ayushyadavnvs/jane_street/docs/DESIGN_DECISIONS.md

# Design decisions

The decisions behind the Programmable Bit Engine (PBE): what was chosen, the alternatives
considered, and why. Decisions that a new protocol forced us to change are marked
**Changed** with the protocol that caused it, so the reasoning behind both versions is kept.

Keep this file current: add an entry for every new decision, and when a decision changes,
mark the old one **Changed** instead of deleting it.

| Version | Folder | Protocols |
|---|---|---|
| v1 | `pbe_v1/` | UART, SPI controller and peripheral, I2C controller and target, SMBus PEC, 1-Wire, Modbus RTU, WS2812, USB low-speed device (control endpoint); CRC unit, parity bit, WAIT timeout, line coder |
| v2 (retired, D28) | branch `archive/v2-usb` | v1 plus low-speed USB; lessons in `docs/USB_NOTES.md` |

## Changes forced by new protocols

| Protocol that arrived | What it broke | Change | Entry |
|---|---|---|---|
| SPI (full duplex) | One shift register cannot send and receive on the same clock | Split into OSR (out) and ISR (in) | D9 |
| I2C | Controller program is 34 words; memory held 32 | Program memory 32 → 64 words, 6-bit PC | D4 |
| I2C (via D4) | 64 words no longer fit the direct-mapped register window | Pointer + data register for loading programs | D13 |
| I2C | Needs START/STOP/repeated START, but the engine cannot branch on data bits | Host requests them through shared flags | D19 |
| USB | NRZI, bit stuffing and CRC per bit are too slow and need state the engine lacks | Hardware USB line unit on opcode 111 | D20 |
| USB | A packet must leave the chip without gaps; 4-byte FIFOs cannot hold one | FIFOs 4 → 16 bytes (v2) | D10 |
| USB | 50 MHz gives 33.3 clocks per USB bit | Target clock 48 MHz | D18 |
| USB (via D20) | Opcode 111 now does something, so `NOP` = `0xE000` became `UTX` | `NOP` re-encoded as a no-op `FLAG` | D6, BUG-008 |
| 1-Wire, Modbus RTU | Nothing: both are programs on the existing instructions | — | D25, D26 |
| Modbus RTU (its test) | Restart could glitch a high pin low, a false start bit | Restart releases pins but keeps their values | D24, BUG-013 |
| Two protocols at once (I2C + 1-Wire) | Shared FLAG0/FLAG1: each engine took the other's requests | 8 flags, engine-relative via `FLAG_BASE`; host `FLAG_SET`/`FLAG_CLR` | D11, D27, BUG-017 |
| USB (v2) | Opcode 111 and a line unit became USB-only: the engine drifted away from general | v2 retired; general features instead | D28 |
| Modbus RTU, 1-Wire | Host had to compute CRC and parity; 3.5-character silence limited Modbus to 19200 baud | General CRC unit, parity bit, WAIT timeout on opcode 111 / pin action 6 | D6, D26, D29–D31 |
| 1-Wire (strong pull-up) + I2C at once | 35 + 34 words did not fit the shared 64-word memory; Modbus alone is 56 | 128-word memory, jumps relative to `START_PC` | D4, D13 |
| Modbus 8N2, 1-Wire inverted CRC-16 | `OUTPAR` always sent parity; "CRC ok = zero" cannot check inverted CRCs | No-parity bit in `LINE_CFG`; CRC value readable by the host | D29, D30 |
| WS2812, SPI peripheral | Nothing: both are programs on the existing instructions (the SPI peripheral uses the timeout vector to see the end of a transaction) | — | D34, D35 |
| SMBus PEC | The I2C controller fed its ACK bits into the CRC, but a PEC covers bytes only | The ACK slot's `IN` is marked `NOCRC` (program change) | D36, BUG-022 |
| I2C target | START/STOP are SDA edges while SCL is high: one engine cannot wait on two pins at once | Both engines run it, sharing flags: one watches for START/STOP, one shifts bits (no hardware change) | D37 |
| USB (back in v1) | NRZI, bit stuffing and a 32-clock bit with no gaps cannot be done one instruction per bit; SE0 needs both pins at once | A general line coder (NRZ/NRZI, three stuffing rules, pair mode, SYNC hunt, byte transfers) | D39 |
| USB | The device must pick its reply by PID and address within 7.5 bit times | `JEQ`/`JNE`/`JLINE` and `MOV`; opcode 111 now has one free sub-op | D6, D32, D40 |
| USB | Its CRC16 is sent inverted: "CRC ok = zero" never holds | `CRC_GOOD`: "ok" = the register equals a set value (USB's residual 0x800d) | D29, D41 |
| USB | A packet must leave without gaps and a SETUP arrives at line rate | FIFOs 4 → 16 bytes (now in v1) | D10 |
| USB | New per-engine settings, but +0..+F were full | Second register page per engine at 0x30 / 0x40 | D32, D44 |
| USB (its firmware) | Burst reads could lose a byte; a flush on SETUP threw away an OUT record | `RX_COUNT`/`TX_COUNT` registers, `TX_FLUSH` | D43, BUG-030, BUG-031 |
| 48 MHz (USB, D18) in the first routed run | 0.586 ns of setup slack: pc → program memory → decode → next pc in one clock, through long buffer chains | An instruction register with a prefetch; four copies of the read address. A taken jump costs one clock more at CLKDIV = 0 | D7, D18, D50 |
| JTAG, SWD | Nothing: both are programs on the existing instructions (SWD fills its 64-word window; the host computes the write parity, as `OUTPAR` covers one OSR load) | — | D75, D76 |
| Programs over 64 words (after D82) | 6-bit jump targets reached only a 64-word window | Jumps relative to their own page; a one-shot `PAGE p` prefix for the others; the assembler inserts it | D67, D83 |
| USB, SWD, CAN, Modbus (programs of 61-64 words) and the planned protocols | The 128 shared flip-flop words were full and half the chip | An IHP SRAM per engine, 256 separate words each (8-bit PC and `START_PC`, `PM_ADDR_H`); 8x4 tile | D4, D13, D50, D62, D82 |

---

## D1. Hardware description language

- **Chosen:** SystemVerilog, restricted to what Yosys reads (`logic`, `always_ff`,
  `always_comb`, packed buses, no interfaces, structs or unpacked port arrays).
- **Alternatives:** Hardcaml (Jane Street's own HDL), plain Verilog-2005, Chisel, Amaranth.
- **Why:** You asked for SystemVerilog. Tiny Tapeout's flow reads it through Yosys, and it keeps
  the testbench in the same language. Hardcaml would be the strongest signal to Jane Street
  but needs OCaml.
- **Consequence:** Per-engine arrays in the top level were flattened into buses
  (`clkdiv[e*16 +: 16]`) because Yosys and Icarus handle unpacked arrays poorly (D23).

## D2. Core architecture: a programmable engine

- **Chosen:** A tiny processor ("engine") whose instructions are the primitive actions every
  protocol is made of: drive / release / read a pin, wait, shift a bit, loop, branch, move bytes.
  Each protocol is a program loaded at runtime.
- **Alternatives:**
  1. Table-driven state machine (state × pin condition → action, next state).
  2. Hardwired UART + SPI + I2C blocks behind a mux.
  3. A general CPU core (RISC-V) bit-banging pins.
- **Why:** The competition requires reprogrammability after fabrication. (2) cannot learn new
  protocols. (1) is compact but hard to program by hand. (3) is far too slow per bit and too
  big. An engine whose instructions are the protocol primitives is small, fast enough, and
  easy to write programs for. The Raspberry Pi RP2040 PIO uses this idea; we deliberately
  differ from it (delay on every instruction, WAIT that restarts the timer, open-drain pin
  action, USB line unit) instead of copying it.

## D3. Two engines

- **Chosen:** Two identical engines.
- **Alternatives:** One engine; four engines.
- **Why:** Some protocols need two things at once: UART TX and RX are independent, and
  running two protocols side by side (UART + I2C) is a strong demo. One engine cannot do
  either. Four would multiply area for a benefit no protocol so far needs; with area use at
  15–21 %, adding engines later remains possible.

## D4. Shared program memory, 32 → 64 → 128 words — **Changed (I2C, then two protocols at once; then the SRAM, D82)**

- **Chosen originally:** 32 × 16-bit words shared by both engines, flip-flop based,
  each engine with its own start address (`START_PC`).
- **Changed:** The I2C controller needed 34 words. Memory became 64 words and the PC 6 bits.
- **Alternatives considered at the change:**
  1. Squeeze I2C below 32 words (merge routines, drop the TX-first check). Possible only by
     removing features or making the host protocol racy.
  2. Separate memory per engine. Wastes words when one engine runs a short program.
  3. 64 shared words.
- **Why (3):** Area use was only 10 %, so +25k µm² was affordable. The JMP address field had a
  spare bit, so the instruction format did not change. 64 words also let UART TX + I2C, or
  USB TX + USB RX, sit in memory together.
- **Cost:** v1 area 91,779 → 141,141 µm². Timing barely moved (3.56 → 3.61 ns).
- **Changed again (1-Wire strong pull-up made it 35 words):** 1-Wire + I2C (69 words) no longer
  fit, and Modbus (56) could not run beside anything but UART TX.
- **Chosen now (decided with you):** 128 words, and every jump (`JMP`, `JCRCBAD`, the timeout) is
  relative to the engine's `START_PC`. Each engine works in its own 64-word window, any two
  programs of up to 64 words can run together, and programs load anywhere (the assembler labels
  each program from 0). The PC stays an absolute 7-bit address, so the add happens on the jump
  path, not the instruction-fetch path. Same idea as `PIN_BASE` and `FLAG_BASE`.
- **Alternatives:** two separate 64-word memories (same area, but loaded separately and no
  shared code); squeezing programs onto a 2 µs 1-Wire tick to fit 64 words (fragile, and Modbus
  still could not share).
- **Cost:** 164,095 → 262,618 µm² (18 % → 29 % of 6×4). I estimated +49,000 µm² beforehand; the
  real cost is about twice that, because doubling the words also doubles both engines'
  128-way read multiplexers. Worst logic path 3.97 ns.
- **Changed (D82, the SRAM program memory):** the memory is no longer shared. Each engine has
  its own 256-word IHP SRAM, the PC and `START_PC` are 8 bits, and jumps stay relative to
  `START_PC` (64-word windows, mod 256). The "separate memories waste words" objection above no
  longer holds at 256 words each; the cost is that two engines cannot share one copy of code.
- **Proposal D62:** SRAM macros instead of flip-flops (one 256 × 16 per engine, written
  together, so this shared image stays); not the design yet.
- **Next option:** latches instead of flip-flops for program memory (31 µm² per bit instead of
  ~67 µm² for a flip-flop with its write multiplexer) could save about 70,000 µm². Program memory
  is written rarely by the host, which suits latches, but latch timing in the Tiny Tapeout flow
  needs checking first.

## D5. Instruction format

- **Chosen:** 16 bits: `[15:13] OP | [12:4] ARG | [3:0] DELAY`. Every instruction can idle
  0–15 extra ticks after it runs.
- **Alternatives:** A separate WAIT/DELAY instruction and no delay field; wider (24-bit) words.
- **Why:** Protocol timing is mostly "do X, then hold for a moment". A delay on every
  instruction makes programs much shorter (UART TX is 8 words). 16 bits keeps memory small.

## D6. The opcode set

| OP | Instruction | Why it exists |
|---|---|---|
| 000 | `PIN p, act` | Drive 0/1, release, toggle, send an OSR bit, open-drain send. Covers push-pull, tri-state and open-drain with one pin model (D8) |
| 001 | `IN p` | Sample a pin into the ISR |
| 010 | `WAIT` | Wait for a pin or flag level or edge: start bits, clock edges, I2C clock stretching |
| 011 | `JMP cond` | Loops (X--), ACK/NACK and glitch checks (pin), host handshakes (FIFO, flags) |
| 100 | `SET X/OSR` | Bit counts and constants (USB SYNC) |
| 101 | `PULL/PUSH` | Bytes to and from the host. **Changed (CAN):** `PULL`'s free bits [7:6] add `PULL NOWAIT`, `MARK` and `REWIND` (D70) |
| 110 | `FLAG` | Coordination between engines and with the host; host interrupt |
| 111 | `EXT` sub-ops: `CRCRST`, `OSRCRC`, `STAT`, `JCRCBAD`, `JEQ`, `JNE`, `JLINE` (7 of 8 used) | **Changed:** was reserved; v2 used it for USB (D20, retired). Then general extensions (D29–D31). **Changed again (USB in v1):** sub-ops 4–6 are the compare and line-event jumps (D40); sub-op 7 stays free. **Changed (CAN):** sub-op 7 is split by param[5]: 0 = `LINECTL` (D67), 1 = reserved for the proposed `PAGE` (D62) |

- **`NOP` — Changed (USB):** The assembler originally emitted opcode 111 with argument 0 for
  `NOP`. That was harmless in v1 but in v2 the same word is `UTX`. `NOP` is now `FLAG` with
  action 3, which has no effect in either version (BUG-008).
- **`MOV` — added (USB in v1):** `FLAG` action 3 with a non-zero destination field is
  `MOV dst, src` (D40). `NOP` (`0xD800`, destination 0) is still a no-op, as BUG-008 requires.
- **`PIN p, END` — added (USB in v1):** pin action 7 ends a line-coder frame (D39).

## D7. Timing: tick divider, WAIT checks every clock and restarts the divider — **Changed (48 MHz place and route, D50)**

- **Chosen:** Each engine has a 16-bit `CLKDIV`; one tick every `CLKDIV + 1` clocks.
  A blocked instruction (WAIT, PULL, PUSH, USB) is re-checked every clock, and when it
  completes the tick divider restarts.
- **Alternatives:** Re-check only on ticks; free-running divider.
- **Why:** Re-checking every clock means a short edge is never missed. Restarting the
  divider means the next instructions are timed from the moment the condition was met. This
  is what lets UART RX land its samples in the middle of each bit without extra hardware.
- **Changed (the first routed run at 48 MHz):** instructions now run from an instruction
  register (D50). With `CLKDIV` ≥ 1 every time above is exactly as before. With `CLKDIV` = 0
  (and under the line coder) a taken jump takes one clock more, and a tick that falls on that
  fetch bubble is held for the clock instead of being lost.

## D8. Pin model

- **Chosen:** Every pin has an output value, an output enable, and a synchronized input.
  Pin numbers in instructions are relative to a per-engine `PIN_BASE` (mod 8). A separate
  `JMP_PIN` selects the pin for `JMP PIN_HI/PIN_LO`.
- **Alternatives:** Fixed pin numbers in programs; separate open-drain hardware for I2C.
- **Why:** One model gives push-pull, tri-state and open-drain (value 0, toggle the enable),
  so I2C needs no special hardware. Relative pins let the same program run on any pins.

## D9. Shift registers: one → OSR + ISR — **Changed (SPI)**

- **Chosen originally:** One 8-bit shift register for both directions.
- **Changed:** SPI is full duplex. Sending and receiving on the same clock with one register
  would shift twice per bit.
- **Chosen now:** OSR (output, loaded by `PULL`, shifted by `OUT`) and ISR (input, filled
  by `IN`, emptied by `PUSH`), each with its own LSB/MSB-first setting.
- **Alternative:** One register with a combined "exchange bit" instruction. Rejected: costs
  an opcode slot and complicates every other protocol.
- **Cost:** 8 more flip-flops per engine.

## D10. FIFOs, 4 → 16 bytes — **Changed (USB, v2; and in v1 since USB came back)**

- **Chosen originally:** 4-byte TX and RX FIFO per engine; `PULL`/`PUSH` block when
  empty/full.
- **Changed in v2:** A USB packet must leave the chip without gaps, but the host feeds
  bytes at most at ~6 Mbit/s over SPI with polling in between. The host now queues the whole
  packet (up to 16 bytes) before sending.
- **Alternatives:** Faster host link; a separate packet buffer. A deeper FIFO is the
  simplest and also helps SPI bursts.
- **Cost:** about 32,800 µm², most of v2's growth.
- **Changed in v1 (USB, D42):** the same reason, now in v1. A low-speed IN packet (PID and up to
  8 bytes) and a SETUP record (14 bytes) each fit; v1 measured +33,121 µm². Every protocol gains
  host-latency tolerance. Two tests leaned on the old depth: the I2C target's "more than the
  FIFO holds" write grew from 5 to 20 bytes so it still makes the engine stretch SCL on a full
  FIFO; the Modbus overflow round still overflows (18 bytes for 9 characters).

## D11. Flags — **Changed (running two protocols at once)**

- **Chosen originally:** 4 flags shared by both engines and writable by the host. Engines can
  set, clear, wait on and branch on them; `FLAG n, IRQ` interrupts the host.
- **Why:** The cheapest way for engines to coordinate, and the way the host asks the
  I2C program for START/STOP (D19) and the USB program to send (D20).
- **Changed:** protocols that use flags could not run on both engines at once (D27, BUG-017).
- **Chosen now:** 8 flags. Each engine sees 4 of them starting at its `FLAG_BASE` (engine
  register +8): "FLAG n" in a program is physical flag `(FLAG_BASE + n) mod 8`. Defaults: engine
  0 has flags 0–3, engine 1 has flags 4–7. Overlapping bases make flags shared again when the
  engines must signal each other (the planned USB responder). The host changes single flags
  through `FLAG_SET` (0x08) and `FLAG_CLR` (0x09), so it never overwrites the other engine's flags.
- **Alternatives considered:**
  1. Let `JMP` test all 4 flags and give each program different flag numbers. Rejected: needs a
     wider condition field, and every program would have to be edited for every pairing.
  2. Fully private flags per engine. Rejected: engines could no longer coordinate.
  3. Relative flags with a base, like `PIN_BASE` for pins. Chosen: programs do not change,
     and sharing is still a configuration choice.
- **Cost:** about 2,700 µm² (+2 %).

## D12. Host interface: SPI peripheral

- **Chosen:** SPI mode 0 on `ui_in[2:0]` / `uo_out[0]`: a command byte (R/W + 7-bit address)
  then data bytes. The address auto-increments, except for streaming registers (FIFO data,
  program data) so a burst can pour bytes into one register. All host inputs pass through
  2-flip-flop synchronizers, so host SCK must be at most clk/8.
- **Alternatives:** A parallel bus on the 8 input pins plus strobes; a UART host port.
- **Why:** 4 wires, any microcontroller (or the Tiny Tapeout demo board's RP2040) can drive
  it, and it leaves the 8 bidirectional pins free for protocols.

## D13. Loading programs: direct-mapped → pointer register — **Changed (I2C, via D4; extended by D82)**

- **Chosen originally:** Program memory mapped at register addresses 0x40–0x7F (32 words ×
  2 bytes).
- **Changed:** 64 words need 128 bytes, more than the 7-bit address space has left.
- **Chosen now:** `PM_ADDR` (0x06) holds a byte pointer, `PM_DATA` (0x07) writes a byte and
  advances it. A program loads in one SPI burst. With 128 words (D4) the pointer uses all 8 bits.
- **Extended (D82):** two 256-word memories need a 10-bit pointer. `PM_ADDR_H` (0x0F) holds its
  top two bits, word[7] and the engine; `PM_DATA` advances {word, byte} and never the engine.
- **Alternative:** An 8-bit address command. Rejected: changes the host protocol for every
  register.

## D14. Program memory is write-only

- **Chosen:** The host cannot read program memory back.
- **Why:** A third read port is a 64:1 × 16-bit mux. Engines read it through their own
  ports; tests verify programs by behaviour.

## D15. Pin ownership mask

- **Chosen:** `PIN_OWN`, one bit per pin: which engine drives it. Both engines can always
  read every pin.
- **Alternative:** Fixed priority (engine 0 wins). Rejected: silent conflicts.

## D16. Input synchronizers; glitch filter deferred

- **Chosen:** 2 flip-flops on every input pin and host input.
- **Deferred:** A glitch filter (on the diagram, not built yet). I2C in fast mode specifies
  50 ns spike suppression, so it will be needed for I2C robustness.

## D17. Pin assignment

- **Chosen:** Protocol pins on `uio[7:0]` (the only pins with output enables), host SPI on
  `ui_in[2:0]` / `uo_out[0]`, IRQ and status on `uo_out[7:1]`.

## D18. Clock frequency: 48 MHz — **Changed (USB); Changed again (10BASE-T: 60 MHz, D92)**

**Changed (10BASE-T, D92):** the clock is 60 MHz: a 10 Mbit/s Manchester half bit is exactly 3
clocks, and USB low speed is still a whole number of clocks per bit (40).

- **Chosen:** Plan for 48 MHz. The competition sets no frequency; Tiny Tapeout's clock pad is
  specified to about 66 MHz.
- **Earlier assumption:** 50 MHz, a round number with margin under 66 MHz.
- **Why changed:** USB low speed is 1.5 Mbit/s: exactly 32 clocks per bit at 48 MHz, 33.3 at
  50 MHz (1 % error). UART and I2C rates divide well from 48 MHz too.
- **Margin:** worst path ~4.9 ns at the slow corner (logic plus flip-flop overhead) vs 20.8 ns
  per cycle, roughly 4×.
- **Changed (the margin, first routed run):** that estimate had no wires. Routed, the same path
  took 19.6 ns and left 0.586 ns of slack at the slow corner, mostly in buffer chains on the
  program counter. The clock stays at 48 MHz (USB needs it); the path was cut in two instead
  (D50).

## D19. Protocol host conventions

- **UART:** TX uses tick = ½ bit, RX uses tick = ¼ bit so a `WAIT LOW [1]` lands half a bit
  into the start bit. RX checks the line again there and drops glitches. Bit 7 is handled
  outside the loop so the program is back in `WAIT` inside the stop bit.
- **SPI controller:** CS stays low while the host keeps the TX FIFO fed.
- **I2C controller:** Each I2C byte is two FIFO bytes, `[data] [ack]`, and returns
  `[byte seen on SDA] [ACK bit]`. Reads and writes are the same 9-bit open-drain exchange.
  START and STOP are requested with FLAG0 and FLAG1.
  - **Alternative:** A command byte decoded by the program. Rejected: the engine cannot branch
    on data bits, so decoding would need new instructions.
  - **Changed (review):** SCL is now 4 ticks low and 3 high (it was 3 low, 4 high, which breaks
    the I2C minimum low time), and FLAG1 is cleared after STOP completes (BUG-010, BUG-011).

## D20. USB: a hardware line unit (v2) — **Retired (D28)**

- **Chosen:** A small line unit per engine on opcode 111. It does NRZI, bit stuffing and
  unstuffing, SYNC detection, EOP, CRC5 and CRC16, and re-centres sampling on every D+ edge.
  The engine still runs the packet logic: what to send, when, and what to do with what
  arrives.
- **Alternatives:**
  1. Pure software on the engine. Rejected: no way to test an OSR bit (needed for NRZI), X is
     taken by the bit counter so nothing counts 1s for stuffing, and the CRC per bit costs
     many instructions.
  2. Line unit timed by the engine's ticks. Rejected: a stuffed bit adds a bit time the
     program cannot see, so timing breaks. The line unit has its own bit timer (`BITDIV`) and a
     1-bit holding register, and the engine just keeps it fed.
- **Low speed only:** full speed (12 Mbit/s) is 4 clocks per bit at 48 MHz.
- **SYNC handled in hardware:** the engine cannot branch on bits, so the line unit strips SYNC.
- **Both CRCs always run;** the program reports both (`STAT`) and the host picks the right one
  by PID, because the program cannot branch on the PID yet.
- **Bit stuffing errors** are reported in `STAT` bit 2 (BUG-009).
- **Cost:** about 15,600 µm² for USB logic (one line unit is 5,733 µm²).
- **v2 is a separate copy** so v1 stays a clean UART/SPI/I2C design.

## D21. Verification approach

- **Chosen:** End-to-end testbench that touches only the chip's pins. Every protocol is
  checked by a model written independently of the RTL (UART monitor, SPI peripheral, I2C
  register device with clock stretching, USB decoder and USB host with ±1.5 % clock error).
  Each important feature is checked by breaking it on purpose and confirming the test fails.
  Simulator: Icarus Verilog.
- **Lessons:** A test that passed with the feature removed was strengthened (BUG-004). Icarus
  bugs with automatic tasks and queues led to static tasks for the USB helpers (BUG-006).
  A failing test must give a non-zero exit code (BUG-007).
- **Waveforms are opt-in** (`vvp sim.vvp +vcd`): 1-Wire and Modbus need ~70 ms of simulated time
  and the dump would be ~165 MB.
- **Static tasks share variables:** give every caller-side variable its own name (BUG-016).
- **Two host processes** (for protocols running at once) share the host port through a fair
  ticket lock (BUG-018), and the tests change flags through `flag_set` / `flag_clear` /
  `flag_get` helpers that know each engine's flag window.
- **Testbench clock = planned clock (48 MHz)** since BUG-020; it had been 50 MHz.
- **Planned:** third-party protocol decoders (sigrok), a Python golden model with random
  programs, formal properties (SymbiYosys), mutation score (MCY).

## D22. Area and timing method

- **Area:** Yosys synthesis with IHP's sg13g2 standard-cell library (typical corner).
  Tiny Tapeout's CMOS5L cell list uses the same cell names; no separate CMOS5L library is
  public.
- **Timing:** OpenSTA could not be built here (a dependency from a third-party mirror was
  blocked), so timing uses ABC's `stime` with the slow-corner library (1.08 V, 125 °C).
  Flip-flop clock-to-Q (~0.57 ns) and setup (~0.31 ns) are added by hand. Wire delay and
  clock skew are not included; the place-and-route report is the final word.

## D23. Synthesis-friendly coding

- Per-engine signals in the top level are flat buses, not unpacked arrays.
- Combinational selectors are named wires (Icarus `always_comb` limitation).
- `exec` is declared before use (strict tools reject use-before-declaration).
- Storage arrays (program memory, FIFO data) have no reset, which saves area; they are
  always written before being read.

## D24. Restart cancels the instruction in flight

- **Chosen:** `exec` is forced low while `restart` is high, so an instruction that would
  complete in that cycle has no side effects (no FIFO pop or push, no flag change, no IRQ, no
  USB line unit input).
- **Alternative:** Let it complete and restart one cycle later. Rejected: the host expects
  restart to take effect at once, and the completed instruction would still act on a state
  that is being thrown away.
- **Cost:** one AND gate on the `exec` path; the worst path grew by about 0.2 ns. (BUG-012)
- **Changed (Modbus RTU test):** restart used to clear pin output values as well as enables.
  A pin driving high could then glitch low (BUG-013). Restart now only releases pins and keeps
  their values, so released lines float to their pull-ups cleanly. Programs set a value before
  toggling a pin, so the stale value is harmless.

## D25. 1-Wire controller (program only) — **Changed (strong pull-up)**

- **Now 36 words.** FLAG0 has two meanings: with nothing queued it requests a reset; set *after*
  a byte is queued it requests a strong pull-up after that byte (DQ driven hard high from 6 µs
  after the last slot until the host clears FLAG0), which parasite-powered devices need during
  CONVERT T. The idle loop therefore checks for queued bytes before FLAG0.
  - **Changed (BUG-038):** the program tests FLAG0 *before* pushing the byte seen, and the
    pull-up path pushes only after driving DQ high. A `PUSH` blocks while the RX FIFO is full,
    and the pull-up must not wait for the host (a DS18B20 needs it within 10 µs). Was 35 words.
  - **Alternative:** a separate flag for the pull-up. Rejected: `JMP` can only test FLAG0 and
    FLAG1, and FLAG1 is single-slot mode.
- **CRCs** are checked with the CRC unit through the host registers (D29): CRC-8 by "CRC ok",
  inverted CRC-16 by reading the CRC value.
- The text below describes the first version.

### First version

- **Chosen:** `programs/onewire_ctrl.pbe`, 30 words, tick = 1 µs. A write-1 slot and a read slot
  are identical on the wire (6 µs low, then released), so one slot routine does both, like the
  I2C 9-bit exchange: `OUTOD` keeps DQ low for a 0 and releases it for a 1, and `IN` samples at
  13 µs. To read, the host sends `0xFF`.
- **Reset/presence:** requested with FLAG0; a `JMP X--` loop with a 16-tick delay makes the
  480 µs pulse. The flag is cleared only when the reset is finished (lesson of BUG-011).
- **Search ROM:** needs a decision after every 2 bits read. The engine cannot branch on data, so
  FLAG1 switches the program to single slots and the host runs the search algorithm (Maxim
  AN187). 1-Wire has no maximum gap between slots, so host round trips are fine.
- **Alternatives:** a hardware 1-Wire master (rejected: the point is a reprogrammable engine);
  separate read and write routines (rejected: twice the code for identical wire activity).
- **Left to the host:** CRC8, and the strong pull-up some parasite-powered devices need
  (`PIN dq, DRV1`). Overdrive speed needs a second program with a finer tick.

## D26. Modbus RTU master — **Changed (CRC, parity, timeout hardware; frame validity, D47)**

- **Changed (D47):** the receiver now rejects a frame with a pause of more than 1.5 characters,
  and the timeout is 1.5 characters at every baud rate (it was 3.5 characters up to 19200 baud
  and 1.75 ms above). 62 words.
- **Before D47:** `programs/modbus_rtu.pbe`, 56 words, uses the CRC unit (D29), the parity bit (D30) and
  the timeout (D31). The host sends only data bytes; the engine adds parity and appends the CRC,
  checks received parity and CRC, finds start bits with `WAIT FALL` (exact, instead of a 2-tick
  poll) and ends a frame with the timeout. The 19200-baud limit is gone (tested at 115200).
  FLAG0 is used inside the program as "in a frame". The text below describes the first version.

### First version (program only)

- **Chosen:** `programs/modbus_rtu.pbe`, 33 words, RS-485 half duplex on one engine: TX, RX and a
  driver-enable pin. Tick = 1/8 bit.
- **Parity:** the engine cannot compute parity, so each character is two TX bytes,
  `[data] [parity]`; the parity byte's bit 0 is sent after the data. The same program does
  8E1, 8O1 or 8N2 (send 1 as a second stop bit). Received parity comes back in a status byte.
  - **Alternative:** a parity flip-flop in the shifter (about 10 cells, pin actions 6–7 are
    free). Deferred: not needed yet.
- **End of frame (3.5 characters of silence):** `WAIT` has no timeout, so after each character
  the program polls for the next start bit in a 2-tick loop counted by X. At the end it sets
  FLAG2 and raises IRQ.
  - **Limit:** X is 8 bits, which covers the character-based timing Modbus uses up to
    19200 baud. Above that Modbus specifies fixed 1.75 ms gaps, which need more than 255 polls.
  - **Alternative:** a WAIT-with-timeout counter in hardware. Deferred; also useful for I2C
    stuck-bus recovery and CAN.
  - The 2-tick poll catches a start bit up to 1/4 bit late; sampling is aimed so the error is
    about ±1/8 bit.
- **End of request:** FLAG1, set by the host once everything is queued (TX FIFO empty). The
  engine turns the driver off after the last stop bit, then clears FLAG1.
- **CRC:** computed by the host. (v2's USB CRC unit computes the same CRC-16; Modbus is the
  inverted USB field.)
- **Not checked by the receiver:** the 1.5-character maximum gap inside a frame. **Changed:**
  checked since D47 (BUG-039).

## D27. Shared flags limit which protocols can run together — **Resolved by D11**

- **Observation:** `JMP` can only test FLAG0 and FLAG1, and flags are shared by both engines.
  I2C, USB TX, 1-Wire and Modbus all use FLAG0 or FLAG1, so two of them cannot run on the two
  engines at the same time. UART and SPI use no flags and can run next to any of them.
- **Resolved:** engine-relative flags (D11, BUG-017). The new test runs a 1-Wire Search ROM on
  engine 0 and I2C on engine 1 at the same time.

## D28. Retire v2; keep the engine general

- **Decision:** v2 (low-speed USB) is retired. Its source stays on the GitHub branch
  `archive/v2-usb`; what it taught is in `docs/USB_NOTES.md`.
- **Why:** v2 worked, but most of its hardware was USB-only: a line unit with its own fixed
  CRCs, and all 8 sub-ops of opcode 111 spent on USB. That pulled the engine away from being a
  general protocol engine, and every fix had to be made in two copies.
- **Alternatives:** keep both copies (rejected: double work, drift); merge them behind a USB
  build option (rejected for now: still USB-specific hardware).
- **Plan for USB later:** bring it back on general features that other protocols also use:
  the CRC unit (D29), a line coder with NRZI/stuffing/Manchester modes, compare-and-branch on
  received data, and `MOV X, ISR` (see `docs/USB_NOTES.md`, section 4).
- **Done:** USB is back in v1 (D39–D44). The line coder has NRZ and NRZI, three stuffing rules
  and a pair mode; Manchester waits for a protocol that needs it (1553). The coder is
  unit-tested in USB, CAN and HDLC styles, so it is not USB-only hardware.

## D29. General CRC unit

- **Chosen:** `src/pbe_crc.sv`, one per engine. A shift-left register with any polynomial up to
  16 bits and a set width; initial value all zeros or all ones; result read plain or
  bit-reversed. It is fed by the bits the engine shifts: `OUT`/`OUTOD` and/or `IN`, chosen in
  `CRC_CFG`; an instruction marked `NOCRC` (e.g. a parity bit or the CRC bytes themselves) is
  left out. "CRC ok" = register is zero, which holds after a frame plus its own CRC for every
  CRC without a final inversion (Modbus CRC-16, 1-Wire CRC-8, CAN CRC-15).
- **Instructions (opcode 111):** `CRCRST`, `OSRCRC LO/HI` (load a CRC byte to send), `JCRCBAD`.
  The host can also restart the CRC and read "CRC ok" through the engine's `STATUS` register,
  which is how the unchanged 1-Wire program gets a hardware CRC-8 check.
- **Changed (1-Wire inverted CRC-16):** reading +9/+A now returns the CRC's current value instead
  of the polynomial. Devices such as the DS2408 and DS2431 send their CRC-16 inverted, where
  "zero" is never the result; the host reads the value and compares it with the received bytes.
  Polynomial read-back is lost, which only a debugging host would miss.
  - **Alternatives:** a residual-compare register (no register slot free); a final-inversion
    option (engine-side checks for inverted CRCs would still need a residual).
- **Alternatives:**
  1. Host computes CRCs (the first Modbus/1-Wire versions). Works for slow protocols, but the
     engine cannot act on the result, which USB and CAN need.
  2. Fixed CRCs, like v2's USB unit. Rejected: a new protocol would need new hardware.
  3. A final-inversion option. Left out: no current protocol needs it (USB does; see notes).
- **Changed (USB):** USB's CRC16 is sent inverted, so a good packet leaves the register at the
  residual 0x800d, not zero, and the device must check it before it ACKs. "CRC ok" now means
  the register equals `CRC_GOOD` (default 0, so every earlier program is unchanged), and
  `OSRCRC ..., INV` sends the inverted field (D41).
- **Verified:** a Python model of the same register gives Modbus `C4 0B` for `01 03 00 00 00 02`,
  1-Wire CRC-8 `1C` for the DS18B20 scratchpad, and zero after a frame plus its CRC.
- **Cost:** ~3,600 µm² per engine, plus its registers.

## D30. Parity bit

- **Chosen:** two flip-flops per engine. Send parity: XOR of the bits `OUT`/`OUTOD` shifted since
  the last OSR load; the new pin action `OUTPAR` (6) drives it, inverted when `LINE_CFG[7]`
  selects odd parity. Receive parity: XOR of the bits `IN` sampled since the last `STAT`; with the
  parity bit included it must come out even (or odd), and `STAT` reports an error otherwise.
- **Why separate from the CRC:** parity is a 1-bit CRC (polynomial x+1), but Modbus needs parity
  per character and CRC-16 per frame at the same time.
- **Alternative:** host supplies the parity bit (first Modbus version): costs a FIFO byte per
  character and host work. Rejected now that the cost is two flip-flops.
- **Changed (Modbus 8N2, BUG-019):** `LINE_CFG[6]` = no parity: `OUTPAR` sends 1 (the second stop
  bit) and no receive parity error is reported. The same Modbus program then does 8E1, 8O1 and
  8N2.

## D31. WAIT timeout through a timeout vector

- **Chosen:** per engine, `TIMEOUT` (16 bits, in ticks; 0 = off) and `TIMEOUT_PC` (in
  `LINE_CFG`). If `WAIT`, `PULL` or `PUSH` stays blocked for `TIMEOUT` ticks, the engine abandons
  it (no side effects), jumps to `TIMEOUT_PC` and sets "timeout happened", which `STAT` and the
  `STATUS` register report.
- **Why a vector:** no instruction bits were free: `JMP`'s 8 conditions and `WAIT`'s 9 argument
  bits are all used, and using the delay field would break existing programs. With a vector,
  every existing program works unchanged (timeout off by default).
- **Alternatives:** a `JMP TIMEOUT` condition (would need to drop an existing condition); a
  timeout field in `WAIT` (no room); a second engine as a timer (wastes an engine).
- **Uses:** Modbus end of frame and exact start detection at any baud rate (done); I2C stuck-bus
  recovery, UART idle-line detection and CAN bus-idle detection (later).
- **Cost:** ~2,800 µm² per engine (counter and limit).

## D32. Register and opcode budget

- **Changed (USB):** the second register page (D44) holds the new per-engine settings, and
  sub-ops 4–6 of opcode 111 became `JEQ`, `JNE`, `JLINE` (D40). Sub-op 7 is the last free one;
  `MOV` went into the unused bits of `FLAG` action 3 instead. `STATUS` uses 5 of 8 bits.
- **Engine registers:** +0 to +F are now all used (+7 is free only by accident of history:
  it was v2's `BITDIV`). New per-engine settings will need a second register window.
  `LINE_CFG` is full too ([5:0] timeout PC, [6] no parity, [7] odd parity), and `STATUS` uses 4
  of 8 bits.
- **Opcodes:** opcode 111 has sub-ops 4–7 free. Planned users: compare-and-branch on received data,
  `MOV X, ISR`, line-coder operations. When those run out: 24-bit instructions (program memory
  +50 %, ~+25,000 µm²) or a second opcode page.
- **OSR/ISR stay 8 bits:** byte boundaries cost one `PULL`/`PUSH` tick, which every protocol so far
  hides in a delay. Needed only for a protocol at one tick per bit with no gap between bytes, and
  then "auto-pull" is cheaper than wider registers.

## D33. RX overflow is reported, not silent

- **Chosen:** a `PUSH` that finds the RX FIFO full sets a sticky `STATUS[3]` bit (also in `STAT`)
  and raises IRQ once. The engine still waits for room, as before.
- **Why:** with 4-byte FIFOs a slow host can fall behind (at 115200 baud it has ~95 µs per
  character). The data is then damaged either way; the point is that the host finds out.
- **Alternatives:** drop the byte and keep going (keeps timing, loses data silently); deeper
  FIFOs (area; v2 needed 16 bytes for USB and paid ~32,800 µm²).

## D34. WS2812 (NeoPixel) LED driver: a program, timed by delays — **Changed (60 MHz for 10BASE-T, D92)**

**Changed (D92):** at 60 MHz the tick is 33.3 ns (`CLKDIV` 1) and the delays are [11] [11] [11].

- **Chosen:** `programs/ws2812.pbe`, 8 words, tick = 2 clocks (41.7 ns at 48 MHz). Each bit is
  three pin instructions: `DRV1 [9]` (0.42 µs), `OUT [9]` (a 1 stays high for another 0.42 µs, a
  0 goes low), `DRV0 [8]`, and `JMP X--`: 30 ticks = 1.25 µs. High times are 0.42 / 0.83 µs
  (datasheet 0.4 / 0.8 µs ± 150 ns); the `PULL`/`SET` at a byte boundary make that bit's low phase
  125 ns longer, still in spec. The engine waits in `PULL` with the line low, so a frame ends
  (the LEDs latch after 50 µs low) simply when the host stops sending.
- **Host requirement:** 800 kbit/s is 100 kB/s with a 4-byte FIFO (40 µs of data). The host
  bursts the bytes into the FIFO and pauses while the TX-full pin (`uo_out[6]`) is high. At a
  host SCK of clk/16 a byte takes 2.7 µs, against 10 µs on the LED line. An underrun stretches
  a low phase out of spec, and one of 50 µs latches the LEDs mid-frame.
- **Alternatives:** a hardware PWM or one-shot pulse unit (WS2812-specific: rejected, D28); one
  instruction per bit with the delay chosen by the data (no instruction reads OSR into the delay
  field).
- **Tested (Test 8):** a decoder measures every high and low against the datasheet and rebuilds
  the bytes: 2 frames of 5 LEDs. Mutations caught: `DRV1 [4]` (high too short) and `DRV0 [3]`
  (low too short).

## D35. SPI peripheral (device): a program; the timeout vector ends a transaction

- **Chosen:** `programs/spi_periph.pbe`, 21 words, mode 0, CLKDIV 0. It waits for CS low and puts
  bit 7 on MISO, then loops: wait SCLK rise → `IN` MOSI → wait fall → `OUT` MISO. A reply byte the
  host has not queued goes out as 0xFF (`SET OSR, 0xFF` and `JMP TX_EMPTY`).
- **End of transaction:** the engine is blocked in `WAIT sclk, RISE` when CS rises, and a
  `WAIT` cannot watch two pins. The timeout vector (D31) breaks the wait: after `TIMEOUT` ticks
  with no clock, the routine at word 1 checks CS (`JMP PIN_HI`, the JMP pin is CS). If CS is high,
  it releases MISO and waits for the next select; if CS is still low (the controller paused), it
  goes back to waiting for the clock.
- **Limits (documented in the program):**
  - SCLK up to 2 MHz at 48 MHz. After the 8th rising edge the engine needs about 10 clocks to
    store the byte and load the next reply before the falling edge. Tested at 2 MHz.
  - The first SCLK edge comes at least 250 ns after CS falls.
  - A reply byte must be queued before the previous byte's last rising edge.
  - CS must stay high for at least `TIMEOUT` ticks between transactions. MISO is released
    within `TIMEOUT` ticks of CS rising, not at once: on a shared MISO line that gap matters.
  - `TIMEOUT` must be longer than the longest SCLK high phase.
- **Alternative for later:** a general "abort on pin edge" vector (like the timeout vector, but
  fired by an edge on a chosen pin). It would end SPI transactions at once and also serve I2C
  target STOP detection and UART break. That's hardware, so it waits for a second protocol that
  needs it badly.
- **Tested (Test 9):** a mode-0 controller model at 2 MHz that samples MISO just before each
  rising edge, three transactions: replies queued, 0xFF defaults (also for the very first byte),
  and a pause longer than the timeout inside a transaction. A monitor checks that MISO changes
  only while SCLK is low. Mutations caught: either `SET OSR, 0xFF` removed (the first one only
  after BUG-026), timeout routine always ending the transaction, MISO never released.

## D36. SMBus PEC: the I2C controller plus the CRC unit as CRC-8

- **Chosen:** no new hardware and one program change. The CRC unit is set to CRC-8, poly 0x07,
  init 0, plain output (`CRC_CFG` 0x87), fed by `IN` bits only. The I2C controller reads back
  every bit it sends, so `IN` sees each byte on the bus in both directions, including addresses.
  The ACK slot's `IN` is marked `NOCRC`, because a PEC covers bytes, not ACK bits (BUG-022).
- **Host protocol:** restart the CRC (`STATUS` write bit 0) at the start of a message, not at a
  repeated START: the PEC covers both address bytes.
  - Write: after the last byte, read the CRC value (+9) and send it as the PEC.
  - Read: receive the PEC like a data byte. `STATUS` bit 1 ("CRC ok") is then set only if it
    was right.
- **Alternatives:** the host computes the PEC (works, but costs host time per byte); feeding the
  CRC from `OUTOD` too (would count each bit twice, since the program both drives and reads it).
- **Tested (Test 7, in `tb_pbe`):**
  - The device model computes its own PEC. The testbench's CRC-8 is first checked against the
    standard check value (0xF4 for "123456789").
  - Write Word with PEC: the engine's PEC must equal the model's, and the device's CRC over the
    message plus the PEC must be 0.
  - Read Word with PEC: once with the right PEC (CRC ok = 1) and once with a corrupted one
    (CRC ok = 0).

## D37. I2C target: two engines share the job through flags

- **Chosen:** `programs/i2c_target.pbe` (58 words, bit engine) on one engine and
  `programs/i2c_watch.pbe` (8 words) on the other. Both engines use the same pins and the same
  `FLAG_BASE`, so they see the same four flags (D27).
  - The watcher waits for SDA edges and checks SCL. A fall while SCL is high sets FLAG0
    (START); a rise while SCL is high sets FLAG3 (STOP, with IRQ). It drives nothing.
  - The bit engine shifts the address and data bits on SCL edges. After each SCL fall it checks
    FLAG0, so a repeated START restarts the address phase.
- **Why two engines:** START/STOP are SDA edges while SCL is high. A single engine blocked in
  `WAIT scl` cannot see an SDA edge. The alternatives each need hardware:
  - a `WAIT` on two pins (no free argument bits, D32);
  - a pin-change flag;
  - the abort-on-edge vector of D35.

  The cost is that the I2C target uses both engines, so nothing else can run beside it.
- **The host decides, the engine stretches SCL:**
  - After the address byte, the engine holds SCL low, pushes the address and sets FLAG2 (with
    IRQ). The host ACKs by clearing FLAG2 (the engine waits in `WAIT FLAG 2, LOW`). It NACKs by
    restarting the engine, which releases both lines and waits for the next START.
  - For reads, the engine holds SCL until the host has queued the next byte.
  - I2C allows any amount of clock stretching, so host latency only slows the bus.
  - The host can therefore answer any address, several addresses or the general call; there is
    no address-comparator hardware.
- **Rejected in review (first draft):** a NACK queued as a byte. In that draft the engine then
  decided "did we ACK?" by reading SDA in the ACK slot. On a bus with several targets, another
  device's ACK pulls SDA low, and the engine would have joined someone else's transfer. Test 10
  now covers this.
- **Timing:**
  - SDA changes at least 300 ns after SCL falls. `WAIT scl, FALL [12]` covers the I2C hold rule:
    a transmitter must bridge SCL's undefined falling region.
  - SDA is set up at least 333 ns before the engine releases a stretched SCL (`[15]`; standard
    mode needs 250 ns).
  - Measured: hold ≥ 333 ns, setup ≥ 333 ns.
- **Host rule:** read FLAGS *after* draining the RX FIFO. The engine sets FLAG2 one clock after
  pushing an address, so if FLAG2 was still clear, the drained bytes were all data.
- **Tested (Test 10):** a fast-mode controller model that supports stretching:
  - a write of a pointer plus five bytes (more than the RX FIFO holds);
  - a read of three bytes after a repeated START;
  - another device's address, ACKed by that device and followed by two bytes: our chip must not
    touch SDA and must pass nothing to the host;
  - a read after that.

  Monitors check that SDA never changes while SCL is high, the hold and setup times, and that
  stretching happened. Mutations caught: the watcher's START flag removed, the repeated-START
  check removed, the hold delay removed (104 ns), the setup delay cut (83 ns).

## D38. A second end-to-end testbench

- **Chosen:** tests 8–10 live in `test/tb_proto.sv`; the host-port helpers (SPI framing, register
  access, FIFOs, flags) moved to `test/tb_host.svh`, which both testbenches include.
  `make test` runs all three testbenches; `make test-proto` runs only the new one (3 s, against
  ~2 min for `tb_pbe`).
- **Why:** `tb_pbe.sv` had grown past 1,100 lines and two minutes per run; the new protocols use
  their own pin models and need nothing from the old tests' state.
- **Lint step:** `make test` first fails on Icarus's "Static variable initialization" warning
  (BUG-023).

## D39. Line coder: a general serializer between the shift registers and the pins

- **Chosen:** `src/pbe_line.sv`, one per engine, off by default (`LINE` = 0). Settings:
  - **mode:** NRZ, or NRZI (0 = change level);
  - **stuffing:** after 6 ones (USB), after 5 ones (HDLC) or after 5 equal bits (CAN);
  - **pair mode:** pin base + 1 carries the complement, SE0 ends a frame;
  - **transfers:** byte or bit;
  - **SYNC:** a frame-start pattern.
- **What it does:**
  - **Bit timing:** it owns the bit timing (`CLKDIV` becomes the bit time, and instructions then
    run every clock), because a stuffed bit must cost the program nothing. That was v2's lesson.
    (Since D50 a taken jump takes 2 clocks.)
  - **Transmit:** one queued entry. A frame starts with a 2-bit-time gap and the SYNC byte,
    and `PIN p, END` ends it (pair mode: SE0, SE0, J, then release).
  - **Receive:** samples mid-bit and re-centres on every edge. It hunts for SYNC, unstuffs
    (a stuff bit with the wrong value is a line error), and reports the end of a frame as an
    event: SE0 then J in pair mode; otherwise 8 idle bits, or a stuffing violation at the
    idle level.
  - An `IN` waits for a byte or the event. An unread byte is dropped when its frame ends
    (BUG-028).
- **CRC in byte mode:** an `OUT` or `IN` hands over 8 bits at once, so the CRC unit takes them
  one per clock afterwards, and the next instruction waits those 8 clocks. That keeps the
  CRC unit bit-serial and keeps `NOCRC` per instruction.
- **Why general:** the same block covers USB (NRZI, 6 ones, pair), HDLC/SDLC (NRZI, 5 ones,
  flag as SYNC) and CAN (NRZ, 5 equal bits, bit transfers). `tb_line.sv` tests all three
  against reference models written independently of the RTL.
- **Alternatives:**
  1. v2's USB line unit: rejected, USB-only (D28).
  2. Host pre-encodes NRZI and stuffing: almost no hardware, but the device would then ACK
     packets without checking their CRC, and the host would have to stream at line rate.
  3. Bit-by-bit in instructions: at 32 clocks per bit there is no "branch on this bit".
- **Not yet:** a Manchester mode (1553), CAN's sample point and resynchronization jump width.
  A non-pair frame ends only by idle or a stuffing violation.
- **Cost:** 12,141 µm² per coder. I estimated 6–8k: the two 16-bit bit timers (transmit and
  receive) are most of the difference, and could be one, since the coder is half duplex.

## D40. Compare and move instructions

- **Chosen:**
  - `JEQ label` / `JNE label`: jump if ISR equals / differs from OSR (opcode 111, sub-ops 4, 5).
  - `JLINE label`: jump if the line coder saw the end of a frame, and clear the event (sub-op 6).
  - `MOV dst, src` with dst and src in {X, OSR, ISR} and src 0 = zero (`FLAG` action 3).
- **Why:** a USB device must choose ACK, NAK, STALL or DATA from the PID and address within
  7.5 bit times, and the host is far too slow for that. `JEQ` against `SET OSR` constants checks
  bytes; `MOV X, ISR` keeps the PID while the address bytes arrive, and later counts bytes.
- **Also for:** Modbus slave addresses, the I2C target address check on the engine, CAN IDs,
  the 1553 terminal address, and any loop with a received count (`MOV X, ISR`).
- **Why `JNE` too:** the USB program is exactly 64 words; each `JNE` saves the `JMP` after a
  `JEQ`. That spent another sub-op, so `MOV` went into `FLAG` action 3 instead.
- **Tested:** `tb_engine_ops.sv` (unit test) checks every compare and move, and that `NOP` is
  still a no-op.

## D41. CRC good value and inverted CRC output

- **Chosen:** a per-engine `CRC_GOOD` register: "CRC ok" means register == `CRC_GOOD` (0 by
  default). `OSRCRC LO|HI, INV` loads the inverted CRC byte.
- **Why:** USB sends its CRC16 inverted. A good packet leaves the register at 0x800d. Our model
  of the CRC unit gives the field `dd 94` for the real-trace packet `DATA0 80 06 00 01 00 00 40 00`,
  and 0x800d after any good packet. The unit test checks both values in RTL.
- **Also for:** the 1-Wire inverted CRC-16 (DS2408, DS2431), which the host had to check by
  reading the value (D29); and CRC-16/X.25 (HDLC).
- **Alternative:** a final-inversion flag with the residual worked out in hardware: more logic
  for the same result.

## D42. USB low-speed device: control endpoint 0, one engine

- **Chosen:** `programs/usb_dev.pbe`, exactly 64 words.
  - **Received tokens:** checks PID, address and endpoint (with the CRC5 included, by comparing
    the token's 2nd and 3rd bytes with two `SET OSR` constants). It receives SETUP/OUT data,
    checks the CRC16 against the residual, and ACKs only good packets.
  - **IN tokens:** sends the host-queued packet with the CRC appended, NAK when nothing is
    queued, or STALL. It reports the host's ACK.
  - **Settings:** CLKDIV 31 (32 clocks a bit at 48 MHz), coder 0x36, SYNC 0x80, CRC16 0x8005,
    CRC_GOOD 0x800d.
- **Host side:**
  - The firmware answers at its own pace: USB's NAK flow control means the engine NAKs IN
    tokens until data is queued, so the host never has to meet the 5 µs turnaround.
  - Records go to the RX FIFO: `[D2]` for an ACK, and `[token] [DATA PID] [n bytes] [255 − n]
    [status]` for data. The count makes records that pile up in the FIFO separable; the
    firmware parses them from the end (a status byte is below 0x20, an ACK is 0xD2).
  - After SET_ADDRESS, the firmware rewrites the two address words in program memory.
  - It uses `RX_COUNT`, `TX_FLUSH` and flags (FLAG0 = IN packet queued, FLAG1 = STALL,
    FLAG2 = record).
  - It also resends an IN packet whose ACK was lost and handles a bus reset (D49).
  - A data packet is ACKed only when its CRC is good *and* the line coder saw no error (D48).
- **Scope: endpoint 0 only.** A HID keyboard also needs an interrupt IN endpoint, about 10 more
  words, and a program window is 64 words (6-bit jump targets). What would make room:
  - a one-level `CALL`/`RET`;
  - jumps relative to the PC, so a program could use the whole memory;
  - USB on both engines (receive and transmit).

  These are open. EP0 covers what V-USB's common gadgets use: enumeration and vendor requests.
- **Limits:**
  - A SETUP record is 14 bytes, so the firmware must read it before the next SETUP arrives
    (USB's own flow guarantees that).
  - Electrical: plain I/O pins switch faster than USB's 75–300 ns edges (works in practice,
    as with V-USB, but not compliant). The pad voltage still needs checking.
  - Full speed is impossible at 4 clocks per bit.
- **Tested (Test 11, `tb_usb.sv`):** a USB host model at ±1.5 % enumerates the device:
  - GET_DESCRIPTOR (device; configuration 9 and 18 bytes), SET_ADDRESS, SET_CONFIGURATION,
    STALL for an unsupported request, and a vendor write and read;
  - refused: a SETUP with a flipped bit, one with a missing stuff bit, one with a wrong stuff
    bit but intact data and CRC (BUG-040), tokens for the old address and with a bad CRC5;
  - a lost ACK (the same DATA1 packet comes again, BUG-041) and a 10 ms bus reset after
    SET_ADDRESS (address 0 again, BUG-042);
  - no reply: keep-alives and a bus reset;
  - two records piled up and split apart.

  The device's CRCs are checked by the host model's own CRC code. Every turnaround is
  2.97–3.05 bit times (allowed 2–7.5), and host and device never drive the bus at the same time.
  Mutations caught:
  - no edge re-centring;
  - no stuffing;
  - a 1-bit gap (turnaround 1.97);
  - no frame-end drop;
  - no CRC5 check;
  - no CRC check before the ACK;
  - "CRC ok" back to zero.

## D43. Host port: FIFO counts and a TX-only flush

- **Chosen:**
  - `RX_COUNT` (0x0A/0x0B) and `TX_COUNT` (0x0C/0x0D): bytes in each engine's FIFOs.
  - `TX_FLUSH` (0x0E): empties an engine's TX FIFO only.
- **Why:**
  - A burst read of an RX FIFO could lose a byte arriving during the burst (BUG-030). With the
    count, the host reads exactly the bytes that are there.
  - The USB firmware must drop a stale IN reply when a SETUP arrives. Flushing both FIFOs threw
    away the OUT record already arriving behind the SETUP (BUG-031).
- **Also for:** any protocol whose host reads in bursts, or aborts a queued transmission.

## D44. A second register page per engine

- **Chosen:** 0x30 + 0x10·e: +0 `LINE` (coder), +1 `SYNC`, +2/+3 `CRC_GOOD`.
- **Why:** the first page (+0..+F) was full (D32). The free +7 slot alone could not hold four
  bytes of new settings.

## D45. Area and timing after USB — **Changed (first routed run: timing; then the SRAM, D82)**

**Changed (D82):** the program memory is now two SRAM macros; the standard cells went from
392,179 to 198,770 µm² (`make synth`), and the tile is 8x4. D82 has the numbers.

| | Area | Share of 6×4 tiles | Worst logic path (slow corner) |
|---|---|---|---|
| Before USB (D34–D38) | 262,618 µm² | 29 % | 3.97 ns |
| With USB features | 333,841 µm² | 36.4 % | 4.33 ns (~5.2 ns with flip-flop overheads, budget 20.8 ns) |

Breakdown of the +71,223 µm²:

| Part | Area |
|---|---|
| FIFOs 4 → 16 bytes | 33,121 µm² |
| Two line coders | 24,283 µm² |
| Instructions, `CRC_GOOD`, byte-mode CRC feed, registers | ~13,800 µm² |

My estimate was about +50k µm²: 40 % low, as with the 128-word memory (D4). The coder was the
part I under-estimated most.

### Routed results (first full Tiny Tapeout run, commit df2e881)

| | Estimate (Yosys + ABC, above) | Routed (LibreLane, measured in CI) |
|---|---|---|
| Area / utilization | 333,841 µm², 36.4 % of 6×4 tiles | 44.3 % utilization (instance utilization 0.501) |
| Cells | — | 21,745 without fill; 73,420 instances with fill |
| Hold-fix delay cells | not estimated | 3,590 (about +14.9 % area) |
| Worst setup path, slow corner | 4.33 ns logic, ~5.2 ns with flip-flop overheads | ~20.3 ns |
| Setup worst slack, slow corner (budget 20.833 ns) | ~15.6 ns (implied) | 0.586 ns |

Static timing at a 20.833 ns clock, all corners:

| Corner | Setup worst slack | Hold worst slack |
|---|---|---|
| slow (1.08 V, 125 °C) | 0.586 ns | 0.602 ns |
| typ (1.20 V, 25 °C) | 7.95 ns | 0.284 ns |
| fast (1.32 V, −40 °C) | 12.344 ns | 0.106 ns |

Design-rule warnings (not failures): 277 max fanout; max slew 114 at the slow corner and 11 at
typ; max capacitance about 60–70. Antenna violations are 0 after repair, and DRC and LVS are
clean (0 design violations).

- **Area:** the estimate held up reasonably. Most of the gap to 44.3 % is the hold-fix cells,
  which a logic-only synthesis cannot see; the rest is placement buffering and resizing.
- **Hold cells: expected, kept.** Tiny Tapeout's 0.25 ns clock uncertainty plus the 0.1 ns hold
  margin apply to every direct flop-to-flop path (program memory, FIFO memories, shift
  registers, synchronizers), and those paths have almost no logic between flops, so the flow
  pads them with delay cells. Hold is met at every corner.
- **Timing estimate — Changed (first routed run):** the estimate was optimistic by about 4×.
  The worst routed path runs from `g_eng[1].u_eng.pc` through buffer chains into the mux4 tree
  that reads the 128 × 16 program memory, then through decode to the next state: ~20.3 ns at
  the slow corner against our ~5 ns. The method (D22) leaves out wire delay, and that path is
  dominated by it: the PC drives the select lines of the whole 128-way read multiplexer, a
  huge fan-out that place and route must buffer into long chains spread across the die. ABC's
  `stime` sees only the logic depth. Setup is still met at every corner, but with 0.586 ns
  at the slow corner, not the ~4× margin assumed in D18.

  This is a limit of the method, which D22 already stated ("wire delay and clock skew are not
  included"), not a tool bug, so it has no `BUG_LOG` entry. From now on, the routed STA report
  is the timing figure; the ABC estimate is only for comparing RTL changes with each other.
- **Follow-up:**
  - An instruction register now cuts the program-memory path in two (D50); the clock stays at
    48 MHz. Its routed slack is still to be measured by the next `gds` run.
  - The physical-design flow is paused (`gds` and `gl_regression` by hand only, D46) until the
    RTL is final.

## D46. Tiny Tapeout packaging — **Changed (10BASE-T: 60 MHz, D92)**

**Changed (D92):** `clock_hz` 60000000 and `CLOCK_PERIOD` 16.667 ns; the cocotb test runs at
16,668 ps.

- **Chosen:** the repository root is the Tiny Tapeout project, built from the IHP template
  (`ttihp-verilog-template`, actions `ttihp27a`, PDK `ihp-sg13cmos5l`):
  - `info.yaml`: 6×4 tiles, 48 MHz, language SystemVerilog, the pinout;
  - `src/`: the RTL and `config.json`, the template's file with `CLOCK_PERIOD` 20.833 ns;
  - `docs/info.md`: the datasheet page;
  - `test/`: a cocotb test;
  - `.github/workflows`: `gds`, `test`, `docs`, plus our `regression`.
- **Top module:** renamed `tt_um_ayushyadavnvs_pbe`, because Tiny Tapeout requires the GitHub
  user in the name. The file stays `src/tt_um_pbe.sv`.
- **Layout:** the RTL moved from `pbe_v1/src` to `src/`, because Tiny Tapeout requires the
  sources in `./src`. `pbe_v1/src` is now a link to `../src`, so `pbe_v1` (Makefile,
  testbenches, synthesis) is unchanged and stays the design's home. Alternatives:
  - a separate Tiny Tapeout repository: two copies of the RTL would drift, as v2 did (D28);
  - moving all of `pbe_v1` to the root: a large, noisy move for no gain.
- **Where the flow runs:** on GitHub Actions, as Tiny Tapeout intends. A local run needs
  LibreLane's tool set (OpenROAD, Magic, KLayout, Netgen) through Nix or Docker; Docker is not
  available in this workspace, and fetching LibreLane's Nix environment was not permitted here.
- **The cocotb test** (`test/test.py`) is small on purpose, because the `gl_test` job runs it on
  the routed netlist. It checks a register write and read-back, then loads the UART programs
  and loops a byte stream from engine 0 to engine 1 through `uio[0]` → `uio[1]`. Without the
  loopback it fails ("received []"). The full suite stays in `pbe_v1/test`, on the RTL.
- **Gate level:** a separate workflow, `gl_regression`. It runs after each `gds` run and on
  testbench changes, using the netlist of the latest `gds` run. At first it was a job inside
  `gds`, but then every testbench fix needed a 2.5-hour rebuild. It takes the routed
  netlist and the PDK's cell models, as Tiny Tapeout's `gl_test` does, and runs our full
  end-to-end testbenches (`tb_proto`, `tb_usb`, `tb_pbe`) on it: `make test-gl` in `pbe_v1`.
  The testbenches look only at the pins, except one I2C monitor that reads the flags register
  inside the design. That monitor is left out at gate level (`GL_TEST`), and the NOP check now
  reads the flags through the host port instead.
- **Lint:** Verilator with all warnings showed three, now fixed: a 3-bit index on a 16-bit
  vector (same behaviour, now written as 4 bits) and two deliberately unused bits. The
  `regression` workflow lints with `-Wall` on every push.
- **Clock period:** 20.833 ns (48 MHz), not the template's 20 ns. The cocotb test runs at
  20.834 ns, because cocotb needs an even number of picoseconds.
- **Changed: when the flow runs.** At first `gds` ran on every push to `src/`, `info.yaml` or
  `test/`, and `gl_regression` ran after it and on every testbench push. Both are now run by
  hand only (`gl_regression` still follows a `gds` run). The first full run passed; the RTL
  is now being finished (reviewer fixes, the 48 MHz timing fix) before physical design
  resumes. Otherwise each RTL push would start a 2.5-hour build, and each testbench push would
  test new tests against an old netlist. RTL tests (`regression`) still run on every push.
- **First full run (commit df2e881), measured in CI:**
  - **`gds`:** success in 2 h 18 min, of which detailed routing took 1 h 30 min and Magic DRC
    25 min. Precheck 9/9 passed; `gl_test` (the cocotb test on the routed netlist) passed 2/2.
  - **`gl_regression`** (run 40810602581, `make test-gl`: `tb_proto`, `tb_usb`, `tb_pbe` on the
    routed netlist with the PDK cell models): all passed, in 3 h 05 min, inside GitHub's 6-hour
    job limit.
  - Area, timing and the comparison with the estimates are in D45.

## D47. Modbus RTU: a pause of more than 1.5 characters makes a frame invalid — **Changed (idle start-bit wait, D78)**

- **Rule:** Modbus over serial line, §2.5.1.1: the characters of a frame follow each other with
  at most 1.5 character times of silence; a frame with a longer pause must be discarded. A
  frame ends after 3.5 characters of silence. Before this the program waited 3.5 characters
  inside a frame, so a 2-character pause was accepted (BUG-039).
- **Chosen:** `TIMEOUT` = 1.5 characters (+ 9 ticks, as before, because the program starts
  waiting 9 ticks before the stop bit ends): 141 ticks at 1/8 bit. The timeout routine, if in a
  frame, watches the line for 2 more characters in an X loop (`JMP PIN_LO` / `JMP X--`, 2 ticks
  a pass, 88 passes):
  - silence: the frame ends as before (FLAG2, IRQ), after 3.5 characters in all;
  - a start bit: the frame is invalid. FLAG3 is set at once; the program receives nothing more,
    and waits for 3.5 characters of silence (the same loop with X = 153, restarted by every low
    sample), then ends the frame with FLAG2 and IRQ. The host discards a frame with FLAG3 set.
- **Why a flag, not a status value:** the status byte is per character and the frame is only
  known to be invalid after the pause; FLAG3 is the engine's last free flag and needs no RX
  FIFO space. FLAG2 and IRQ still mark the end, so the host's frame loop is unchanged.
- **Why FLAG3 at once but IRQ only at the end:** one more word (an `IRQ` in `bad`) would make
  65; the host sees FLAG3 whenever it looks, and the IRQ comes when the line is quiet and the
  next frame may start.
- **Alternatives:**
  - a second timeout value in hardware (1.5 and 3.5): a register and a comparator for one
    protocol, against 6 words of program;
  - keep receiving after the pause and mark only the end: simpler, but the junk would fill the
    RX FIFO; the rule says discard.
- **Above 19200 baud:** the spec recommends fixed timers (750 µs and 1.75 ms) there, to spare
  slow CPUs; it does not forbid character-based ones. This engine counts in characters at every
  rate, so a 2-character pause is caught at 115200 baud too, and the frame end comes after
  3.5 characters (about 0.33 ms at 115200) instead of 1.75 ms. A host that wants the fixed
  750 µs can set `TIMEOUT` to it; the watch after it stays 2 characters (frame end at
  750 µs + 2 characters).
- **Cost:** 6 words (56 → 62 of 64).
- **Known limit (not new):** while idle, a timeout every 1.5 characters runs 2 instructions
  (`tmo`, `JMP TX_EMPTY`) before `WAIT rx, FALL` waits again; a start edge in those 2 ticks
  would be missed. It was the same with 3.5 characters, only rarer.
  **Changed (D78, BUG-100):** the window is 3 ticks (the `WAIT` itself issues on the third),
  and the idle wait is now `WAIT rx, LOW`, which sees a start bit that began during it.
- **Tested (Test 5):** a 2-character pause in a response at 19200 and 115200 baud is reported
  invalid (4 characters before the pause, none after); a 1-character pause at both rates is a
  valid frame; all earlier rounds (parity error, bad CRC, 8N2, RX overflow) still pass.

## D48. JCRCBAD means "packet bad": CRC not ok or a line error — **Changed (USB program: tokens checked too, D79)**

- **Problem (BUG-040):** a USB packet with a wrong stuff bit but intact data and CRC was ACKed.
  `STAT` cleared the line error before `JCRCBAD`, and `JCRCBAD` looked only at the CRC.
- **Chosen:**
  - `JCRCBAD` jumps when the CRC is not ok **or** the line error is set.
  - `CRCRST` clears the line error: it marks the start of a new checked packet. (An error in
    the very clock of the `CRCRST` is kept.)
  - `STAT` **no longer clears** the line error. It still reports it (bit 4) and still clears
    parity and timeout.
- **Why STAT stops clearing it:** USB's program does `STAT` then `JCRCBAD`, so the record gets
  the status and the jump decides on the same packet; a clear in `STAT` would hide the error from
  the jump. With `CRCRST` as the clear, the error's scope is one packet: from its `CRCRST` to the
  next one. The host's own clear (`STATUS[3]`) and restart still work.
  - **Alternative:** keep `STAT` clearing and swap the program's order (`JCRCBAD` before
    `STAT`): then the record and the ACK decision would need two code paths, and the 64-word
    USB program has no room.
  - **Alternative:** a separate `JLERR` jump: sub-op 7 is the last one free; "packet bad" is the
    test every checked protocol wants (USB, HDLC, CAN), so one jump covers both.
- **Programs:** `usb_dev.pbe` does `CRCRST` first in `dat`, before the DATA PID, so an error
  anywhere in the data packet counts (an error in the token before it does not).
  **Changed (D79, BUG-101):** the `CRCRST` is now right after the PID, before the token's second
  byte, so a line error in a SETUP or OUT token rejects the DATA packet after it, and IN tokens
  are checked with `STAT` (a token with a wrong stuff bit gets no answer). The firmware
  treats status bit 4 as bad, like bit 1 clear. Modbus uses `STAT` without the line coder, so
  its line error is always 0; no other program uses `JCRCBAD`.
- **Cost:** one OR gate and the clear on `CRCRST`.
- **Extended (CAN, D71):** in bit-synchronous mode every bus error (stuff, bit, form, ACK, CRC)
  is a line error, so `JCRCBAD` also jumps on a bit error. `CRCRST` also clears the new
  per-packet bits (arbitration lost, bit error, frame sent).

## D49. USB host firmware: resend an IN packet whose ACK was lost; handle bus reset

- **Retransmission (BUG-041):** the engine sends an IN packet once; if the host's ACK is lost
  (or corrupted) the TX FIFO is empty and the next IN gets a NAK, and the host never gets its
  data. USB's rule is that the device sends the same packet (same DATA PID) until it is ACKed.
  - **Chosen:** in the firmware. It keeps the last IN packet; if `TX_COUNT` = 0 and no `[0xD2]`
    record came for about 100 µs (a host ACKs within 7.5 bit times, 5 µs, and the record
    reaches the firmware within tens of µs), it queues the same bytes again and sets FLAG0.
    Meanwhile the engine NAKs, which USB allows.
  - **Alternative:** in the program, by not popping the packet until the ACK (a "peek" read of
    the TX FIFO): needs FIFO hardware for one protocol, and the program has no room.
- **Bus reset (BUG-042):** a reset (SE0 for at least 2.5 µs; hosts send 10 ms) must bring the
  device back to address 0. The engine sees it only as a long EOP.
  - **Chosen:** the firmware polls `PINS`; SE0 seen twice, 2.5 µs or more apart (one register
    read takes about 6 µs), is a reset. EOPs last 1.33 µs and are at least ~12 µs apart, so two
    EOPs cannot pass for one. It then rewrites program words 6 and 9 to `0x9000` and `0x9100`
    (`SET OSR` 0x00 and 0x10: address 0), clears FLAG0–2, flushes the TX FIFO and forgets any
    transfer.
  - **Alternative:** a reset event from the line coder (SE0 longer than N bits), as an IRQ:
    hardware for USB only, and the host polling every 50 µs is enough for a 10 ms reset.
- **The firmware model** (`tb_usb.sv`) does both on a 50 µs timer in the same process as the
  record handler, like a firmware main loop, so the two never race. The test waits 6000 clocks
  (was 3000) after SET_ADDRESS for the address switch, since a timer poll may come first; USB
  allows 2 ms.

## D50. An instruction register cuts the clock's worst path in two — **Changed (the SRAM, D82)**

**Changed (D82):** with the SRAM program memory the memory read (stage 1) is inside the macro,
addressed with `pc_d`; a host write refetches twice (BUG-074), and only the engine whose memory
was written. The four copies of the read address exist only in the flip-flop fallback
(`PBE_PMEM_FF`, the engine's `PC_COPIES` parameter).

- **Problem:** the first full Tiny Tapeout run (LibreLane, routed) met 48 MHz with only
  0.586 ns of setup slack at the slow corner (1.08 V, 125 °C; typical 7.95 ns, fast 12.3 ns).
  The worst path ran from `g_eng[1].u_eng.pc[1]` through the program memory read to the next
  state, all in one clock. From the routed report (`55-openroad-stapostpnr`, slow corner):

  | Part of the path | Delay |
  |---|---|
  | Clock to Q of `pc[1]` | 0.33 ns |
  | `pc[1]` fan-out: a chain of 11 buffers (5 of them `buf_1`, with slews up to 2.1 ns) | 9.15 ns |
  | The mux4 tree of the 128 × 16 memory (`assign instr = pmem[pc]`) | 2.89 ns |
  | Decode, `ready`, `exec`, next state (another fan-out chain, a hold buffer) | 7.25 ns |
  | Data path in all | 19.6 ns (clock period 20.83 ns) |

  `pc` fans out to every first-level multiplexer of all 16 bits (ABC: 1,878 loads on `pc[0]`).
  That fan-out was also behind most of the slow corner's 277 max-fanout, 114 max-slew and
  about 65 max-cap warnings. The logic-only estimate (`make timing`, 4.2 ns, D45) had missed
  all of it: wires and fan-out were three quarters of the routed delay.
- **Chosen:**
  1. **An instruction register.** Each engine executes `instr_q`, not the memory output. The
     memory is read at `pc`, which now means the word *after* the current instruction. When an
     instruction executes and does not jump, `instr_q` takes that word, so sequential code
     still runs one instruction per clock. A taken jump (JMP, JCRCBAD, JEQ, JNE, JLINE, the
     timeout) loads `pc` with its target and clears the valid bit `iv`; the next clock fetches
     the target (a bubble). Reset and restart also clear `iv`.
  2. **A tick that falls on a bubble is held** for that clock (`tick = tick_due && iv`, and the
     divider and delay counter wait), so it is late, never lost.
  3. **Host writes:** a write to the program memory (`pm_wr`, any word) clears `iv` and fetches
     the instruction that runs next again. So the host can rewrite the word a stopped or
     blocked engine sits on, as the USB firmware does after SET_ADDRESS (D42).
  4. **Four copies of the read address.** `pc` and three copies (`pc_copy`) each address 4 of
     the 16 bits, so each drives a quarter of the multiplexers. The copies are in an
     `always_ff` marked `(* keep *)`: without it Yosys merges them back into one register
     (BUG-044).
- **Stages:** (1) `pc` → memory multiplexers → `instr_q`; (2) `instr_q` → decode → `ready` →
  `exec` → next state, including `pc`.
- **Instruction timing** (in the comment at the top of `pbe_engine.sv`):
  - `CLKDIV` ≥ 1: (DLY + 1) × (CLKDIV + 1) clocks, exactly as before. The next tick is at least 2
    clocks after the instruction that jumped, and after a blocked instruction completes the
    divider restarts, so the bubble always fits in between. `tb_fetch` gives the same edge
    timings on the old and the new RTL at CLKDIV 1 and 3.
  - `CLKDIV` = 0, and with the line coder: DLY + 1 clocks, plus 1 for a taken jump. The first
    instruction after a restart starts 1 clock later. A host write to the program memory makes
    the engine slip by 1 clock.
- **Program timing:**

  | Program | Mode | Effect |
  |---|---|---|
  | UART, SPI controller, I2C controller (and PEC), 1-Wire, Modbus RTU, WS2812 | CLKDIV ≥ 1 | None |
  | SPI peripheral (D35) | CLKDIV 0 | The tight path, from the 8th rising edge to `WAIT sclk, FALL`, has no taken jump: still 8 clocks of the 12 in a 2 MHz half period. The `JMP X--` and `JMP bit` each take 1 clock more. Test 9 passes at 2 MHz |
  | I2C target and watcher (D37) | CLKDIV 0 | Polling loops take 3 clocks instead of 2, and the watcher waits 1 clock longer after a `JMP PIN_LO`. Hold and setup times come from the `[12]`/`[15]` delays, which are unchanged. Test 10 passes |
  | USB device (D42) | line coder | A few taken jumps on the reply path: turnaround 2.97–3.05 → 3.00–3.19 bit times (allowed 2–7.5). The byte-mode CRC feed already holds the next instruction for 8 clocks, and the `OUT`/`IN` handshakes with `pbe_line` take no jumps, so neither changes. Each byte still has 256 clocks. Test 11 passes |

- **Alternatives:**
  1. **A bubble after every instruction** (`instr_q` loaded from `pmem[pc]` every clock, `pc` the
     current word, as first suggested): the same cut, but every instruction takes at least 2
     clocks at CLKDIV 0. Run as a mutation, it breaks the SPI peripheral at 2 MHz (Test 9:
     MISO changes while SCLK is high, wrong bytes in both directions), because the path after
     the 8th rising edge grows from 8 to 16 clocks against a 12-clock half period. USB still
     passes, at 3.19–3.35 bit times. Rejected (BUG-043).
  2. **Read both `pmem[pc]` and `pmem[pc + 1]`:** no bubble even on jumps, but a second set of
     multiplexers for both engines, about as large as the memory read itself. A 1-clock bubble
     on taken jumps costs no program any margin.
  3. **Register the read address in the top level:** a stage between the next-pc logic and the
     memory. It cuts the same path, but every instruction then needs 2 clocks, as in 1.
  4. **A lower clock:** ruled out: USB low speed needs exactly 32 clocks per bit (D18).
  5. **Clear `iv` only when the write hits the current or the next word:** two 7-bit comparators
     and an address port to spare one clock per host write. Writes are rare (program loading,
     the USB address patch), so any write refetches.
- **Unit testbenches unchanged:** they connect the engine by port name and leave the new
  `pm_wr` input unconnected (z). A default value on the port would fix that, but Verilator
  5.020 (the lint in CI) rejects it (BUG-045). `pm_wr` is therefore used only in `if`
  conditions, where z reads as false. In the chip it is always driven.
- **Measured** (`make timing`, Yosys/ABC logic only, IHP slow library, no wires):

  | | Worst logic path | Levels | Largest fan-out on it |
  |---|---|---|---|
  | Before (`pc[0]` → memory → decode → `flags`) | 4.20 ns | 36 | 1,878 (`pc[0]`) |
  | After, stage 2 (`instr_q[10]` → pin index → `wait_ok` → `exec` → state) | 3.45 ns | 21 | 10 |
  | After, stage 1 alone (`pc[0]` → memory → `instr_q`; one read port, 4 bits per copy not modelled) | 1.20 ns | 17 | 1,825 |

  The logic numbers drop only by 18 %, because the logic was never the problem.
- **Expected routed slack** (an estimate from the routed report, not a new run):
  - **Stage 1:** clock to Q, the `pc` buffer chain and the multiplexers, about 12.8 ns with
    today's chain. With a quarter of the loads on each copy, the chain should lose 2–3 of its
    weak stages (about 1.3 ns each). So about 9–10 ns, or 10–11 ns of slack.
  - **Stage 2:** the decode-to-state part was 7.25 ns, plus clock to Q and the `instr_q` fan-out:
    about 8 ns.
  - **Unchanged paths:** the worst path that did not start at `pc` was `clkdiv` → divider
    compare → `tick` → `issue` → `exec` → state, at 8.16 ns of slack. It has a `nor4_2` driving
    0.33 pF with a 4.3 ns slew. It is now the likely worst path.
  - **So:** about 8 ns of slack at the slow corner, up from 0.586 ns: the worst data path goes
    from 19.6 ns to about 12–13 ns. The `exec`/`tick` fan-out is the next thing to cut if more is
    needed (for example a registered `tick`).
- **Cost** (`make synth`, typical library): +76 flip-flops (per engine: `instr_q` 16, `iv` 1,
  three copies of `pc` 21), area 333,913 → 337,779 µm² (+3,866 µm², +1.2 %).
- **Tested:** `tb_fetch.sv` (Test 12), end to end through the pins and the host port:
  - **Timing:** at CLKDIV 0, 1 and 3, every edge of a program of `PIN TOG` instructions (DLY 0,
    1 and 2, taken and untaken jumps, a `WAIT` on a pin) against the rule above.
  - **Host writes:** (a) the host rewrites the word a stopped engine is parked on, then runs it
    without a restart; (b) the host rewrites word 0, then restarts; (c) the host rewrites the
    low byte of a running engine's blocked `WAIT FLAG 0, HIGH` into `LOW`, and the engine must
    go on without the flag changing.
  - **Mutations caught:** no refetch on a host write ((a) and (c) fail), refetch at `pc` instead
    of the current word ((a) fails), a tick lost on a bubble (CLKDIV 0 fails), and a bubble
    after every instruction (CLKDIV 0 fails, and Test 9 fails). The old RTL fails exactly the
    three taken-jump gaps at CLKDIV 0.

## D51. Independent verification without changing the design

- **Decision (2026-10-29):** add a Python executable specification, clock-by-clock RTL
  differential tests, stock sigrok decoding, and maintained third-party protocol models.
  This is verification work: no instruction, register, protocol program, or RTL behavior is
  changed. GDS, gate-level regression, synthesis and physical design are outside this work.
- **Alternatives:** more checks inside the existing SystemVerilog protocol models are useful
  but share assumptions with the design. A specification-driven Python model provides a
  separate oracle; external decoders and bus libraries provide additional independent views.
- **Model boundary:** instruction semantics come from `src/pbe_engine.sv`'s header, the
  register map from `src/tt_um_pbe.sv`'s header, CRC/line framing from their headers and D50.
  Reset, two-stage input synchronization, simultaneous events, pre-edge FIFO acceptance and
  host read staging are explicit. Undefined unwritten storage is represented, not assigned
  a convenient hardware reset value. No simulated engine state is copied into the oracle.
- **Stimulus and observation:** real host SPI pins load programs and configurations, drive
  FIFO traffic and modify memory while running. Each clock compares `uio_out`, `uio_oe`,
  `uo_out`; completed runs also compare FIFO contents, flags, CRC and host status readbacks.
  A test-only NOP initialization of program memory makes stopped-engine fetches deterministic;
  subsequent program loads and modifications use the host port. FIFO storage is unreset.
- **Timing:** cocotb 2 uses an even 20,832 ps period (approximately 48 MHz); exact real
  48 MHz cannot be represented by an integer number of picoseconds. Directed engine tests
  check D50 independently at dividers 0, 1 and larger values. The line coder has a separate
  differential campaign, so failures can be localized before engine integration.
- **Reproducibility:** `make diff N=1000 SEED=0x504245` runs consecutive seeds, logs the first
  mismatching clock/PC/instruction and both states, and writes coverage plus a failure JSON.
  Saved model/tool regression seeds live in `verify/golden-model/differential/regressions.json`. The short
  fixed-seed smoke is part of `make test`; extensive campaigns remain explicit targets.
- **Failure policy:** disagreements are classified as RTL, model, tool or underspecified
  text. Record before/after evidence and reproductions in `BUG_LOG.md`. Unfixed external-tool
  failures remain explicit failing commands; they do not justify changing RTL. Runner XML
  must contain tests and no failures, since the simulator process's exit code alone is
  insufficient with cocotb's Python runner.
- **Parallel work:** separate agents own the engine/line model, sigrok tests, and third-party
  bus tests; the coordinator owns the top-level model, integration and phase commits. Shared
  source is inspected, and only verification files and the three VCD testbench opt-ins change.
- **Tools, results and limits:** see `verify/golden-model/REPORT.md` and phase-specific reports
  for exact versions, commands, measured coverage and decoder/library limitations. Evidence
  here is behavioral simulation only; it makes no new routed timing, silicon or board claim.

## D52. Decode captured protocol pins with stock sigrok layers

- **Decision:** add an off-by-default `PBE_SIGROK` testbench define for scalar
  external pins and phase markers, then decode generated VCDs using unmodified
  sigrok decoders. Preserve the existing optional full-design `+vcd` captures.
- **Alternative:** writing another protocol decoder would repeat assumptions.
  The stock UART/SPI/I2C/1-Wire/Modbus/WS2812/USB decoder stacks are independent.
- **Extraction:** retain preceding idle levels and coalesce same-timestamp VCD
  updates, with 10 ns sample spacing and fixed pre/post padding. Preserve original
  hashes, boundaries, commands and decoder stdout. The capture-boundary regression
  is part of the default test suite and requires no sigrok installation.
- **USB limitation:** valid windows check ten control requests; the complete
  packet trace independently checks corrupt traffic and identical retransmission.
  An additional strict full-request target retains two known stock-decoder
  failures (BUG-050/051). Neither those failures nor window selection changes RTL.
- **Results:** 22/22 primary checks pass from fresh simulations; strict full-request
  comparison is 22/24 on libsigrokdecode 0.5.3. Versions, commands and boundaries
  are in `verify/golden-model/PHASE2.md` and its checked-in evidence.

## D53. Third-party bus endpoints attach only to chip pins

- **Decision:** use pinned cocotbext UART/SPI/I2C libraries through a test-only
  scalar-pin fixture. Load/configure/read the actual chip exclusively through
  host SPI. A resolved digital bus uses pull-ups and low-dominant wired signals.
- **Alternatives:** hierarchical memory/FIFO deposits would speed setup but bypass
  host behavior; handwritten endpoints would offer less independence. Neither is
  used in these bus tests. The fixture is not an analog pad or contention model.
- **Random settings:** independent endpoint bytes, gaps, UART baud choices, SPI
  mode-0 clock choices and I2C rates/stretching. Three cases cycle -1%, nominal,
  +1% error for externally timed UART, peripheral SPI and target I2C. Controller
  SPI/I2C vary program dividers. The original SPI programs only support mode 0;
  selecting modes 1–3 fails with an explicit unsupported-mode message.
- **Compatibility:** cocotbext-spi 0.5.0 needs local cocotb-2 API/time adapters;
  cocotbext-i2c 0.1.2 needs receive sampling after actual SCL-high when stretched.
  The library implementations remain installed unchanged. The test file names
  these adaptations, and `--stock-spi`/`--stock-i2c` reproduce their failures with
  nonzero exits. No design change is used to satisfy an endpoint assumption.
- **Stretch stimulus:** an independent low-phase stretcher only starts after an
  existing SCL falling edge; a callback delay that creates extra edges is invalid
  stimulus and was rejected (BUG-056). A target's host-response latency separately
  tests legitimate target clock stretching.
- **Evidence:** six endpoints, 18 randomized cases pass; final randomized SPI gap
  rerun and six-endpoint smoke also pass. Full settings, versions, limits and
  reproducible bugs are in `verify/golden-model/PHASE3.md` and bus `results.json`.

## D54. Bootstrap Python verification dependencies in GitHub regression

- **Decision:** the existing regression workflow selects Python 3.11 and installs
  `verify/golden-model/differential/requirements.txt` before the expanded `make test`.
  The new model and differential smoke remain mandatory, with failures propagated.
- **Alternative:** silently skipping the differential test when cocotb is absent
  would make local and CI verification differ and could produce misleading passes.
- **Scope:** dependency setup only. No RTL, protocol, GDS or gate-level workflow
  change. The two physical-flow entry points retain their existing triggers.
- **Evidence:** missing-dependency import fails with an unconfigured interpreter;
  the pinned environment imports cocotb 2.0.1 and runs the suite. See BUG-057.

## D55. Round-2 verification records contracts, negative checks and tool versions

- **Scope:** branch `verify/round2` starts at `verify/golden-model` commit `2d62b89`.
  Complete the round-1 audit before formal/vector/coverage phases. Run `make test`
  successfully before each phase commit; long jobs stay separate. Do not merge
  to main or invoke physical-design/GDS/gate-level flows.
- **Model independence:** distinguish original specified ISA rules from exact
  cycle priorities learned from implementation. The rule inventory in
  `verify/golden-model/ROUND2_MODEL_AUDIT.md` preserves that provenance. Header
  additions document existing behavior; they do not retrospectively make a
  shared model assumption independent. Behavioral HDL remains unchanged.
- **Alternatives:** calling every model agreement an independent specification
  check would overstate evidence. Tightening RTL or restricting formal inputs to
  hide the original stronger window/write claims would conceal counterexamples.
  Retain those assertions as explicit expected failures and document the observed
  contract separately (BUG-058/059).
- **Tools installed locally:** OSS CAD Suite archive `20260727`; Yosys
  `0.67+94 (7defa5186-dirty)`; SBY `v0.67-4-gfea6e46`; Yices `2.7.0` revision
  `05178c03ddf49c6bba63c5c7153774c11a5da12d`; Bitwuzla `0.9.1`;
  Verilator `5.051 devel v5.050-99-gf8fb1d664 (mod)`. The bundle is extracted in
  `/tmp/pbe-round2-tools/oss-cad-suite`, not installed into the system. Downloading
  the suite does not invoke its physical-design tools. Icarus12/cocotb2.0.1 and
  the pinned round-1 libraries remain available; receipts record each actual tool.
- **Limits:** finite simulation, BMC, induction proofs, decoder agreement and RTL
  coverage are different evidence. Report assumptions, depth, result and traces
  separately. A two-state formal model alone cannot establish absence of X values
  in a four-state simulator. A failed requested property remains visible.

## D56. Mutation sensitivity is measured using isolated fault copies

- **Decision:** mutate one exact RTL site at a time in an immutable scratch-copy
  baseline, run actual `make test` and `make diff` for every fault, retain raw
  compressed logs plus source hashes and per-check receipts. Never commit a mutant.
- **Alternatives:** compilation errors, infrastructure failures and wall-time
  timeouts do not demonstrate a test detecting a hardware fault. They are recorded
  separately. A simulation watchdog is specifically identified rather than called
  a byte-level assertion failure. Mutant jobs use separate directories.
- **Result:** 24 faults tested; initial suite catches23, separate one-seed diff
  catches17. The sole combined survivor is empty-FIFO pop guard removal. Add an
  independent boundary test and rerun that mutant; it now fails with count31.
  Preserve the original survivor and correction rather than rewriting history.
- **Provenance:** the first aggregate source-hash guard correctly rejected a
  concurrent comment-only audit edit after all48 make invocations finished. Its
  summary is explicitly reconstructed from receipts; it is not claimed as a
  successful original runner exit. The revised runner freezes a baseline and
  offers opt-in comment-only equivalence, with literal hashes strict by default.
- **Evidence:** `ROUND2_MUTATIONS.md` and `evidence/round2/mutations/`. Keep `make
  mutate` separate from the short default gate. BUG-061 records the new boundary
  test, without modifying the correct FIFO RTL.

## D57. Keep full USB decoder disagreements as exact expected failures

- **Decision:** always run full low-speed request decode in `make sigrok`, pin both
  signalling/packet low-speed options and `in_request_start=submit`, distinguish
  PASS/verified exact XFAIL/unexpected FAIL, and keep `sigrok-full` strict. Changed
  versions/results, absent signatures and exceptions are not expected failures.
- **Evidence:** USB1.1 chapters7/8, original PDF hash and source references are in
  `ROUND2_USB.md`. Synthetic packets sent to the unchanged stock request class
  reproduce both defects without PBE waveforms. Both request-start options fail;
  first-ack adds BUG-062. This characterizes tools, not complete PBE conformance.
- **Root cause:** missing DATA/handshake timeout leaves DATA RECEIVED stuck. A
  retry IN is rejected; its NAK finishes stale data, unconditionally appended to
  control IN before an acknowledged retry appends it again. This refines BUG-051.
- **Alternatives:** suppressing traces, treating every failure as expected, or
  editing RTL to fit a decoder would hide faults. Exact independently reproduced
  signatures retain negative evidence. Reject stderr tracebacks even with nonempty
  stdout and exit0; installed decoder source remains unchanged (BUG-062).

## D58. Formal evidence keeps assumptions, bounded checks and failed claims separate

- **Decision:** use one SBY configuration per block, assertion-only generated
  copies in ignored `pbe_v1/build/formal/generated/`, and a source-aware runner.
  Tracked RTL transitions are unchanged. `make formal` is a separate long target;
  the default simulation gate does not install tools or run proofs.
- **Unbounded proofs:** 16-byte FIFO occupancy/boundaries/flush and arbitrary
  selected-item order pass temporal k-induction; synchronized mode-0 host SPI
  framing, addresses, bus strobes and staged read data also pass induction.
  FIFO inputs are arbitrary after one initial reset. Host assumptions enforce
  SCK high/low phases of at least four clocks and legal CS/SCK transitions;
  arbitrary pauses and partial-byte CS aborts remain allowed. Cover-only host
  timing fixes phases to four clocks to accelerate search; proof timing is not
  restricted to that single rate.
- **Bounded checks:** engine safety and coupled pre-edge D50 RAM equality use
  BMC 40, coder off/divider 0. Timeout BMC 50 covers a permanently blocked WAIT,
  TIMEOUT 1–5, CLKDIV 0–3, stable run/config and no host refetch/restart; its
  independent tick-age and clock deadline prevent a vacuous never-issuing pass.
  Four-state reset/restart simulation supplements two-state formal checking.
- **Line scope:** 64 mode/order combinations send two symbolic bytes or 16 bit
  transfers, matched shift direction, detectable nonzero sync and period 3;
  BMC 164 includes a completion deadline at cycle 160. Pair modes assert exact
  length for arbitrary payload. Stuffed single-wire modes assert payload-prefix
  delivery and allow idle suffixes; unstuffed single-wire payload additionally
  has a zero every fourth bit. Twelve arbitrary-input stuff-reaction BMC jobs
  and 12 reachable-response cover jobs use depth 48. Shared encoder/decoder
  composition does not independently prove the stuffing algorithm's merits.
- **Retained failures:** original physical/actual PC fences, period-0 reception,
  no-sync/idle-high/exact-length single-wire claims and unconditional stuff-error
  claims remain explicit failed properties with traces. Twelve expected failures
  are not counted as proofs or passing assertions. No RTL restriction was added
  to hide them. Host/engine/cover monitor corrections and receipt metadata bugs
  are recorded separately (BUG-063/064/066/067/068/071).
- **Alternatives:** BMC alone cannot replace induction for FIFO/host safety;
  assuming away all original failing assertions would misstate the request;
  changing source behavior to satisfy a test would defeat verification. A global
  all-rate/all-protocol claim is rejected in favor of named contracts/depths.
- **Provenance and tools:** `verify/formal/run.py --collect` compares every expanded
  task configuration and copied source against the checkout, rejects missing
  statuses, unrelated expected-failure errors, timeouts and stale inputs, checks
  induction evidence, and records effective last-option overrides. SBY
  v0.67-4-gfea6e46, Yosys 0.67+94 and Yices 2.7.0 produced the results; Icarus
  supplies the separate four-state simulation. Existing D55 records bundle and
  alternate-solver versions. No physical-design/gate-level flow was invoked.
- **Result:** 108 jobs match their explicit expectation: 2 induction proofs,
  79 bounded assertion passes, 15 successful cover jobs reaching 22 statement events across jobs,
  and 12 failed original properties. Contracts, raw compressed logs, exact
  hashes, counterexample VCDs and aggregate receipt accompany the three block
  reports. This is finite/assumption-qualified verification, not tapeout sign-off.

## D59. Reference vectors use external CRC and protocol encoders against captured RTL traffic

- **Decision:** test the real `pbe_crc` public ports with fixed primary RevEng
  catalogue records and independent `crccheck`; test USB and Modbus through the
  chip pins using packets generated by maintained external libraries. Keep
  these longer vector targets separate from default `make test`. Targets never
  install dependencies automatically or modify RTL/protocol programs.
- **CRC contract:** pin poly/width/init/refin/refout/xorout/check/residue metadata
  for 25 catalogue entries, including every CRC family used by the programs and
  at least ten extra configurations across widths 3–16. Twenty-two native
  configurations pass ASCII `123456789`, empty data, eight seeded random payloads
  each, exact-width appended checksum/residue, raw CRC_GOOD and corrupted-checksum
  checks. Three arbitrary-init configurations are explicitly unsupported and
  not counted as RTL passes. Feed bit order and raw/reflected output remain
  distinct; xorout is an explicit software transformation, not a new register.
  USB catalogue residue B001 corresponds to raw CRC_GOOD 800D; CRC5 residue 06
  corresponds to raw good 0C. CRC-12/UMTS exercises unequal input/output reflection.
- **CRC boundary:** direct-unit testing establishes primitive behavior, not
  automatic configuration in an unchanged program. USB's program checks its
  supported token CRC5 pattern rather than adding dynamic arbitrary-token CRC5
  logic. The primitive accepts only zero/all-one native seeds; arbitrary xorout
  values may require host/software work. No internal CRC state is forced.
- **USB vectors:** LUNA packet helpers generate PID/token/data/handshake bytes
  and CRC5/CRC16; usb-protocol additionally validates PID complement nibbles.
  The latter release lacks a raw CRC packet encoder, so using LUNA is an
  explicit alternative to writing a local encoder. Retain the existing bus
  serializer/receiver and firmware model, while expected complete packet bytes
  come from the external helpers. Two seeds each pass 38 host packets and 13
  final DUT responses, including rejection, descriptors, vendor data and STALL.
- **Modbus vectors:** PyModbus FramerRTU builds request/response ADUs and checks
  actual captured frames independently. Seven pin-level cases cover varied
  addresses/counts/data, 19,200/115,200 baud, 8E1/8N2, a corrupt CRC and a two-
  character mid-frame gap. The electrical gap assertion belongs to the wire
  bench/program status; PyModbus has no electrical-time input.
- **Alternatives and limits:** handwritten CRC/PID generators or golden-model
  self-comparison would share more implementation assumptions. Independent
  packet bytes do not independently validate the retained serializer, receiver,
  firmware behavior or analog pads, nor establish complete USB/Modbus conformance.
  No unsupported hardware feature is introduced to fit a catalogue entry.
- **Tools/provenance:** primary RevEng catalogue accessed 2026-10-29; crccheck
  1.3.1, cocotb 2.0.1, Icarus/vvp 12.0; measured Python 3.10.12 for CRC and
  protocol runs. The earlier CRC 3.10.14 entry came from the cocotb banner and
  is corrected by launcher/embedded probes in phase 3 (BUG-073), with old
  receipts/logs preserved. Protocol pins use luna-usb 0.2.3, usb-protocol 0.9.2 and pymodbus
  3.11.3. Requirements, catalogue anchors, commands, generated tasks, hashes,
  raw outputs and before/after BUG-065 evidence are checked in with the two
  vector reports. Only simulation runs; no physical-design flow is invoked.

## D60. Coverage reports logical obligations separately from raw tool instances

- **Decision:** build/run the normal SV benches under Verilator with coverage,
  then reuse the same per-clock top differential oracle and independent line
  sweep. Add observation-only cover instrumentation in ignored scratch sources;
  never change tracked RTL, protocol programs or assertions to obtain a hit.
  Keep `make coverage` as a separate long target and `make test-coverage-tools`
  as seven fast harness regressions. The ordinary gate remains Icarus/four-state.
- **Functional obligations:** aggregate 92 named bins by logical name across
  engines and test roots: 8 opcodes, 22 sub-ops, 8 JMP conditions, 8 pin/flag
  WAIT conditions, 3 timeout/overflow/D50 events, 10 STATUS set/clear transitions,
  32 active line modes and simultaneous running engines. Initial 89/92 gaps
  close with observable WAIT FLAG RISE/FALL and overflow-clear tests. A hit does
  not imply every engine, operand or taken/not-taken outcome was exercised.
  D50's bin observes an invalidation request; separate fetch assertions check
  the refill. Final functional coverage is 92/92.
- **Structural aggregation:** coalesce identical original RTL source points
  across hierarchies/benches, excluding testbench and appended instrumentation.
  A source point is covered if any instance hits it. Final counts are line
  190/191, toggle 3,186/4,062, branch 278/292, expression 443/461. Preserve the
  raw vendor report separately because it includes testbenches, instrumentation
  and per-hierarchy copies with different denominators. Neither denominator is
  silently substituted for the other. The remaining line is a reachable unused-
  address no-op, not an exclusion or declaration of unreachability.
- **Artifact/provenance rules:** every successful simulation must create a new
  regular nonempty data file. Clear old dumps before launch and before full
  aggregation; propagate compile, assertion, XML and missing-data failures.
  Refresh existing program-image make dependencies before snapshotting hex;
  require source/include signatures for reused builds; isolate differential
  diagnostics by build. Negative regressions retain failure evidence (BUG-072).
  Scratch diagnostic-format and annotation-cwd adaptations are explicit tool
  fixes (BUG-069), with failed originals retained.
- **Alternatives/limits:** a raw per-copy percentage alone obscures logical
  obligations, while reporting only 100% bins hides unexercised structural
  behavior. Keep both. Verilator is two-state: `$isunknown` cannot prove X
  freedom there. Only the model-marked unspecified empty-FIFO MISO bit is masked;
  known outputs remain checked, and the separate Icarus four-state gate remains
  authoritative for those X checks. Preserve three negative contract runs as
  expected failures, not successful assertion traces used to improve coverage.
- **Tools and outcome:** Verilator/verilator_coverage 5.051 devel
  (`v5.050-99-gf8fb1d664`), GCC/G++ 11.4.0, cocotb 2.0.1 and measured Python
  3.10.12. Launcher and embedded Icarus/Verilator probes resolve the misleading
  3.10.14 banner as a metadata discrepancy (BUG-073), without asserting its
  cause. The hardened complete campaign preserves 92/92 bins and all reported
  source metrics. Raw logs, data, hashes, annotations and old artifact-policy
  receipts are retained; no physical-design or synthesis flow is invoked.

## D61. Stress observations preserve adverse results and distinguish deadlines from recovery

- **Decision:** run the optional stress campaign separately from default `make
  test`, using a new external-pin fixture, the existing host/program helpers,
  and independent UART/SPI endpoints. Keep RTL, protocol programs and canonical
  benches unchanged. Expected data comes from fixed or seeded bytes; only pin
  and documented host-register observations determine the outcome.
- **Exit contract:** `make stress` runs the 22 required observations strictly;
  `make stress-characterize` runs all 33 and permits evidence collection to
  complete while retaining five FAIL labels. `make stress-strict` runs all 33
  with a nonzero result for any failed observation. Characterization is an
  explicit alternative to aborting before collecting later margins; it never
  converts an adverse observation into a PASS. Reevaluation of the saved full
  evidence returns strict/required/characterization exits 1/0/0.
- **Measured scope:** UART RX/TX at approximately 500 kbaud passes the required
  ±2% clock-error cases. RX also passes this seed's ±2% independent per-bit
  jitter at ±2% average error, a four-chip-clock delayed digital rising crossing,
  and a one-chip-clock idle glitch. Sampled RX ±3%, ±4% and ±5% pass; the first
  failing sampled points are ±6%, with failures also at ±8%. A centered
  one-chip-clock data pulse changes `00` to `08`. These are finite observed
  operating points, not guaranteed margins over all payloads/phases/rates.
- **Host and concurrency:** 16 UART bytes survive a complete burst plus another
  1 ms without host service and 100-bit pauses between subsequent reads. Of 20
  incoming bytes, the FIFO plus blocked PUSH preserve the first 17; the last
  three are lost while the engine cannot sample. Sticky RX overflow and IRQ
  assert, and a new `42` byte is received after draining without a restart.
  Twelve rounds run UART TX on E0 and SPI controller on E1 with disjoint pins,
  restart/flush both between completed transfers, and compare all UART/MOSI/
  MISO bytes. Each final round measures 1,336 overlapping chip clocks. An
  isolated identical-source differential supplement passes eight seeds and
  276,039 compared clocks with 5,000 stimulus iterations per seed.
- **Deadlines and limits:** the final required run uses a 200 ms simulation-time
  whole-driver watchdog, finite count-qualified drain loops and 1 ms caller
  read deadlines. The earlier full characterization preceded the whole-driver
  watchdog and overlap counter; its byte comparisons/stimulus are unchanged.
  Neither run encounters a caller deadline. A watchdog only bounds the test;
  it does not prove self-recovery or a universal no-hang property. UART's
  single-sample 8N1 program has no dedicated framing-error record or majority
  vote, so the adverse data/clock cases remain visible corruption limitations,
  not asserted RTL defects or cleanly reported protocol failures.
- **Alternatives and evidence boundary:** preserve incorrect bytes and status
  rather than changing the program, relaxing expected data or presenting
  injected corruption as success. A delayed digital threshold crossing is a
  reproducible simulator approximation, not analog slew, metastability or pad
  characterization. I2C, Modbus, USB, 1-Wire and WS2812 stress margins, systematic
  pulse-phase sweeps and mid-byte restart atomicity remain unmeasured here.
- **Tools/provenance:** Python launcher and independently probed embedded runtime
  3.10.12 (startup banner says 3.10.14; see BUG-073), cocotb 2.0.1, cocotbext-uart 0.1.4, cocotbext-spi 0.5.0 with its
  existing documented compatibility adapter, and Icarus/vvp 12.0 stable.
  The clock uses the nearest even integer period, 20,834 ps. Seed `0x50424534`,
  exact bytes/status, raw logs, XML, source hashes, evaluator exits and the
  isolated differential receipt are retained under `evidence/round2/stress/`.
  BUG-070 records a corrected evidence-export interpreter invocation. No
  dependency installs occur in targets and no physical-design flow is invoked.

## D62. Program memory: flip-flops vs SRAM — **Changed (adopted with separate images, D82)**

**Changed (D82):** the owner adopted the SRAM, on an 8x4 tile, with **separate** 256-word
images per engine (alternative 7 below) instead of mirrored writes; the SRAM is the default
build and the flip-flops are a 64-word-per-engine fallback behind `PBE_PMEM_FF` (`USE_SRAM` is
gone). The flow part below (item 5: the 67.44 µm stripe lattice, `sram/pdn_cfg.tcl`,
`sram/flow.patch`) is **retired**: it had no step extending the stripes onto the macros'
supply columns (Tiny Tapeout's `Project.ExtendPowerStripes`), so the macros could have been
left unpowered; `sram/` is deleted. The flow now follows Tiny Tapeout's example
(`docs/SRAM_8x4_FLOW_STEPS.md`). The instance names are now `u_pmem.u_sram0`/`u_sram1`. The
prototype text is kept below as it was.

- **Number:** made as D55; renumbered D62 when round 2's D55-D61 were merged (D64).
- **Problem:** the 128 × 16 flip-flop memory is about half the chip. In the first routed run
  (D45) it is 246,909 µm²: 55 % of the 452k µm² of standard cells and 27 % of the 6x4 die
  (2,048 flip-flops 100k, write logic 78k, read multiplexers 50k, tie cells 15k, buffer trees
  3k), and 2,048 of the 3,590 hold buffers sit on it, one per bit. Its read multiplexers are
  D45's worst path. Programs are nearly full (USB 64 of 64 words in its window, Modbus 62),
  and CAN, SWD and LIN are planned. The competition points to SRAM for instruction memory.
- **Found:** IHP's SRAM macros are in the CMOS5L PDK (`sg13cmos5l_sram`, a symlink to the
  SG13G2 library) at the commit our flow installs, use Metal1–Metal4 only (all a CMOS5L block
  may use), and two CMOS5L Tiny Tapeout projects pass `gds`, `precheck` and `gl_test` with them,
  one of them at 6x4. `RM_IHPSG13_1P_256x16_c2_bm_bist` is 236.8 × 118.78 µm (28,127 µm²), with
  a 5.30 ns clock-to-output at the slow corner and a per-bit write mask. Full survey in
  `docs/SRAM_INVESTIGATION.md`.
- **Proposed: one `RM_IHPSG13_1P_256x16` per engine, both written by the host.**
  1. **Mirrored writes** keep D4's shared image: the host writes the same word into both
     macros, each engine reads its own. Programs, `START_PC`, the assembler and the host see
     no difference. The byte writes use the write mask (`A_BM`): no read-modify-write.
  2. **The macro is addressed with `pc_d`**, the value `pc` takes at the edge (a new engine
     output, the existing `pc_next`). After that edge `DOUT` is the word at `pc`, which is what
     D50's stage 1 delivered, so D50's prefetch, timing rule and `instr_q` are unchanged. Stage
     1 becomes the macro's access time; stage 2 ends at the macro's address pins.
  3. **A write takes the port for a clock**, so that clock's read is lost and `DOUT` is stale
     for one clock. The engines refetch at the write (as in D50) and again one clock later
     (`pm_wr_q`). Two bubbles per host write instead of one; only `CLKDIV` 0 engines notice
     (a 2-clock slip). `pm_wr_q` resets to 1, so the first fetch after reset is also a refetch.
  4. **The flip-flop build stays** the default; `USE_SRAM` selects the macros.
  5. **Flow:** the macros on the bottom edge, flipped (`FS`), at x = 415.68 and 685.44; the
     Metal4 stripe lattice (pitch 67.44 = 6 × 11.24 µm, offset 25.40, spacing 3.52) puts four
     VPWR and four VGND stripes on each macro's supply columns, the only possible hookup on
     CMOS5L (same layer, no via). `sram/pdn_cfg.tcl` lets pdngen draw through the macros and
     checks the result; `sram/check_sram_floorplan.py` checks it from the LEF and GDS.
- **Alternatives** (details and numbers in `docs/SRAM_INVESTIGATION.md` §3):
  1. **Keep the flip-flops:** no flow risk, but half the area, most hold buffers, the worst
     path, and a 128-word ceiling.
  2. **One shared 2P (dual-port) macro**, `RM_IHPSG13_2P_256x16`: 57,521 µm², the same as two
     1P macros, but only 256 words with no option to split, one port shared with the host
     anyway, 420 µm wide, and no CMOS5L Tiny Tapeout precedent.
  3. **One shared 1P macro, time-multiplexed** between the engines: 28k µm² less again, but
     each engine reads every other clock, so at `CLKDIV` 0 every instruction takes 2 clocks.
     That is D50's rejected alternative 1, which breaks the SPI peripheral at 2 MHz (BUG-043).
  4. **SRAM plus a small flip-flop cache:** tags in the fetch path, misses at `CLKDIV` 0;
     complexity without a need.
  5. **Latches instead of flip-flops** (D4's "next option"): 30.8 instead of 49.0 µm² per bit,
     about 37k µm² saved, the multiplexers and the timing problem stay.
  6. **64×16 macros** (as TeslaCoilerOW): 15,240 µm² for 64 words; 2 per engine for 128 words
     is 61k µm², more than two 256×16 for half the words.
  7. **Two separate, not mirrored, memories:** 256 private words per engine, but the host
     loads each engine separately and D4's shared image is gone. Kept as a later option (one
     address bit), not the default.
- **Program size:** the prototype keeps 128 words (macro address bit 7 tied to 0). 256 shared
  words need an 8-bit `pc`, `START_PC` and host pointer (`PM_ADDR_H` at the free 0x0F), no
  area. Programs longer than 64 words need wider jump targets, and no ARG bit is free (`JMP`
  and the EXT jumps use `[8:6]` + `[5:0]`): proposed a `PAGE p` instruction on EXT sub-op 7,
  the last free one (taken jumps go to `START_PC + {p, target}`; restart and the timeout reset
  the page). **Changed (CAN, D67):** sub-op 7 with param[5] = 0 is now `LINECTL`; `PAGE` keeps
  param[5] = 1, so `p` has at most 5 bits (32 pages of 64 words: far more than any memory
  considered here).
- **Expected:** ≈ 185k µm² saved (≈ 50 % → ≈ 29 % utilization), ≈ 1,800 fewer hold buffers,
  ≈ 9k fewer cells, D45's worst path gone. Not measured in the flow yet.
- **Measured** (`make synth-sram`): 337,264 → 142,892 µm² of standard cells, plus 2 × 28,127 µm²
  of macros; flip-flops 3,494 → 1,405.
- **Tested:** `make test` runs `tb_fetch`, `tb_usb`, `tb_proto` and `tb_pbe` on both builds
  (IHP's behavioural model for the SRAM build), and both builds pass Verilator `-Wall` lint.
  The TT cocotb test passes on the SRAM build with `sram/flow.patch` applied. Mutations: a
  single refetch (BUG-074) fails `tb_fetch` (a); no refetch after reset and a refetch only one
  clock late are not caught (no test provokes them; see the investigation §3.7).
- **To decide it:** a `gds` run by hand with `sram/flow.patch` (steps in
  `docs/SRAM_INVESTIGATION.md` §4), and the organisers' confirmation that a macro is accepted.
  When adopted, mark D4, D45 and D50 **Changed**.

## D63. Independent verification lives in `verify/golden-model/`

- **Chosen:** the golden model and everything that checks the design against outside
  references sit in one top-level directory, `verify/golden-model/`: the Python model
  (`model/`), the random differential harness (`differential/`), sigrok decoding (`sigrok/`), the
  third-party bus models (`bus_models/`), the reports and the recorded evidence. Before this they
  were spread over `pbe_v1/model`, `pbe_v1/test/differential`, `pbe_v1/test/bus_models`,
  `pbe_v1/tools/sigrok_verify.py`, `pbe_v1/test/test_sigrok_extract.py` and `pbe_v1/verification`
  (D51-D54). The owner asked for one place. (Numbered D56 when it was made; renumbered D63
  when round 2's D55-D61 were merged, D64.)
- **Why:** one place to look for the independent checks, separate from the design's own
  testbenches in `pbe_v1/test`. A reviewer can see which checks come from us and which come
  from references we did not write. The make targets stay in `pbe_v1/Makefile` (`GM` points at the
  directory), so the commands in the reports are unchanged.
- **Alternatives:** `pbe_v1/verify/`: everything verification-related would stay under the
  design's home, but the independent checks would be harder to find. Leaving the files where they
  were: no move, but no clear split between our tests and the independent ones.
- Recorded evidence (`evidence/`, `bus_models/results.json`) keeps the commands as they were run,
  with the old paths: it is a dated record, not instructions.
- **Extended by D82:** the model and the differential now simulate the SRAM program memory:
  IHP's behavioural model in the RTL run, per-engine 256-word programs, `PM_ADDR_H` and the
  SRAM's second refetch in the model (`sram=True`, the default).
- **Extended by D64:** round 2's verification (D55-D61: formal, reference vectors, coverage,
  stress, mutation testing and the specification-boundary checks) arrived after this move, still
  under `pbe_v1/`. It now lives beside `verify/golden-model/` under `verify/`; D64 has the layout.

## D64. Round 2's verification lives under `verify/`, beside the golden model

- **Chosen:** when `verify/round2` was merged, its new verification was moved out of `pbe_v1`,
  following D63:

  | Before (round 2) | Now |
  |---|---|
  | `pbe_v1/formal/` | `verify/formal/` |
  | `pbe_v1/coverage/` | `verify/coverage/` |
  | `pbe_v1/test/reference_crc/` | `verify/vectors/crc/` |
  | `pbe_v1/test/reference_protocols/` | `verify/vectors/protocols/` |
  | `pbe_v1/test/stress/` | `verify/stress/` |
  | `pbe_v1/tools/mutate.py` | `verify/mutation/mutate.py` |
  | `pbe_v1/tools/check_spec_boundaries.py`, `pbe_v1/test/tb_spec_boundaries.sv` | `verify/spec_boundaries/` |
  | `pbe_v1/tools/usb_decoder_repro.py` | `verify/golden-model/sigrok/` (it serves the sigrok checks) |
  | `pbe_v1/verification/ROUND2_*.md`, `COVERAGE.md`, `evidence/round2/` | `verify/golden-model/` |

  Every make target stays in `pbe_v1/Makefile` and points into `../verify` (`V`, like `GM`), so
  `make formal`, `make coverage`, `make stress`, `make mutate`, `make test-crc-vectors` and
  `make test-protocol-vectors` are run as before. Generated files (solver runs, coverage data,
  scratch copies) still go to the ignored `pbe_v1/build/`.
- **Round 2's reports sit next to `REPORT.md`, not in a `verify/round2/`:** `REPORT.md` is one
  report for both rounds (round 2 appended its sections to it), its links to the `ROUND2_*.md`
  files are relative, and `evidence/` is one dated tree (`phase1`-`phase3`, `round2`). Splitting
  them would break those links for no gain.
- **What stays in `pbe_v1/`:** `tb_fifo_robustness.sv` and `tb_engine_known_reset.sv` are plain
  unit benches of the design's blocks, run by `make test` like `tb_engine_ops.sv`; the FIFO one
  is the regression for a mutation the old benches missed (BUG-061). The design tools
  (`pbe_asm.py`) stay too. `tb_spec_boundaries.sv` moved, because it exists only to keep
  counterexamples to the old, stronger specification text (BUG-058/059) and is driven only by
  `check_spec_boundaries.py`.
- **Alternatives:** everything under `verify/golden-model/` (one directory, but formal and
  coverage are not part of the golden model and would bury it); leaving round 2 in `pbe_v1/`
  (no move, but D63's split between our design and the independent checks would be undone).
- **Paths fixed:** the scripts' `Path(...).parents[N]` roots, the `.sby` `[files]` sections
  (`../../pbe_v1/build/formal/generated/...`), the mutation scratch copy (which now copies
  `pbe_v1`, `src`, `macros` and `verify`, BUG-076), the stress bench's import of the bus models
  (BUG-075), and the commands and links in the reports and READMEs. Recorded evidence keeps the
  commands and paths it was run with (D63). `docs/BUG_LOG.md` entries keep the paths in force
  when each bug was found; this table maps them.
- **Numbering:** main and round 2 both used D55-D56 and BUG-058. Round 2's numbers are kept
  (its evidence cites them); main's were renumbered: SRAM proposal D55 → D62, directory move
  D56 → D63, SRAM refetch bug BUG-058 → BUG-074.

## D65. LINE2: a second line-coder register for timing, pins and bus access

- **Problem:** the competition brief names CAN. The line coder (D39) could not do it: it
  samples at a fixed 50 %, resynchronizes on every edge, drives and reads the same pin, and
  starts a frame whenever data is queued.
- **Chosen:** a per-engine register `LINE2` at second-page offset +4 (0x34 / 0x44), reset 0, read
  back. Every bit at 0 is the old behaviour, so no existing program or test changes:
  - `[2:0]` sample point: 0 the old `floor(period_m1/2)+1`; 1, 2, 3 add `N/8`, `N/4`, `3N/8`
    (`N = period_m1 + 1`): 62.5 / 75 / 87.5 % when `N` is a multiple of 8. Shifted copies of
    the period and one adder, no multiplier. 4–7 reserved (act as 0).
  - `[3]` resynchronize on falling edges only.
  - `[4]` receive on `pin_base + 1` (separate TXD/RXD for a transceiver; pair mode must be off).
  - `[5]` bit-synchronous mode (D66).
  - `[6]` before a frame starts, wait until the line has been idle for 11 bit times, or 3 after a
    received frame end (counted at the sample point).
- **Who else benefits:** the sample point and falling-edge-only resync help any NRZ receiver
  with a slow or asymmetric edge (LIN, RS-485 with long stubs, J1708); split pins help every
  protocol behind a transceiver (LIN, RS-485 half duplex, J1708, CAN); the idle wait is J1708's
  and Modbus RTU's "bus quiet before transmit" (D47's 3.5-character rule is still the program's).
- **Alternatives:** more bits in `LINE` (it has two reserved bits, not seven); a sample point as
  a full 16-bit count (one more register pair; four fixed points cover CAN's usual 75–87.5 %).
- **Registered sample point:** the non-default sample points come from a register updated
  every clock from CLKDIV and LINE2 (one clock late after a change), so the adders are not on
  the counter's compare path; the default keeps its old combinational value, cycle for cycle.
- **Verified:** `tb_line` D1–D3 (sample points, edge selection, idle wait), `tb_engine_ops`
  (split pins), `tb_engine_known_reset` (all `LINE2` bits are four-state known after reset).

## D66. Bit-synchronous (CAN) mode: one bit timer, readback, arbitration, the frame tail

- **Problem:** CAN is not "send a frame, then receive one". Every node, the transmitter
  included, reads every bit at the sample point and compares it with what it drove (bitwise
  arbitration, bit errors, ACK); stuffing follows the bus; a node that loses arbitration must
  become a receiver within the same bit. `pbe_line` has separate TX and RX timers, a 2-bit gap
  and sync byte before every frame, and suppresses RX while it transmits.
- **Chosen:** a new module `pbe_bsync`, selected by `LINE2[5]` instead of `pbe_line` (the
  engine muxes their outputs; `pbe_line` is held clear). One timer: hard sync on the
  start-of-frame edge, resync on falling edges, but not while this node drives dominant (its own
  edge, delayed by the transceiver, ISO 11898-1 §11.3.2). Each bit start drives the next bit of
  the current unit, the queued unit's first bit, or recessive if nothing is queued; each sample
  point removes stuff bits, checks them, delivers the bit, feeds the CRC and compares it with the
  driven level. A receiver therefore needs no OUT at all, and a transmitter that loses
  arbitration just keeps receiving.
  - **Units:** OUT and IN move units of 1–8 bits (`LINECTL`, D67): OUT takes the top bits of
    OSR, IN gives them right-justified. A frame starts in units of 8 (`LINE[5]`) or 1. This lets a
    program split the CAN header into fields the host and the program can use directly (`DLC`
    lands in ISR alone).
  - **CRC from the line:** the coder feeds the CRC with every bit of the stuffed region as it is
    sampled, so the CRC is current at every sample point (a byte-mode IN would feed it 8 clocks
    late, too late at 500 kbit/s to send the CRC on time). Feeding the received CRC field too
    leaves the register at 0 for a good frame for transmitter and receiver alike, and shifts the
    CRC left as it is sent, so `OSRCRC HI, LEFT` gives the next 8 CRC bits each time (D71).
  - **The tail in hardware:** "stuffing off" ends the stuffed region (after a stuff bit already
    due); the coder then runs CRC delimiter, ACK slot, ACK delimiter and EOF by itself, drives the
    ACK if it did not transmit and `crc_ok`, and checks ACK, form and CRC errors.
  - **Line-event vector:** in this mode an IN/OUT issued after a frame end or error jumps to
    `TIMEOUT_PC` (consuming the event, dropping the queued unit) instead of completing, so a
    program needs no `JLINE` after every IN; the 64-word `can_node` fits only this way.
  - **Stopped engine:** unlike `pbe_line`, which keeps running while its engine is stopped,
    `pbe_bsync` is held clear while `run = 0` (counters kept). A CAN coder without a running
    program would still acknowledge frames (with a CRC nobody resets) and send error flags; it
    did, in `tb_can` (BUG-083).
  - **Join:** a foreign SOF while a unit is queued (or queued before the SOF sample point) is
    joined if this node may start, else the unit goes out silently and "arbitration lost" is set.
- **Alternatives:**
  - *Extend `pbe_line`:* its TX and RX paths are independent state machines with a different
    frame model (gap, sync, SE0); merging the shared timer, readback and tail into it would make
    every existing mode depend on CAN logic. A separate module keeps the default path untouched
    (the default-config formal and the old tests are the proof) at the cost of a second timer.
  - *Tail in the program:* about 15 more words (bit loop, role branch, ACK branch, form checks)
    and a 6-clock deadline after each tail bit at 1 Mbit/s; the 64-word program does not fit.
  - *CRC fed by IN (as in byte mode):* 8 clocks late per byte; see above.
- **Who else benefits:** units of 1–8 bits suit any protocol with odd field widths (SENT's 4-bit
  nibbles, 9-bit or 7-bit words, I2C's 7-bit address); readback with arbitration is what
  single-wire CAN, J1850 VPW/PWM, LIN (whose nodes must compare every bit they send with the
  bus) and the I2C multi-controller case need; split pins and the
  idle wait are D65. The tail, ACK and error rules are CAN-only, gated by `LINE2[5]`.
- **Verified:** `tb_line` E1–E6, `tb_engine_ops` (second engine), `tb_can` (D72).
- **Cost (`make synth`, IHP typical, hierarchical breakdown):** the whole CAN change is
  337,253 → 384,756 µm² (+47.5k, +14.1 %), 13,694 → 17,358 cells (step 3); with the frame
  follower (D74) 390,814 µm² (+53.6k, +15.9 %), 17,524 cells. `pbe_bsync` is 20.1k µm²
  per engine (40.3k of the 47.5k). Measured by synthesizing copies with parts removed:
  - general (≈ 14.2k per engine): the shared bit timer, sample point, readback,
    arbitration, units, stuffing, the line-fed CRC, the line-event vector;
  - CAN-only (≈ 5.9k per engine, ≈ 11.9k for both, about 3 % of the chip): error
    confinement ≈ 3.9k (TEC, REC, bus-off recovery, passive) and the frame tail with error
    flags ≈ 2.0k (D68);
  - the rest (≈ 7.2k): LINE2 in `pbe_line`, `LINECTL`/vector decode, FIFO mark/rewind,
    the new registers and readback.
  **Options evaluated and rejected (owner's decision):**
  - *CAN on engine 0 only* (a parameter leaving `pbe_bsync` out of engine 1): saves about
    20k µm² (about 5 %), but the chip could then run only one CAN node. Both engines keep it,
    so the chip can be two CAN nodes, for example a bridge or gateway between two buses
    (`tb_can` scenario 6 runs the two engines as two nodes).
  - *One bit timer shared by `pbe_line` and `pbe_bsync`* (never both active): roughly 1-2k
    per engine, but it ties the new mode into the old one's timing, which D66 keeps separate.
- **Timing (`make timing`, logic only, IHP slow):** 3.39 ns before CAN; 5.00 ns after step 1
  (worst path from `clkdiv` through the sample-point adders to the counter compare); the
  sample counts are now registered (D65, BUG-088): 3.69 ns, worst path back to the original
  class (`instr_q[10]` → a multiplexer, +0.30 ns from the new decode terms); with the frame
  follower 3.64 ns (from `clkdiv[1]`, the bit timer's end-of-bit compare).

## D67. LINECTL: EXT sub-op 7 split by param[5] — **Changed (PAGE implemented, D83)**

**Changed (D83):** param[5] = 1 is now `PAGE p` (p = param[1:0]); it no longer executes as nothing.

- **Chosen:** `EXT` sub-op 7 with param[5] = 0 is `LINECTL`, the bit-synchronous coder's
  controls; param[5] = 1 stays reserved for D62's proposed `PAGE` and executes as nothing.
  - param[4] = 0: unit width = param[2:0] + 1, arbitration window = param[3] (written together:
    in CAN the window always ends at a unit boundary, after RTR).
  - param[4] = 1: [0] stuffing off, [1] stuffing on, [2] error now (an error flag from the next
    bit start, counted like any error).
  - Without bit-synchronous mode `LINECTL` does nothing.
- **Why split, not take the whole sub-op:** it is the last free sub-op and D62 needs it for
  `PAGE`; `PAGE p` needs few bits (5 bits give 32 pages of 64 words).
- **Alternatives:** an `OUT` variant (`PIN` act 7 is `END`; no act code free); a host register
  (too slow: these change several times per frame); separate width and flag instructions (more
  program words).
- **Assembler:** `LINECTL W1..W8 [, ARB]`, `LINECTL STUFFOFF|STUFFON|ERROR [, ...]`.

## D68. CAN error flags and error confinement in hardware

- **Error flags (owner's choice):** on a stuff, bit, form, ACK or CRC error (or `LINECTL ERROR`)
  the coder pulses its error and frame-end outputs, drops the queued unit, and from the next bit
  sends 6 dominant bits (error-active) or 6 recessive bits that end after 6 equal bits on the
  bus (error-passive), then the delimiter (wait for recessive, then 8 recessive bits). A CRC error
  starts after the ACK delimiter (ISO 11898-1), an ACK error in the ACK delimiter.
- **Error confinement — chosen: counters in hardware** (`TEC` 9 bits, `REC` 8 bits, a 7-bit
  recovery counter), with the ISO rules: transmitter +8 (except an error-passive transmitter's
  ACK error with no dominant bit in its passive flag), receiver +1, +8 for a receiver that reads
  dominant right after its flag, +8 for a bit error in its own active flag, +8 after 14 dominant
  bits following an active flag (8 after a passive one) and each 8 more, −1 on success (REC above
  127 becomes 119). Error-passive at ≥ 128; bus-off at TEC > 255 (silent, no flags, no ACK) until
  128 runs of 11 recessive bits, then both counters 0. An error-passive transmitter waits 8 more
  bits (suspend transmission) before its next start. Host read: second page +5/+6/+7.
- **Alternatives considered:**
  1. *Counters in the program:* the engine has one 8-bit counter (X) that only decrements; +8,
     −1 and the comparisons do not fit in the 64 words left by the frame code.
  2. *Counters in the host, with a hardware "passive" bit and "bus-off" stop:* the flag type
     must change at the very next error after the counter crosses 128, and the node must stop at
     the error that takes TEC past 255. Two errors can be one error frame apart (about 25 bit
     times, 50 µs at 500 kbit/s); a host on SPI that is slower than that sends the wrong flag or
     keeps transmitting while bus-off. Exact timing cannot be guaranteed, which the owner ruled out
     ("the protocol should behave correctly").
  3. *Hardware counters (chosen):* about 30 flip-flops and the adders, CAN-only logic against
     CLAUDE.md's "general" rule. Justified because the alternatives are either impossible (1) or
     not exact (2), the logic is gated by `LINE2[5]`, and a CAN node that cannot leave the bus is
     a hazard to every other node on it.
- **Choices inside the rules:** the flag type is the state in which the error was detected
  (ISO 11898-1 counts "when a transmitter sends an error flag", so the error that takes TEC to
  128 still sends an active flag; the next one a passive flag); the counters are updated at
  once; the node goes bus-off at once when TEC passes 255 (its flag would have been passive,
  so recessive, anyway); REC saturates at 255; success after the last
  EOF bit for receivers too (ISO: after the ACK slot; the net count is the same unless an error
  hits EOF); the counters survive an engine restart (only reset or recovery clears them).
- **Verified:** `tb_line` E3–E5 (flag in the next bit, TEC/REC), `tb_can` (D72: passive and
  bus-off transitions against a reference node).

## D69. Deviations from ISO 11898-1 (classic CAN)

Known and accepted; each is a choice to keep the hardware small or the program within 64 words.
- No overload frames: a dominant bit in the intermission is taken as a start of frame, and a
  receiver ignores a dominant last EOF bit (ISO: an overload frame). Overload frames are
  obsolete in practice (no current controller sends them for internal reasons).
- Synchronization jump width is unlimited: an allowed falling edge restarts the bit timer
  (ISO limits a resync to SJW). Robust against clock error, less so against glitches inside a
  bit; the sample point is still where the program sets it. As ISO requires, there is at most
  one synchronization between two sample points (added after the formal check F2 found that
  edges every two clocks could postpone the next bit, and so an error flag, forever: BUG-089).
- A stuff error on a recessive stuff bit sent during arbitration counts like any transmitter
  error (ISO exception 3b: no TEC increase).
- Bus-off recovery starts by itself (ISO 11898-1:2015 lets the host request it).
- `can_node.pbe` (D72) sends standard (11-bit) frames only: it is CAN 2.0B passive. **Changed
  (D74, review of the CAN work):** this entry used to say that an extended frame, or a standard
  frame with r0 recessive, was read as a frame without data, so the node flagged errors on it;
  on a mixed bus that destroys valid CAN 2.0B traffic. The coder's frame follower now walks
  such frames, checks them and ACKs valid ones; the host gets a short record (base ID, the IDE
  or r0 bit, status) but not the 18 extended ID bits or the data. DLC 9–15 are handled (8 bytes).
- The "arbitration window" covers RTR, IDE, r0 and DLC3 (the program's unit boundary): a
  mismatch there counts as lost arbitration, not a bit error. With unique IDs (which CAN
  requires) the two can only differ at IDE.

## D70. TX FIFO mark/rewind and PULL NOWAIT, for retransmission

- **Problem:** CAN retransmits a frame after an error or lost arbitration, but `PULL` consumes
  the TX FIFO: the frame is gone after the first attempt.
- **Chosen:** `PULL`'s free bits [7:6]: `MARK` holds the TX FIFO read position, `REWIND` reads
  again from it, `PULL NOWAIT` gives 0xFF instead of waiting when the FIFO is empty (a receiver
  runs the transmitter's loop without data). While a mark is held the FIFO's `full` counts from
  the mark, so the host cannot overwrite bytes a rewind still needs; without a mark `full`,
  `empty` and `count` are exactly as before (the FIFO formal and robustness bench).
- **Who else benefits:** any protocol that retransmits on its own: a USB device resending IN
  data after a lost ACK (D49 left that to the host), Modbus or LIN retries, HDLC.
- **Alternatives:** the host re-queues the frame (slow: the bus is idle meanwhile and the node
  misses the arbitration right after the error frame); a copy of the frame in program memory
  (no instructions read data memory).

## D71. STAT/STATUS bits, OSRCRC LEFT

- `STAT` and the host `STATUS` register (+F) gain [5] arbitration lost, [6] bit error and [7]
  frame sent (the frame this node transmitted ended without error); the existing positions are
  unchanged. Host clears are `STATUS` write bits [4], [5], [6]. `CRCRST` clears them with the
  line error (they describe one packet, D48).
- `OSRCRC` param[2] (`LEFT`) left-justifies the CRC to 16 bits before taking a byte: CRC-15's
  high byte is bits 14..7. Existing param bits unchanged. With the line-fed CRC (D66), `OSRCRC HI,
  LEFT` before each CRC unit gives the next bits to send.
- JCRCBAD: see D48 (extended).

## D72. can_node.pbe: a CAN 2.0A node in 61 words, and its host protocol

- **Chosen:** one loop for transmitter and receiver (D66): a receiver never needs to OUT, and
  its OUTs (from `PULL NOWAIT`, 0xFF when nothing is queued) are ignored while it is silent; a
  transmitter that loses arbitration keeps receiving the winner's frame. The coder starts the
  node's frame when the bus is idle (or joins a start of frame that comes first), so the
  program only queues the first unit. The header is split into units the receiver can use
  directly: {SOF, ID[10:4]} (8), ID[3:0] (4), {RTR, IDE, r0, DLC3} (4, the last unit of the
  arbitration window), DLC[2:0] (3); then 8-bit data units and 8 + 7 CRC bits (`OSRCRC HI,
  LEFT` before each, D71). `LINECTL STUFFOFF` hands the tail to the coder; the next `IN` waits
  for the frame end or an error, which vector to `done` (TIMEOUT_PC = 45).
- **Host protocol** (in the program's header): the frame in the TX FIFO in wire-order units,
  then FLAG0; the engine retransmits (`REWIND`) until the frame goes out, then clears FLAG0.
  Every frame on the bus gives an RX record `[ID[10:4]] [ID[3:0]] [RTR,IDE,r0,DLC3] [DLC[2:0]]
  [data] [status]` and an IRQ. The host reads the RX_COUNT of each engine that raised the IRQ
  first (within about 16 bit times: intermission, start of frame and the first unit), then
  exactly that many bytes.
- **Size:** 61 of 64 words (`MARK`/`REWIND`, the line-event vector and the hardware tail are
  what make it fit). Success is "status 0x82 or 0x8A" (sent and CRC ok, with or without the
  host's sticky RX-overflow bit): a plain 0x82 compare would resend a frame that went out
  whenever the host had let the RX FIFO overflow (BUG-085).
- **Timing:** the program must queue the next unit between the last sample of a unit and the
  start of the next (at most 8 clocks of instructions after the sample, the DLC to data path).
  125k, 250k, 500k pass at 75 % and 87.5 % sample points (`tb_can +SP=3`); **1 Mbit/s (48 clocks per bit) passes
  at 75 %** (12 clocks left after the sample) but not at 87.5 % (6 clocks: measured, the first frame never goes out): use LINE2 = 0xF2 (with the frame follower, D74).
- **Rejected:** a separate receive loop and transmit loop (the loser of arbitration must
  switch mid-frame; two copies do not fit); the frame tail in the program (D66); host-side
  retransmission (D70).
- **Verified:** `tb_can` (D72 scenarios below), 7 scenarios, all passing:
  DLC 0-8 and remote frames both ways at 125k/250k/500k/1M with two reference nodes at ±0.5 %
  clock error and 200 ns loop delay; arbitration (the loser receives the winner's frame, then
  sends); ACK missing (TEC to 128, held by the passive ACK-error rule, then 127 on success);
  injected CRC, stuff and form errors (CRC error flag in EOF bit 1 to within a quarter bit);
  a bit error (TEC 8 → 7); error-passive at 128 (flags 1–16 active, 17+ passive) and bus-off at
  256 with recovery after 1410 bit times (≥ 128 × 11); both engines as two nodes.

## D73. Independent checks of CAN mode

- **sigrok** (`make sigrok-can`, `verify/golden-model/sigrok/can_verify.py`): the stock `can`
  decoder (libsigrokdecode 0.5.3) decodes `tb_can`'s bus at 125k, 250k, 500k and 1M. Every
  frame's ID, RTR, DLC and data match the bench's list, its CRC-15 matches one computed in
  Python, every frame is ACKed and the decoder reports no rule violation. Each frame is decoded
  on its own (the capture is cut at bus-idle gaps). **Known decoder limitation, kept as an
  exact exception:** the decoder ends the data field at `dlc2len(DLC)` bytes even for a remote
  frame (`decoders/can/pd.py`), so a remote frame with DLC > 0 is checked only up to its DLC.
- **Golden model** (`make diff-can`, `verify/golden-model/model/can_model.py` and
  `test_bsync_cocotb.py`): a CAN bit-stream model written from ISO 11898-1 and the pbe_bsync
  header, and a seeded random differential of `pbe_bsync` alone on a wired-AND bus (receive,
  transmit and stuff-error trials with random bit time, sample point, ±0.8 % clock error, frame
  and unit widths). A copy with stuffing after 6 bits fails it at the first trial. `make test`
  runs 3 trials of each kind; the full run is 40 of each. The existing whole-chip random
  differential (`make diff`) stays as it was: it generates no CAN configurations, so it checks
  that the default configuration is unchanged.
- **Formal** (`verify/formal`): block `bsync` (BMC depth 70, 4 clocks per bit, free bus and
  program inputs): F1 no drive after arbitration loss in that frame, F2 the error flag (or
  bus-off) starts within one bit of an error detected at a sample point and within two of
  `LINECTL ERROR`, F3 an active flag drives for its whole length; covers reach an arbitration
  loss and an active flag. Block `default`: bounded equivalence (BMC: 18 clocks for the line
  coder, 8 for the engine, the depths the solver completes) of `pbe_line` (LINE2 = 0) and
  `pbe_engine` (LINE2 = 0, the new encodings unused) with the pre-CAN sources of main
  (797314f), so "default configuration = today's behaviour" is checked from any inputs, not only
  by the old tests. FIFO: the old proof with mark/rewind held at 0, plus the `mark` proof (D70).
- **Vectors:** CRC-15/CAN (check 0x059E for "123456789") was already a row of the RevEng
  catalogue test (`make test-crc-vectors`); `tb_engine_ops` checks the same value through the
  engine in CAN mode (line-fed CRC, `OSRCRC LEFT` = 0x0B3C).
- **Coverage bins** (`verify/coverage/prepare.py`): new engine bins (the four PULL-group kinds,
  both LINECTL forms, the line-event vector, status bits 5-7 set and clear) and `pbe_bsync` bins
  (every state, own/foreign/late-join starts, arbitration lost, bit error, sent, detected error,
  active and passive flags, stuff slots, ACK given, units of 1/3/4/7/8 bits, bus-off recovery);
  `tb_can` joins the campaign. **Not rerun here:** the campaign needs the OSS CAD Suite's
  Verilator (5.05x; the recorded 92/92 used 5.051). This environment has Ubuntu's 5.020 (no
  `--compiler-include`) and PyPI's 5.38 (no coroutine flags; it also rejects `tb_proto`'s
  `disable`), and building the suite was not permitted.
  - **Rerun (2026-11-06, D80, BUG-102–106):** with the suite's Verilator 5.051, `make coverage`
    first stopped at `tb_line` (a testbench race, BUG-102). After the fix it hit 129/130 bins;
    `bsync_late_join` was closed by `tb_line` E2b (BUG-105), giving **130/130**. Line 265/269,
    branch 482/510, expression 852/908, toggle 4,450/5,394. `tb_debug` joined the campaign
    (BUG-106). Results are in `verify/golden-model/COVERAGE.md`.

## D74. CAN 2.0B passive: a hardware frame follower for extended frames and r0 recessive

- **Problem (review of the CAN work, BUG-092):** `can_node` walks only standard frames. An
  extended (29-bit, CAN 2.0B) frame, or a standard frame with r0 recessive (receivers must accept
  either level), was read with the wrong field layout, so the node flagged an error on every
  such frame: on a mixed bus (J1939, much automotive traffic) it would destroy other nodes' valid
  frames and raise everyone's error counters. Bosch CAN 2.0 requires a 2.0A node to be at least
  "2.0B passive": it must tolerate extended frames without error frames.
- **Chosen:** `LINE2[7]` (reserved until now) enables a **frame follower** in `pbe_bsync`. It
  counts destuffed bits from SOF. When IDE (bit 13) or, in a standard frame, r0 (bit 14) is
  recessive, the coder takes the frame over: no unit reaches `IN` after the one that holds that
  bit, `LINECTL` is ignored, and from RTR (bit 12, or 32 when extended) and DLC (bits 15–18, or
  35–38) it computes the last CRC bit and ends the stuffed region there. The tail, ACK, CRC
  check and error rules are the usual ones. The program needs no new word: its waiting `IN`
  ends at the frame end through the line-event vector, and the record is
  `[ID[10:4]] [ID[3:0]] [third unit] [status]`.
- **ACK:** a valid extended frame is acknowledged. A 2.0B-passive node may ACK or not; a frame
  whose CRC and form the node has checked is correctly received, and acknowledging it is what
  every other receiver on the bus does. Not acknowledging would also leave a lone extended
  transmitter talking only to 2.0A nodes with ACK errors. A frame with a bad CRC gets the usual
  CRC error flag, as for a standard frame.
- **Alternatives:**
  - *Handle extended frames in the program:* it has 3 free words; walking 18 more ID bits,
    choosing the header layout on IDE (no single-bit test exists: about 9 words with the
    compares) and fixing r0/r1 handling does not fit in 64 words.
  - *Deliver the 29-bit ID too* (full 2.0B reception): needs either the program path above
    or the coder assembling the extra bits into units after the program has stopped, which
    would also need the FIFO protocol to change. Left as a follow-up; the host already knows
    an extended frame passed (IDE in the record).
  - *Ignore the frame without tracking it* (wait for 11 recessive bits): the node would not
    detect errors in it, would not ACK it, and would not see the end of frame for its own next
    transmission at the right time.
- **Cost:** `pbe_bsync` 19,961 → 22,213 µm² (+2,253 per engine, +4.5k for both, about 1.2 % of
  the chip): a 7-bit bit counter, a 7-bit "last CRC bit" register and adder, the DLC and RTR
  capture. CAN-only, behind `LINE2[7]`.
- **Verified:** `tb_can` scenario 7: a reference node sends extended data frames (DLC 0, 3, 8),
  an extended remote frame and a standard frame with r0 recessive while the chip's two engines
  are the only other nodes: every frame is ACKed by the chip (the sender raises no error and
  sends each once), no error frames, TEC and REC stay 0, and each engine records the base ID
  and the IDE/r0 bit. Then a standard frame (engine 0) and an extended frame (reference) with
  the same base ID 0x123 start together: the standard frame wins on SRR/IDE, the extended
  sender receives it and then sends its own, intact (checked by a second reference node).

## D75. jtag.pbe: an IEEE 1149.1 JTAG controller in 42 words, a program only

- **Problem:** the competition brief names JTAG. It is to be a program: no RTL change.
- **Pins:** TCK = pin base, TMS = + 1, TDI = + 2 (outputs), TDO = + 3 (input). The 1149.1 signal
  order, outputs first like `spi_ctrl` (SCLK, MOSI, MISO, CS). Four pins leave the other engine
  four, enough for SWD (D76) at the same time. Board: a pull-up on TDO (the target leaves it
  high-impedance outside Shift-xR), and a pull-down on TCK (a restart releases the engine's pins
  for a few clocks, BUG-095); TMS and TDI usually have pull-ups at the target.
- **Host protocol:** records of 3 TX bytes, `[command] [n - 1] [bits]`, n = 1..8, LSB first:
  0 = clock n cycles with TMS = the bits (state navigation, TDI kept); 1 = shift n bits with
  TMS = 0; 2 = shift n bits, TMS = 1 on the last (exit to Exit1-xR). A shift record returns one
  RX byte with the n TDO bits in its top n bits (RX >> (8 − n)). A scan of any length is a
  sequence of shift records (32 bits: three 1s and a 2). TDI held constant (BYPASS, don't care)
  is just 0xFF or 0x00 as the data. Run-Test/Idle, Pause and every other state are reached with
  TMS records.
- **Why records of up to 8 bits, not a byte count plus a last-byte bit count:** the engine has one
  counter (X); OSR and ISR hold the data. A byte count would need a second counter for the bits
  of each byte. Per-byte records cost the host 2 bytes per 8 bits and the TCK a pause between
  records (TCK may stop low indefinitely, 1149.1 4.1), and allow any length. The command is
  decoded with the `JMP X--` chain (one word per command, as `MOV X, OSR` loads it).
- **TMS = 1 on the last bit:** it must be set before the last rising edge, and `JMP X--` only
  says "zero" after a bit. So command 2 has its own loop over n − 1 bits (entered through a
  `JMP X--` that also decrements X), then the last bit with TMS = 1: 5 words more than sharing
  one loop and a flag, which would take the host's flags.
- **TDO in the top bits:** `IN` (LSB first) shifts into bit 7. Right-justifying would need 8 − n
  more shifts without a TCK edge; the host's shift is free.
- **Timing (1149.1 4.2, 4.5):** TMS and TDI change one tick after the falling edge of TCK; TDO
  is read while TCK is high. One TCK period is 5 ticks (high 2, low 3). A pin reaches the engine
  3 clocks after it changes (two synchronizer stages, then the engine's registered decision):
  the `IN` right after the rising edge at CLKDIV = 0 sees TDO as it was 3 clocks (62.5 ns) after
  the falling edge that launched it, just before the rising edge; at CLKDIV ≥ 2 it sees it at or
  after the rising edge. Both read the bit that is on TDO at that rising edge, since the target
  changes TDO only at falling edges.
  - **Speed:** at CLKDIV = 0 a taken jump's fetch clock (D50) lengthens the low phase:
    6 clocks, **TCK = 8 MHz at 48 MHz, the maximum** (high 41.7 ns, low 83.3 ns, TMS/TDI set up
    20.8 ns before the rising edge). CLKDIV ≥ 1: TCK = 48 MHz / (5 (CLKDIV + 1)), 4.8 MHz at
    CLKDIV = 1, down to 146 Hz at 0xFFFF.
  - **Target delay budget** at CLKDIV = 0: TDO must be valid 62.5 ns after the falling edge,
    minus the board and pad delays. Measured in `tb_debug`: a TAP with TDO 60 ns after the
    edge passes, 66 ns fails. A larger CLKDIV gives more.
- **Limitations:** no TRST* (Test-Logic-Reset by five TMS ones, which 1149.1 allows); no RTCK
  (adaptive clocking): TCK is set by CLKDIV only; the host's TX FIFO feeds 16 bytes, 5 records,
  so long scans run at the host's rate with TCK pauses between records; a TMS record returns no
  TDO.
- **Rejected:** a TMS byte and a TDI byte per bit group (TMS and TDI both from data): two shift
  registers would be needed, the engine has one output shift register (OSR); a flag to share
  the shift loop between commands 1 and 2 (uses a host-visible flag for 5 words the window does
  not need: the program is 42 of 64 words).
- **Verified:** `tb_debug` (D77) against `jtag_tap.sv`, a TAP written from 1149.1 (the 16-state
  controller, 4-bit IR capturing 0001, IDCODE selected by Test-Logic-Reset, BYPASS for unused
  opcodes, a 32-bit USER register; TDO changes at falling edges, 50 ns late): reset and IDCODE,
  IR = BYPASS with the 1-bit delay, 32-bit USER write and read-back, 1- and 7-bit scans, a chain
  of two TAPs (both IDCODEs in one 64-bit scan, an 8-bit IR scan, a 33-bit DR through one TAP's
  BYPASS); at CLKDIV = 0 alone and with SWD on the other engine, and the IDCODE read at
  CLKDIV = 0xFFFF. TMS and TDI never change while TCK is high.

## D76. swd.pbe: an ARM ADIv5 SWD host in 64 words, a program only

- **Problem:** the brief names SWD (ARM Serial Wire Debug, the SW-DP of ADIv5). A program only.
- **Pins:** SWCLK = pin base (output), SWDIO = + 1 (driven, released with `PIN REL` for the
  turnarounds and the target's bits). Board: a pull-up on SWDIO (ADIv5 B4.1.1; 10–100 kΩ), so a
  released line reads 1, and a pull-down on SWCLK (a restart releases the pins, BUG-095).
- **Host protocol:**
  - `[0x00] [b]`: 8 cycles with SWDIO = b (LSB first). Line reset = seven 0xFF (56 ones) and
    0x00 (idle); the JTAG-to-SWD switch = line reset, 0x9E, 0xE7 (0xE79E LSB first), line reset,
    0x00 (B5.2.1). Also any other host-driven bit sequence, e.g. DPv2's TARGETSEL write (whose
    ACK the target does not drive).
  - `[0x01] [req]` read; `[0x02] [req] [d0..d3] [p]` write. `req` is the 8-bit request (Start,
    APnDP, RnW, A[2], A[3], Parity, Stop, Park; 0xA5 reads DPIDR); `p` bit 0 is the data parity,
    bits 1–7 are 0 and go out as 7 idle cycles.
  - RX: `[ack]` (ACK bits 0..2 in bits 5..7: OK 0x20, WAIT 0x40, FAULT 0x80, no response 0xE0),
    and for an OK read `[d0..d3] [status]`, status bit 0 = parity error.
  - WAIT and FAULT: turnaround and no data phase (B4.2.3, CTRL/STAT.ORUNDETECT = 0); a write's 5
    data bytes are taken from the TX FIFO and dropped. The host retries after WAIT, and after
    FAULT reads CTRL/STAT and writes ABORT.
- **Parity:** a read's parity is checked by the engine: the receive parity counts every `IN`
  since `STAT`, across the 4 bytes, and `STAT` after the parity bit gives the error. The send
  parity (`OUTPAR`) counts `OUT` bits since the last OSR load, so it covers one byte: a 32-bit
  word is four `PULL`s. The host therefore computes the write parity (and the request's parity,
  in the request byte it sends). Rejected: *reading SWDIO back while driving it* (the receive
  parity would then cover the written bits, and `STAT` + `MOV OSR, ISR` + `OUT` would send it):
  it needs ISR, which is the write's byte counter (below); *the request built by the program*
  (Start, `OUT` × 4, `OUTPAR`, Stop, Park as separate pin actions): 12 more words than sending
  the host's byte, and the window has none.
- **Counters:** X counts bits. Bytes are counted without a second counter:
  - the request loop stops when OSR = ISR = 0 (Park, bit 7, is always 1, so OSR is 0 exactly
    after 8 bits), which keeps X free to hold read (0) or write (1) through the request;
  - a read's 4 data bytes: OSR = 0x0F, shifted by `PIN dio, OUTOD` (its bit is a 1, so SWDIO
    stays released) after each `PUSH`, until OSR equals ISR (0 after the `PUSH`);
  - raw and write bytes: ISR shifted by `IN clk` (SWCLK is low: a 0 comes in) after each byte,
    until ISR equals OSR (0 after 8 bits). A raw record starts with ISR = 0 (1 byte); a write
    starts with ISR = 0x20 (the OK ACK, copied from OSR) and enters at the shift: 5 bytes.
  - Rejected: two flags as a 2-bit byte counter (9 words, and host-visible); unrolling the
    bytes (24 or more words).
- **ACK:** three `IN`s put ACK[0..2] in ISR bits 5..7; `JNE` against 0x20 picks the path. The ACK
  is the first RX byte of every transaction, so the host knows how many follow.
- **Timing (B4.1, B4.2):** the host changes SWDIO one tick after the falling edge; the target
  samples it at the rising edge, drives its bits after the rising edge, and the host reads them
  while SWCLK is low. With the 3-clock pin latency (D75) every `IN` of a target bit is placed so
  that it sees SWDIO after the falling edge, where sigrok's decoder samples too: a target bit is
  read 62.5 ns after the rising edge that launched it at CLKDIV = 0 (measured: a target driving
  60 ns late passes, 66 ns fails). The ACK cycles' low phase has an extra tick for this
  (BUG-096), and the Park and the read turnaround cycles one more each, so every cycle at
  CLKDIV = 0 is 6 clocks: **SWCLK = 8 MHz at 48 MHz, the maximum** (high 41.7 ns, low 83.3 ns).
  CLKDIV ≥ 1: 48 MHz / (5 (CLKDIV + 1)) in the loops, 146 Hz at 0xFFFF. SWCLK stops low between
  records. Turnaround is 1 cycle (DLCR.TURNROUND = 0, the reset value).
- **Size:** 64 of 64 words; with `jtag.pbe` (42) both fit the 128-word memory and run at once.
  Not supported for lack of words: overrun detection (ORUNDETECT = 1 needs the data phase after
  WAIT/FAULT), turnaround > 1 cycle, the program computing parities.
- **If more were needed:** a "keep the send parity" variant of `PULL` (the parity not reset by
  an OSR load) would let `OUTPAR` send the parity of a word of any length; it would also serve
  multi-byte parities elsewhere. Not made: the program meets the protocol without it.
- **Verified:** `tb_debug` (D77) against `swd_dp.sv`, an SW-DP written from ADIv5.2 (SWJ-DP
  switch, watched in both modes, line reset and the DPIDR-first rule, request parity/Stop/Park checking with lockout,
  CTRL/STAT, SELECT, RDBUFF, ABORT, sticky errors and FAULT, WDATAERR on a write parity error,
  posted AP reads, a MEM-AP-like AP with CSW, TAR, DRW and IDR, configurable WAIT, FAULT and
  read parity errors; SWDIO driven 50 ns after the edge): switch + line reset + DPIDR; DP and AP
  writes and reads, AP read through RDBUFF; WAIT twice then OK (read), WAIT then OK (write, its
  data dropped); FAULT, sticky, cleared by ABORT; a target parity error reported; a host parity
  error rejected (WDATAERR, FAULT, ABORT); a line reset and DPIDR. At CLKDIV = 0 alone and with
  JTAG on the other engine, and a DPIDR read at CLKDIV = 0xFFFF. The host and the target never
  drive SWDIO together, and the host never changes it while SWCLK is high.

## D77. Independent checks of JTAG and SWD

- **Target models from the standards** (`pbe_v1/test/jtag_tap.sv`, `swd_dp.sv`), written before
  the programs were run against them and not from the programs. `tb_debug` runs four phases:
  JTAG alone, SWD alone, both at once (JTAG on engine 0, SWD on engine 1, two host processes
  sharing the host port), all at CLKDIV = 0 (the fastest); then both at once at CLKDIV = 0xFFFF
  (the slowest: an IDCODE and a DPIDR read, about 45 cycles each, are 15 million clocks; the
  full scenario sets would take hours of simulation). It measures every TCK and SWCLK phase.
- **sigrok** (`make sigrok-debug`, `verify/golden-model/sigrok/debug_verify.py`): the
  concurrent phase's pins decoded by the stock `jtag` and `swd` decoders of libsigrokdecode
  0.5.3, unchanged, on a capture with targets driving 20 ns after their clock edge. JTAG: all 14
  IR/DR scans (1 to 64 bits, one and two TAPs) from the decoder's own TAP state machine equal
  the host's TDI and TDO. SWD: the decoder's 99 annotations equal the expected sequence: the
  switch (LINERESET, JTAG->SWD, LINERESET), 33 transactions (register name, ACK, data)
  including WAIT and FAULT, a final line reset, and its parity-error annotation on exactly the
  two transactions with a deliberate parity error. `jtag_arm` is not used: it decodes ARM's
  JTAG-DP registers, which the TAP model does not have.
- **Expected failure (decoder limitation, BUG-099):** the `swd` decoder samples the target's
  bits at the falling edge of SWCLK. ADIv5 needs them only at the host's sample point, and
  `swd.pbe` reads them 62.5 ns after the rising edge; at 8 MHz the falling edge is at 41.7 ns.
  On a second capture with `make test`'s 50 ns targets the decoder reads every target bit one
  cycle late. The script checks that exact signature (switch and first request right, the first
  ACK `ERROR`) and reports XFAIL; JTAG passes on that capture too (its decoder samples TDO at the
  rising edge).
- **Unchanged:** no RTL change, so the golden model, the random differential, formal, coverage
  and stress need no change; `make test` (with `make diff N=2`) passes; `src/` is untouched.

## D78. Modbus RTU: the idle wait for a start bit is level-based (`WAIT rx, LOW`)

- **Problem (BUG-100, D47's known limit):** while idle, `modbus_rtu.pbe` times out every
  `TIMEOUT` + 3 ticks (1.5 characters) to poll the TX FIFO. After each timeout `tmo` and
  `JMP TX_EMPTY, idle` run before `WAIT rx, FALL` issues again, on the third tick. `WAIT FALL`
  compares this clock's pin with the previous clock's and does not latch edges (the cycle
  contract in `pbe_engine.sv`), so a start edge in those 3 ticks was missed and the next
  falling edge inside the character was taken for the start bit: a lost response. With start
  bits arriving at random phases that is 3 of every 144 ticks, about 2 % of responses.
- **Chosen:** `idle: WAIT rx, LOW [3]` (same word, 62 of 64 words), as `uart_rx.pbe` already waits
  for its start bit.
  - **Normal case unchanged:** while the WAIT is blocked, `LOW` is met on the same clock as
    `FALL` (the first clock the synchronized pin is 0), so a start edge during the WAIT is
    timed exactly as before. Measured: first data bit sampled 1.504 bits after the start edge
    at 19200 and 115200 baud, as before.
  - **In the window:** the WAIT sees the line already low and goes on at once; the start bit is
    timed from the WAIT, not from its edge, so sampling is late by up to 3 ticks (3/8 bit).
    Measured: 1.869 bits (start edge 0.1 tick after the timeout), 1.693 (1.5 ticks), 1.518
    (2.9 ticks).
  - **The other paths need nothing:** after a timeout inside a frame `gap`/`gw` already poll the
    level (`JMP PIN_LO`); `inframe` keeps `WAIT rx, FALL`, since it starts right after the
    parity sample, more than a bit before the next start edge can come; the program reaches
    `idle` after its own request, after 3.5 characters of silence or after an idle timeout,
    with the line idle unless a start bit has just begun. `JMP PIN_HI, idle` still rejects a
    glitch.
- **Sample margin:** a character's sampling is timed from its start; the last sampled bit is
  the parity (or the 2nd stop) bit, bit 9 after the start bit, sampled at 9.5 + L bit times
  with lateness L. It must fall inside the sender's bit 9, from 9/r to 10/r for a sender r
  times faster than the engine:

  | Case | L (measured) | Sender may be faster by | slower by |
  |---|---|---|---|
  | start edge during the WAIT (always before) | 0.004 bit | 5.2 % | 5.3 % |
  | start edge in the window, worst | 0.369 bit | 1.3 % | 8.8 % |

  Only the window case (about 2 % of responses) loses margin, and only toward a fast sender;
  before this change that case lost the frame at any rate. Test 5 runs the worst case with the
  device 1 % fast. The engine's own rate error (the divider rounds to whole clocks: 313 instead
  of 312.5 at 19200 baud, 0.16 %) is included in the measurement.
- **Alternatives:**
  - **Centre the window case (2 words, 64 of 64):** after a timeout, test the line once more
    before the WAIT (`JMP PIN_LO, late` just before `idle`, and `late: JMP idle+1`): a start bit
    seen there is timed from the test, and its lateness becomes −2 to +1 ticks (estimated
    −2.7 % / +3.9 % in the window, normal case unchanged; not simulated). Not taken: it uses the program's last two words for
    the rare case; a later Modbus fix would have no room. It stays the next step if a device
    more than 1.3 % fast must be supported.
  - **`WAIT rx, LOW [2]`:** centres the error over both cases (−1 to +2 ticks), but costs margin
    in the normal case (−4.0 %) to give it to the rare one. Not taken.
  - **An edge latch for `WAIT RISE/FALL` in the engine:** a WAIT would see an edge from before it
    issued. That changes the meaning of every RISE/FALL wait (19 in `i2c_target`, `i2c_watch`,
    `spi_periph` and Modbus's `inframe`, all written against "edges after the WAIT") and
    needs a rule for when the latch is armed and cleared; each program would have to be checked
    again. Not needed: the program fix is enough. No RTL change.
- **Tested (Test 5, `tb_pbe.sv`):** rounds 9–15 start the response 0.1, 1.5 or 2.9 ticks after
  the third idle timeout (3 × (`TIMEOUT` + 3) ticks after the master's driver goes off), at
  19200 and 115200 baud, 8E1 and 8N2, and round 15 at 0.1 tick with the device 1 % fast; every
  byte, the parity status and the CRC must be right. Rounds 0–8 (19200/115200, 8E1/8N2, parity
  error, bad CRC, the 1.5-character gap rule) and the RX overflow test still pass.

## D79. usb_dev.pbe: a token with a line error gets no answer (still 64 words)

- **Problem (BUG-101):** D48's `JCRCBAD` rejects a DATA packet with a line error, but the
  program cleared the line error (`CRCRST` in `dat`) after the token, and IN tokens were never
  checked. A SETUP, OUT or IN token with a wrong stuff bit and intact bytes was answered.
- **Rule:** USB 1.1 §7.1.9: seven 1s in a row are a bit stuffing error and the packet is
  ignored. §8.7.1 (packet error categories): except for SOF, "any packet that is received
  corrupted causes the receiver to ignore it and discard any data or other field information
  that came with the packet"; its table lists bit stuffing among the checks of the PID, the
  address field and the data field. So a corrupted token gets no handshake and no data, and
  the DATA packet of a SETUP or OUT whose token was corrupted is not ACKed.
- **Chosen (program only, no RTL change):**
  - `CRCRST` moved from `dat` to word 2, right after the PID is taken. One `CRCRST` now covers
    the token and, for SETUP and OUT, the DATA packet after it: the token's bytes and the DATA
    PID are taken with `NOCRC`, so the CRC is still at its initial value when the data starts.
    A stuff bit cannot fall inside SYNC and a token PID (their longest run of 1s is 3), so every
    stuff bit of a token comes after the `CRCRST` (the PID is taken after its 8th bit, the
    `CRCRST` runs 2 clocks later, after `JLINE`; the next bit is 32 clocks later).
  - SETUP and OUT: the DATA packet's `JCRCBAD` now also sees a line error in the token: no ACK,
    and the record carries status bit 4, which the firmware already treats as bad.
  - IN: `STAT; SET OSR, 0x10; JEQ idle` first: with a line error the token gets no NAK, STALL
    or data. After `CRCRST` and no CRC feed, `STAT` gives 0x10 for a line error (CRC ok, parity
    and timeout are 0 here); RX overflow (bit 3) is the only other bit that can be set.
    - **Alternative:** `JNE` against 0x00, which also ignores the token when the RX FIFO has
      overflowed: the overflow is sticky until the host clears it, and the device would stop
      answering IN tokens until then. Chosen: compare with 0x10, so a token is judged by itself;
      the cost is a double fault (a line error while an overflow is pending) still answered.
    - **Alternative:** `JCRCBAD` after the token: it always jumps, because the CRC unit does not
      compute CRC5 (the token's CRC5 is checked by the exact compare of byte 3) and the
      register is at its initial value, not `CRC_GOOD`.
  - The host's ACK (0xD2) is now recognised by its end: the `IN` for token byte 2 is released by
    the end of the packet with ISR still holding the PID, and `JLINE hsk` (word 5) goes to the
    0xD2 compare. The compare used to be at words 2–3, before byte 2; `CRCRST` must come before
    byte 2 and the firmware patches words 6 and 9 (D49), which stay where they were.
- **Words (64 → 64):**

  | Change | Words |
  |---|---|
  | the 0xD2 compare at words 2–3 (`SET OSR, 0xD2; JEQ ack`) removed | −2 |
  | `CRCRST` at word 2, `JLINE hsk` at word 5 | +2 |
  | `CRCRST` in `dat` removed | −1 |
  | `CRCRST` in `send` removed (the CRC is still at its initial value from word 2) | −1 |
  | the end of a DATA packet shares the handshakes' `PIN OUT, NOCRC; PIN END; JMP idle` (`sc` ends with `JMP hs`) | −2 |
  | one tail for both records: `deop` pushes the status, raises FLAG2 and IRQ, then `JCRCBAD idle; SET OSR, 0xD2; JMP hs`; the host's ACK enters it from `hsk` (`SET OSR, 0xD2; JNE idle`), where `JCRCBAD` always jumps (its CRC is unfed). Was 11 words, now 12 | +1 |
  | the IN check (`STAT; SET OSR, 0x10; JEQ idle`) | +3 |
  | total | 0 |
- **Timing:** the ACK of a good DATA packet now goes out after the record's `PUSH`, `FLAG 2,
  SET` and `FLAG 2, IRQ` and two jumps, a few clocks later than before. Turnaround
  measured in `tb_usb`: 3.16 to 3.28 bit times (was 3.00 to 3.19); USB allows up to 7.5. The
  host gets FLAG2 and IRQ for a good packet just before its ACK is on the wire instead of just
  after; the firmware handles records at its own pace and does not care.
- **Unchanged for the host:** the records, the status byte, FLAG0–2, and words 6 and 9.
- **Not needed:** the fallback (a known limitation pending the SRAM program memory, D62) or an
  RTL change; it fits.
- **Tested (Test 11, `tb_usb.sv`):** after the bus reset, SET_ADDRESS(0x3F), whose tokens carry
  a stuffed 0 after the address's six 1s. A GET_DESCRIPTOR works there (correct stuff bits); an
  IN token with the stuffed bit sent as a 1 gets no answer; a SETUP and an OUT token sent that
  way, each followed by an intact DATA packet, get no ACK and their records are counted bad; the
  firmware takes no SETUP; GET_DESCRIPTOR still works after them. Every earlier step
  (enumeration, SET_ADDRESS, STALL, NAK, the lost-ACK resend, bus reset, turnaround) passes.

## D80. Testbench timing discipline, and the benches under two simulators

- **Problem (BUG-102):** `tb_line` E4 measured 53 clocks under Icarus and 55 under Verilator
  5.051 (a failure). The RTL behaved identically in both. The testbench wrote and read signals at
  a rising edge from different processes, so the simulator's process order decided what it
  measured. Icarus alone could never show it: one simulator always resolves a race the same way.
- **Rule for every testbench:**
  1. Stimulus threads change DUT inputs, and read DUT state or testbench counters, only after
     a falling edge (`@(negedge clk)`) or after a delay inside the cycle (`#1`). This was already
     the rule for the send tasks (BUG-027). It now also covers reset release, the shared host SPI
     (`tb_host.svh`), polling loops and timestamps.
  2. Monitors run at the rising edge. A cycle counter read by other rising-edge processes is
     updated with a nonblocking assignment (`tb_line`), or every reader is in the counting
     process itself (`tb_can`). A blocking `cyc++` stays correct for readers woken by a DUT
     output change, which comes in the NBA region after it (`tb_fetch`).
  3. A real-valued drive schedule starts at a falling edge and is checked to never land on a
     rising edge (`tb_line`'s `usb_drive`).
  4. Chip pins that are asynchronous by the spec (behind the two-flop synchronizers) may still
     change at rising edges in the protocol models; a check on them must allow for a clock either
     way, as a real chip's must.
- **Check:** `make test-verilator` (in CI, after the Verilator lint): for each bench in
  `VL_BENCHES`, build it with `verilator --binary --timing --assert` and with Icarus. Both must
  pass, and their logs must be identical, apart from the `$finish` line. Benches print what they
  measure (E3–E5 their clocks), so a one-clock difference is a failure even inside a check's
  window. The checks whose measurements are now race-free were made exact (E4: PB + LD + 1).
  - **Benches:** `tb_line`, `tb_engine_restart`, `tb_engine_known_reset`, `tb_fifo_robustness`,
    `tb_fetch`: the ones Ubuntu 24.04's Verilator 5.020 (CI's) runs correctly. Left out:
    `tb_engine_ops`, `tb_proto` and `tb_usb` (5.020 tool bugs, BUG-103), and `tb_pbe`, `tb_can`
    and `tb_debug`, the long chip-level benches (under 5.020 here, `tb_usb` alone took over ten
    minutes). All of them run under Verilator 5.051 in `make coverage` (`tb_debug` since
    BUG-106).
  - **Alternatives:** (a) Icarus only, with the process order perturbed (source order, `#0`):
    tried; Icarus's choice did not move, so it is no check. (b) The whole set under Verilator in
    `make test`: everyone would need Verilator 5.05x, and the CPU time would grow severalfold.
    (c) Only the coverage campaign (5.051): it caught this, but only by luck (55 fell outside
    the window) and only when someone runs the long campaign. Chosen: a short cross-check of the
    unit-level benches on every push, plus the rule above for the rest.
- **Tools here:** Icarus 12.0 and Verilator 5.020 from Ubuntu 24.04's archive; Yosys 0.33;
  Verilator 5.051 from the OSS CAD Suite 2026-07-27 (on PATH only for `make coverage` and the
  5.051 checks). Under 5.051 the old `tb_line` failed only in the instrumented coverage build
  (55), not in a plain build. Instrumentation alone changed the outcome, which is why the check
  compares two simulators instead of trusting one.

## D81. The sample count register's first clock: a valid flag

- **Problem (BUG-104):** `pbe_bsync`'s `spv` and `pbe_line`'s `sp_q` (BUG-088's registered
  sample counts) reset to 0, so on the first clock after reset they matched the bit counter
  (also 0), and the coder sampled at once instead of at the sample point.
- **Chosen:** a one-bit flag per register, reset 0 and then 1, that gates `sample` (`spv_ok`,
  `sp_ok`). The first sample after reset is then at the sample point, as after a `clear`.
- **Alternatives:**
  - *Reset the register to all ones* (a count the bit counter cannot hold on the first clock):
    the same behaviour, one token of RTL. But the IHP library has no flop with an asynchronous
    set, so Yosys wraps each of the 64 flops in inverters. Measured 392,054.7 µm² against the
    flag's 392,179.5, a difference below ABC's remapping noise. By construction the flag is
    smaller (one merged flop and an AND per coder). The flag also does not depend on an argument
    about which counts the counter can hold.
  - *Reset `sampled` to 1* (`pbe_bsync`): the first bit after reset would not be sampled at all,
    and integration would take a bit longer after reset than after `clear`. `pbe_line` has no
    `sampled`.
  - *Combinational sample count* (before BUG-088): puts the adders back on the compare path.
- **Not changed:** the documented one-clock lag after a CLKDIV or LINE2 write (D65, D66); the
  default sample point (`sp_base`, combinational) is untouched, so LINE2 = 0 behaves as before.

## D82. Program memory: an IHP SRAM per engine, 256 separate words each, on an 8x4 tile

- **Decided by the owner** (after D62's prototype and the organisers' confirmation): the
  program memory is IHP's `RM_IHPSG13_1P_256x16_c2_bm_bist`, one macro per engine, and the tile
  is 8x4 (Jane Street and Tiny Tapeout confirmed both). This entry is the RTL and verification
  side; the flow configuration is the owner's, with `docs/SRAM_8x4_FLOW_STEPS.md` as the guide.
- **Separate images, not mirrored** (D62's alternative 7, now chosen): each engine has its own
  256 words, 512 in all. The host writes only the selected engine's macro.
  - *Why:* mirrored writes gave both engines the same 128 (at most 256) words, so half of the
    512 words we pay for were copies. Programs are full (USB 64 of 64, SWD 64, CAN 61, Modbus
    62) and the planned protocols need more; separate memories double the space for no area.
    A write to one engine's memory no longer stalls the other engine (it does not refetch).
  - *Cost:* the host loads each engine separately (one more register write per image), and
    the two engines can no longer share one copy of a program (two CAN nodes need two copies;
    D4's "shared code" point). D4 rejected separate memories for wasting words when one engine
    runs a short program; with 256 words each that no longer bites.
- **Host interface:** a 10-bit byte pointer {engine, word[7:0], byte}.
  - `PM_ADDR` (0x06) keeps its meaning for the low byte: [7:1] word[6:0], [0] byte (0 high).
  - **New `PM_ADDR_H` (0x0F, RW):** [0] word[7], [1] engine. 0x0F was the free address in the
    first page (D62 already named it); reads of [7:2] are 0; reset 0.
  - `PM_DATA` (0x07) writes the byte and advances {word, byte} by one: the low byte carries
    into the next word, word 127 into word 128 (`PM_ADDR` into `PM_ADDR_H[0]`), and word 255
    wraps to word 0 **of the same engine**: the increment never changes the engine bit, so a
    burst of any length cannot spill into the other engine's program. Bursts work as before.
  - *Alternatives:* a 16-bit `PM_ADDR` (two bytes at 0x06/0x07 would move `PM_DATA`, breaking
    every loader); an engine select in the engine pages (+0x7, free) — two registers for one
    pointer, and the pointer would not read back as one number; carrying into the engine bit
    (one 1024-byte burst could load both engines, but a long burst for engine 0 would silently
    overwrite engine 1).
  - Old host code that writes only `PM_ADDR` still loads engine 0's words 0-127 (reset value
    of `PM_ADDR_H`).
- **Engine:** `pc`, `pc_d` and `START_PC` are 8 bits, inside the engine's own memory. Jumps keep
  6-bit targets relative to `START_PC` (64-word windows), now mod 256; sequential execution
  wraps 255 → 0. `START_PC` (+5) reads back all 8 bits. No `PAGE` instruction now: programs over
  64 words will need it, and EXT sub-op 7 with param[5] = 1 stays reserved for it (D67), with up
  to 5 page bits — a page of 2 already covers 128 words, 4 the whole memory.
  **Changed (D83):** `PAGE` is implemented; jumps are relative to their own 64-word page.
- **The refetch rule** (D50, BUG-074): a write to engine e's memory refetches engine e at the
  write and one clock later (`pm_wr_q`, now per engine); both refetch once after reset.
  At `CLKDIV` 0 a byte written to an engine's own memory costs that engine exactly 2 clocks; a
  write to the other engine's memory costs it nothing (`tb_fetch` (g)).
- **Wrapper** (`src/pbe_pmem_sram.sv`): two written-out instances, `u_pmem.u_sram0` (engine 0)
  and `u_pmem.u_sram1`, so that the flattened names have no generate-loop brackets to escape
  in `MACROS`. Checked against IHP's datasheet and model and Tiny Tapeout's example
  (`ttihp-cmos5l-sram-example`, `src/project.v`): `A_DLY` tied 1, the BIST port tied off,
  byte writes through the bit mask. Two differences from the example, both on purpose:
  1. `A_MEN` is tied 1 (the example drives it from a register that is 0 in reset). No write can
     happen in reset (`wr_en` is a reset flip-flop), and the reads during reset are discarded by
     the reset refetch.
  2. The read address is the engine's `pc_next` (combinational), not a register, so that the
     read lines up with D50's prefetch. Registering it would add a clock to every fetch: a taken
     jump would cost 2 bubbles at `CLKDIV` 0 and every cycle count in the protocol programs
     (USB's 32-clock bit, the SPI peripheral, BUG-043) would change. The write controls, address
     and data come from flip-flops through a small decode, as in the example. The slow-corner
     setup at `A_ADDR` is negative (about -0.6 ns) and `make timing` gives 3.59 ns of logic to
     the pins, so 48 MHz has room; the flow's STA must confirm it (the guide says where).
- **Fallback: the flip-flop memory stays, behind `PBE_PMEM_FF`, 64 words per engine.**
  - *Why keep it:* insurance for the tapeout. The SRAM's power hookup is new to us (the TT
    example says it is not yet proven in silicon) and depends on a flow plugin; if the
    hardening fails close to the deadline, one define gives a design that has passed the flow
    before (D45, D50), with the same register interface, programs and assembler. It also keeps
    D50's read-address copies honest (they are only generated in this build, `PC_COPIES`).
  - *Why 64 words:* 2 × 64 × 16 is the same 2,048 flip-flops as the old shared 128 words, so it
    fits the area the flow has already routed; 2 × 256 would double the old memory, which was
    already half the chip. Every program fits (the largest are 64 words). Writes to words 64-255
    are dropped (BUG-111), and `pc`/`START_PC` address the 64 words mod 64, so an image must keep
    each engine's programs below word 64: `make test-ff` runs `tb_usb` and `tb_proto`, whose
    images do.
  - *Alternative:* retire it — one memory implementation less to test, but no way back if the
    macro's power or LVS fails late. Rejected for now; retire it once the SRAM build has passed
    `gds`, `precheck` and `gl_test`.
- **Synthesis and lint:** the macro is a black box from `src/sram_bb.v` (Tiny Tapeout's file,
  Apache-2.0, skipped when `SIM` is defined). `make synth`, `make timing` and the CI lint read
  it; the owner adds it to `info.yaml` for LibreLane (the guide). `macros/.../*_bb.v` (ours) is
  gone. Simulation uses IHP's model with `FUNCTIONAL` (`pbe_v1/Makefile`, `test/Makefile`, the
  differential and coverage runners).
- **Measured** (`make synth`, Yosys, typical library; standard cells only):

  | Build | Area | Cells | Flip-flops |
  |---|---|---|---|
  | Before (flip-flops, 128 shared words) | 392,179 µm² | 17,641 | 3,907 |
  | **SRAM** (2 × 256 words; + 2 × 28,127 µm² of macros) | **198,770 µm²** | 11,808 | 1,825 |
  | `PBE_PMEM_FF` (2 × 64 words) | 366,093 µm² | 17,018 | 3,899 |

  `make timing` (slow corner, logic only): 3.59 ns, from `g_eng[1].u_eng.instr_q` (3.61 ns
  before). An 8x4 die is 1724.16 × 710.64 µm (1.225 mm²): 198,770 + 56,254 µm² is about 21 %.
- **Tests added:** `tb_fetch` (d) a write to engine 0's memory at engine 1's program address
  leaves engine 1 alone; (e) pointer carries (word 127 → 128 into `PM_ADDR_H`, 255 → 0 within
  the engine) by readback; (f) `START_PC` 252, sequential 255 → 0 and a jump target wrapping
  mod 256; (g) the refetch cost: 0 clocks for a write to the other engine's memory while it
  runs, exactly 2 per byte for its own; (h) after a reset the memories keep their contents and
  an engine run without a restart starts at word 0 (the reset refetch). (g) and (h) close the
  two gaps BUG-074 listed as not caught (a refetch only one clock late; `pm_wr_q` resetting to
  0). `START_PC` ≥ 128 in real protocols: `tb_debug` runs SWD at engine 1's words 192-255 (its
  jumps reach the top word), `tb_can` the second CAN node at 128, `tb_pbe` 1-Wire at 130. The
  model: pointer, engine select, wrap, per-engine refetch and an 8-bit pc (`test_top_model.py`,
  `test_model.py`); the differential test loads each engine at a random `START_PC` of 0, 64, 128
  or 192 and randomises `PM_ADDR_H` in its running writes. Formal: `engine.sby` gains
  `fetch_sram`, the D50 equality property (`instr_q` = the memory word at `pc - 1`) on an SRAM
  memory model; the default-configuration equivalence compares `pc` modulo 128. Coverage: seven
  new bins (`start_pc_upper_half`, `exec_word_255`, `jump_wraps_256`, `pm_write_engine0/1`,
  `pm_write_other_running`, `pm_second_refetch`). The cocotb test (also the gate-level test)
  runs with IHP's model and reads back `PM_ADDR_H` and an 8-bit `START_PC`.
- **Retired:** `sram/` (D62's flow patch). Its PDN approach (a stripe lattice of pitch 67.44 µm
  matched to the columns, and its own `pdn_cfg.tcl`) had no step that extends the stripes onto
  the macros' Metal4 supply columns, the `Project.ExtendPowerStripes` step of the Tiny Tapeout
  example, so the macros could have been left unpowered. The files are in git history
  (`git show ea6672f:sram/README.md`).
- **Flow configuration (`docs/SRAM_8x4_FLOW_STEPS.md` §1-4, done as written there).**
  - *Files:* `librelane_plugin_sram_pdn.py` and `odb_stripes.py` (repository root, where
    LibreLane loads `librelane_plugin_*.py`) and `src/pdn_cfg.tcl`, copied unchanged with their
    headers from `TinyTapeout/ttihp-cmos5l-sram-example` at commit `15ac9bc` (Apache-2.0;
    credit in `README.md`). Our `src/sram_bb.v` is kept (the example's file plus a note).
  - *`info.yaml`:* `tiles: "8x4"`; `pbe_pmem_sram.sv` before `tt_um_pbe.sv`, and `sram_bb.v`
    last (its `` `default_nettype none `` must not apply to our files).
  - *`src/config.json`:* the example's SRAM section after `CLOCK_PORT`: `meta` inserting
    `Project.ExtendPowerStripes` after `OpenROAD.GeneratePDN`; `MACROS` with the `pdk_dir::`
    `sg13cmos5l_sram` views and two instances, `u_pmem.u_sram0` at (3.36, 3.78) `FS` and
    `u_pmem.u_sram1` at (3.36, 170.10) `N` (stacked, same x, pin edges facing a 47.54 µm gap);
    four `PDN_MACRO_CONNECTIONS` lines (`VDD!` and `VDDARRAY!` per instance); `PDN_CFG`
    `dir::pdn_cfg.tcl`; `EXTEND_STRIPES_SRAM_ARRAY_EVERY_OTHER` true; `ERROR_ON_PDN_VIOLATIONS`,
    `RUN_MAGIC_DRC` and `ERROR_ON_ILLEGAL_OVERLAPS` 0. Below the "do not change" line,
    `FP_PDN_VPITCH` 44.96 (was 50.0), `VWIDTH` 2.1, `VSPACING` 3.52, `VOFFSET` 6.15, as in the
    example. Every other key (our `CLOCK_PERIOD` 20.833, `FP_PDN_MULTILAYER` 0, ...) is kept; a
    key-by-key comparison with the example's file differs only in `CLOCK_PERIOD`, `MACROS`
    instances and `PDN_MACRO_CONNECTIONS`. The reasons for each value are in the guide's §3-4.
  - *Alternatives:* the example's single-instance layout (one macro, more rows free) does not
    give each engine its own memory; macros side by side at x = 3.36 and 3.36 + n × 11.24 would
    keep each on its columns too, but would take 2 × 237 µm of the die's width and put the pins
    of both on the same edge facing the logic further away. Stacked with facing pins was chosen.
  - *Checked before the commit:* `make test` passes; `make synth` prints
    `tt_um_ayushyadavnvs_pbe/u_pmem.u_sram0` and `.../u_pmem.u_sram1`, the names in `MACROS`
    (standard cells 199,896 µm² after D83); the cocotb test (`test/`, IHP's model) passes 2/2;
    `python3 -m json.tool src/config.json` parses and `info.yaml` loads as YAML.
    `test/Makefile` adds the model for RTL and gate level alike and `gl_regression`'s
    `make test-gl` has it in `GL_SRC`, so neither needed a change. Not yet run: the `gds`
    workflow on 8x4 (the owner runs it; the guide's §6 lists what to check).

## D83. PAGE: programs over 64 words, with a one-shot page prefix on page-relative jumps

- **Asked by the owner** after D82: one program should be able to use its engine's whole
  256-word memory. Until now every jump target was 6 bits relative to `START_PC`, so a program
  was confined to a 64-word window (sequential code could run past it but never jump back).
- **Chosen semantics:**
  1. A program has four **pages** of 64 words: page n is program words 64n..64n+63 (relative to
     `START_PC`, mod 256).
  2. **A jump's 6-bit target is in the page of the jump itself** (`JMP`, `JCRCBAD`, `JEQ`,
     `JNE`, `JLINE`). The page is the top two bits of the jump's program address,
     `(pc - 1 - start_pc)[7:6]` (`pc - 1` is the executing word, D50).
  3. **`PAGE p` is a one-shot prefix:** it sets the page of the next instruction that executes,
     which then jumps to `start_pc + {p, target}`; after that instruction (whether it jumped or
     not) the prefix is gone. Restart, a timeout jump and a line-event jump clear it. A stop
     (`run` = 0) keeps it (the engine is frozen), and so does a host write's refetch (the
     instruction after it is fetched again and still gets the page).
  4. **The timeout / line-event vector stays in page 0**: `start_pc + TIMEOUT_PC` as before. A
     timeout can fire anywhere, so "the current page" would make the vector depend on where the
     program was blocked; one fixed place is what a vector is for. A routine longer than
     the remaining words of page 0 can jump on from there.
- **Encoding:** `EXT` sub-op 7, param[5] = 1 (reserved for it since D62/D67; param[5] = 0 stays
  `LINECTL`). p = param[1:0]; param[4:2] are reserved and must be 0 (the assembler writes 0, the
  hardware ignores them), so a larger memory could take up to 5 page bits without a new opcode.
  Word: `0xFE00 | p << 4 | DLY`.
- **Timing:** `PAGE` is an ordinary instruction: (DLY + 1) × (CLKDIV + 1) clocks. A taken jump
  costs its one refetch clock at `CLKDIV` 0 into any page, as before (D50): the target address
  is computed in the same clock, from flip-flops (`pg_set`, `pg_num`) and `pc`. A cross-page
  jump therefore costs one instruction more than a jump inside a page. `tb_page` (d): TOG,
  PAGE, JMP into another page and back, 4 clocks per toggle at `CLKDIV` 0, exactly.
- **Why this and not the alternatives:**
  1. *A persistent page register that extends every jump target* (like PIC's PCLATH): fewer
     PAGEs when a program jumps around one far page, but every jump then depends on which path
     reached it, so the assembler would need data-flow analysis (or a PAGE before every jump,
     which changes the timing of every loop), and a loop that falls through into the next page
     breaks silently. With page-relative jumps, loops inside a page need nothing, and only
     the jumps that cross pages cost a word, which the assembler knows from the labels alone.
  2. *A one-shot prefix with absolute pages (no prefix = page 0)*: the same hardware, but every
     loop outside page 0 would need a PAGE before its jump, changing its timing.
  3. *Wider jump targets:* no ARG bit is free (`JMP` and the EXT jumps use [8:6] + [5:0]).
  4. *A long jump instruction* taking two words: a new fetch path through the D50 prefetch; much
     more logic for the same effect as PAGE + jump.
  - All programs of up to 64 words are in page 0 and behave exactly as before; every existing
    image is byte-identical.
- **Assembler (`pbe_asm.py`):** labels anywhere in 0..255. For a jump whose label is in another
  page it inserts `PAGE p` just before the jump, moves the jump's labels onto it (so a jump to
  that jump also runs the PAGE) and prints `PAGE p inserted at word w (one more instruction
  time)`. Insertion repeats until no label moves to another page. `--no-auto-page` makes such a
  jump an error instead; an explicit `PAGE p` before a jump is checked against its target.
  New: `PAGE p`, and `.org n` (continue at word n, filling with `NOP`).
- **Flip-flop fallback (`PBE_PMEM_FF`, 64 words):** no change to the RTL. All four pages are the
  same 64 words (the memory is read mod 64, and writes above word 63 are dropped, BUG-111), so a
  program must fit in 64 words there, and PAGE is pointless but harmless.
- **Measured:** `make synth` 198,770 → 199,896 µm² (+1,126 µm²: 3 flip-flops per engine and the
  page adder); `make timing` 3.59 → 3.76 ns of logic at the slow corner (budget 20.83 ns).
- **Tests:** `tb_page` (also under Verilator in `make test-verilator`, and in `make test-gl`),
  written first and failing on the RTL without PAGE:
  (a) `page_test.pbe`, 202 words over all four pages: jumps 0 → 2 → 1 → 3 → 0 (by `JNE`) → 3,
  forwards and backwards, a loop inside page 3 without PAGE, and a timeout from page 3 to the
  vector in page 0 whose first instruction is a jump (a PAGE executed before the blocked
  instruction must be cleared by the timeout); (b) a PAGE survives a stop (`run` = 0) in its
  delay; (c) a restart clears it; (d) page 0 ↔ page 3 at `CLKDIV` 0 under 48 host byte
  writes: no PAGE lost to a refetch, and the timing above. Faults checked: restart, timeout or
  a host write not handled, the vector taking the current page, the prefix ignored — each fails
  `tb_page`, and the last fails `make diff`. The model has the PAGE state; the differential's
  random programs put a PAGE before 40 % of their jumps; formal (`engine.sby` invariants)
  asserts that a PAGE lasts exactly one executed instruction and that restart, timeout and
  line-event jumps clear it, and covers a jump into another page; three new coverage bins.

## D84. PS/2 host: a program, open-drain, the parity bit computed from the wire

- **Asked by the owner:** a PS/2 host (keyboard or mouse) as a program, with no RTL change.
  `programs/ps2_host.pbe`, 74 words (the assembler inserts one PAGE: the program crosses into
  page 1).
- **The device drives the clock** (10–16.7 kHz). The engine never clocks; it waits for levels,
  not edges: `WAIT clk, HIGH` then `WAIT clk, LOW` for each bit, and reads or changes DATA one
  tick later. A level wait cannot miss an edge that happened while the engine was busy (the
  idle poll, the pushes), which an edge wait (`FALL`) could. A tick of 5 µs (`CLKDIV` 239)
  puts the read 5 µs into a 30–50 µs low phase; anything from 3.2 µs (the 100 µs inhibit is 32
  ticks) to 10 µs works.
- **Open drain everywhere:** `DRV0`, `OUTOD` and `REL` only. The host's parity bit is the
  problem: `OUTPAR` drives push-pull. Instead the engine reads every data bit back from the wire
  (`IN dat` one tick after `OUTOD`), so the receive parity unit holds the XOR of the 8 bits; with
  `LINE_CFG` odd parity, `STAT`'s "parity error" bit is then exactly the odd parity bit to send,
  and `MOV OSR, ISR` + `OUTOD` sends it open-drain. The same setting checks the device's parity
  on receive (9 bits, including the parity bit, must have odd parity). The bits read back also
  rebuild the command byte for its record.
  - *Alternatives:* `OUTPAR` (push-pull for one bit while nobody else drives DATA: legal in
    practice, not open-collector); the host sending the parity bit (as SWD's write parity,
    D76): both work, the read-back needs neither.
- **Idle:** a poll of `JMP PIN_LO` (DATA low: the device's start bit; `JMP_PIN` = DATA) and
  `JMP TX_READY`. The device is checked first, so a command queued while the device sends waits
  for the byte (tested). The host never inhibits the device except to send.
- **Records:** two bytes per event, so the host can parse the stream without lengths:
  `[byte][status]` (status 0x00, bit 0 parity error, 0x80 stop bit 0, bit 3 RX overflow),
  `[cmd][0x20/0xA0]` (sent, ACK or no ACK), `[0x00][0x04]` timeout. Every record is pushed at
  the end of its frame, so a timeout in mid-frame cannot leave half a record. After a frame the
  program also waits for DATA high before polling again: a device that sent a 0 stop bit may
  still hold DATA low, which the idle poll would take for a start bit (a guard; the bench passes
  without it, BUG-118).
- **Timeout:** `TIMEOUT` 4000 ticks (20 ms): a device that stops clocking or never answers a
  request to send. Only `WAIT`s block (the idle poll does not), so it never fires while idle.
  The vector releases both lines and reports `[0x00][0x04]` (a constant: `STAT` after a timeout
  in the middle of a send would also show a meaningless parity bit, BUG-117).
- **Speed:** set by the device (the PS/2 range is 10–16.7 kHz); the program needs each clock
  phase to last at least 3 ticks (15 µs at the 5 µs tick).
- **Limits:** no automatic resend (`0xFE`) and no inhibit for flow control: the host reads the
  RX FIFO (8 records) in time, or `STATUS` bit 3 reports an overflow. A PS/2 device runs at 5 V:
  the chip's 3.3 V pads need a level shifter (or series resistors and pull-ups to 3.3 V, if the
  device accepts 3.3 V levels).
- **Test:** `tb_ps2` against `ps2_dev.sv`, a keyboard written from the protocol description:
  scan codes (make, break, extended), `0xED` + LED byte with the `0xFA` ACKs, `0xEE`, `0xF2`
  (`FA AB 83`), `0xFF` (`FA AA`), a device byte with a bad parity bit and one with a 0 stop bit,
  a command the device does not ACK, a request to send never clocked (timeout, then recovery),
  and a command queued while the device sends. The model checks the inhibit (≥ 100 µs), that
  the host changes DATA only while CLK is low, and the host's parity and stop bits; the bench
  checks that the chip never drives a line high. 8/8 at 12.5 kHz.
- **sigrok** (`make sigrok-proto2 PROTO2=ps2`): the stock `ps2` decoder decodes all 34 words in
  both directions in the host's order, with the parity error where the host reported it. Its
  0.5.3 version completes a word on the 12th falling edge (it stores a bit before testing the
  count of 11), so consecutive device bytes lose their framing; the check adds one clock pulse
  with DATA high in each idle gap, which the decoder ignores except to complete the pending
  word (documented in `proto2_verify.py`).

## D85. 24-bit GPIO expander: 74HC595 and 74HC165 chains, one shared shift clock

- **Asked by the owner:** 24 outputs through three chained 74HC595 and 24 inputs through three
  chained 74HC165, as a program. `programs/gpio_expander.pbe`, 33 words.
- **Pins:** SCK (both chains' shift clock), SDO (595 SER), SDI (165 QH), RCLK (595 latch), LD#
  (165 SH/LD#): 5 pins, so the other engine keeps 3.
  - *A shared clock:* one exchange shifts 24 bits out and 24 bits in at once, so a full
    read-and-write takes the time of one; the two chains never need different clocks.
  - *Separate RCLK and LD#* rather than one wire for both (a common board trick): with one
    wire, the latch edge that shows the new outputs is also the load that samples the inputs,
    so either the outputs or the inputs lag by one exchange. One more pin buys exact
    semantics: inputs sampled when the exchange starts (LD# low), outputs changed together when
    it ends (RCLK rises).
- **The program:** three copies of the byte loop (`OUT`, `IN`, SCK high, SCK low), one per
  byte. X counts the bits, OSR holds the byte going out and ISR the byte coming in, so no
  register is left to count bytes; three copies (24 words) are cheaper than shuffling a count
  through `MOV`s, and keep every bit the same length. `IN` reads QH before the rising edge that
  moves the chain on.
- **Timing at `CLKDIV` 0:** 7 clocks per bit, SCK 6.86 MHz (high 2 clocks, 41.7 ns; low 5).
  SDO is set 41.7 ns before SCK rises (595 setup: 25 ns at 4.5 V). SDI is read 5 clocks after
  SCK rises; with the two synchronizer stages, QH may take up to 4 clocks (83 ns) to settle.
  LD# is low for 3 clocks, RCLK high for 2. At `CLKDIV` n ≥ 1: 6 ticks per bit,
  SCK = 48 MHz / (6 (n + 1)) (2 MHz at n = 3, measured). One 24-bit exchange takes about 190
  clocks (4 µs) at `CLKDIV` 0; the host's three writes and three reads take longer.
- **Parts:** 74HC at 3.3 V (the chip's pad voltage) is fast enough at `CLKDIV` 0 (the bench uses
  60 ns CLK-to-QH, twice the 4.5 V datasheet value); 74HC at 2 V needs `CLKDIV` ≥ 3. 74HCT runs
  at 5 V and would drive 5 V into the chip: not without a level shifter.
- **Limits:** the chain length is fixed at 3 (another length is a copy more or less of the byte
  loop); exchanges are started by the host, not periodically.
- **Test:** `tb_gpio` against `hc_chain.sv`, 74HC595 and 74HC165 models written from TI's
  datasheets with their setup, hold, pulse-width and RCLK-after-SRCLK checks: 40 random
  exchanges at `CLKDIV` 0 and 8 at `CLKDIV` 3, the inputs changed during each exchange (the
  values at LD# must come back), the outputs checked not to change before RCLK, and a walking one
  through all 24 outputs and inputs for the bit order. Passed at the first run.
- **sigrok** (`make sigrok-proto2 PROTO2=gpio`): the stock `spi` decoder (mode 0, MSB first)
  on SCK, SDO and SDI decodes all 72 exchanges as the host wrote and read them.

## D86. Logic analyser and waveform generator: two programs, uniform sample clocks

- **Asked by the owner:** capture up to 4 pins per sample into bytes at a programmable rate,
  streaming to the RX FIFO, with a level or edge trigger on a chosen pin; and a generator
  replaying TX FIFO bytes onto 2 pins. `programs/la_capture.pbe` (30 words) and
  `programs/wavegen.pbe` (16 words): one per engine, so both can run at once.
- **Capture:** 4 `IN`s per sample, 2 samples per byte (bits 3..0 the first, 7..4 the second),
  then `PUSH` and the loop jump. The first sample's last `IN` carries `[2]`, so every sample
  starts 6 ticks after the one before: the sample clock is uniform at 6 (CLKDIV + 1) clocks
  (4 MS/s at `CLKDIV` 1). At `CLKDIV` 0 the loop's taken jump adds one clock to every second
  sample (6, 7, 6, 7 ...), so `CLKDIV` ≥ 1 is the documented range (D50's timing rule: at
  `CLKDIV` ≥ 1 a taken jump costs nothing extra).
  - **Channel skew:** one `IN` reads one pin, so channel k is read k ticks after channel 0.
    The four channels are four captures at the same rate with offsets of 0..3 ticks; no
    hardware samples several pins at one instant. Documented; a host can correct it.
  - **Trigger:** `JMP_PIN` (a host register, any of the 8 pins) is polled by a one-instruction
    loop (`hi: JMP PIN_LO, hi`), one test per tick; edges are two loops. The first sample is
    3 ticks after the tick that saw the trigger in every mode (mode 4 got an extra `JMP go`
    for that). Records: `[mode][n-1]`, mode 0 now, 1 high, 2 low, 3 rising, 4 falling.
  - *Alternative:* a `WAIT` patched by the host into the program (as `usb_dev`'s address
    words): one tick less latency, but the host would rewrite program memory per capture.
- **Generator:** 2 `OUT`s per sample (A then B), 4 samples per byte, 4 ticks per sample:
  6 MS/s at `CLKDIV` 1. The next byte is pulled during the last sample, and the loop jump is
  `JMP X--`, so a byte boundary costs no extra tick; after the last byte that `PULL` reads the
  next record's count (and waits for it, holding the last sample: a natural end). B changes one
  tick after A in each sample. Records `[n-1][n bytes]`, nothing returned.
- **Rates and bursts** (measured in `tb_la`, host SCK = 48 MHz / 8, the port's maximum, burst
  reads and writes): a capture produces one byte per 12 (CLKDIV + 1) clocks; the host moves
  one byte per 64 clocks plus its `RX_COUNT` polls. Sustained capture works at `CLKDIV` ≥ 6
  (1.14 MS/s, 160 bytes checked); at `CLKDIV` 5 the FIFO fills. Faster captures are bursts of
  16 bytes (32 samples), at any rate. When the FIFO is full the `PUSH` waits: the capture
  pauses (a gap in time) and `STATUS` bit 3 (RX overflow) reports it, so a corrupted capture is
  never silent (tested: 40 bytes at `CLKDIV` 1 with nobody reading). The generator consumes
  one byte per 16 (CLKDIV + 1) clocks: a sustained stream works at `CLKDIV` ≥ 3 (3 MS/s, the
  port's own rate) once 15 bytes are queued before the start; when the FIFO runs dry the
  current sample is held (the waveform pauses, it is not corrupted). Up to 16 bytes (64
  samples) can be queued whole and play at any rate.
- **Limits:** 4 capture channels, 2 generator outputs (more pins per sample would lower the
  rate in proportion); no sample counter or timestamps; no repeat mode for the generator (the
  FIFO's MARK/REWIND, D70, could replay up to 16 bytes forever: a possible extension).
- **Test:** `tb_la`: an independent counter on pins 0..3 advancing every 3.3-5.2 sample
  periods (not a whole number, so its edges fall at every sampling phase); the captured values
  must run in order with the right run lengths (one sample per boundary may mix two values, the
  skew). Bursts at `CLKDIV` 1 and 3, a 160-byte sustained capture at `CLKDIV` 7 with the host
  reading; rising-edge, falling-edge and high-level triggers (the first sample must show the
  trigger value and the counter value at the trigger); the overflow report. The generator's
  pins are timestamped: every edge must be on its sample grid (A at t0 + kS, B one tick later)
  and the levels must be the bytes: 15 bytes queued at `CLKDIV` 1, 64 bytes streamed at
  `CLKDIV` 4, 4 bytes at `CLKDIV` 20. 10/10.
- **sigrok:** the capture is bytes the host reads, not wires a decoder could look at; the
  bench's own independent stimulus and timestamps are the cross-check. (The stock `parallel`
  decoder needs a clock line, which neither side has.)

## D87. Quad SPI controller: records per phase, one pin per instruction

- **Asked by the owner:** a quad SPI controller, e.g. reading a QSPI flash in 1-1-4 or 1-4-4,
  driving or sampling 4 data lines one bit per instruction. `programs/qspi_flash.pbe`,
  125 words (the assembler adds 6 PAGEs: the program spans pages 0 and 1).
- **Pins:** SCK, CS#, IO0..IO3: 6 of the 8, on one engine (the other engine keeps 2). The
  8-pin budget allows it; dual and quad need no more pins than this.
- **Host protocol: a transaction is a list of phases**, each a record: `[0x01]` single write on
  IO0, `[0x02]` single read on IO1, `[0x03]` quad write, `[0x04]` quad read, `[0x05]` dummy
  clocks (IOs released), each with `[n-1]` and, for writes, the bytes; `[0x00]` ends the
  transaction (CS# high). CS# falls with the first phase. This covers 1-1-1, 1-1-4, 1-4-4 and
  4-4-4 (QPI) commands, reads and quad page programs, without the engine knowing any command.
  - *Alternative:* a command-specific program (e.g. only 0x6B with a 3-byte address): fewer
    host bytes, but every other command (ID, status, 0xEB, writes) would need another program.
- **One pin per instruction:** a quad nibble out is `OUT io3, io2, io1, io0` then SCK up and
  down; in, 4 `IN`s then the clock. MSB first in both directions (`SHIFT` 0x03), so IO3 carries
  bit 7 and bit 3, as flashes do. Each byte loop is unrolled (8 single bits, or 2 nibbles): no
  bit counter, so X counts bytes, and the clocks are as short as the instructions allow.
- **Input timing:** an `IN` sees a pin 3 clocks after it changes (two synchronizer stages), and
  the flash changes its output just after SCK falls (t_V ≈ 7 ns, under a clock). So every read
  waits 3 clocks after the falling edge (`DRV0 [2]`, or the `PUSH` and the loop jump) and
  finishes before the next falling edge reaches the synchronizers. SCK high is 1 clock
  (20.8 ns), far above flash minimums (≈ 4.5 ns at 104 MHz parts).
- **Measured SCK at `CLKDIV` 0** (`tb_qspi`): single write 16 MHz, single read 9.6 MHz, dummy
  12 MHz, quad write 8 MHz (4 MB/s), quad read 6 MHz within a byte and 17 clocks per byte
  overall (2.8 MB/s). At `CLKDIV` n ≥ 1 divide by n + 1 (less one clock per taken jump). A quad
  read is faster than the host port (one byte per 64 clocks at its maximum), so long reads run
  in 16-byte bursts: `PUSH` waits with SCK low, which mode 0 allows; nothing is lost.
- **Limits:** no dual (1-1-2, 1-2-2) phases (two more record types would add them); no DTR
  (double transfer rate) and no continuous-read mode tracking (the host simply sends mode 0x00);
  SCK is far below a flash's limit, by the one-pin-per-instruction design.
- **Test:** `tb_qspi` against `qspi_flash_model.sv`, a NOR flash written from the common
  command set (W25Q-style timing: outputs t_V = 7 ns after the falling edge, set-up, hold,
  clock widths, CS# set-up): JEDEC ID 0x9F, Read 0x03, Fast Read 0x0B, Fast Read Quad Output
  0x6B (64 bytes, more than the RX FIFO, read while the engine runs), Fast Read Quad I/O 0xEB,
  and Write Enable + Quad Page Program 0x32 (24 bytes) read back with 0x6B, at `CLKDIV` 0 and
  2. The bench checks that the chip and the flash never drive an IO line together. 12/12.
- **sigrok** (`make sigrok-proto2 PROTO2=qspi`): libsigrokdecode 0.5.3 has no quad SPI decoder;
  its `spi` decoder on SCK, CS# and IO0 decodes the single-line command and address bytes of
  all 22 transactions exactly as the host sent them.

## D88. HDLC / SDLC: NRZ with exact flags around the line coder; NRZI needs hardware — **Changed (the hardware, D94)**

**Changed (D94):** `pbe_line` now has `LINECTL STUFFOFF/STUFFON` and `LINE[6]` (flag-delimited
frames), the two pieces proposed below; `hdlc_tx` and `hdlc_rx` were rewritten on them and work in
NRZ and NRZI. The flags-from-the-gap trick and the RXD poll for aborts below are history.

- **Asked by the owner:** HDLC/SDLC framing: 0x7E flags, zero-bit insertion and deletion by the
  line coder's "after 5 ones" stuffing, CRC-16/X.25, abort detection; NRZ or NRZI. Two programs:
  `programs/hdlc_tx.pbe` (41 words, engine 0) and `programs/hdlc_rx.pbe` (38 words, engine 1),
  so the link is full duplex.
- **What the line coder gives and lacks (pbe_line, D39):** stuffing after 5 ones in both
  directions, NRZ/NRZI, bit transfers, bit timing and edge re-centring. It does **not** send an
  unstuffed flag: `LINECTL` stuffing off/on exists only in the bit-synchronous (CAN) coder,
  pbe_bsync (D67); in pbe_line every bit of a frame, the SYNC byte included, is stuffed, so six
  1s can never leave it. And on receive, a stuffing violation ends a frame only when the line is
  at its idle (high) level (BUG-033); elsewhere it is a line error.
- **Transmit, NRZ, exact flags with no new hardware:** the pin unit holds TXD high (`DRV1`) under
  the coder, so whatever the coder does not drive reads high. A coder frame starts with a 2-bit
  gap (not driven) and the coder lets go of the line the moment a frame ends. A flag
  `0 1 1 1 1 1 1 0` is therefore made of `0 1 1 1 1` at the end of one coder frame (four 1s: no
  stuffing), the `1 1` of the next frame's gap (the pin unit's level) and that frame's first bit,
  `0`. Measured: the gap is 2 bit times + 2 clocks when the next `OUT` is already waiting (the
  program issues it within a bit time of the `END`), so the six 1s last 6 bit times + 2 clocks;
  a receiver that samples mid-bit and re-centres on edges reads exactly six. Back-to-back frames
  share one flag; after the last frame a "0 1" coder frame completes the flag and the line idles
  high (mark). The opening flag after idle is a "0 1 1 1 1" coder frame of its own.
  FCS: the CRC unit (poly 0x1021, init 0xFFFF, reflected output, fed by `OUT`) and
  `OSRCRC LO/HI, INV`, low byte first.
- **Receive, NRZ:** in NRZ every flag's six 1s are at the high level, so the coder ends a frame
  at every flag (and at an abort), on the 6th 1. Bit transfers (not bytes) are used: the coder
  starts its next frame at the flag's last 0, which would shift every byte by one bit; in bit
  mode the program drops that first bit (`IN rx, NOCRC`) and assembles bytes itself. The bits
  before the frame end include the closing flag's `0 1 1 1 1 1`, which the CRC unit is fed
  with: since they are always the same 6 bits, the good value is the X.25 residue (0x1D0F
  unreflected, 0xF0B8 reflected) advanced by them: `CRC_GOOD` = 0xD0F9. A good frame also has
  exactly 6 bits after its last whole byte (X = 1 at the frame end).
  - **Records:** the bytes (with the FCS) and `[0x7E][status]` at the end; a data 0x7E is sent
    twice. Status: `STAT` for a whole frame (0x02 = CRC ok; bits 3, 4 overflow and line error),
    0x40 abort, 0x80 not a whole number of bytes. Frames with no byte (runs of flags, idle) are
    not reported (a `FLAG` bit remembers whether a byte was pushed).
    *Alternatives:* a length prefix (impossible: the FIFO is smaller than a frame), a byte
    count trailer as in `usb_dev` (needs the host to know where a record ends), a status byte
    per data byte (halves the bandwidth). The escape costs two instructions per byte.
  - **Abort (7+ 1s):** the coder ends the frame on the 6th 1 for a flag and for an abort alike;
    the 7th bit decides. The program polls RXD for about one bit time after the frame end
    (`JMP PIN_LO` every 10 clocks, d + 1 times): a flag's last 0 pulls it low half a bit later,
    an abort keeps it high. d is set by the host as one byte in the receiving engine's (unused)
    TX FIFO, read again at every frame end with `MARK`/`REWIND` (D70), so no program word is
    patched: d = ceil((bit time / 2 + 4) / 10) (bit time in clocks), up to 255, i.e. abort
    detection from 10 kbit/s up. *Why not `TIMEOUT`:* inside a frame a stuffed 0 makes the gap
    between delivered bits 2 bit times, the same as the gap to the next 0 after an abort, so no
    single timeout separates them.
- **Speeds at 48 MHz:** transmit up to 4 Mbit/s (`CLKDIV` 11: a byte boundary takes about 10
  clocks, which must fit in one bit time); receive up to 2 Mbit/s (`CLKDIV` 23: the frame-end
  path, the abort poll and the trailer must finish before the second bit of the next frame).
  Tested at 1, 2 (both directions) and 4 Mbit/s (transmit).
- **NRZI cannot be done in a program** with the current line coder, in either direction:
  1. *Transmit:* the coder starts every frame assuming the line is at level 1 (`level <= 1` at
     the end of the gap). The level after a frame depends on its data, so the next frame (or
     the pin-unit part of the flag) starts with the wrong reference half the time: its first
     bit is inverted. Inverting it in the program would also inject a 1 into the coder's
     stuffing count and move the next stuffed 0.
  2. *Receive:* the six 1s of a flag are at a data-dependent level in NRZI; when it is low the
     coder reports a line error instead of ending the frame (BUG-033's rule), and the frame
     runs into the next one.
  **Minimal general hardware** that would allow NRZI (and make flags cheaper in NRZ too):
  - `LINECTL STUFFOFF` / `STUFFON` for pbe_line (the bit-synchronous coder already has them,
    D67): a program sends `0x7E` (or an abort) unstuffed inside one coder frame, so the line
    level stays continuous through flags and NRZI is encoded correctly. Useful beyond HDLC:
    any protocol with an unstuffed delimiter in a stuffed stream.
  - A `LINE` option bit (`LINE[6]` is reserved): "a stuffing violation ends the frame at either
    level" (the frame-end rule of a flag-delimited protocol), and with it, ideally, a receive
    flag pattern (a SYNC-style compare on the raw, unstuffed bits) so the coder could deliver
    whole aligned bytes. A few gates and one register bit each.
  No RTL is changed here (the owner's constraint); NRZ is supported, NRZI is not.
- **Other limits:** no synchronous clock line (HDLC with an external TXC/RXC); the line coder
  recovers the clock from the data, which NRZ HDLC does not guarantee in long runs of 0s
  (NRZI's purpose): the receiver re-centres on every edge and tolerates the 0.5 % offset
  tested; long 0 runs in NRZ are untested beyond the 64-byte random frames. No address
  filtering (the host does it). The transmitter needs the host to keep the TX FIFO fed (a byte
  per 8 bit times) for frames longer than 16 bytes; an underrun corrupts the frame and sets
  `STATUS` bit 4.
- **Test:** `tb_hdlc` against `hdlc_model.sv`, written from ISO/IEC 13239 (its own flag search,
  zero deletion, abort rule and reflected X.25 residue check; its transmitter 0.5 % slow):
  transmit: frames with 0x7E, 0x7D, 0xFF, 0x3E, 0x7C, 0xF8, 0x1F (runs of 5-8 ones and flag
  look-alikes), a 1-byte frame, 40- and 64-byte frames, all back to back, at 1, 2 and 4 Mbit/s;
  receive: good frames, a shared flag, three flags before a frame, a CRC error, an abort followed
  by idle and an abort (exactly seven 1s) followed at once by a flag, a 64-byte frame, at 1 and
  2 Mbit/s. 5/5. The model also checks that the chip's transmitter never sends an abort.
- **sigrok:** libsigrokdecode 0.5.3 has no HDLC decoder; the cross-check is the model.

## D89. Quad host port: 4 bits per SCK in both directions, entered and left explicitly

- **Asked by the owner** for 10BASE-T (D90-D93): a frame is 1.25 MB/s with no gap inside it,
  and the 16-byte FIFOs cannot hold a frame (up to 1518 bytes), so the host must stream it in
  real time. The single-lane port moves one byte per 8 SCK, and SCK is at most clk / 8 (the
  2-flop synchronizers and the read pipeline, below): 64 clocks per byte, 0.94 MB/s at 60 MHz
  (0.75 at 48), less than one Ethernet stream. The owner chose a faster host port over large
  frame buffers.
- **Chosen: a quad mode of the same port** (`pbe_host_spi`, D89 in its header):
  - **Pins.** Host to chip: D0 = `ui_in[2]` (MOSI), D1..D3 = `ui_in[3..5]`, the spare inputs;
    SCK and CS_n stay on `ui_in[0..1]`. Chip to host: Q0 = `uo_out[0]` (MISO), Q1..Q3 =
    `uo_out[1..3]`, borrowed in quad mode only and only while CS_n is low; with CS_n high they
    are IRQ and the two running bits as before. `uo_out[7:4]` (RX has data, TX full) are never
    borrowed: they are what a streaming host watches. `ui_in[6..7]` stay unused.
  - **Framing unchanged:** command byte, data bytes, auto-increment, the streaming registers,
    the read pipeline. Each SCK rising edge carries a nibble, high nibble first; a byte is 2 SCK
    cycles. The read data lines are separate outputs, so there is no turnaround cycle and a
    read burst runs at the write rate.
  - **Entering:** `HOSTCFG` (0x50, RW, reset 0) bit 0. The mode in use is latched from it only
    while CS_n is high, so the transaction that writes it finishes in the old mode, and no
    transaction ever changes mode half-way.
  - **Leaving (the defined safe way back):** write `HOSTCFG` = 0 in quad mode; or **8 SCK
    rising edges while CS_n is high**, which clears `HOSTCFG` whatever mode the port is in (a
    host that lost track of the mode, or restarted, sends it unconditionally; single mode
    ignores it); or reset.
- **Synchronizers:** D1..D3 go through the same two clk flops as SCK, CS_n and MOSI (the host
  synchronizer is now 6 bits). Single mode reads only bits 0..2, exactly as before.
- **Maximum SCK and bandwidth** (the same limit in both modes, clk / 8: the chip sees an SCK
  edge 2-3 clocks after it happens, so a falling edge shifts the next read nibble out about 3
  clocks later, and the host samples it at the next rising edge, 4 clocks after the fall):

  | Clock | SCK max | Single lane | Quad |
  |---|---|---|---|
  | 48 MHz | 6 MHz | 0.75 MB/s | 3.0 MB/s |
  | 60 MHz | 7.5 MHz | 0.94 MB/s | 3.75 MB/s |

  `tb_quad` measures 64 and 16 clocks per byte in 16-byte bursts, both directions. A
  10BASE-T stream (1.25 MB/s, one byte per 48 clocks at 60 MHz) uses a third of the quad port
  in either direction, so the host has 3x the line rate; each burst costs one command byte
  (and, if the host does not watch the TX-full pin, a `TX_COUNT` read: 2 bytes more).
- **FIFO depth: kept at 16 bytes.** At 60 MHz a byte leaves the TX FIFO (or arrives in the RX
  FIFO) every 0.8 µs during a frame. A full 16-byte FIFO covers 12.8 µs of host absence; a
  refill of 15 bytes takes 15 x 16 = 240 clocks (4 µs) plus a command byte, so a host that
  services the FIFO at least every ~8 µs (or keeps streaming and pauses SCK while the
  TX-full pin is high) never underruns. A host able to run SCK at 7.5 MHz with 4 lines is a
  PIO/DMA engine or an FPGA, whose jitter is well below a microsecond. 32 bytes would double the
  allowance to ~25 µs but cost about +11k µm² per FIFO pair (D45: 690 µm² per byte) and change
  the FIFO depth assumed by the golden model, formal proofs, coverage and stress (all built on
  16 bytes), for a host class that cannot run this port anyway. Underruns and overruns are
  never silent (D93), so a host that is too slow is told.
- **Alternatives:**
  - *A dual port* (2 bits): 1.9 MB/s at 60 MHz, only 1.5x Ethernet with no room for bursts and
    polls.
  - *A faster SCK* with a source-synchronous sampling scheme (sampling MOSI on the raw SCK, not
    through the synchronizers): breaks the 2-flop discipline the whole port is built on.
  - *Entering by a command byte* (e.g. a reserved command like QSPI flashes' 0x38): equivalent,
    but a register reads back and is in the register map like every other setting.
  - *Leaving by CS_n held high for N clocks:* the host would have no explicit action; any idle
    host would leave quad mode.
- **Generality:** the port is protocol-neutral: every high-rate stream gains (the logic
  analyser's sustained capture rate, D86, is limited by the port; quad SPI's 2.8 MB/s reads,
  D87; HDLC and USB at higher rates).
- **Tests:** `tb_quad` (16 checks: reset mode, entering at CS_n high, register writes and reads,
  16-byte bursts at 16 clocks per byte against 64, the borrowed pins with CS_n high and low,
  `uo_out[6]` as TX full in quad mode, a program load and a 64-byte UART loopback in quad
  mode, leaving by `HOSTCFG` = 0, by 8 SCK pulses (and their harmlessness in single mode), and
  by reset). `tb_host.svh` has a quad path: with `+QUAD` every bench's host switches at its
  first transaction; `make test` runs `tb_la` that way and `make test-quad` also `tb_pbe` (UART,
  SPI, I2C, 1-Wire, Modbus, SMBus). Every existing bench passes unchanged in single mode.
- **Register map:** `HOSTCFG` 0x50 is the first register above the second pages; unmapped reads
  still return 0, so the golden model (which never writes 0x50) still matches.

## D90. Manchester line coding (LINE mode 3), clock recovery on both clock edges

- **Asked by the owner** for 10BASE-T (and generally DALI, RC5, MIL-STD-1553 style links).
- **Chosen: mode 3 of `LINE[1:0]`**, the one reserved code (D39), in `pbe_line`. Every other
  mode, and every existing configuration, is unchanged; the formal default-equivalence and
  the golden model never select mode 3.
- **Convention:** IEEE 802.3 clause 7.3.1.1 (to which 10BASE-T, clause 14, refers): "during the
  first half of the bit-symbol, the encoded signal is the logical complement of the bit value
  being encoded; during the second half, the uncomplemented value". So a 1 is low then high,
  with a transition in the middle of every bit. `LINE[7]` swaps the halves (a 1 is high then
  low: G.E. Thomas, MIL-STD-1553's Manchester II). Byte and bit transfers, LSB/MSB first, SYNC
  and pair mode work as in the other modes; stuffing is off (LINE[3:2] ignored).
- **Transmit:** the first half is floor(period_m1 / 2) + 1 clocks (3 of 6 at 10 Mbit/s and
  60 MHz), the second the rest. After `END` the line is held at the high level (in pair mode:
  pin a high, pin b low, a positive differential) for **3 bit times**, then let go (the pin
  unit's level, idle). That is 10BASE-T's TP_IDL (clause 14.3.1.2.1, Figure 14-10: a positive
  level after the last bit before idle) and DALI's 2 stop bits. A secondary source (a TI application note) gives TP_IDL as a 300 ns or 350 ns pulse depending
  on the last bit; holding 3 bit times after the last bit cell gives 300 ns from a boundary
  transition (last bit 0) and 350 ns from a mid-bit one (last bit 1), the same two numbers.
  The minimum (about 250 ns, "at least 2 bit times" in the owner's brief) and the return to
  zero are left to the external driver's network and are for the verifier to check against
  the template (`docs/ETHERNET_VERIFICATION_TODO.md`). A transmit underrun holds the level (no
  transitions: the far end sees the carrier end) and pulses the line error, as in other modes.
- **Receive, clock recovery:** a bit timer holds the expected mid-bit point; a transition at
  least 3/4 of a bit (+ 1/4 clock) after it is the next mid-bit transition, and the level after
  it is the bit; earlier transitions (bit boundaries, only between equal bits) are skipped.
  - **The first transition** after idle starts a frame and is the reference; its bit is not
    delivered (it is a preamble or start bit). With the 10BASE-T receiver idling low (the
    comparator, `docs/info.md`) the first transition of a preamble (a 1: low then high) is a
    mid-bit transition, so lock is immediate; a wrong first lock corrects itself at the first
    0/1 pair, and `SYNC` (the SFD 0xD5) finds the byte alignment.
  - **End of carrier:** no mid-bit transition for 2 bit times (TP_IDL is 3). `frame_end`
    pulses only for a frame whose `SYNC` was found (or with `SYNC` = 0): link pulses (one
    positive pulse), a lone edge at the end of TP_IDL and noise end silently.
  - **Jitter.** First version: the reference was each accepted edge itself. `tb_line` M7 (per
    edge uniform jitter, 20 frames per step) decoded up to ±0.5 clock (±8.3 ns at 60 MHz):
    the interval between two edges carries both edges' jitter plus a clock of quantization.
    The commonly quoted 10BASE-T receive jitter is ±13.5 ns (802.3 clause 14.3.1.3, for the
    verifier to confirm), so that was not enough. Two changes, measured one at a time:
    1. **A first-order loop:** each mid-bit transition moves the reference by a quarter of its
       error (1/8-clock resolution), so the reference averages the edges. Alone: no gain
       (still ±0.5 clock), because the quantization of the edge itself was then the limit.
    2. **Both clock edges** (the owner's suggestion): the top level samples the pins at the
       falling clock edge too (`pins_n0` on the falling edge, then two rising-edge stages: a
       3-flop synchronizer whose first stage has half a clock to settle), and the engine passes
       the receive pin's falling-edge sample to the coder (`a_early`). An edge already present
       at the falling edge happened in the first half of the clock, so edges are timed to half
       a clock. With the loop: ±0.6 clock. With the threshold moved by the mean detection
       delay (a quarter clock): **±0.8 clock, ±13.3 ns at 60 MHz, error-free**; failures start
       at ±0.9 clock (2 of 40 frames at ±18 ns on a 20 ns bench clock). Loop gain 1/2: ±0.6;
       1/8: ±0.5 (slower tracking); thresholds ±1/8 clock either side: ±0.6-0.7.
  - **Clock offset:** 802.3 allows ±0.01 % (100 ppm); M4 decodes at ±100 ppm with ±0.6 clock
    of jitter and at ±1 % (100x the limit) with ±0.4 clock. The loop's steady-state lag at
    an offset f is about 4 f bit times (0.04 clock at 1 %).
- **Who else benefits:** both-edge sampling is per pin and general (the logic analyser or any
  future receiver could use it); Manchester itself serves DALI (1200 bit/s, idle high, 2 stop
  bits), RC5 infrared, MIL-STD-1553 data words (its sync is a code violation the coder does
  not generate: a program would bit-bang it) and 10BASE-T.
- **Alternatives:**
  - *A PLL-style decoder in the program* (bit mode, IN per half bit): 3 clocks per half bit
    leave no instruction time.
  - *Oversampling at 8 per bit* (an 80 MHz clock): the owner's clock is 60 MHz.
  - *Edge-relative decoding without a loop* (the first version): simpler, ±8.3 ns.
  - *A new LINE bit for Manchester:* mode 3 was free and has no other sensible meaning.
- **Cost:** per engine, a 24-bit signed bit timer, one registered 24-bit threshold (6 x
  `CLKDIV`, off the compare path like `sp_q`, D65; the other two limits, a bit and two bits in
  eighths, are shifted copies of `CLKDIV`), the second-half register; 24 flip-flops for the
  falling-edge pin samples in the top level. Measured with `make synth` in D92.
- **Tests:** `tb_line` M1-M7 (`tb_line_manch.svh`, an encoder written from 802.3 and checks of
  every clock): transmit in both polarities with the TP_IDL tail and release, an underrun,
  receive at 0/±100 ppm/±1 % with jitter, link pulses and a stray edge ignored, a coder-to-coder
  loopback, the jitter sweep. Also under Verilator (`make test-verilator`), identical logs.

## D91. CRC unit up to 32 bits: CRC-32 for Ethernet, zip, PNG, MPEG-2

- **Asked by the owner:** CRC-32 (Ethernet FCS) with every existing configuration unchanged.
- **Chosen:** `pbe_crc` is widened to 32 bits (register, polynomial, good value, value out); the
  width is 5 bits. Everything else is the same algorithm: a shift-left register fed in wire
  order, reversed output for LSB-first CRCs, init all ones, "ok" when the register equals the
  good value.
  - **Ethernet:** poly 0x04C11DB7, 32 bits, init all ones, reversed output, fed `OUT` (transmit)
    or `IN` (receive) bits; the FCS is the value inverted, bytes 0..3 low byte first
    (`OSRCRC B0..B3, INV`), which puts x^31 first on the wire as 802.3 clause 3.2.9 requires. A
    receiver feeds the FCS too and checks the residue: the register ends at 0xC704DD7B, which
    is 0xDEBB20E3 (the residue usually quoted, of the reflected algorithm) bit-reversed. The
    good value compares the raw register, as for USB's 0x800d (D41).
  - **Registers (no existing address moves):** in each engine's second page, +8/+9
    `CRC_POLY_2/3` (write: polynomial bits 23..16 and 31..24; read: the CRC value's bits 23..16
    and 31..24, as +9/+A read bits 15..0), +A/+B `CRC_GOOD_2/3`, +C `CRC_CFG2` [0] = width bit
    4. These offsets read 0 before. All reset 0.
  - **OSRCRC:** the byte is {param[3], param[0]}: `LO`/`HI` (param[3] = 0) are bytes 0 and 1 as
    before, `B2`/`B3` bytes 2 and 3. `LEFT` (left-justify to 16 bits, CAN, D71) applies to CRCs
    of up to 16 bits and does nothing for wider ones. param[3] was ignored before, and it still
    is for a CRC of up to 16 bits: every existing program has it 0 (the images are
    byte-identical), but the golden model's random programs set every EXT parameter bit, and a
    param[3] that picked byte 2 (zero) of a 16-bit CRC would change their results (`make diff`).
    Only a CRC wider than 16 bits, which needs `CRC_CFG2`, sees the new bytes.
- **Bit-identical for widths up to 16:** with `CRC_CFG2` = 0 and the upper polynomial and good
  bytes 0 (their reset values) the register's upper half stays 0 (the mask), and every output
  is what the 16-bit unit gave. `tb_crc` (c) runs 300 random 1-16-bit configurations (random
  polynomials, good values, init, reversal, init/step sequences) against a copy of the old unit
  (`test/ref_pbe_crc16.sv`), clock for clock, from reset. (A live width change without `CRCRST`
  keeps the register's state, as before; after a CRC wider than 16 bits that state can have
  upper bits, so switching an engine from CRC-32 to a narrower CRC needs a `CRCRST`, which
  every program does at the start of a packet anyway.)
- **General:** Ethernet FCS, zip/gzip and PNG (CRC-32), MPEG-2 transport streams
  (CRC-32/MPEG-2, sent MSB first, not inverted), iSCSI/ext4/SCTP (CRC-32C), POSIX `cksum`,
  plus every CRC of 17-31 bits (CRC-24 for OpenPGP and Bluetooth LE, CRC-17/21 of CAN FD).
- **Alternatives:**
  - *A byte-parallel CRC-32 (8 bits per clock):* the byte-mode feed already takes 8 clocks per
    byte, far inside the 48 clocks of a 10BASE-T byte; a parallel network would be several
    times larger and specific to one polynomial.
  - *A fixed CRC-32 block beside the 16-bit unit:* duplicates the shift register and loses
    the other 32-bit CRCs.
  - *Folding the width bit into CRC_CFG:* no free bit (all 8 are used).
- **Cost:** per engine 16 more bits of register, polynomial and good value, a wider mask,
  reversal and compare (`make synth` in D92).
- **Tests:** `tb_crc`: (a) the reveng catalogue check values for "123456789" of CRC-32
  (0xCBF43926), CRC-32/BZIP2, CRC-32/MPEG-2, CRC-32C and CRC-32/POSIX, all exact; (b) Ethernet
  frames of 60, 514 and 1514 random bytes: the unit's FCS equals a byte-wise reflected CRC-32
  (poly 0xEDB88320) written in the bench, the residue after the FCS is 0xC704DD7B, a flipped bit
  is caught; (c) bit-identity above. End to end with `OSRCRC B0..B3` in `tb_eth` (D93).

## D92. 60 MHz: 6 clocks per 10BASE-T bit (3 per half bit)

- **Asked by the owner:** the clock goes from 48 to 60 MHz, so a 10 Mbit/s Manchester half bit is
  exactly 3 clocks (D90). `info.yaml` `clock_hz` 60000000 and `src/config.json` `CLOCK_PERIOD`
  16.667 (those two keys only; the comment in `config.json` that still says 48 MHz is the
  owner's to change).
- **What depended on 48 MHz:**
  - **USB low speed** (1.5 Mbit/s): 40 clocks per bit (`CLKDIV` 39), was 32. The line coder
    needs a whole number of clocks per bit; 60 / 1.5 = 40 is one. `tb_usb`: turnaround 3.01 to
    3.15 bit times (2 to 7.5 allowed).
  - **WS2812** (`ws2812.pbe`): its pulses are delays in ticks of `CLKDIV` + 1 clocks. At 48 MHz
    a 2-clock tick was 41.7 ns; at 60 MHz 41.7 ns is 2.5 clocks. With a 33.3 ns tick (`CLKDIV` 1)
    and delays [11] [11] [11] (was [9] [9] [8]): 0 = 0.40 us high, 0.83 us low; 1 = 0.80 /
    0.43 us; byte boundaries 3 ticks longer (0.93 / 0.53 us): all inside the datasheet's
    ±150 ns. `tb_proto` checks every pulse.
  - **I2C target** (`i2c_target.pbe`): the 300 ns data hold after SCL falls was `[12]` plus the
    synchronizer at 48 MHz; at 60 MHz `[15]` (317 ns measured). The setup before releasing SCL,
    `[15]`, is 267 ns (333 at 48 MHz); the standard-mode minimum is 250 ns.
  - **I2C controller:** fast mode `CLKDIV` 21 (390 kHz; low 1.47 us >= 1.3), standard mode 85
    (was 17 and 68).
  - **CAN** (bit time = `CLKDIV` + 1): 479 / 239 / 119 / 59 for 125k / 250k / 500k / 1M (was 383 /
    191 / 95 / 47); `tb_can` computes them from the clock and passes.
  - **PS/2:** a 5 us tick is `CLKDIV` 299 (was 239).
  - **Host port:** SCK at most clk / 8 = 7.5 MHz: 0.94 MB/s single lane, 3.75 MB/s quad (D89).
  - Everything timed by `CLKDIV` alone scales by 1.25 (JTAG/SWD clocks up to 10 MHz, quad SPI
    20 MHz single write, logic analyser 5 MS/s at `CLKDIV` 1): the program headers, the README
    and `docs/info.md` give the 60 MHz figures.
- **Benches:** `CLK_NS` = 16.6672 in every top-level bench: `#(CLK_NS / 2)` rounds the half
  period to 8.334 ns, a 16.668 ns period, 0.01 % slow, as the 48 MHz benches were (20.834 ns);
  a period rounding fast made the 1-Wire 60 us slot 1.2 ns short (BUG-132). The cocotb test
  (`test/test.py`) runs at 16,668 ps (it needs an even number). Benches with 48 MHz numbers
  were fixed (BUG-132). All 13 top-level benches pass at 60 MHz, unchanged otherwise.
- **Timing** (`make timing`, logic only, IHP slow corner, no wires; the routed report is the
  real figure, D45):

  | | Worst logic path | Start |
  |---|---|---|
  | Before this work (D88) | 3.61 ns | |
  | Quad host port (D89) | 3.64 ns | |
  | Manchester, both-edge sampling (D90) | 4.80 ns | `pin_base` -> receive-pin mux -> the Manchester edge compare |
  | CRC-32 (D91) | 4.55 ns | `pin_base` (the same class; ABC's result moves by ~0.2 ns run to run) |

  The last routed run had 6.81 ns of setup slack at 48 MHz (20.83 ns), a worst path of about
  14.0 ns. At 60 MHz (16.67 ns) that path leaves about 2.6 ns; the logic estimate grew by
  about 1.2 ns since, so the expected slack is about 1.4 ns, to be confirmed by the next
  routed (`gds`) run, which this work did not run (the owner's instruction).
- **Area** (`make synth`, IHP typical, standard cells only; the SRAM macros are extra):

  | | Area | Change |
  |---|---|---|
  | Before this work | 199,555 µm² | |
  | + quad host port (D89) | 201,711 µm² | +2,156 |
  | + Manchester and both-edge sampling (D90) | 220,700 µm² | +18,989 |
  | + CRC-32 (D91) | 234,907 µm² | +14,207 |

  In all +35,352 µm² (+17.7 %). 60 MHz itself adds nothing to the RTL (the programs and benches
  changed). If the routed slack comes out short, the new worst path can be cut by registering
  the receive pin's selection (`rx_pin`, `rx_pin_e`): one clock more latency for every coder,
  which tolerates it (the synchronizers already add two).
- **Alternatives:** 50 MHz (5 clocks a bit, a 2.5-clock half bit: no) or 80 MHz (8 clocks a bit:
  more receive margin, but about 12.5 ns, under the routed worst path).

## D93. 10BASE-T: eth_tx.pbe and eth_rx.pbe, streamed by the quad host port

- **Asked by the owner:** full 10BASE-T, transmit and receive (the brief's stretch goal), on the
  general hardware of D89-D92: engine 0 transmits, engine 1 receives (full duplex).
- **Transmit, `programs/eth_tx.pbe` (52 words, one page):** pair mode, TD+ = pin base, TD- =
  pin base + 1, Manchester, bytes, `CLKDIV` 5 (6 clocks a bit at 60 MHz).
  - **Host records:** a frame is chunks `[n][n bytes]` (n = 1..255) and `[0]`, so a frame of any
    length streams through the 16-byte FIFO with an 8-bit counter (X); the engine adds the
    preamble (7 x 0x55) and SFD (0xD5, `OUT, NOCRC`), and the FCS (`OSRCRC B0..B3, INV`, D91).
    The first chunk's length starts the frame; the 8 preamble bytes (6.4 us) give the host time
    to queue more. *Alternative:* a 16-bit length prefix: the engine has one 8-bit counter.
  - **Per byte:** `PULL`, `OUT` (the coder takes it at its first bit), the CRC feed (8 clocks),
    the loop jump: about 11 of the 48 clocks a byte lasts.
  - **End:** `END` twice: the second returns when the coder takes the first, at the end of the
    last bit, so the inter-frame gap is timed from the right place: 36 x 17 clocks (10.2 us)
    plus the coder's 2-bit gap before the next frame. Measured (the model): 10.68 us between
    back-to-back frames (802.3: at least 9.6 us). TP_IDL is the coder's (D90): measured 300 ns
    after a final 0, 350 ns after a final 1.
  - **Link pulses:** while idle the `PULL` for the next frame times out every 1 ms (`TIMEOUT`
    60000 clocks; the timeout vector counts 16 of them in X), then a 100 ns pulse (TD+ high, by
    the pin unit under the idle coder), then the same 10.2 us gap as after a frame. Measured
    16.0 ms apart (802.3 clause 14.2.1.1: 16 +- 8 ms). The first one comes 16 ms after the start,
    not at once (BUG-133).
  - **Status:** one byte per frame in engine 0's RX FIFO (`STAT`): bit 4 = the coder ran out of
    data (an underrun: the frame on the wire is corrupt), bit 2 = the FIFO stayed empty for 1 ms
    inside the frame (the engine ended it at once: the timeout vector sees FLAG0 "in a frame").
    `STAT` at the start of each frame clears the idle loop's timeouts (BUG-134).
- **Receive, `programs/eth_rx.pbe` (17 words):** RD = pin base (the receive comparator's output),
  Manchester, bytes, `SYNC` 0xD5: the coder finds the SFD, recovers the clock and ends the
  frame with the carrier (D90); link pulses never reach the program.
  - **Records:** the bytes (the FCS included), a data 0x7E twice, and `[0x7E][status]` at the
    end, as `hdlc_rx` (D88): a frame does not fit the FIFO, so its length cannot come first.
    Status (`STAT`): 0x02 = FCS ok (the CRC unit fed with every byte, the FCS too, at its residue
    0xC704DD7B, D91); bit 4 = line error (a byte the engine could not take in time), bit 3 = a
    `PUSH` found the RX FIFO full. Per byte: `IN`, `JLINE`, `JNE`, `PUSH`, `JMP`: about 14 clocks
    with the CRC feed.
  - **Parity off** (`LINE_CFG[6]`), or `STAT` bit 0 is a meaningless parity of the frame.
- **Host rate:** a frame needs 1.25 MB/s with no pause longer than the FIFO covers (16 bytes,
  12.8 us). In `tb_eth` the host runs the quad port at SCK = clk / 8 (3.75 MB/s): it writes up
  to 12 bytes per burst, pausing (ending the burst) while the TX-full pin is high, and reads
  each RX FIFO by `RX_COUNT` and a burst read; transmit, receive and both at once (the loopback,
  full duplex through one port) run with no underrun or overrun.
- **Not done (limits):**
  - *No CSMA/CD:* the transmitter does not defer to a carrier or detect collisions, so the link
    partner must be full duplex. A switch port that sees only link pulses (no auto-negotiation)
    falls back to 10 Mbit/s half duplex by parallel detection and may then collide with the
    chip: the port must be set to 10 Mbit/s full duplex. (A program could defer to engine 1's
    carrier through a flag; collision detection needs the transmitter to watch the receive pin.)
  - *No auto-negotiation (fast link pulses)* and no link-integrity state machine (link fail after
    50-150 ms without pulses): the host can watch the received frames; the coder ignores link
    pulses by design.
  - *No polarity correction* on receive (a reversed pair inverts every bit: the SFD is never
    found); *no jabber* control (the host bounds frame length); dribble bits after the last
    whole byte are dropped.
- **Who else benefits:** the record formats are the HDLC ones; Manchester and CRC-32 serve the
  other users listed in D90 and D91.
- **Tests:** `tb_eth` against `eth_model.sv`, a link partner written from IEEE 802.3 (its own
  Manchester decoder by mid-bit windows, CRC-32 byte-wise reflected, preamble/SFD, bit timing
  100 +- 1 ns, TP_IDL 200-450 ns, gap >= 9.6 us, link pulses 60-200 ns wide and 8-24 ms apart);
  19 checks: transmit 64/512/1518-byte frames back to back with their status bytes; receive the
  same sizes, a bad FCS, +-100 ppm, +1000 ppm and -5000 ppm with jitter, three frames 9.6 us
  apart; the loopback engine 0 -> engine 1 with the host streaming both at once; link pulses
  while idle and the model's link pulses into engine 1 (no record); a 30 us host underrun (status
  bit 4), a 1.2 ms one (the engine aborts: bit 2), and an RX overrun (bits 3 and 4).

## D94. pbe_line stuffing control and flag-delimited frames: HDLC in NRZI (item 6a); multi-pin IN/OUT not done (6b)

- **Asked by the owner** (from D88): the minimal general hardware for HDLC with NRZI.
- **Chosen, in `pbe_line`:**
  1. **`LINECTL STUFFOFF` / `STUFFON`** (EXT sub-op 7, param[4] = 1, [0] off, [1] on; the same
     encoding as the bit-synchronous coder's, D67). Each queued unit carries the stuffing state
     current when it was queued (`q_ns`, then `tns` with the shift register), so a program sends
     `STUFFOFF`, a flag 0x7E as an ordinary byte or 8 bits, `STUFFON`, and the flag goes out
     unstuffed inside the same coder frame as the data around it: the NRZI level is continuous
     and the bits already queued keep their own state. The SYNC byte is always stuffed. Reset,
     clear (coder off, restart): stuffing on. The width and arbitration controls stay
     bit-synchronous only. *Alternative:* a mode bit in `LINE`: it would apply to the bits in
     the queue at the moment of the write, not to a chosen unit.
  2. **`LINE[6]`, flag-delimited frames** (the reserved bit; ignored in Manchester): a stuffing
     violation ends the frame at either line level (not only at the idle high level, BUG-033's
     rule), and the receiver does not go idle: the run count restarts and the bit after the
     violation is the first bit of the next frame (a flag's last 0, or an abort's 7th 1). The
     "8 idle bit times" end is off in this mode. With `LINE[6]` = 0 everything is as before.
  - *Not done:* the receive flag pattern (a raw-bit SYNC compare, to deliver aligned bytes):
    with continuous reception the program finds the alignment itself at no cost (it reads the
    bit after each frame end), so the pattern compare was not needed.
- **Programs (rewritten, one pair for both codings):**
  - `hdlc_tx.pbe` (41 words, was 41): flags between `STUFFOFF` and `STUFFON`; NRZ `LINE` 0x09,
    NRZI 0x0A. Between frames it sends flags (interframe time fill) instead of letting go of the
    line: letting go hands the line to the pin unit at a level that in NRZI depends on the data,
    and the engine's own receiver then reported overruns (the BUG-123 effect, which a trailing 1
    cured only in NRZ). Before the first frame the line idles high (mark).
  - `hdlc_rx.pbe` (43 words, was 38): `LINE` 0x49 / 0x4A. At a frame end it reads the next bit: 0
    is a flag (the next frame starts), 1 an abort. D88's RXD poll (and its `d` byte in the TX
    FIFO) is gone; it also removes D88's 10 kbit/s lower limit for abort detection. The records
    and the `CRC_GOOD` 0xD0F9 are unchanged (each segment is still the frame and the closing
    flag's 0 1 1 1 1 1).
- **Tests:** `tb_line` H (unit, both codings): flags and an abort sent with `LINECTL` inside one
  coder frame, received with `LINE[6]`: the frame ends where expected, the data bits exact, the
  bit after an abort's sixth 1 is a 1. `tb_hdlc`: the D88 phases (transmit at 1.25, 2.5 and
  5 Mbit/s, receive at 1.25 and 2.5 Mbit/s with shared flags, a CRC error, aborts followed by
  idle and by a flag, 64-byte frames) in NRZ and again in NRZI, against `hdlc_model.sv`, now
  NRZI-capable (0 = a transition): 9/9. The model saw 914 flags and no abort from the chip.
- **Cost:** three flip-flops and a few gates per engine.
- **6b, multi-pin IN/OUT (optional): not done.** Free encoding bits exist (`IN` ARG[4:0] and
  `PIN` ARG[2:1] are always 0 today, and the golden model's random programs never set them), and
  sampling or driving 4 pins in one clock is small in the engine. It was left out because what
  it is for is not small: the logic analyser (`la_capture.pbe`) and the quad SPI program
  (`qspi_flash.pbe`) would be rewritten around it with their benches (`tb_la`'s skew checks,
  `tb_qspi`'s timing), the CRC and parity rules for a multi-bit `IN`/`OUT` need defining, and
  the golden model and formal engine properties would need the new semantics before `make diff`
  could exercise it. It belongs in a session of its own.

## D95. Ethernet verification: preserve the default contract, then extend independent checks

- **Chosen:** work from D94 on `verify/ethernet`, in the seven ordered stages of
  `ETHERNET_VERIFICATION_TODO.md`. Keep source RTL and old evidence unchanged. New receipts
  belong under `verify/golden-model/evidence/round3/`; fresh generated work stays in build/.
- **Default stage:** tie quad inputs low in a wrapper, connect early samples to ordinary
  samples in non-Manchester harnesses, disable LINECTL, and zero-extend narrow CRC inputs.
  Include the reset-derived single-lane invariant in induction rather than assuming internal
  state. The historical equivalence comparison excludes newly assigned LINE mode 3, LINE[6]
  and non-bit-synchronous LINECTL action encodings: those are new features, tested separately.
  Preserve every old assertion, counterexample, depth and expected status otherwise.
- **D82 compatibility:** standalone launchers must include the actual FUNCTIONAL SRAM models,
  not silently select the FF fallback. The external bus loader uses the current assembler's
  three return values and each engine's own SRAM, retaining caller-specified start offsets.
  Bus baud calculations derive from 16668 ps (60 MHz rounded to an even ps, as required).
- **Mutations:** re-anchor old faults to their current semantic sites; retain one replacement
  per mutant and reject source drift. A compile error or timeout is inconclusive, never a kill.
- **Alternatives rejected:** changing RTL to fit stale checkers; constraining away a new mode
  in its own tests; replacing recorded evidence; counting BMC/cover as inductive proof;
  selecting the FF implementation just to avoid supplying the SRAM model.
- **Tools:** OSS CAD Suite 2026-07-27: Verilator 5.051 devel (v5.050-99-gf8fb1d664),
  Yosys 0.67+94 (7defa5186), bundled SBY/Yices. Debian Icarus/vvp 12.0 precede the suite
  for simulation and `make test`; stock sigrok-cli 0.7.2/libsigrokdecode 0.5.3.
  Python 3.12 with cocotb 2.0.1 and the pinned per-target requirements. Version probes and
  command receipts distinguish this environment from historical Python runtimes.
- **Boundary:** no GDS or gate-level workflow, analog/electrical compliance or routed timing
  claim. Existing default results and new-feature outcomes must be reported separately.
- Mutation output defaults to ignored `pbe_v1/build/mutations`, preventing `make mutate`
  from overwriting the historical round-2 receipts. Selected round-3 receipts are copied
  explicitly after the campaign, as with other generated build artifacts.
- Raise only the line SBY wall-time budget from 120 to 1200 seconds on the shared two-CPU
  runner. Retain depth 164/48 and all properties/assumptions; do not trade proof depth for
  runtime. Resume with one solver job and source/configuration-validated collection.

## D96. D89–D94 executable reference and opt-in differential profile

- **Chosen:** extend the existing Python reference from D89–D94 and public source-header
  specification text. Retain the queue-of-bits representation and represent Manchester's
  reference as an integer age in eighth clocks, not an RTL shifter or a copy of its code.
  CRC remains the polynomial-remainder bit algorithm; D91 supplies the wider mask and
  OSRCRC byte rules. Host parsing uses a lane stride and request latched at idle.
- Add architectural examples for quad framing/latching/recovery, both engines' wide registers,
  and CRC-32/ISO-HDLC's independent check value. Run examples before implementing support;
  retain failing and passing transcripts. Their scope is conformance, not a proof.
- `make diff ETHERNET=1` opts into quad mode changes, idle-SCK recovery and wide CRC settings.
  Keep the default seeded schedule and RNG draws intact. Compare against an isolated checkout
  of 3cca934: two default seeds/600 iterations produce the same 50,663 clocks and counters.
  Historical 49,010-clock reports predate PAGE/SRAM/current test setup; do not rewrite them.
- Model unknown host outputs per lane. Require four-state unknowns exactly where FIFO head
  data is unspecified; do not silently zero unknown known-data bits. The two-state exception
  remains limited to those model-marked lanes.
- Add a separate seeded per-clock D90/D94 line campaign; keep the old 160-configuration,
  80,160-clock sweep independently runnable. Diagnostic RTL state may explain a mismatch;
  it never feeds predictions. Any implementation-informed timing clarification must be
  recorded as a shared cycle contract, not claimed as an independent architectural proof.
- **Alternatives rejected:** changing the old default generator to force new modes; masking
  all quad output lanes on reads; inferring the expected mode/data from the DUT; copying RTL
  into the model. Preserve old receipts and separate old-profile/new-profile coverage.
- **Workflow update from owner:** complete all stages locally; defer all pushes until the end.
  Repository write access does not block implementation or validation.

## D97. Enforce Manchester's documented LINE2 idle-wait exception

- The minimal two-coder test establishes BUG-145 independently of the golden model.
- **Chosen small repair:** make `idle_wait = cfg2[6] && !manch`. Preserve the existing
  qualification and timing in modes 0–2. Keep Manchester's loop, coding, clock and TP_IDL
  behavior unchanged. Apply after the baseline campaigns have retained their original
  source provenance; rerun the regression gates on the repaired source.
- **Alternative:** document Manchester+LINE2[6] as unsupported. Rejected because the public
  D90 contract already says the setting is ignored, and one mode guard expresses it exactly.
- Fixing this RTL bug is within the owner's explicit minimal-test/small-clear-fix exception.

## D98. Ethernet formal scope, observer strengthening, and exact fast regressions

- The new `ethernet` formal block separates unbounded k-induction (quad/single host framing,
  pre-D89 single-lane equivalence, coefficient-reference CRC widths 17–32, and pre-D91 narrow
  equivalence) from bounded Manchester/HDLC checks and nonvacuity covers.
- Keep the existing host's legal synchronized mode-0 timing assumptions (SCK phases >=4
  clocks and CS setup). The equivalence comparison itself allows arbitrary pin timing and
  arbitrary extra MOSI lanes, with quad disabled. Request changes are unconstrained; the mode
  latch and eight-idle-SCK counter are checked independently of the DUT's state.
- Prove parser stride alignment as an invariant, never assume an unreachable quad bit index
  away. Export common host/CRC state only to strengthen sequential equivalence. Observers do
  not drive the design; source-aware receipts retain the generated inputs and expected modes.
- CRC reference reset must be asynchronous, matching the documented primitive interface.
  Narrow equivalence includes live width changes and the entire raw state, not only a
  potentially truncated/reversed output. Do not claim an induction failure is an RTL bug.
- Manchester's bounded harness uses two preamble bytes, SFD, and an arbitrary payload. It
  checks the IEEE first/second halves independently on the TX wire, the 3-bit TP_IDL tail,
  recovered data and a completion deadline; the paired coding cannot cancel a polarity bug
  silently. Jitter/clock offsets are simulation stress, not claimed formal proofs.
- Add exact external-interface timeout/parity regressions early in the normal gate. They
  retain all old checks and preserve the random profile's seeded schedule, while preventing
  long protocol scenarios from being the first detector of simple M19/M23 faults.
- Alternative rejected: weakening properties/depths, calling UNKNOWN a proof, asserting
  partial output equivalence without the stored-state relation, or counting a timed-out
  mutation check as detection. Actual bounds and any pilot counterexamples are reported.

## D99. Independent wire vectors and standards-based digital stress

- **Chosen:** Scapy 2.8.0 supplies Ethernet frame bytes; Python binascii/zlib CRC-32 supplies
  FCS independently of the PBE model. A stateless IEEE-half-cell decoder checks captured
  public TX pins, preamble/SFD, LSB bit order, all FCS bits, TP_IDL and minimum IFG. Save
  actual decoded packets as pcap plus FCS/timing sidecars. An independent flag/zero-deletion
  parser and crccheck 1.3.1 CRC-16/IBM-SDLC check HDLC NRZI frames.
- Cover 60–1514-byte Ethernet frames, boundary sizes and larger frames. A 32,640-byte jumbo
  uses every nonzero chunk length 1–255 once. Test empty TX input, escape density, corrupted
  FCS, runts, dribble bits and quiet link/noise events through actual host-visible records.
- Extend RevEng checks to all 24 primary catalogue entries of widths 17–32. Twenty have
  native zero/all-ones initialization; four non-native 24-bit seeds use explicit host-fed
  prefixes solved with the external library's GF(2) map. Report those as prefeed-assisted,
  never as an arbitrary-seed register. Preserve all old narrow counts and random draws.
- IEEE 802.3-2012 clauses 3.2.9, 4.4.2 and 14 define FCS, IFG and link timing. Section One,
  14.3.1.3.1 (printed p346) requires ±13.5 ns relative to **each ideal zero crossing**;
  adjacent intervals can vary by twice that amount. Primary text inspected at the mirror
  https://www.my-wire.de/schnittstellenbeschreibung/ethernet.pdf; no copyrighted PDF is
  added to the repository. The independent encoder perturbs actual edges, never every
  half-cell slot irrespective of whether an edge exists.
- Test uniform, alternating-extreme and spacing-dependent jitter, ±100 ppm and larger
  offsets, exact 9.6-us back-to-back receive, clk/8 host phase sweeps, starvation/timeout,
  overflow and recovery. Save delivery separately from error-reporting success. Worst-case
  escaped receive plus transmit consumes the raw host bandwidth before command overhead;
  a detected overflow is an architectural throughput limit, not successful delivery.
- The spacing-dependent stimulus is a digital ISI proxy. Analog thresholds, squelch,
  impedance, cable transfer, metastability, routed half-cycle setup/hold and physical
  compliance remain unverified. No GDS or gate-level workflow is permitted or invoked.
- **Alternatives rejected:** using the golden model as an external frame oracle; rounding
  13.3344 ns up to the standard's 13.5 ns; retuning RTL merely to pass a few seeds; calling
  a bad-CRC record delivery success; hiding unrestricted PAGE counterexamples in a narrowed
  default proof. Unbounded legacy line equivalence covers all LINE2 values in modes 0–2;
  the full-PC D88 engine comparison is distinct from the historical pre-CAN domain.
- **Tools:** OSS CAD Suite 2026-07-27, Verilator 5.051, Yosys 0.67+94, bundled SBY/Yices;
  Icarus/vvp 12.0 for four-state simulation; Python 3.12.4/cocotb 2.0.1. Stock sigrok versions
  and all existing pinned bus/protocol libraries remain as D95. Compiler output grouping
  is disabled to fit the two-CPU/eight-GiB runner without dropping instrumentation/assertions.

## D100. Coverage closure, mutation sensitivity and volatile read timing

- Default instrumentation remains 140 bins. Opt-in D89–D94 instrumentation adds 79 bins
  for host framing/latch/recovery, every wide width, reflection/init/comparison, OSRCRC
  byte selection, Manchester period/polarity/early samples/carrier behavior and D94 tags.
  Keep the old and new line sweeps in separate data files. Directed public-interface
  programs close simultaneous STUFFOFF/ON and Manchester idle-wait bins. Structural holes
  and boundaries not represented by these bins remain explicitly listed in the report;
  219/219 named events is not exhaustive configuration, analog or path coverage.
- Preserve every mutant's single source site, frozen input manifest, command, assertion
  reason and separate outcome. Original timeout/survivor/compile outcomes remain evidence.
  A new continuous-one-run test detects E10's run-reset fault after the random test survives.
  Program mutants replace the second END, frame-start STAT or extra escape PUSH with NOP,
  avoiding incidental changes to X. Completion status must follow the last FCS bit: this
  tests the documented second-END barrier, which payload/FCS-only checking can miss.
- Stopped engines do not stop their line coder. Compare volatile host readback against the
  model at actual sample time, preserving per-clock pin checks and explicit directed values;
  do not assume a pre-command STATUS snapshot is stable through a transaction. Global-index
  replay and progress receipts preserve the seeded schedule and identify any aborted run.
- Distinguish unbounded equivalence/induction, bounded checks, nonvacuity covers, deliberate
  historical counterexamples and incomplete proof attempts. The optional broad structural
  engine-equivalence pilot leaves 35 cells unproved; it supplies no proof claim. The D88
  full-PC engine miter instead has a successful bounded depth-eight result. A separate
  repair-only unbounded line comparison admits all LINE2 values and D94 controls in modes
  0–2, establishing preservation of the one-line Manchester guard repair.
- All work stays on verify/ethernet. The owner's updated workflow defers pushes until the
  complete local verification and report are ready; no stage pushes, merges or prohibited
  physical/gate-level workflows are part of this campaign.
- Final acceptance requires all 219 named bins: the exploratory `--partial` summarization
  is removed from the normal extended recipe after gap closure. The quad formal observer
  explicitly checks Q3..Q1 as well as Q0; full internal word equality alone is not substituted
  for checking the externally specified lane mapping (BUG-160).
