ayushyadavnvs/jane_street/docs/BUG_LOG.md

# Bug log

Every bug found in the design, the tests or the tools: what was wrong (with the code before),
how it was found, the fix (with the code after), and the test that now guards it.

Keep this file current: add an entry for every bug, including test and tool bugs, and never
delete an entry. Where possible, a bug gets a test that fails before the fix and passes
after it.

v2 (USB) has been retired (design decision D28). Its entries stay here; the v2 code they refer
to is on the branch `archive/v2-usb`, and `docs/USB_NOTES.md` summarizes them.

| ID | Area | Summary | Found by | Status |
|---|---|---|---|---|
| BUG-001 | Testbench | Two host transactions ran at once on the single host port | First UART run | Fixed |
| BUG-002 | Testbench | SPI peripheral model fetched its reply byte twice | First SPI run | Fixed |
| BUG-003 | Testbench | I2C START handshake deadlock between testbench and program | First I2C run | Fixed |
| BUG-004 | Testbench | Clock-stretching test passed even with stretching support removed | Mutation check | Fixed |
| BUG-005 | Tooling | Output filter hid a failed compile; a stale simulation ran | USB bring-up | Fixed |
| BUG-006 | Tooling | Icarus Verilog syntax limits and runtime crashes in USB helpers | USB bring-up | Fixed |
| BUG-007 | Testbench | A failing simulation exits with code 0 (`make test` "succeeds") | AI review #1 | Fixed |
| BUG-008 | Assembler (v2) | `NOP` assembles to the same word as `UTX` | AI review #2 | Fixed |
| BUG-009 | RTL (v2 USB) | Receiver drops stuffed bits without checking they are 0 | AI review #4 | Fixed |
| BUG-010 | Program (I2C) | SCL low time shorter than high time; violates I2C minimum low time | Speed analysis | Fixed |
| BUG-011 | Program (I2C) | STOP flag cleared before STOP finishes | AI review #5 | Fixed |
| BUG-012 | RTL (engine) | Restart does not cancel the current instruction's side effects | AI review #3 | Fixed |
| BUG-013 | RTL (engine) | Restart cleared pin output values: a line held high could glitch low | Modbus test (glitch monitor) | Fixed |
| BUG-014 | Testbench | Modbus device model took a zero-width glitch for a start bit | Modbus test bring-up | Fixed |
| BUG-015 | Program (Modbus) | Receiver polled for the next start bit inside the parity bit | Modbus test bring-up | Fixed |
| BUG-016 | Testbench | A counter shared with a static task was overwritten | Modbus test bring-up | Fixed |
| BUG-017 | RTL (top) | Shared flags: two flag-using protocols on the two engines consumed each other's flags | Design review (D27) | Fixed |
| BUG-018 | Testbench | Host-port lock was unfair; one host process starved the other | Two-protocol test bring-up | Fixed |
| BUG-019 | Program (Modbus) / RTL | Rewriting Modbus for `OUTPAR` dropped 8N2 support | Completeness review | Fixed |
| BUG-020 | Testbench | Tests ran at 50 MHz, not the planned 48 MHz | Completeness review | Fixed |
| BUG-021 | Testbench | `strong` is a reserved word; the 200 ms time limit looked like a hang | Bring-up of this round | Fixed |
| BUG-022 | Program (I2C) | ACK bits fed the CRC, so the SMBus PEC came out wrong | Test 7, written first | Fixed |
| BUG-023 | Testbench | Variable initializers inside procedural blocks run once, at time 0 | Icarus warning hidden by a filter; a false failure | Fixed, lint step |
| BUG-024 | Tooling | Icarus 12 aborts on a too-wide `push_back` and on a bit-select as an `output` argument | Bring-up of `tb_proto` | Worked around |
| BUG-025 | Testbench | I2C controller model never sent a repeated START | First Test 10 run | Fixed |
| BUG-026 | Testbench | SPI peripheral test never had an empty TX FIFO at CS fall | Mutation check | Fixed |
| BUG-027 | Testbench | Stimulus read a DUT output in the same time step it changed (tb_line, tb_engine_ops) | First unit-test runs | Fixed |
| BUG-028 | RTL (line coder) | A byte left unread when its frame ended was taken as the next frame's first byte | Test 11 (USB), trace | Fixed |
| BUG-029 | Testbench | The USB host model overwrote the OUT payload with the SETUP request | Test 11, FIFO trace | Fixed |
| BUG-030 | RTL (host port) | A burst read of an RX FIFO could lose a byte arriving during the burst | Review of the read pipeline | Fixed (RX_COUNT) |
| BUG-031 | Firmware flow | Flushing both FIFOs on SETUP dropped the OUT record arriving behind it | Test 11, FIFO trace | Fixed (TX_FLUSH) |
| BUG-032 | Design (USB records) | Records that piled up in the RX FIFO could not be told apart | Test 11, firmware trace | Fixed |
| BUG-033 | RTL (line coder) | Without SE0, the idle line after a frame was reported as a stuffing error | tb_line, written first | Fixed |
| BUG-034 | Testbench | A pile-up test that overflowed the 16-byte RX FIFO | Full suite | Fixed |
| BUG-035 | Tooling | More Icarus 12 limits: queue arguments, `return` in tasks, array ports, and others | Bring-up of tb_line, tb_usb | Worked around |
| BUG-036 | CI | The gate-level regression job looked for the netlist one folder too deep | First CI run | Fixed |
| BUG-037 | Testbench / CI | The gate-level regression failed early; with Icarus 13, tb_pbe used a variable before its declaration | Second and third CI runs | Fixed |
| BUG-043 | Design (D50 draft) | A bubble after every instruction broke the SPI peripheral at 2 MHz | Timing review of the draft; Test 9 on it | Fixed (prefetch) |
| BUG-044 | Tooling | Yosys merged the copies of the read address back into one register, `keep` on the variable notwithstanding | Flip-flop count after synthesis | Fixed |
| BUG-045 | Tooling | Verilator 5.020 rejects a default value on a module input, which the unit testbenches needed for `pm_wr` | Lint before the first run | Worked around |
| BUG-074 | Design (D62 prototype) | With the SRAM, one refetch after a host write took the macro's stale output | Timing review; `tb_fetch` (a) as a mutation | Fixed (second refetch) |
| BUG-077 | Tooling | Icarus 12 `$isunknown` gave a wrong answer on a wide all-known concatenation in `tb_engine_known_reset` | Extending the bench to the CAN outputs | Worked around (split check) |
| BUG-078 | Tooling | Icarus 12 aborts on a queue `push_back` of a wider value and on a variable declared inside a loop body in an automatic task | Writing `tb_line` E | Worked around |
| BUG-079 | Verification | New FIFO mark/rewind formal property compared a pointer difference with a 32-bit constant, so it went negative when the pointers wrapped | First `fifo_mark` run (induction and depth-40 BMC fail) | Fixed |
| BUG-080 | Design (D68, before commit) | The CAN error flag took its type from the counter after the error's own increment, so the error that reached TEC 128 sent a passive flag | Writing the reference node from ISO 11898-1 | Fixed |
| BUG-081 | Testbench (before commit) | `tb_line` D1 expected the sample at `P/2+1`; the rule is `floor((P-1)/2)+1` | First run of `tb_line` D | Fixed |
| BUG-082 | Testbench (before commit) | The reference CAN node's resync on a late edge within SJW started a new bit instead of lengthening the current one | `tb_can` ref->chip: the reference missed every ACK | Fixed |
| BUG-083 | Design (D66, before commit) | A stopped engine's CAN coder still acknowledged frames and sent CRC error flags | `tb_can` ACK scenario: TEC passed 128 | Fixed |
| BUG-084 | Design (D66, before commit) | After an error, the next frame started from the leftover bits of the abandoned unit | `tb_can` bit-error scenario: retransmitted ID 0x20F for 0x0FF | Fixed |
| BUG-085 | Program (can_node, before commit) | `done` compared the status after PUSH had cleared ISR, then (fixed) only 0x82: sent frames were resent forever | `tb_can` first run | Fixed |
| BUG-086 | Testbench (before commit) | The host model read engine 1's RX_COUNT after a long read of engine 0, so engine 1's next record leaked in | `tb_can` two-engine arbitration | Fixed |
| BUG-087 | Tooling | `make synth` read its own hard-coded source list, without `pbe_bsync.sv` | Parent-session review of step 1 | Fixed (list generated from `SRC`) |
| BUG-088 | Design (timing) | The new sample-point adders sat on the bit counter's compare path: logic-only worst path 3.39 → 5.00 ns | Parent-session review of step 1 (`make timing`) | Fixed (registered: 3.69 ns) |
| BUG-089 | Design (D66) | The CAN coder resynchronized on every falling edge, so edges every two clocks could postpone the next bit (and an error flag) forever | New formal block `bsync`, F2 | Fixed (one sync between sample points) |
| BUG-090 | Testbench | `tb_can` sent ID 0x7F6, which CAN 2.0A forbids (7 MSBs recessive); sigrok's decoder rejected it and lost sync | `make sigrok-can` | Fixed |
| BUG-091 | Verification (before commit) | `test_bsync_cocotb` checked the error flag's start against the transmitter's bit grid without the clock-error drift | First 40-trial `make diff-can` | Fixed |
| BUG-092 | Design (D72, D69) | `can_node` flagged an error on every valid extended (CAN 2.0B) frame and every standard frame with r0 recessive | Parent-session review | Fixed (frame follower, D74) |
| BUG-102 | Testbench | `tb_line` E4 measured the bit-error flag 53 clocks after the bad bit under Icarus, 54 under Verilator 5.020 and 55 (a failure) under 5.051: same-edge races in the testbench, not the RTL | `make coverage` under Verilator 5.051 | Fixed, `make test-verilator` in CI |
| BUG-103 | Tooling | Verilator 5.020 (Ubuntu 24.04, the CI's) keeps an automatic task's local queue between calls, and loses a queue pop after a delay in an `always` block | Running the benches under Verilator 5.020 (BUG-102) | Worked around (`tb_line`), `tb_engine_ops` and `tb_proto` left to 5.05x |
| BUG-104 | RTL (`pbe_bsync`, `pbe_line`) | The registered sample count reset to 0: on the first clock after reset the coder sampled at once, not at the sample point | Race-free reset release in `tb_engine_ops` (BUG-102 audit) | Fixed (`tb_line` E0) |
| BUG-105 | Testbench | `tb_line` E2 said it tested the late join, but queued its unit before the hard synchronization; the late join was never exercised | `make coverage`: bin `bsync_late_join` 0 | Fixed (new E2b) |
| BUG-106 | Tooling | `make coverage` left out `tb_debug` (and its program image), so the JTAG and SWD programs were not in the campaign | Comparing the coverage files with `make test` | Fixed |
| BUG-107 | Tooling / testbench | Icarus 12 cannot pass a queue literal (`'{...}`) as a task argument (vvp segfaults) or initialise an unpacked array from one (elaboration fails) | Writing `tb_fetch` (d)-(h) (D82) | Worked around (fixed byte arguments, a `case` function) |
| BUG-108 | Testbench | `tb_fetch` (g): the second run started with pin 0 high, so the program's first `DRV0` added an edge and every gap after it was compared with the wrong pass position | First run of (g) | Fixed |
| BUG-109 | Testbench | `tb_fetch` (g) expected one longer gap per word written, but a word is two `PM_DATA` byte writes, each with its own two refetches | First run of (g) | Fixed |
| BUG-110 | Flow (D62, `sram/flow.patch`) | The SRAM flow patch powered the macros only by aligning the PDN stripes with their columns; it lacked the step that extends the stripes onto the macros' Metal4 supply columns, so the macros could have been left unpowered | Owner's review against Tiny Tapeout's SRAM example | Retired (`sram/` deleted; D82, `docs/SRAM_8x4_FLOW_STEPS.md`) |
| BUG-111 | RTL (`PBE_PMEM_FF` fallback) | The 64-word fallback took write addresses mod 64, so loading a whole 256-word image overwrote each engine's program with the image's upper (zero) words | `make test-ff` (`tb_usb`) | Fixed (writes to words 64-255 dropped) |
| BUG-112 | Testbench | `tb_page` (d) declared `int bad = 0;` inside a procedural block: a static variable initialised once (BUG-023's pattern), which `make test`'s lint rejects | Icarus warning on the first run of `tb_page` | Fixed |
| BUG-113 | Testbench | `tb_page` (a) did not check that a timeout clears a pending `PAGE`: a timeout that kept it passed | Running `tb_page` against that fault (D83) | Fixed (a `PAGE` before the timed-out `WAIT`, a jump first in the vector) |
| BUG-125 | Testbench | `tb_pbe` checked the Modbus IRQ pin inside the tick between `FLAG 2, SET` and `IRQ`; only a fast (quad) host landed there | `tb_pbe +QUAD` (D89) | Fixed (bounded wait for the pin) |
| BUG-126 | Testbench | `host_quad_on`'s dummy transaction wrote `HOSTCFG` = 0 just after switching to quad | `tb_quad` (b) | Fixed (a read) |
| BUG-127 | Tooling | Icarus 12: `return` in tasks, queue arguments and bit selects of queue elements, real arrays in automatic tasks | `tb_quad`, `tb_line` M | Worked around |
| BUG-128 | RTL (line coder) | The Manchester bit timer moved its reference 3/4 of each edge's error instead of 1/4 | `tb_line` M7 (D90) | Fixed before commit |
| BUG-129 | RTL (line coder) | The Manchester bit timer lost half a clock after an edge seen at the falling clock edge | `tb_line` M4, M6 (D90) | Fixed before commit |
| BUG-130 | Testbench | `tb_crc` (c) compared the CRC units with 32-bit state left over from (b) | `tb_crc` (D91) | Fixed (reset first) |
| BUG-131 | Testbench, Tooling | The engine unit benches left `crc_wide` unconnected (unknown CRC width); Icarus misreported `$isunknown` on a concatenation | The gate before pushing D91 | Fixed |
| BUG-132 | Testbench | Benches with 48 MHz constants (USB 32 clocks a bit, a 146 ns SCK check, I2C `CLKDIV` 17, a simulated period rounding fast) failed at 60 MHz | Running every bench at 60 MHz (D92) | Fixed |
| BUG-133 | Program (10BASE-T) | `eth_tx` sent a link pulse right before a frame | `tb_eth`'s 802.3 model (D93) | Fixed before commit |
| BUG-134 | Program (10BASE-T) | `eth_tx`'s frame status carried the idle loop's timeouts | `tb_eth` (3) (D93) | Fixed before commit |
| BUG-135 | Testbench, Tooling | `tb_eth` re-parsed de-escaped bytes of an unfinished frame; Icarus has no `break` | `tb_eth` (3) | Fixed |
| BUG-136 | Program (HDLC) | `hdlc_rx`'s hunt after an abort read one bit and started a frame in the middle of idle | `tb_hdlc` (D94) | Fixed before commit |
| BUG-137 | Program (HDLC) | `hdlc_tx` let go of the line between frames; in NRZI the level is data-dependent and its own receiver overran | `tb_hdlc` (D94) | Fixed before commit (flag fill) |

---

## BUG-001 — Host transactions collided on the single SPI port

- **Where:** `test/tb_pbe.sv`, UART test.
- **Symptom:** Engine 1's RX FIFO stayed empty; the UART pin never toggled.
- **Cause:** The test sent and received in parallel with `fork`. Both branches drove the
  same host SPI pins, so the transactions corrupted each other and no byte reached the TX
  FIFO. The engine was correctly waiting in `PULL`.
- **Before:**
  ```systemverilog
  fork
    foreach (sent[i]) fifo_send(0, sent[i]);
    foreach (sent[i]) begin
      fifo_recv(1, got);
      check(got === sent[i], ...);
    end
  join
  ```
- **After:** one process takes turns, keeping up to 4 bytes queued.
  ```systemverilog
  for (int i = 0; i < 4; i++) fifo_send(0, sent[i]);
  foreach (sent[i]) begin
    fifo_recv(1, got);
    check(got === sent[i], ...);
    if (i + 4 < sent.size()) fifo_send(0, sent[i+4]);
  end
  ```
- **Lesson:** The host port is a shared resource; a testbench must serialize it like real
  firmware would.

## BUG-002 — SPI peripheral model fetched a reply twice

- **Where:** `test/tb_pbe.sv`, SPI peripheral model.
- **Symptom:** Read byte 1 was `81` instead of `C3`; byte 2 was `EE`.
- **Cause:** The model loaded its next reply both at the falling clock edge after a byte
  and again when CS̅ fell for the next byte, skipping one.
- **Before:**
  ```systemverilog
  always @(negedge bus[3]) if (spi_dev_en) begin
    dev_tx = spi_reply.size() ? spi_reply.pop_front() : 8'hEE;
    ...
  ```
- **After:** a `dev_loaded` flag; whichever event comes first loads the reply, the other
  reuses it.
  ```systemverilog
  always @(negedge bus[3]) if (spi_dev_en) begin
    if (!dev_loaded) dev_tx = next_reply();
    dev_loaded = 1;
    ...
  ```

## BUG-003 — I2C START handshake deadlock

- **Where:** `test/tb_pbe.sv`, I2C helpers.
- **Symptom:** Simulation timed out; engine 1 looped in `idle` with FLAG0 set and the TX FIFO
  empty.
- **Cause:** By design the program performs START when the next byte arrives. The testbench
  waited for the program to clear FLAG0 *before* sending that byte. Each side waited for the
  other.
- **Before:**
  ```systemverilog
  reg_write(7'h04, flag);
  do reg_read(7'h04, f); while (f != 0);   // also for START
  ```
- **After:** only STOP waits for completion.
  ```systemverilog
  reg_write(7'h04, flag);
  if (flag[1]) do reg_read(7'h04, f); while (f != 0);
  ```
- **Lesson:** The host protocol was right but undocumented; it is now in the README.

## BUG-004 — Clock-stretching test was too weak

- **Where:** `test/tb_pbe.sv`, I2C peripheral model.
- **How found:** Removing every `WAIT scl, HIGH` from `i2c_ctrl.pbe` still passed.
- **Cause:** The model stretched SCL only before the ACK slot. At that moment the engine is
  always blocked on `PULL` waiting for the host's next byte, so the engine was paused anyway
  and never needed to wait for SCL.
- **Before:** stretch only when `i_bit == 8`.
- **After:** stretch after bit 4 (mid-byte, engine at full speed) and bit 8.
  ```systemverilog
  if (i_bit == 4 || i_bit == 8) begin
    ext_drive[SCL] = 1;
    ext_val[SCL] = 0;
    repeat (I2C_STRETCH) @(posedge clk);
    ext_drive[SCL] = 0;
  end
  ```
- **Evidence:** with the fix the mutant (no `WAIT`) fails with "address+W not ACKed"; the real
  program passes with 20 stretches.
- **Lesson:** A passing test proves little until it is shown to fail when the feature is broken.

## BUG-005 — A failed compile was hidden; a stale simulation ran

- **Where:** the command used to run tests.
- **Symptom:** Test 4 (USB) was missing from the output although it was in the file.
- **Cause:** Compiler output was piped through `grep -v sorry` to hide a harmless Icarus
  warning. That also hid "sorry: break statements not supported", the compile failed, and
  the old `sim.vvp` from before the USB test ran instead.
- **Fix:** Delete `sim.vvp` before compiling, filter only the exact harmless warning
  ("constant selects in always"), and check the compiler's exit code.
- **Lesson:** Never filter tool output broadly. BUG-007 is the same lesson for the simulator.

## BUG-006 — Icarus Verilog limits and crashes

- **Where:** `pbe_v2/test/tb_pbe.sv`, USB helpers.
- **Symptoms and fixes:**

  | Problem | Fix |
  |---|---|
  | `pulldown` and `before` are reserved words | Renamed `pull_lo`, `n_prev` |
  | `break` not supported | Loop condition instead |
  | Queue slice `d[1:$]` not supported | Loop from index 1 |
  | Bit-select of a queue element with variable indexes (`d[i][b]`) rejected | Copy the element to a temporary first |
  | Function with a queue argument: compiler assertion | Removed |
  | Automatic tasks using queues: runtime crash at time 0 (`vthread_get_rd_context_item`) | USB helpers rewritten as static tasks on module-level variables |
- **How the crash was isolated:** removing helper blocks one at a time, then statements one at
  a time.
- **Lesson:** Keep testbench SystemVerilog simple when the simulator is Icarus.

---

## BUG-007 — A failing simulation exits with code 0

- **Where:** `pbe_v1/test/tb_pbe.sv`, `pbe_v2/test/tb_pbe.sv` (end of the test and the timeout).
- **Found by:** AI review, finding #1. Confirmed: with a deliberately broken design the
  simulation printed 5 FAILs and `vvp` returned 0.
- **Why it matters:** Any script or CI job trusts the exit code, so a broken design would pass.
- **Before:**
  ```systemverilog
  if (errors == 0) $display("PASS");
  else $display("FAILED with %0d error(s)", errors);
  $finish;
  ...
  #20ms;
  $display("FAILED: timeout");
  $finish;
  ```
- **After:** `$fatal` ends a failing run with a non-zero exit code.
  ```systemverilog
  // $fatal gives a non-zero exit code, so make and CI see the failure (BUG-007)
  if (errors == 0) begin
    $display("PASS");
    $finish;
  end else $fatal(1, "FAILED with %0d error(s)", errors);
  ...
  $fatal(1, "FAILED: timeout");
  ```
- **Test:** a copy of v1 with a deliberately broken UART setting.
  - Before: 5 FAILs printed, `vvp` exit code **0**.
  - After: `FATAL: FAILED with 4 error(s)`, `make test` exit code **2**.
- **Status:** Fixed in v1 and v2.

## BUG-008 — `NOP` assembles to `UTX` in v2

- **Where:** `pbe_v2/tools/pbe_asm.py`; meaning defined in `pbe_v2/src/pbe_engine.sv`.
- **Found by:** AI review, finding #2. Confirmed: `NOP` and `UTX` both assemble to `0xE000`.
- **Why it matters:** In v1 opcode 111 was reserved and did nothing. In v2 it is the USB
  opcode, and sub-op 0 with argument 0 is `UTX`: it shifts the OSR, updates the CRC, drives
  the D+/D- pins and can stall. Any program using `NOP` for a delay would emit USB activity.
- **Before:**
  ```python
  OPS = {..., "FLAG": 6, "NOP": 7}
  ...
  else:  # NOP
      need(0)
      arg = 0          # -> 0xE000 == UTX in v2
  ```
- **After:** `NOP` is `FLAG` with action 3, which the engine ignores in every version:
  `0xD800`.
  ```python
  OPS = {..., "FLAG": 6, "NOP": 6}
  ...
  else:  # NOP: FLAG with action 3, which does nothing (opcode 111 is USB in v2)
      need(0)
      arg = 3 << 7
  ```
  The engine header now documents `FLAG` action 3 as "none (the assembler's NOP)".
- **Test:** Test 0 runs a program of only `NOP`s on pins 2–3 (a USB pair in v2) and checks
  that no pin is driven and no flag or interrupt changes.
  - Before (v2): `FAIL: NOP drove pins: uio_oe = 00001100`. v1 passed (opcode 111 did nothing there).
  - After: passes in both.
- **Status:** Fixed in v1 and v2 (v1 changed too, so programs mean the same in both).

## BUG-009 — USB receiver drops stuffed bits without checking them

- **Where:** `pbe_v2/src/pbe_usb_line.sv`, receiver.
- **Found by:** AI review, finding #4.
- **Why it matters:** After six 1s the sender must insert a 0. If the next bit is a 1 instead,
  the packet is malformed and USB requires rejecting it (USB 2.0 §7.1.9.1). The receiver
  dropped that bit whatever it was, so data and CRC could come out unchanged and the packet
  would look valid.
- **Before:**
  ```systemverilog
  end else if (rones == 3'd6) begin
    rones <= '0;  // stuffed bit, drop it
  end else begin
  ```
- **After:** the dropped bit must decode as 0; otherwise a sticky stuffing-error flag is set.
  It clears at the next SYNC and is reported by `STAT` as bit 2.
  ```systemverilog
  end else if (rones == 3'd6) begin
    rones <= '0;  // stuffed bit: drop it, but it must decode as a 0
    if (dp_in == prev_k) serr <= 1'b1;
  end else begin
  ...
  U_STAT: isr <= {5'b0, u_serr, u_crc16_ok, u_crc5_ok};
  ```
- **Test:** the USB host model can send a 1 where the first stuffed 0 belongs. Test 4 sends
  a DATA0 packet that way; the existing good packets now also check that bit 2 stays 0.
  - Before: status `02`, CRC "ok": the malformed packet looked valid, exactly as the review
    predicted.
  - After: status `06` (bit 2 set). Good packets still report `01` / `02`.
- **Status:** Fixed (v2 only; v1 has no USB).

## BUG-010 — I2C SCL low time shorter than the high time

- **Where:** `programs/i2c_ctrl.pbe`, both versions.
- **Found by:** working out the achievable I2C speeds at 48 MHz.
- **Why it matters:** I2C sets a minimum low time longer than the minimum high time
  (standard mode 4.7 / 4.0 µs, fast mode 1.3 / 0.6 µs). The program held SCL low for 3 ticks
  and high for 4. At a 400 kHz setting the low phase is 1.13 µs, below the 1.3 µs minimum.
- **Before:**
  ```
  bit:    PIN  sda, OUTOD
          PIN  scl, REL
          WAIT scl, HIGH
          IN   sda [1]         ; high phase gets the extra tick
          PIN  scl, DRV0
          JMP  X--, bit
  ```
- **After:** the extra tick moves from the sampling instruction to the "SCL low" instruction:
  SCL is now low 4 ticks, high 3. `IN` still samples while SCL is high.
  ```
  bit:    PIN  sda, OUTOD
          PIN  scl, REL
          WAIT scl, HIGH
          IN   sda             ; sample while SCL is high
          PIN  scl, DRV0 [1]   ; low phase gets the extra tick
          JMP  X--, bit
  ```
  The ACK slot got the same change. START/STOP setup and hold times and the bus-free time
  also meet fast mode at this speed (2 ticks = 0.72–0.75 µs ≥ 0.6 µs; 4 ticks ≥ 1.3 µs).
- **Test:** Test 3 now runs I2C at a fast-mode setting (CLKDIV = 17) and measures every SCL
  phase: low ≥ 1.3 µs, high ≥ 0.6 µs, period ≥ 2.5 µs. (The period check skips the cycle
  right after a clock stretch, where the controller times the high phase from when it sees
  SCL rise; the spec only sets minimum low and high times.)
  - Before: `SCL low 1080 ns` (v1) / `1125 ns` (v2), fast mode needs 1300.
  - After: low 1440 / 1500 ns, high 780 / 813 ns, period 2520 / 2625 ns (v1 / v2).
- **Status:** Fixed in v1 and v2.

## BUG-011 — I2C STOP flag cleared before STOP finishes

- **Where:** `programs/i2c_ctrl.pbe`, both versions.
- **Found by:** AI review, finding #5.
- **Why it matters:** The README tells the host to wait for FLAG1 to clear. The program cleared
  it as the first instruction of the STOP routine, before releasing SCL, waiting for
  stretching and raising SDA, so the host could believe the bus is free too early.
- **Before:**
  ```
  stop:   FLAG 1, CLR          ; cleared first
          PIN  sda, DRV0
          PIN  scl, REL
          WAIT scl, HIGH [1]
          PIN  sda, REL [3]    ; STOP: SDA rises while SCL is high
          JMP  idle
  ```
- **After:** FLAG1 is cleared as the last step of the STOP routine.
  ```
  stop:   PIN  sda, DRV0
          PIN  scl, REL
          WAIT scl, HIGH [1]
          PIN  sda, REL [3]    ; STOP: SDA rises while SCL is high
          FLAG 1, CLR          ; only now tell the host the STOP is done
          JMP  idle
  ```
- **Test:** a monitor checks that whenever FLAG1 clears, both SDA and SCL are already high.
  - Before: `FAIL: I2C: FLAG1 (STOP) cleared before the STOP finished`, 3 times (every STOP).
  - After: passes.
- **Status:** Fixed in v1 and v2.

## BUG-012 — Restart does not cancel the current instruction's side effects

- **Where:** `src/pbe_engine.sv`, both versions.
- **Found by:** AI review, finding #3.
- **Why it matters:** `restart` wins in the engine's state update, but the side-effect
  strobes are combinational from `exec`. If the host restarts a running engine in the same
  cycle a `PULL` completes, the TX FIFO pops while the engine clears the OSR: that byte is
  lost. The same applies to `PUSH` and flag changes (and in v2 to the USB line unit inputs).
- **Before:**
  ```systemverilog
  assign exec = issue && ready;
  assign tx_pop   = exec && op == OP_FIFO && !arg_hi;
  ...
  end else if (restart) begin
    pc  <= start_pc;
    osr <= '0;
  ```
- **After:** `exec` is false during a restart, so no strobe can fire.
  ```systemverilog
  // A restart in the same cycle cancels the instruction, so it has no side effects.
  assign exec = issue && ready && !restart;
  ```
  In v2 this also covers the USB line unit's inputs, which are driven from `exec`.
- **Test:** new unit test `test/tb_engine_restart.sv` (run by `make test`) holds an
  instruction ready and raises `restart` in that cycle, for `PULL`, `PUSH`,
  `FLAG SET/CLR/IRQ`.
  - Before: `PUSH` pushed, the flag set/clear strobes fired and the IRQ fired (4 failures).
    `PULL` did not show it in this setup; it goes through the same `exec` term as `PUSH`.
  - After: no side effects for any of them.
- **Cost:** the worst logic path grew slightly (v1 3.61 → 3.78 ns, v2 3.72 → 3.96 ns),
  still far under 20.8 ns.
- **Status:** Fixed in v1 and v2.

## BUG-013 — Restart could glitch a high pin low

- **Where:** `src/pbe_engine.sv`, restart branch, both versions.
- **Found by:** bringing up the Modbus test. The device model saw a "start bit" at the moment
  engine 0 was restarted, and a new glitch monitor on the TX line confirmed it.
- **Cause:** restart cleared both the output value and the output enable of every pin. A pin
  that was driving high had its value change to 0 in the same cycle as its driver turned off.
  In simulation that is a zero-width low pulse (v1 shows it; in v2 the event order happens to
  hide it). In silicon, skew between the value and enable paths could drive the line low for a
  fraction of a nanosecond: a false start bit for UART/Modbus, a false slot for 1-Wire.
- **Before:**
  ```systemverilog
  end else if (restart) begin
    ...
    pins_out <= '0;
    pins_oe  <= '0;
  ```
- **After:** restart only releases pins; the line floats to its pull-up with no low pulse.
  ```systemverilog
  end else if (restart) begin
    ...
    pins_oe  <= '0;  // release every pin; keep pins_out so a line held high cannot glitch low
  ```
  Programs set a pin's value before toggling it, so a stale value after restart is harmless.
- **Test:** the Modbus test counts every low pulse on the TX line shorter than half a bit.
  - Before (v1): `FAIL: Modbus: 1 glitches on the TX line`.
  - After: 0 glitches in v1 and v2.
- **Status:** Fixed in v1 and v2.

## BUG-014 — Modbus device model took a glitch for a start bit

- **Where:** `test/tb_pbe.sv`, Modbus device model.
- **Symptom:** the first request arrived garbled (`05 0D 02 …` instead of `01 03 00 …`), 9 bytes
  instead of 8; the second request was fine.
- **Cause:** the model started a character on any falling edge, including BUG-013's zero-width
  glitch, and stayed misaligned for the whole frame. Real UART receivers check that the line is
  still low part-way into the start bit (our own UART RX program does).
- **Before:**
  ```systemverilog
  wait (mb_en && !bus[0]);  // start bit of a request
  ...
  #(MB_BIT * 1.5);          // first data bit
  ```
- **After:**
  ```systemverilog
  wait (mb_en && !bus[0]);  // start bit of a request
  #(MB_BIT / 4);
  if (!bus[0]) begin        // still low: a real start bit, not a glitch
  ...
  #(mb_first ? MB_BIT * 1.25 : MB_BIT * 1.5);
  ```
- **Lesson:** the glitch was real (BUG-013), so making the model robust was not enough on its
  own; a separate monitor now makes the glitch itself a failure.

## BUG-015 — Modbus receiver polled for a start bit inside the parity bit

- **Where:** `programs/modbus_rtu.pbe`, both versions.
- **Symptom:** response bytes 0 and 1 were right, then every byte was shifted by one bit
  (`04` arrived as `08`).
- **Cause:** after sampling the parity bit the program started polling for the next start bit
  3 ticks later, still inside the parity bit. When the parity bit is 0 (byte `03`), that looks
  like a start bit. Byte `01` survived only because its parity bit is 1.
- **Before:**
  ```
          IN   rx              ; parity bit, at 9.5 bits
          PUSH
          SET  X, silence      ; polling starts at ~9.9 bits: still the parity bit
  gap:    JMP  PIN_LO, rxc
  ```
- **After:** polling starts in the middle of the stop bit; the silence count drops by 2 to keep
  the 3.5-character timeout.
  ```
          IN   rx              ; parity bit, at 9.5 bits
          PUSH
          SET  X, silence [4]  ; start polling in the stop bit, not the parity bit
  gap:    JMP  PIN_LO, rxc
  ```
- **Test:** the Modbus test's response checks (every byte and the CRC).
  - Before: `FAIL: Modbus response byte 2: 08` … `response CRC failed`.
  - After: all 9 bytes and the CRC correct, in both rounds.
- **Status:** Fixed in v1 and v2.

## BUG-016 — A counter shared with a static task was overwritten

- **Where:** `test/tb_pbe.sv`, Modbus test.
- **Symptom:** the host reported 8 parity errors per round, although every status byte was
  correct when printed.
- **First guess, disproved:** that Icarus parsed `^mb_d != mb_x[7]` as `^(mb_d != mb_x[7])`.
  A standalone test showed Icarus parses it correctly.
- **Cause:** the parity-error counter was `mb_j`, which is also the bit-loop variable of the
  static `mb_crc16` task. Calling `mb_crc16` after the counting loop left `mb_j = 8`. Static tasks
  share variables (they were made static to avoid Icarus crashes, BUG-006).
- **Before:**
  ```systemverilog
  mb_j = 0;
  for (...) if (^mb_d != mb_x[7]) mb_j++;
  mb_buf = mb_rx;
  mb_crc16;                       // uses mb_j internally
  check(mb_j == (round ? 1 : 0), ...);
  ```
- **After:** a counter of its own.
  ```systemverilog
  int mb_i, mb_j, mb_perr;  // mb_i/mb_j belong to the tasks; static tasks share variables
  ...
  if ((^mb_d) != mb_x[7]) mb_perr++;
  ```
- **Lesson:** with static tasks, give every caller-side variable its own name.

## BUG-017 — Shared flags: two protocols consumed each other's flags

- **Where:** `src/tt_um_pbe.sv`, both versions (the flags register and its connection to the engines).
- **Found by:** design review; recorded as limitation D27 when 1-Wire and Modbus were added.
- **Cause:** there were 4 flags, shared by both engines, and `JMP` can only test FLAG0 and FLAG1.
  I2C, 1-Wire, Modbus and USB TX all use FLAG0/FLAG1 as host requests, so on two engines they
  read each other's requests. The host also rewrote the whole flags register to set one flag,
  which could wipe a flag the other engine had just changed.
- **Before:**
  ```systemverilog
  logic [3:0] flags;  // shared by both engines
  flags <= (flags | f_set[3:0] | f_set[7:4]) & ~(f_clr[3:0] | f_clr[7:4]);
  7'h04: flags <= wr_data[3:0];   // the host's only way to change a flag
  .flags (flags),                 // both engines see the same 4 flags
  ```
- **After:** 8 flags. Each engine sees a window of 4 starting at its `FLAG_BASE` (engine
  register +8; reset 0 for engine 0, 4 for engine 1), so "FLAG n" in a program is physical flag
  `(FLAG_BASE + n) mod 8`. Overlapping bases still let the engines signal each other. The host
  gets `FLAG_SET` (0x08) and `FLAG_CLR` (0x09) to change single bits. Programs are unchanged.
  ```systemverilog
  wire [2:0]  fbase = flag_base[e*3+:3];
  wire [15:0] fl2   = {flags, flags};
  wire [15:0] set2  = {12'b0, f_set[e*4+:4]} << fbase;
  assign e_flags[e*4+:4] = fl2[fbase+:4];          // the engine's 4 flags
  assign p_set[e*8+:8]   = set2[7:0] | set2[15:8];   // back to physical flags
  ...
  flags <= (flags | p_set[7:0] | p_set[15:8] | host_set) & ~(p_clr[7:0] | p_clr[15:8] | host_clr);
  ```
- **Test:** new test "1-Wire Search ROM (engine 0) and I2C (engine 1) at the same time": two
  host processes run a full Search ROM and repeated I2C write/read rounds concurrently.
  - Before (old hardware; helpers rewritten to read-modify-write the old 4 shared flags):
    `FAIL: concurrent I2C round 1 read 40, wrote 41`, the same for round 3, then a timeout.
    A trace shows the host setting FLAG0 for a 1-Wire reset and the **I2C engine** taking it as a
    START request and clearing it.
  - After: passes in v1 and v2: Search ROM found both devices while I2C completed 62 rounds;
    406 1-Wire edges happened during I2C traffic.
- **Cost:** about 2,700 µm² (+2 %); worst logic path ~3.95 ns.
- **Status:** Fixed in v1 and v2.

## BUG-018 — Host-port lock let one process starve the other

- **Where:** `test/tb_pbe.sv`, the `cs` task (host SPI chip select), both versions.
- **Symptom:** the two-protocol test timed out on the new hardware. A progress probe showed I2C
  running 223 rounds while the 1-Wire host process never got another transaction through.
- **Cause:** the lock was a busy flag. The I2C process released it at the end of a transaction
  and took it again in the same simulation instant, before the waiting 1-Wire process woke up.
  (The first "before" run of BUG-017 used this lock too, so it was rerun with the fixed lock to
  make sure the old-hardware failure was the flag clash and not the lock.)
- **Before:**
  ```systemverilog
  bit host_busy = 0;
  if (!level) begin
    while (host_busy) @(posedge clk);
    host_busy = 1;
  end
  ...
  if (level) host_busy = 0;
  ```
- **After:** a ticket lock, which serves waiters in arrival order.
  ```systemverilog
  int host_next = 0, host_serving = 0;
  int ticket;
  if (!level) begin
    ticket = host_next++;
    while (host_serving != ticket) @(posedge clk);
  end
  ...
  if (level) host_serving++;
  ```
- **Lesson:** a shared resource in a testbench needs a fair lock, just as in software.

## BUG-019 — Modbus 8N2 lost when the program moved to `OUTPAR`

- **Where:** `programs/modbus_rtu.pbe` and the parity logic in `src/pbe_engine.sv`.
- **Found by:** reviewing what was still missing after the CRC/parity/timeout round.
- **Cause:** the first Modbus program sent whatever bit the host put in a "parity byte", so the
  host could send 1 for 8N2 (no parity, two stop bits). The rewrite generates parity in hardware
  with `OUTPAR`, which always sent a parity bit, and the receiver always checked one. A
  regression: no test covered 8N2.
- **Before:**
  ```systemverilog
  wire par_err = par_in ^ odd;
  3'd6: begin pins_out[pin_idx] <= par_out ^ odd; pins_oe[pin_idx] <= 1'b1; end   // OUTPAR
  ```
- **After:** `LINE_CFG[6]` = no parity: `OUTPAR` sends 1 and receive parity errors are masked.
  The Modbus program is unchanged; the host sets `LINE_CFG` = 0x41.
  ```systemverilog
  wire no_par  = line_cfg[6];
  wire par_err = !no_par && (par_in ^ odd);
  wire par_bit = no_par || (par_out ^ odd);  // what OUTPAR sends
  3'd6: begin pins_out[pin_idx] <= par_bit; pins_oe[pin_idx] <= 1'b1; end
  ```
- **Test:** a new Modbus round in 8N2; the device model expects a second stop bit and sends one.
  - Before: `FAIL: Modbus round 4: engine reported 5 parity errors`, and the device saw 4 wrong
    "second stop bits" (the parity bits of characters with odd parity).
  - After: the 8N2 round passes with no parity errors and a good CRC.
- **Lesson:** when a feature moves from software to hardware, test every mode the old version
  supported.

## BUG-020 — Tests ran at 50 MHz, not the planned 48 MHz

- **Where:** `test/tb_pbe.sv`.
- **Cause:** v1's testbench kept the 50 MHz clock from the first version after the plan moved
  to 48 MHz (D18). Programs compute their settings from the clock, so nothing failed, but the
  planned frequency itself was never simulated.
- **Before:** `localparam int CLK_NS = 20;  // 50 MHz`
- **After:** `localparam real CLK_NS = 20.8333;  // 48 MHz, the planned clock`
- **Test:** the whole suite. Before: passed at 50 MHz. After: passes at 48 MHz (I2C fast mode
  measures 1.5 µs low / 0.8 µs high at this clock).

## BUG-021 — Reserved word `strong`; a time limit that looked like a hang

- **Where:** `test/tb_pbe.sv`.
- **Symptoms and fixes:**

  | Problem | Fix |
  |---|---|
  | The 1-Wire device model's new port `strong` broke compilation: it is a SystemVerilog keyword (as `pulldown` and `before` were in BUG-006) | Renamed `hard_hi` |
  | The two-protocol test timed out. A progress probe showed it was running normally; the new 1-Wire and Modbus checks had pushed it past the 200 ms simulated-time limit (it started at 168.6 ms) | Limit raised to 400 ms |
- **Lesson:** before treating a timeout as a hang, check whether the test is still making progress.

## BUG-022 — I2C controller fed its ACK bits into the CRC

- **Where:** `programs/i2c_ctrl.pbe`.
- **Found by:** Test 7 (SMBus PEC), written before the fix.
- **Cause:** every `IN` feeds the CRC unit when `CRC_CFG[7]` is set, including the one that
  samples the ACK slot. An SMBus PEC covers bytes only, so each ACK bit (a 0) corrupted it. No
  earlier test used the CRC unit with I2C.
- **Before:**
  ```
          WAIT scl, HIGH
          IN   sda
          PIN  scl, DRV0 [1]
          PUSH                 ; 0 = ACK, 1 = NACK
  ```
- **After:**
  ```
          WAIT scl, HIGH
          IN   sda, NOCRC      ; the ACK bit is not part of an SMBus PEC
          PIN  scl, DRV0 [1]
          PUSH                 ; 0 = ACK, 1 = NACK
  ```
- **Test:** Test 7 in `tb_pbe.sv`.
  - Before (old program, new test):
    ```
    FAIL: SMBus write: engine PEC 2c, expected ef
    FAIL: SMBus write: the device's CRC over the message and PEC is 47
    FAIL: SMBus read with the right PEC 88: CRC ok = 0
    ```
  - After: passes; the corrupted-PEC read still reports CRC ok = 0.

## BUG-023 — Declaration initializers in procedural blocks run only once

- **Where:** `test/tb_proto.sv` (new code), and one harmless case in `test/tb_pbe.sv`.
- **Cause:** in SystemVerilog, a variable declared inside a `begin`/`end` of an `initial` or
  `always` block is static, and its initializer runs once at time 0, not each time the block
  runs.
  - `realtime low = $realtime - ws_fall;` in the WS2812 decoder: caught when reading the code
    before the first run.
  - `int bytes_before = tgt_bytes;` in Test 10: produced a false failure. Icarus prints
    `warning: Static variable initialization requires explicit lifetime`, but the build's output
    filter (which hides Icarus's many "sorry: constant selects" notes) hid it too, the same
    trap as BUG-005.
- **Before:**
  ```systemverilog
  int bytes_before = tgt_bytes;   // runs at time 0: always 0
  ```
- **After:**
  ```systemverilog
  int bytes_before;
  bytes_before = tgt_bytes;  // not an initializer: that would run once, at time 0
  ```
  plus a lint step in the Makefile, run first by `make test` and `make test-proto`:
  ```make
  LINT = cd test && for tb in tb_engine_restart tb_proto tb_pbe; do \
  	  if iverilog -g2012 -o /dev/null $$tb.sv $(addprefix ../,$(SRC)) 2>&1 | grep "Static variable initialization"; then exit 1; fi; done
  ```
- **Test:**
  - Before: `FAIL: I2C target passed 7 bytes of another device's transaction to the host`. The 7
    bytes were all from the earlier transactions.
  - After: passes. The lint step was checked against a file with a static initializer: it fails.

## BUG-024 — Icarus 12 aborts on two testbench constructs

- **Where:** `test/tb_proto.sv` (Icarus Verilog 12.0).
- **Symptoms and fixes:**

  | Construct | Icarus | Workaround |
  |---|---|---|
  | `exp.push_back(8'h10 * led + frame)`: a 32-bit value pushed into a queue of bytes; also `ws_bits.push_back(ws_last)` (1 bit into 8) | `vthread.cc:520: pop_value: Assertion 'value.size() == wid' failed` | Cast to the element width: `push_back(8'(...))` |
  | `ic_bit(1, b[i])`: a bit-select of an automatic variable as an `output` argument | Segmentation fault | Pass a temporary, then `b[i] = r` |

  Two more changes were made as a precaution while hunting the crashes and were not confirmed
  as causes: a queue `pop_front()` passed straight as a task argument now goes through a
  temporary, and the 1-bit queue became 8 bits wide.
- **How it was found:** the simulation died with no output (lost in the buffer). A run under
  `stdbuf -o0` and a copy of the testbench with a progress `$display` after each step located
  each crash.
- **Test:** `make test-proto` runs to `PASS`.

## BUG-025 — I2C controller model never sent a repeated START

- **Where:** `test/tb_proto.sv`, task `ic_start`.
- **Found by:** the first run of Test 10: reads after a repeated START returned `ff ff ff`, and
  the host saw only 3 of 4 address ACKs. A trace showed no START on the bus at that point: the
  target had correctly taken the read address `0x85` as a data byte.
- **Cause:** `ic_start` tested `bus[1]` (SCL) to decide between START and repeated START, in the
  same time step that `ic_bit` had just pulled SCL low. The wired-AND net had not updated yet,
  so the model saw SCL high and skipped raising SCL for the repeated START.
- **Before:**
  ```systemverilog
  task automatic ic_start;  // START, or repeated START when SCL is low
    if (!bus[1]) begin
  ```
- **After:**
  ```systemverilog
  task automatic ic_start;  // START, or repeated START when SCL is low
    // Test our own drive, not bus[1]: right after ic_scl(0) the net has not updated yet.
    if (ext_drive[1]) begin
  ```
- **Test:**
  - Before: `FAIL: I2C target read ff ff ff, expected ad be ef`.
  - After: passes. The mutation that removes the target's repeated-START check (`JMP FLAG0,
    start` in the write loop) now fails it.

## BUG-026 — SPI peripheral test missed the "nothing queued at select" case

- **Where:** `test/tb_proto.sv`, Test 9.
- **Found by:** mutation check. Removing the first `SET OSR, 0xFF` in `spi_periph.pbe` (the
  default reply when CS falls with an empty TX FIFO) still passed. Every transaction in the test
  queued a reply before selecting, so only the mid-transaction default was tested.
- **Fix:** a third transaction with nothing queued, which expects `ff ff`.
- **Test:**
  - Before: that mutation ran with `0 FAIL lines, exit 0`.
  - After: the mutation fails with `FAIL: SPI peripheral with nothing queued replied fe ff,
    expected ff ff`, and the unmodified program passes.

## BUG-027 — Stimulus raced the DUT at clock edges

- **Where:** `test/tb_line.sv` (task `send_u`/`send_v`) and `test/tb_engine_ops.sv` (its TX FIFO
  stand-in).
- **Cause:** both read or changed a signal in the same time step as the clock edge at which the
  DUT updates it.
  - `send_u` checked `tx_ready` right after `@(posedge clk)`, before the coder's update from the
    previous byte, so it put a second byte into the full queue and overwrote the first.
  - The FIFO stand-in popped its queue at the same edge at which the engine loaded `tx_data`,
    so the engine sometimes took the next byte.
- **Before:**
  ```systemverilog
  while (!ready_u) @(posedge clk);
  data_u <= d; put_u <= !is_end; end_u <= is_end;
  ...
  if (tx_pop) d = tx_q.pop_front();
  ```
- **After:**
  ```systemverilog
  @(negedge clk);  // between edges, so tx_ready already shows the last put (BUG-027)
  while (!ready_u) @(negedge clk);
  data_u = d; put_u = !is_end; end_u = is_end;
  ...
  if (tx_pop) begin
    #1;  // after the engine has taken tx_data at this edge
    d = tx_q.pop_front();
  ```
- **Test:**
  - Before: `FAIL: USB TX: driven for 1184 clocks, expected 72 bits x 32` and `FAIL: byte 3 is 3f,
    expected dd` (a CRC over the wrong bytes).
  - After: both unit tests pass. The coder's transmit matches the reference encoder bit for bit.

## BUG-028 — An unread byte survived the end of its frame

- **Where:** `src/pbe_line.sv`, with `programs/usb_dev.pbe`'s `skip` loop.
- **Found by:** Test 11. After SET_ADDRESS, every SETUP at the new address went unanswered,
  until a keep-alive. A trace showed what happened:
  - An IN for the old address went to `skip`, which waits for the end of the packet without
    reading it.
  - The token's third byte stayed in the coder. After the end-of-frame event, `idle` read that
    stale byte as the next PID.
  - From then on every packet was off by one byte.
- **Before:** `rx_valid` was cleared only by a read.
- **After:**
  ```systemverilog
  // A byte the engine has not taken when its frame ends belongs to that frame: drop it,
  // so it cannot be read as the start of the next frame (BUG-028).
  if (frame_end) rx_valid <= 1'b0;
  ```
  Every reading path in a program takes its bytes within a few clocks; only code that ignores a
  frame on purpose leaves one behind. Fixing the program instead (`skip` reading the rest) would
  have cost a word the 64-word program does not have.
- **Test:**
  - Before: `FAIL: USB: SETUP not ACKed` (nine times), `FAIL: USB: device descriptor at the new
    address: 0 bytes`.
  - After: Test 11 passes. Removing the line (mutation) makes it fail again.

## BUG-029 — The USB host model overwrote the OUT payload

- **Where:** `test/tb_usb.sv`, tasks `hs_setup` / `hs_out`.
- **Cause:** both used the queue `u_data`. The test put the vendor-write payload `AA BB CC` in
  it, and `hs_setup` then replaced it with the 8 request bytes. The OUT stage sent those, and
  the RX FIFO trace showed `e1 4b 40 01 00 00 ...`.
- **After:** the OUT payload has its own queue, `out_data`, which `hs_out` copies into
  `u_data` just before sending.
- **Test:** before: `FAIL: USB: vendor write data`. After: the vendor write and read-back pass.

## BUG-030 — A burst read of an RX FIFO could lose a byte

- **Where:** `src/pbe_host_spi.sv` with `src/tt_um_pbe.sv`.
- **Found by:** review, while making the USB firmware read faster. The host port latches the
  byte to send about 3 clocks after the previous byte, and pops when the byte has been sent.
  Suppose the FIFO was empty at the latch, and a byte arrives before the pop:
  - the host gets a stale value;
  - the pop removes the new byte;
  - so the byte is lost.

  Checking the RX-data pin between bytes cannot close that window.
- **After:** `RX_COUNT` registers (and `TX_COUNT`). The host reads the count, then bursts exactly
  that many bytes, which are all in the FIFO. `pbe_fifo` gained a `count` output.
- **Test:** not reproduced in simulation (the byte must land in a window of about 13 clocks).
  The fix is a protocol rule, documented in the register map and followed by the USB firmware
  model, which reads every record by count.

## BUG-031 — A FIFO flush on SETUP dropped the OUT record behind it

- **Where:** the USB firmware model (`test/tb_usb.sv`), and the host port's flush.
- **Cause:** on a SETUP the firmware flushed engine 0's FIFOs to drop a stale IN reply. The
  only flush (CTRL bits 7:6) empties TX *and* RX. A USB host sends the OUT data right after the
  SETUP's ACK, so that record was already arriving: the flush cut it, and the next read found
  `00 00 00 03 00 ab f4 f5 02`.
- **After:** `TX_FLUSH` (0x0E) empties only TX FIFOs; the firmware uses it.
  ```systemverilog
  reg_write(7'h0E, 8'h01);  // drop a stale reply; not the RX FIFO: an OUT may already be arriving
  ```
- **Test:**
  - Before: `FAIL: USB firmware: 9 bytes do not split into records`, `FAIL: USB: vendor write
    data`.
  - After: passes.

## BUG-032 — USB records had no length

- **Where:** `programs/usb_dev.pbe` and the firmware model.
- **Found by:** the first Test 11 run. The firmware drained the RX FIFO slowly, one byte per two
  host transactions, while the host model kept sending. Four records arrived in one read
  (`e1 4b 00 00 02 2d c3 84 06 ...`), and the firmware took them as one, so SET_ADDRESS was
  never answered. A data record's end (the status byte) cannot be found without its length.
- **After:**
  - The data loop counts bytes down in X, and a record ends `[255 − n] [status]`. The firmware
    parses from the end: a status byte is below 0x20, an ACK record is 0xD2.
  - The firmware reads by `RX_COUNT` in one burst.
  - The 3 words this cost came from removing a redundant first instruction and sharing one
    `PUSH` between the ACK record and the status.
  ```
  db:     IN   dm
          JLINE deop
          PUSH
          JMP  X--, db         ; X started at 255
  deop:   MOV  ISR, X
          PUSH                 ; 255 - number of bytes
  ```
- **Test:** before: `FAIL: USB: IN answered with 1 bytes, PID 5a`, `FAIL: USB: status stage is
  not a DATA1 ZLP`. After: Test 11 passes. A step in it holds the firmware while two records
  arrive, and checks they are split apart (`up to 2 at once`).

## BUG-033 — The idle line after a frame looked like a stuffing error

- **Where:** `src/pbe_line.sv`, receive side, modes without SE0.
- **Found by:** `tb_line.sv`, written before the coder ran. After an HDLC- or CAN-style frame
  the line rests at its idle level. To the receiver that is a run of equal bits with no stuff
  bit, so every good frame ended in a stuffing error.
- **Before:**
  ```systemverilog
  if (rstuff) begin
    rstuff <= 1'b0;
    if (r_bit != r_exp) err <= 1'b1;
  ```
- **After:** without pair mode, a stuffing violation at the idle level is the end of the frame
  (HDLC flag or abort, CAN end of frame); anywhere else it is still an error.
  ```systemverilog
  if (r_bit != r_exp) begin
    if (!pair && a_in) begin
      rs        <= R_IDLE;
      frame_end <= 1'b1;
    end else err <= 1'b1;
  end
  ```
- **Test:**
  - Before: `FAIL: CAN-style RX: stuff error on a good frame`, `FAIL: HDLC-style RX: stuff error
    on a good frame`.
  - After: `PASS: line coder`. The USB case, seven 1s in a packet, is still reported.

## BUG-034 — A pile-up test that could not pass

- **Where:** `test/tb_usb.sv`.
- **Cause:** to show that piled-up records can be split, the test held the firmware during two
  bad SETUPs. Two SETUP records are 28 bytes; the RX FIFO holds 16. So the engine stalled with a
  full FIFO, and the test failed (`records did not pile up (1 at most)`) on a limit it should
  have respected.
- **After:** the pile is two corrupted zero-length OUT records (6 bytes each). The design
  decision D42 now states the limit: the firmware must read a SETUP record before the next
  SETUP.
- **Test:** passes; `up to 2 at once`.

## BUG-035 — More Icarus Verilog 12 limits

- **Where:** `test/tb_line.sv`, `test/tb_usb.sv`, `test/tb_engine_ops.sv`.

  | Construct | Icarus | Workaround |
  |---|---|---|
  | A queue as a task argument | `vthread_get_rd_context_item` assertion | A module-level queue |
  | Bit-select of a queue element (`all[i][k]`) | "Array index expressions must be constant" | Copy the element to a variable first |
  | `return` in a task | "Cannot return from tasks" | A named block and `disable` |
  | Array ports on tasks; assigning a whole fixed array | "sorry: not yet supported" | Module-level queue |
  | A ternary on a queue in a port connection | internal error | A task that updates plain variables |
  | `always @*` reading a queue | not woken by queue changes | Update by hand after each change |
  | A declaration after a statement in a block | syntax error | Declarations first |
  | Declaration initializers in blocks (BUG-023) | warning | Caught twice more in new code; the lint step stops it |
- **Test:** all testbenches compile and run to `PASS`.

## BUG-036 — The gate-level regression job could not find the routed netlist

- **Where:** `.github/workflows/gds.yaml`, job `gl_regression`.
- **Found by:** its first run, after the first successful GDS build. It failed at "Install
  the PDK" after 17 seconds. The job log could not be read from this workspace (GitHub serves
  logs from a host the network policy blocks), so the cause was found from Tiny Tapeout's
  action code:
  - the `tt_submission` artifact is uploaded with `src/*`, `docs/*`, `tt_submission/*` and
    `info.yaml`, so it holds its own `tt_submission/` folder;
  - downloading it with `path: tt_submission` put `pdk.json` in
    `tt_submission/tt_submission/`;
  - `jq` failed inside `$(...)`, which an `echo` hides, so the step "passed" with an empty
    PDK name and the next step failed.
- **Before:**
  ```yaml
  with:
    name: tt_submission
    path: tt_submission
  ...
  echo "PDK=$(jq -r '.PDK' pdk.json)" >> $GITHUB_ENV
  ```
- **After:** download into the workspace root, as Tiny Tapeout's `gl_test` does, and fail at once
  if a value is missing:
  ```yaml
  with:
    name: tt_submission
  ...
  set -euo pipefail
  PDK=$(jq -er '.PDK' pdk.json)
  ```
- **Test:** the job's next run.

## BUG-037 — The gate-level regression stopped early; tb_pbe used a variable before declaring it

- **Where:** the gate-level regression job, and `pbe_v1/test/tb_pbe.sv`.
- **Found by:**
  - **Second run:** with BUG-036 fixed, the PDK installed, but `make test-gl` stopped with exit
    code 2 about 40 seconds in. The log could not be read from this workspace, and the
    annotation gave only the exit code.
  - **Third run:** the job by then used Tiny Tapeout's Icarus 13 and reported its output as an
    annotation. `tb_proto` and `tb_usb` **passed on the routed netlist**; `tb_pbe` did not
    compile:
    ```
    tb_pbe.sv:165: error: Could not find variable ``scl_stretched'' in ``tb_pbe''
    tb_pbe.sv:179:      : A symbol with that name was declared here. Check for declaration after use.
    ```
- **Cause:** the I2C peripheral model (line 165) sets `scl_stretched`, which was declared further
  down, with the SCL timing checks. Icarus 12 accepts that; Icarus 13 rightly refuses it. Whether
  the second run's failure had the same cause cannot be told now, because that run used Icarus 12
  and its output was lost.
- **Before:** `bit scl_stretched = 0, scl_after_stretch = 0;` after the model that uses it.
- **After:** the declaration moved above the model.
- **Other changes:**
  - **Same simulator:** the job uses the Icarus build Tiny Tapeout's `gl_test` uses.
  - **Readable failures:** on failure it writes the end of its output as an annotation, which
    the public API returns, and it always writes a pass/fail summary.
  - **Own workflow:** it moved to `gl_regression.yaml`, triggered by each `gds` run and by
    testbench changes, using the netlist of the latest `gds` run. So a fix needs minutes, not a
    2.5-hour rebuild.
- **Test:** `make test` (RTL, Icarus 12) passes, and the next `gl_regression` run compiles
  `tb_pbe` with Icarus 13.

## BUG-038 — 1-Wire: a full RX FIFO delayed the strong pull-up

- **Where:** `pbe_v1/programs/onewire_ctrl.pbe`, the end of a byte.
- **Found by:** review. After the last slot the program did `PUSH` and only then
  `JMP FLAG0, spu`. With the RX FIFO full, `PUSH` blocks until the host reads, so the strong
  pull-up came late or never; a parasite-powered DS18B20 needs it within 10 µs, or its
  conversion fails.
- **Before:**
  ```
          JMP  X--, bit        ; t=64: next slot starts at 65 us
          PUSH                 ; what was on the wire
          JMP  FLAG0, spu      ; FLAG0 set during this byte: strong pull-up
          JMP  idle
  ...
  spu:    PIN  dq, DRV1        ; t=67
          WAIT FLAG 0, LOW
  ```
- **After:** test FLAG0 first; the pull-up path drives DQ high, then pushes (36 words, was 35):
  ```
          JMP  X--, bit        ; t=64: next slot starts at 65 us
          JMP  FLAG0, spu      ; t=65: strong pull-up, before the PUSH
          PUSH                 ; what was on the wire
          JMP  idle
  ...
  spu:    PIN  dq, DRV1        ; t=66
          PUSH                 ; only now: a full RX FIFO must not delay the pull-up
          WAIT FLAG 0, LOW
  ```
- **Test (Test 4, `tb_pbe.sv`):** 6 read slots and a reset leave 7 bytes unread, MATCH ROM adds
  9: the RX FIFO is full (16). Then CONVERT T with FLAG0; the host reads nothing for 700 µs.
  The time from DQ's last rising edge to the start of the strong pull-up must be ≤ 10 µs, and
  the device model's conversion must succeed.
  - Before: `FAIL: 1-Wire: no strong pull-up after CONVERT T with the RX FIFO full`,
    `FAIL: 1-Wire: RX FIFO full: 0 conversions, 1 failed`.
  - After: passes; `strong pull-up 6.0 us after the last slot`.

## BUG-039 — Modbus RTU accepted a frame with a pause of more than 1.5 characters

- **Where:** `pbe_v1/programs/modbus_rtu.pbe` and its `TIMEOUT` setting.
- **Found by:** review. Inside a frame the program waited 3.5 characters for the next start
  bit, so a 2-character pause was accepted; Modbus over serial line §2.5.1.1 says such a frame
  must be discarded. The design decision is D47.
- **Before:** `TIMEOUT` = 3.5 characters + 9 (317 ticks; 1.75 ms above 19200 baud), and
  ```
  tmo:    JMP  FLAG0, fend     ; word 1: a timeout lands here. In a frame: frame complete
  ```
- **After:** `TIMEOUT` = 1.5 characters + 9 (141 ticks, any baud rate), and (62 words, was 56)
  ```
  tmo:    JMP  FLAG0, gap      ; word 1: a timeout lands here. In a frame: frame complete?
  ...
  gap:    SET  X, 87           ; 1.5 characters of silence so far: watch 2 more (88 x 2 ticks)
  gw:     JMP  PIN_LO, bad     ; a start bit: the frame is invalid
          JMP  X--, gw
  fend:   FLAG 0, CLR
  ...
  bad:    FLAG 3, SET          ; invalid frame: tell the host, receive nothing more
          SET  X, 153          ; until 3.5 characters of silence (154 x 2 ticks), then fend
          JMP  gw
  ```
  The testbench's `mb_config` sets the new `TIMEOUT`.
- **Test (Test 5, `tb_pbe.sv`):** the device model can pause before a response byte. Rounds 5
  and 6 pause 2 characters before byte 4 at 19200 and 115200 baud: FLAG3 must be set and only
  the 4 bytes before the pause received. Rounds 7 and 8 pause 1 character: a valid frame.
  - Before: `FAIL: Modbus round 5: frame reported valid`, `FAIL: Modbus round 6: frame reported
    valid` (with the new `TIMEOUT` and the old program, rounds 7 and 8 failed too: the old
    program ended the frame at 1.5 characters).
  - After: all 9 rounds and the RX overflow test pass.

## BUG-040 — USB: a packet with a stuffing error but intact data and CRC was ACKed

- **Where:** `src/pbe_engine.sv` (`STAT`, `JCRCBAD`, `CRCRST`), `pbe_v1/programs/usb_dev.pbe`.
- **Found by:** review. A stuff bit with the wrong value (a 1 where the stuffed 0 belongs) sets
  the line error, but the unstuffer drops the bit, so data and CRC arrive intact. `STAT` cleared
  the line error, and `JCRCBAD` looked only at the CRC: the packet was ACKed. The existing test
  left the stuffed bit out, which shifts the data, so the CRC caught it. Decision: D48.
- **Before:**
  ```systemverilog
                E_STAT: begin
                  isr      <= {3'b0, line_err, rx_ovf, tmo_seen, crc_ok, par_err};
                  par_in   <= 1'b0;
                  tmo_seen <= 1'b0;
                  line_err <= 1'b0;
                end
                E_JCRCBAD: if (!crc_ok) pc <= start_pc + {1'b0, arg[5:0]};
  ```
- **After:**
  ```systemverilog
                E_CRCRST:  if (!l_err) line_err <= 1'b0;  // an error in this very clock stays
                E_STAT: begin
                  isr      <= {3'b0, line_err, rx_ovf, tmo_seen, crc_ok, par_err};
                  par_in   <= 1'b0;
                  tmo_seen <= 1'b0;
                end
                E_JCRCBAD: if (!crc_ok || line_err) pc <= start_pc + {1'b0, arg[5:0]};
  ```
  In `usb_dev.pbe`, `CRCRST` moved to the start of `dat` (before the DATA PID; same word count),
  and the firmware model counts a record with status bit 4 as bad.
- **Test (Test 11, `tb_usb.sv`):** the host model's `h_bad_stuff = 2` sends the stuffed bit as a
  1. A SETUP sent that way must get no ACK, and the firmware must count 3 bad records.
  - Before: `FAIL: USB: device ACKed a packet with a wrong stuff bit (data and CRC intact)`,
    `FAIL: USB: firmware saw 2 bad records, expected 3` (and the ACKed junk SETUP then broke
    the rest of the enumeration).
  - After: passes.

## BUG-041 — USB: an IN packet whose ACK was lost was never sent again

- **Where:** the device firmware model in `pbe_v1/test/tb_usb.sv` (the host side of
  `usb_dev.pbe`).
- **Found by:** review. The engine pops the IN packet as it sends it. If the host's ACK is lost,
  the TX FIFO is empty and FLAG0 still set, so the next IN gets a NAK, forever. Decision: D49.
- **Before:** `fw_queue` wrote the packet to the TX FIFO and forgot it.
- **After:** the packet is kept in `fw_last` until its `[0xD2]` record; a 50 µs timer in the
  firmware loop queues it again (same DATA PID) when `TX_COUNT` = 0 and no ACK came for 100 µs:
  ```systemverilog
    if (fw_unacked) begin
      reg_read(7'h0C, cnt);  // TX_COUNT
      if (cnt != 0) fw_drained_at = 0;
      else if (fw_drained_at == 0) fw_drained_at = $realtime;
      else if ($realtime - fw_drained_at >= 100000 && !uo_out[1]) begin  // no record waiting
        fw_resends++;
        fw_put;
      end
    end
  ```
- **Test (Test 11):** `h_lose_ack` makes the host model skip its ACK once, in the first data
  stage of GET_DESCRIPTOR. The next IN must bring the same 8 bytes as DATA1, the firmware must
  have resent once, and the rest of the transfer (DATA0, DATA1, status) must complete.
  - Before: `FAIL: USB: after a lost ACK the device sent PID 5a (res 0), expected DATA1 again`
    (NAK after 200 tries), `FAIL: USB: firmware resent 0 packets, expected 1`.
  - After: passes.
- **Tool note:** Icarus 12 compiles `in_pkt == first` on two queues but aborts at run time
  (`vvp: vthread.cc: ... Assertion 'sig' failed`), and rejects `continue` in a `for` loop
  (`syntax error`). The tests compare element by element and use `if`/`else`, as BUG-024 did.

## BUG-042 — USB: a bus reset did not bring the address back to 0

- **Where:** the device firmware model in `pbe_v1/test/tb_usb.sv`.
- **Found by:** review. After SET_ADDRESS the program's words 6 and 9 hold the new address; a
  bus reset must return the device to address 0, but nothing watched for one. Decision: D49.
- **Before:** no bus-reset handling.
- **After:** the firmware timer polls `PINS`; SE0 on two reads 2.5 µs or more apart is a reset:
  ```systemverilog
    reg_read(7'h05, p);  // PINS: D- is pin 0, D+ pin 1
    if (p[1:0] == 2'b00) begin
      t = $realtime;
      reg_read(7'h05, p);
      if (p[1:0] == 2'b00 && $realtime - t >= 2500) begin
        if (!fw_in_reset) fw_bus_reset;
        fw_in_reset = 1;
      end
    end else fw_in_reset = 0;
  ```
  `fw_bus_reset` rewrites words 6 and 9 to `0x9000` and `0x9100`, clears FLAG0–2, flushes the TX
  FIFO and resets the firmware state.
- **Test (Test 11):** after SET_ADDRESS(0x15) and the rest of the enumeration, 10 ms of SE0;
  then GET_DESCRIPTOR at address 0 must return the 18-byte descriptor.
  - Before: `FAIL: USB: firmware saw 0 bus resets, expected 1`, `FAIL: USB: SETUP not ACKed`,
    `FAIL: USB: device descriptor at address 0 after a bus reset: 0 bytes`.
  - After: passes.

## BUG-043 — A bubble after every instruction broke the SPI peripheral at 2 MHz

- **Where:** `src/pbe_engine.sv`, the first design of the instruction register (D50).
- **Found by:** the timing review before it was written, then confirmed by running it as a
  mutation of the final design. The draft loaded `instr_q` from `pmem[pc]` every clock, with
  `pc` the current word, and marked it valid one clock after any change of `pc`. So every
  instruction took at least 2 clocks at CLKDIV 0. The SPI peripheral (D35) must get from the
  8th rising SCLK edge to `WAIT sclk, FALL` in a 12-clock half period. It needs 8 instructions
  for that, 8 clocks before and 16 in the draft.
- **Before (draft):**
  ```systemverilog
  if (exec) begin
    if (jump) iv <= 1'b0;
    else iv <= 1'b0;           // every instruction: fetch the next word first
  ...
  if (exec) pc_next = jump ? jump_pc : pc;  // (with pc + 1 applied on the fetch)
  ```
- **After:** `pc` is the word after the current instruction, so it is already read when the
  current one executes. Only a taken jump fetches.
  ```systemverilog
  if (exec) begin
    if (jump) iv <= 1'b0;
    else instr_q <= instr;     // the next word, already read at pc
  ...
  if (exec) pc_next = jump ? jump_pc : pc + 1'b1;
  ```
- **Test:**
  - Before: Test 9 `FAIL: SPI peripheral: MISO changed while SCLK was high`, `FAIL: SPI
    peripheral replies bc 52 ff, expected 3c a5 ff` and 7 more; `tb_fetch` fails 11 timing
    checks at CLKDIV 0. (USB still passed, at 3.19–3.35 bit times.)
  - After: `PASS` (Test 9 and `tb_fetch`).

## BUG-044 — Yosys merged the copies of the read address back into one register

- **Where:** `src/pbe_engine.sv`, the copies of `pc` that share out its fan-out (D50).
- **Found by:** counting flip-flops in a small test before using the copies: 7 instead of 28.
  The copies have the same D input, clock and reset, so `opt_merge` replaced them with one
  register. `(* keep *)` on the variable does not reach the flip-flop cells.
- **Before:**
  ```systemverilog
  (* keep *) logic [20:0] pc_copy;
  ...
  pc_copy <= {3{pc_next}};
  ```
- **After:** the attribute is on the `always_ff`, which Yosys passes on to the flip-flops it
  makes from it. `pc` is in the same block, so it is not merged with a copy either.
  ```systemverilog
  (* keep *)
  always_ff @(posedge clk or negedge rst_n) begin
    if (!rst_n) begin
      pc      <= '0;
      pc_copy <= '0;
    end else begin
      pc      <= pc_next;
      pc_copy <= {3{pc_next}};
    end
  end
  ```
- **Test:** the small test gives 28 flip-flops; `make synth` gives 3,494 `dfrbpq` flip-flops,
  76 more than before D50 (17 + 21 per engine). Place and route keeps cells as Yosys leaves
  them, but the next routed run should be checked for four `pc` registers per engine.

## BUG-045 — Verilator rejects a default value on a module input

- **Where:** `src/pbe_engine.sv`, the new `pm_wr` input (D50).
- **Cause:** `tb_engine_restart` and `tb_engine_ops` connect the engine by port name and must
  stay unchanged, so `pm_wr` is unconnected there and reads z. In an expression z gives x, and
  an x in `iv` or `pc` would stop the engine. A default (`input logic pm_wr = 1'b0`) is legal
  SystemVerilog, and Icarus 12 and Yosys 0.33 accept it, but the CI lint does not:
  ```
  %Error-UNSUPPORTED: Unsupported: Default value on module input: 'a'
  ```
  (Verilator 5.020, the version Ubuntu 24.04 installs.)
- **Workaround:** `pm_wr` appears only in `if` conditions. There z (or the x it gives in
  `pm_wr && ...`) takes the `else` path, as no write. In the chip it is always driven.
  ```systemverilog
  if (pm_wr && !(exec && jump) && !tmo_hit) pc_next = (iv && !exec) ? pc - 1'b1 : pc;
  ...
  if (pm_wr) iv <= 1'b0;  // see pc_next
  ```
- **Test:** Verilator lint `-Wall` is clean; `tb_engine_restart` and `tb_engine_ops` pass
  unchanged.

## BUG-046 — Python simulator runner can return success after a failed cocotb test (tool/harness, fixed)

- **Where:** verification CLI runners using `cocotb_tools.runner` 2.0.1.
- **Evidence:** the initial line-model run had no HDL timescale and the bus-model run had a
  test-module import error; cocotb logged failures while the Python CLI returned zero.
- **Before:**
  ```python
  runner.test(hdl_toplevel=top, test_module=module)
  ```
- **After (verification only):** require an XML result containing tests and no failure/error;
  build with an explicit picosecond precision. The bus runner also removes stale results.
  ```python
  runner.build(..., timescale=('1ns', '1ps'))
  runner.test(..., results_xml=str(result_path))
  root = ET.parse(result_path).getroot()
  if not root.findall('.//testcase') or root.findall('.//failure') or root.findall('.//error'):
      raise SystemExit('simulation did not pass')
  ```
- **Regression:** `test/bus_models/run.py --stock-spi` reproduces an import failure. Before the
  check the CLI falsely returned zero; after it returns nonzero. Successful simulations still
  return zero. `test/differential/run.py` and `model/check_line_model.py` also validate results.
- **RTL:** unchanged.

## BUG-047 — Top model treated speculative empty-FIFO MISO as an integer and discarded unreset storage (model, fixed)

- **Where:** `pbe_v1/model/top_model.py`, `test/differential/test_diff.py`.
- **Evidence:** seed campaign `--seed 0x504245 --n 3 --cycles 2000`, seed 5259847,
  cycle 22298. After an RX read the host read pipeline speculatively loads the following
  byte. The FIFO may now be empty. Unwritten storage is undefined, and previously written
  storage persists across reset; resetting pointers does not reset the storage array.
- **Before:**
  ```python
  if old_load & 2: self.tx = rd_data  # None on unwritten storage
  def miso(self): return self.tx >> 7  # TypeError
  h = Harness(dut, seed + index)      # model storage lost between reset seeds
  ```
- **After (verification only):** retain known and unknown bits in the host shift register;
  compare an expected unknown MISO bit with the RTL's four-state value while comparing every
  other output bit normally. Carry FIFO backing memory between seed resets.
  ```python
  self.tx = 0 if rd_data is None else rd_data
  self.tx_unknown = 255 if rd_data is None else 0
  def miso(self):
      return None if self.tx_unknown & 128 else self.tx >> 7
  for fifo, memory in zip(h.model.tx + h.model.rx, retained_fifos):
      fifo.mem = list(memory)
  ```
- **Regression:** the saved campaign in `test/differential/regressions.json` failed before
  with `TypeError`, then with an incorrect unknown expectation when storage was discarded.
  After the model corrections the same campaign is required to complete and compare FIFOs,
  flags/status and all pin outputs. Empty data bytes outside a valid read are not interpreted
  as received payload.
- **RTL:** unchanged. This is an oracle/state-lifetime correction, not an RTL defect.

### BUG-047 additional API regressions

Independent review also reproduced the storage-lifetime defect via the public
`PBEModel.reset()` API. It rebuilt FIFO objects and discarded their backing
memory. The API now saves and restores the memory while clearing pointers.
`test_reset_preserves_unreset_backing_storage` fails before and passes after;
`test_host_prefetch_unknown_shift` independently checks unknown MISO and CS reset.
The harness preserves model memory between seed resets for the same reason.

## BUG-048 — Model decoded unspecified program RAM while stopped (model, fixed)

- **Where:** `pbe_v1/model/pbe_model.py`, found by independent model API review.
- **Before:** the second stopped clock of `PBEModel(); edge(); edge()` failed with
  `TypeError`: program RAM legitimately contained `None`, which was shifted during decode.
  ```python
  word = self.instr_q
  op, arg, delay = word >> 13, word >> 4 & 511, word & 15
  ```
- **After (model only):** preserve the unspecified instruction, use a placeholder only for
  inactive decoding, and explicitly reject attempting to execute an unspecified word.
  ```python
  unknown_instruction = self.instr_q is None
  word = 0xd800 if unknown_instruction else self.instr_q
  if unknown_instruction and execute:
      raise ValueError('uninitialized program instruction ...')
  ```
- **Regression:** `test_unwritten_program_is_harmless_while_stopped_and_rejected_when_run`
  fails before with TypeError, and passes after: stopped clocks have no side effects and
  starting the engine produces a descriptive error. See `model/ENGINE_FINDINGS.md`.
- **RTL:** unchanged. No NOP replaces an instruction that would actually execute.

## BUG-049 — Capture extractor lost the initial protocol edge (verification tool, fixed)

- **Before:** a USB packet could begin at the phase-marker timestamp. Reading VCD
  variable order as execution order, then using the first selected levels as the
  initial state, started the extracted file already in USB K. The first SOP was
  lost, and isolated valid SET_ADDRESS decoded as UNKNOWN. This was an extractor
  bug and is distinct from the unfixed full-trace decoder limitations below.
- **Code before** (`tools/sigrok_verify.py`, initial `crop_vcd`):

  ```python
  levels = selected[0][2]
  samples = {0: levels}
  for timestamp, _, values in selected:
      samples[(timestamp-start)//10_000] = values
  ```

- **Code after:** coalesce VCD updates per timestamp; preserve the preceding pin
  state and apply the first in-window event after a 1 us pre-roll:

  ```python
  grouped = {}
  for event in changes:
      grouped[event[0]] = event
  # read_vcd returns list(grouped.values())
  previous = [x for x in changes if x[0] < start]
  levels = previous[-1][2] if previous else selected[0][2]
  samples = {0: levels}
  for timestamp, _, values in selected:
      samples[(timestamp-start)//10_000+head_ns//10] = values
  ```

- **Fail-before/pass-after test:** `python3 -m unittest discover -s test -p
  test_sigrok_extract.py`. Both marker/edge file orders fail if initial levels are
  reverted to `selected[0][2]`; both pass now. Before-fix failure transcript is
  checked in as `evidence/phase2/crop_before_fix.txt`. Valid USB request windows
  then reconstruct all ten expected control requests with no state errors.

## BUG-050 — Stock USB request decoder cannot recover DATA RECEIVED (external tool, unfixed)

- **Version/component:** libsigrokdecode 0.5.3, `decoders/usb_request/pd.py`.
- **Code before** (unchanged third-party code):

  ```python
  if self.transaction_state == 'TOKEN RECEIVED':
      transaction_timeout = self.es_transaction
      transaction_timeout += int((self.es_transaction - self.ss_transaction) / 2)
      if ss > transaction_timeout:
          self.es_transaction = transaction_timeout
          self.handshake = 'timeout'
          self.handle_transfer()
          self.transaction_state = 'IDLE'
  if self.transaction_state != 'IDLE':
      # emits ERR and rejects the new token
      return
  ```

- **Code after:** unchanged; no third-party decoder or RTL fix was made. A proper
  external fix needs timeout/recovery for a data packet whose handshake never
  arrives, with timing validated against USB semantics. That is not a design
  modification authorized by this verification task.
- **Reproduction:** `python3 tools/sigrok_verify.py --vcd-dir test --output
  /tmp/pbe-sigrok-full --full-usb-request`. The full trace misses
  `00 05 15 00 00 00 00 00` after intentionally malformed traffic; isolated
  `usb_clean_address.vcd` reconstructs it, and full-trace `usb_packet` contains it.
- **Regression state:** intentionally still FAIL for the full-trace check; there
  is no claimed pass-after for an unfixed external tool. Before and after this
  verification change, design behavior is identical.

## BUG-051 — Stock USB request decoder counts unacknowledged retry twice (external tool, unfixed)

- **Version/component:** libsigrokdecode 0.5.3, `decoders/usb_request/pd.py`.
- **Code before** (unchanged third-party code):

  ```python
  elif request['type'] == 'SETUP IN' and self.transaction_type == 'IN':
      request['data'] += self.transaction_data
  ```

- **Code after:** unchanged; no third-party decoder or RTL fix was made. An
  external fix needs transfer/PID/ACK history to suppress duplicate retries,
  with valid retransmission and timeout regressions. The verification code
  keeps valid request windows and the full packet-level trace independently
  checked and exposes this request-layer comparison as a strict failing option.
- **Reproduction:** same full-trace command above. Two descriptor requests have
  expected lengths `[18, 18]`; stock decoder produces `[18, 26]`. The extra eight
  bytes are the duplicated DATA1 `12 01 10 01 ff 00 00 08`. The existing USB bench
  explicitly checks identical retransmission and reports PASS.
- **Regression state:** intentionally still FAIL for the full-trace check; no
  claimed pass-after exists for the unfixed external tool. See
  `evidence/phase2/full_results.json` and `full_usb_full_requests.stdout`.

### BUG-046 additional external-tool exit check

Stock sigrok-cli 0.7.2 can also return zero on a libusb initialization error in
this restricted environment, emitting no version or decoded annotations. The
verification driver now requires an actual version banner and nonempty decoder
output before comparisons. Before: exit status alone could count this as success.
After: `sigrok_verify.py` returns nonzero on empty output; running the offline
command where libusb initialization is allowed produces 22 real passing checks.
No decoder or system USB configuration was changed.

## BUG-052 — cocotbext-spi 0.5.0 uses removed APIs and imprecise clock conversion (external-tool compatibility, adapted)

- **Where:** third-party SPI model under cocotb 2.0.1. No installed library or RTL
  is modified; adapters live in `test/bus_models/test_buses.py`.
- **Before:**
  ```python
  from cocotb.clock import BaseClock       # ImportError on cocotb 2
  bit = scalar.value.integer              # AttributeError on Logic
  get_sim_steps(period_in_seconds, 'sec')  # ValueError on float reciprocals
  ```
- **After:** a local BaseClock compatibility constructor retains the signal;
  Logic's local compatibility property returns its integer value; a clock subclass
  passes an even integral picosecond period to the same SPI library implementation.
  ```python
  class _LegacyBaseClock:
      def __init__(self, signal): self.signal = signal
  cocotb.clock.BaseClock = _LegacyBaseClock
  Logic.integer = property(lambda self: int(self))
  super().__init__(signal, 2*round(period*1e12/2), 'ps', start_high)
  ```
- **Tests:** `run.py --cases 1 --test spi_controller --stock-spi` reproduces the
  import failure with nonzero exit. Without `--stock-spi`, both SPI endpoint tests
  pass. Intermediate unadapted runs separately raised the Logic/clock exceptions;
  the passing tests exercise all three adaptations. Wire shifting remains third-party.
- **RTL/protocol programs:** unchanged. See PHASE3 and `test/bus_models/results.json`.

## BUG-053 — Stock I2C master samples SDA before stretched SCL goes high (external tool, adapted)

- **Where:** cocotbext-i2c 0.1.2 `I2cMaster.recv_bit`.
- **Before:**
  ```python
  await self._half_bit_t
  b = bool(int(self.sda.value))
  self._set_scl(1)
  while not int(self.scl.value): await RisingEdge(self.scl)
  ```
- **After:** the verification-only `StretchAwareMaster` samples after the
  actual SCL-high wait; remaining framing, wire driving and assembly are inherited.
  ```python
  await self._half_bit_t
  self._set_scl(1)
  while not int(self.scl.value): await RisingEdge(self.scl)
  b = bool(int(self.sda.value))
  ```
- **Fail-before/pass-after:** `run.py --seed 20261029 --cases 1 --test i2c_target
  --stock-i2c` expects `d5637ebf` but sees `55e3febf`, exit 1. The same test without
  `--stock-i2c` receives `d5637ebf` and passes. This is an adapted endpoint result,
  not a claim that the unmodified master passed stretching.
- **RTL/protocol programs:** unchanged.

## BUG-054 — UART endpoint test did not wait for all transmitted characters (harness, fixed)

- **Where:** `test/bus_models/test_buses.py`, UART TX.
- **Before:**
  ```python
  await Timer(12 * bit_clocks * PERIOD_PS, unit='ps')
  got = bytes(await sink.read(len(data)))
  ```
  Only two complete characters were available when six were requested: QueueEmpty.
- **After:**
  ```python
  await Timer((len(data)+1) * 12 * bit_clocks * PERIOD_PS, unit='ps')
  got = bytes(await with_timeout(sink.read(len(data)), 10, 'ms'))
  ```
- **Test:** `run.py --seed 20261029 --cases 1 --test uart_tx` fails before and
  passes after, with exact equality of the six random bytes. All three clock-error
  cases also pass. RTL and transmitted-byte expectations remain unchanged.

## BUG-055 — I2C target host-service test raced an RX count snapshot against FLAGS (harness, fixed)

- **Before:** host service drained one RX_COUNT snapshot, then read FLAGS and
  classified an empty drained list as a read request. An address could be pushed
  between the count snapshot and the FLAGS read, leaving address `a0` to be
  misclassified as payload.
  ```python
  drained = [await c.read(0x16) for _ in range(await c.read(0x0a))]
  flags = await c.read(4)
  if flags & 4:
      classify(drained)
  ```
- **After:** recheck and drain the FIFO when the address/request flag is present,
  before classifying the event.
  ```python
  if flags & 4:
      for _ in range(await c.read(0x0a)):
          drained.append(await c.read(0x16))
      classify(drained)
  ```
- **Test:** `run.py --seed 20261029 --cases 1 --test i2c_target` previously
  included `a0` among payload; after the correction receives exactly `2f7da1c26b`
  and address bytes `[0xa0,0xa1]`. No RTL/program or byte assertion changed.

## BUG-056 — I2C stretch stimulus inserted a spurious clock edge (harness, fixed)

- **Before:** delaying the memory model's read callback let its base assert SCL
  low during an existing high phase, shortening that phase and creating an
  additional edge. This was invalid stimulus, not a valid stretching failure.
  ```python
  async def handle_read(self, ...):
      await Timer(delay_ns, unit='ns')
      return await super().handle_read(...)
  ```
- **After:** use stock memory callbacks and independently assert stretch only
  after an existing falling edge.
  ```python
  await FallingEdge(d.scl)
  d.stretch_release.value = 0
  await Timer(r.randrange(5000, 20000), unit='ns')
  d.stretch_release.value = 1
  ```
- **Test:** `run.py --seed 20261029 --cases 1 --test i2c_controller` originally
  expected `1a31ca40`, saw `1a63ffff`; after correcting the stimulus it passes
  with 30 random low-phase stretches. Expected bytes and RTL remain unchanged.

## BUG-057 — GitHub regression job omitted the new cocotb dependency (CI configuration, fixed)

- **Found while publishing verification:** `.github/workflows/regression.yaml`
  installed HDL tools and called the expanded `make test` target without installing
  its pinned Python dependency. The local verification virtual environment had the
  package; a fresh runner did not have an explicit installation step.
- **Before:**
  ```yaml
  - name: Run the test suite
    run: cd pbe_v1 && make test
  ```
- **After:** explicitly select Python and install the same requirement file used
  locally before running the unchanged suite.
  ```yaml
  - name: Setup Python
    uses: actions/setup-python@v6
    with:
      python-version: '3.11'
  - name: Install verification dependencies
    run: python -m pip install -r pbe_v1/test/differential/requirements.txt
  - name: Run the test suite
    run: cd pbe_v1 && make test
  ```
- **Fail-before/pass-after dependency check:** this host's unconfigured `python3
  -c 'import cocotb_tools'` raises ModuleNotFoundError. The interpreter with the
  pinned requirements installed imports it successfully and reports cocotb 2.0.1;
  `make test` is rerun with that environment before publishing. This demonstrates
  the dependency requirement locally, not a claim of an observed GitHub CI pass.
- **RTL, GDS and GL workflows:** unchanged. GitHub CI results must be checked after push.

## BUG-058 — Specification implied an enforced 64-word program fence (contract text, clarified; original assertion fails)

- **Before (headers):**
  ```systemverilog
  // ... so each engine works in its own 64-word window ...
  // START_PC ... (64-word window)
  ```
  The implementation always used a full7-bit sequential PC. Six-bit jump operands
  bound branch offsets, not sequential execution or instruction prefetch.
- **After (comments only):**
  ```systemverilog
  // A target is 6 bits; this is a branch-offset window, not a memory-protection boundary.
  // Sequential execution increments the full 7-bit PC and can leave that window or wrap 127->0.
  ```
- **Regression:** `python tools/check_spec_boundaries.py` runs the retained original
  physical-PC fence assertion and actual-instruction fence assertion; both must
  fail with their exact markers. It also runs a corrected-contract check that
  passes. PhysicalPC64/current instruction63 is distinguished from actually
  executing instruction64. The wrapper rejects a missing expected failure or
  an unrelated simulator error. Evidence: `evidence/round2/spec_boundary_checks.json`.
- **Status:** architectural protection is not added. The requested unconditional
  formal window property must retain its counterexample; clarifying text is not
  proof of the original stronger claim. HDL behavior is unchanged.

## BUG-059 — Program-write comment overstated atomic instruction cancellation (contract text, clarified)

- **Before:**
  ```systemverilog
  // A host write to the program memory refetches the current instruction ...
  // ... a program the host changes is never run from a stale copy ...
  ```
- **After (comment only):**
  ```systemverilog
  // It does not cancel an instruction already ready to execute on that same edge:
  // that instruction uses the old registered word.
  // ... its successor (or taken target) is fetched again.
  ```
- **Regression:** `test_memory_write_may_execute_old_ready_word` checks the model;
  `tools/check_spec_boundaries.py` checks actual RTL. The original same-edge
  cancellation assertion fails with its expected marker: the old DRV1 drives
  out01/oe01 while RAM word0 is replaced by DRV0, and validity clears. The updated
  snapshot/refetch contract passes. The original stronger claim remains an
  explicit negative regression. No instruction side effects were suppressed.
- **Boundary:** this does not establish failure of a correctly sampled
  `iv -> instr_q == memory[pc-1]` invariant: PM-write invalidation can make that
  invariant true even though a ready old instruction executes on the write edge.
- **HDL:** unchanged.

## BUG-060 — Golden model invented the unknown half of a partially written program word (model, fixed)

- **Before:**
  ```python
  old = self.program[word]
  old = 0 if old is None else old
  self.program[word] = (old & 0xff00 | data) if self.pm_ptr & 1 else (old & 255 | data << 8)
  ```
- **After:** retain separately known byte values and a two-bit validity mask;
  keep `program[word] is None` until both halves are written. Reset preserves
  partial memory state, just as it preserves unreset RAM.
  ```python
  value, known = self._pm_partial.get(word, (0, 0))
  value = (value & ~(255 << shift)) | data << shift
  known |= 1 << (shift // 8)
  if known == 3: self.program[word] = value
  else: self._pm_partial[word] = value, known
  ```
- **Fail-before/pass-after:** new top model tests
  `test_partial_program_word_stays_unspecified_until_both_bytes_written` and
  `test_rewriting_one_unknown_word_half_does_not_initialize_other_half` originally
  failed with `55296 is not None` and `4608 is not None`. Both now pass, alongside
  initialized-memory differential checks. No RTL value is copied into the model.
- **HDL:** unchanged. Unknown execution remains outside the deterministic oracle.

## BUG-061 — Verification missed isolated empty-FIFO pop rejection (test coverage, fixed)

- **Finding:** scratch mutation M21 removes `!empty` from the FIFO pop guard.
  Initial `make test` and separate `make diff` both return0. Their host/engine
  stimulus qualifies logical pops and did not drive this isolated block boundary.
- **Before:** no standalone FIFO robustness check in the default target.
- **After:**
  ```make
  cd test && iverilog -g2012 -o fifo_robustness.vvp tb_fifo_robustness.sv ../src/pbe_fifo.sv && vvp -n fifo_robustness.vvp
  ```
  The new test drives empty pops, full pushes, ordered16-byte traffic and flush.
- **Fail-before/pass-after sensitivity:** without the test M21 survives both make
  invocations; with it the mutant fails with `empty pop must be ignored count=31`.
  Unchanged RTL passes. Correct source remains:
  ```systemverilog
  if (pop && !empty) rptr <= rptr + 1'b1;
  ```
  The faulty `if (pop)` exists only in scratch. All24 selected mutants now have a
  recorded detecting check. Full table/receipts: `ROUND2_MUTATIONS.md` and
  `evidence/round2/mutations/`, including the original survivor and corrective rerun.

### BUG-050/051 round-2 root cause and expected-failure disposition

`tools/usb_decoder_repro.py` reproduces both defects without PBE/NRZI/VCD input.
USB1.1 sections8.7.1–2 require transaction timeout and discarded corrupt traffic;
section8.6.4 describes identical PID/data retry after missing ACK. Both stock
request-start options fail. BUG-051 specifically follows missing DATA/handshake
timeout -> rejected retry IN -> intervening NAK associated with stale DATA1 ->
unconditional control-IN append, then acknowledged duplicate append. Primary
specification hash/source/receipts: `ROUND2_USB.md`. Default full-trace checks now
mark only exact verified signatures XFAIL, never PASS; strict `sigrok-full` still
fails. Unknown mismatches remain FAIL. Stock external code and RTL are unchanged.

## BUG-062 — Stock USB first-ack decoder raises TypeError but exits0 with partial output (external tool and harness guard)

- **External code before/after:** unchanged libsigrokdecode0.5.3 usb_request:
  ```python
  ss_data = None
  # first-ack updates this only if actual data arrives
  self.putr(ss_data, es, ...)
  ```
  An empty BULK-IN timeout supplies None as native annotation start sample. Native
  sigrok prints `argument 1 must be int, not None`, but exits0 with partial output.
  The independent packet reproducer and native full waveform both confirm it.
- **Harness before:**
  ```python
  result = call(command, output)
  if not result: raise RuntimeError('empty decoder output')
  ```
- **Harness after:** also reject decoder exceptions from stderr.
  ```python
  stderr = output.with_suffix('.stderr').read_text(errors='replace')
  if 'Traceback (most recent call last)' in stderr or re.search(r'Calling .* decode\(\) failed', stderr):
      raise RuntimeError('stock decoder exception')
  ```
- **Fail-before/pass-after:** regression
  `DecoderExitStatus.test_nonempty_stdout_and_exit_zero_do_not_hide_decoder_exception`
  fails against the old helper and passes now. Exact `bug062_before_fix.txt` and
  `bug062_after_fix.txt` transcripts are in `evidence/round2/usb/`. Installed-stock
  replay covers both options and native exception. Default pins submit; no patch
  or passing first-ack full-trace result is claimed. RTL is unchanged.

## BUG-063 — Host formal read observer wrapped and resurrected old bits (verification, fixed)

- **Before:** the observer used a wrapping three-bit read index:
  ```systemverilog
  reg [2:0] f_read_bit = 7;
  wire [7:0] f_shifted_read_word = f_read_word << (7-f_read_bit);
  if (f_fall && f_bit != 0) f_read_bit <= f_read_bit - 1'b1;
  ```
  An arbitrary induction state could wrap 0 to 7 and predict old data again,
  while the real host shifter correctly continued emitting zeroes.
- **After:** count mathematical shifts with saturation:
  ```systemverilog
  reg [3:0] f_read_shift = 0;
  wire [7:0] f_shifted_read_word = f_read_word << f_read_shift;
  if (f_fall && f_bit != 0 && f_read_shift < 8)
    f_read_shift <= f_read_shift + 1'b1;
  assert(f_read_shift <= 8);
  ```
- **Fail-before/pass-after:** `formal/host.sby prove` originally passed its
  24-step base case but failed induction, yielding UNKNOWN/exit 4. The corrected
  observer passes base and temporal induction without additional environment
  assumptions. Original trace/log:
  `pbe_v1/verification/evidence/round2/formal/fifo_host-host-initial-*`.
  Detailed contract and reproducer: `ROUND2_FORMAL_FIFO_HOST.md`. RTL unchanged.

## BUG-064 — Restart observer ignored reset priority (verification, fixed)

- **Before:**
  ```systemverilog
  if ($past(restart)) assert(pc == start_pc);
  ```
  Reset low with restart high properly resets the DUT to PC 0; the monitor
  incorrectly required an arbitrary nonzero START_PC on the following edge.
- **After:**
  ```systemverilog
  if ($past(rst_n && restart)) assert(pc == start_pc);
  ```
- **Fail-before/pass-after:** `formal/engine.sby invariants` originally failed
  at step 2 with START_PC 1, reset low and restart high. The qualified monitor
  passes BMC 40. The original transcript is
  `evidence/round2/formal/engine/monitor_reset_before.log`; final evidence is
  `aggregate_results.json` and `logs/engine_invariants.log.gz`. This is a monitor
  correction, not an RTL reset change or a two-state proof of X freedom.

## BUG-066 — Line receive-rate limitation was unstated (contract text, clarified)

- **Before:** the pre-audit line header advertised `one bit every period_m1 + 1
  clocks` and `Sampling is mid-bit` without an RX lower-rate boundary.
  The actual unchanged comparator/timer are:
  ```systemverilog
  sample = rcnt == {1'b0, period_m1[15:1]} + 16'd1;
  rcnt <= (a_in != a_d || rcnt == period_m1) ? 16'd0 : rcnt + 16'd1;
  ```
- **After (comment only, already in phase 0):**
  ```systemverilog
  // At period_m1=0 RX cannot sample (its count remains 0);
  // there is no universal receive guarantee at that rate.
  ```
- **Regression:** `formal/line.sby original_period0` deliberately retains the
  original all-period reception claim. It fails at step 161: two bytes sent,
  zero received, RX counter/sample always 0 after reset. The corresponding
  framed period-3 tasks pass BMC 164. The original assertion remains an expected
  failure; no hardware change or claim that all other periods work is made.
  `line_original_period0.vcd`, `line_counterexample_summary.json` and
  `ROUND2_FORMAL_LINE.md` retain the evidence.

## BUG-067 — Formal receipt read the first option rather than its override (metadata, fixed)

- **Before (reproduced first-value defect):**
  ```python
  return values[0] if values else None
  ```
  Expanded SBY task settings can contain general mode/depth followed by
  task-specific overrides. This mislabeled cover jobs as BMC and overstated
  some depths; solver results themselves were unchanged.
- **After:**
  ```python
  return values[-1] if values else None
  ```
- **Fail-before/pass-after:** `FormalReceiptTests.test_task_override_is_effective_mode_and_depth`
  supplies mode bmc/depth 164 followed by mode cover/depth 48. A temporary
  first-value copy fails (`bmc != cover`); the corrected helper passes. The
  before/after transcripts and explicitly incorrect old receipt are under
  `evidence/round2/formal/engine/metadata_*` and `receipt_before_option_fix.json`.
  Final collection validates effective options and current inputs for all jobs.

## BUG-068 — Stuff observer asked for impossible cover events (verification, fixed)

- **Before:**
  ```systemverilog
  cover(f_saw_violation && err);
  if (!pair) cover(f_saw_idle_end && frame_end);
  ```
  Pair mode retained a disabled unreachable cover cell. A wrong NRZ ones-style
  stuff bit on a single wire is necessarily idle-high, which ends a frame
  without err, making the first goal impossible in those configurations.
- **After:**
  ```systemverilog
  cover(f_saw_violation && (err || (!pair && frame_end)));
  ```
- **Fail-before/pass-after:** eight original cover jobs fail, including
  `cover_stuff_nrz_s1_pair` and `cover_stuff_nrz_s1_single`; all 12 corrected
  cover jobs pass. `line_cover_pilot_results.json` preserves the original
  failures. Every final line task was rerun with the final observer, and source
  collection confirms identical final inputs/configuration. The actual reaction
  assertions are unchanged, and six original unconditional-error assertions
  still fail as expected. RTL unchanged; details: `ROUND2_FORMAL_LINE.md`.

## BUG-071 — Formal receipt omitted reached cover locations (metadata, fixed)

- **Before:** both collectors searched for text not emitted by SMTBMC:
  ```python
  re.findall(r'Reached cover statement at (.+)', logtext)
  ```
  Real logs contain `Reached cover statement in step 3 at ...`, so the lists
  were empty despite valid cover results. This did not change solver status.
- **After:**
  ```python
  re.findall(r'Reached cover statement in step \d+ at (.+)', logtext)
  ```
- **Fail-before/pass-after:** new regression
  `FormalReceiptTests.test_cover_locations_include_smtbmc_step_text` originally
  fails with `[]` versus two locations; all three collector unit tests pass
  after the fix. Exact transcripts: `evidence/round2/formal/bug071_before.txt`
  and `bug071_after.txt`. Collection reran against all 108 completed jobs with
  exact input/configuration checks; no solver rerun was needed. The 15 successful
  cover jobs reach 22 reached statement events across jobs. Corrected aggregate receipt
  and compressed raw logs are retained under `evidence/round2/formal/`.

## BUG-065 — Independent protocol harness had count and simulator-expression defects (test, fixed)

- **USB before:**
  ```python
  if len(actual) != 14:
      raise RuntimeError(...)
  ```
  The planned scenarios produce 13 final responses; this rejected a correct
  simulation with `USB expected14 captured responses, got13`.
- **USB after:** derive the complete expected response-ID sequence from the
  planned stimulus and compare captured IDs before comparing packet bytes.
  The expectation is never derived from DUT output:
  ```python
  assert [int(index) for index, _ in actual] == usb['expected_responses'], actual
  for index, raw in actual:
      assert raw == usb['packets'][int(index)]['hex']
  ```
- **Modbus before:** generated SystemVerilog selected bits directly from a
  variable-index queue element (the exact offending expressions):
  ```systemverilog
  mb_par[i][0]
  mb_par[mb_par.size()-1][1]
  ```
  Icarus 12 rejects this expression form with 20 elaboration errors.
- **Modbus after:** copy the selected byte into the existing temporary first:
  ```systemverilog
  mb_x = mb_par[i]; check(!mb_x[0], "independent Modbus parity status");
  mb_x = mb_par[mb_par.size()-1];
  // Generated CRC check reads mb_x[1] against its case's fixed expected bit.
  ```
- **Fail-before/pass-after:** temporary before-fix scripts return nonzero with
  the count error or compiler errors. Exact commands/output are retained as
  `pbe_v1/verification/evidence/round2/vectors/protocol_bug065_before_*`.
  The corrected `test/reference_protocols/run.py --seed 0x50424532` passes USB
  (38 transmitted host packets, 13 final responses) and all seven Modbus cases.
  A second USB seed also passes. Full packets, generated SV tasks, source hashes
  and PASS logs are retained beside the failure evidence. No RTL, protocol
  program, packet bytes or installed library implementation was changed.

## BUG-069 — Coverage tool rejected diagnostic formatting and annotation cwd (tool compatibility, fixed)

- **Before:** the Icarus-accepted diagnostic in the scratch `tb_line` copy used:
  ```systemverilog
  $sformatf("USB RX %+0.1f %%: ...", ...)
  ```
  Verilator rejected three such strings with `Unknown $display-like format
  code: '%+'`. The original failed compiler log remains in
  `evidence/round2/coverage/coverage-initial-tb_line-build.log.gz`.
- **After (scratch printing only):**
  ```systemverilog
  $sformatf("USB RX %0.1f %%: ...", ...)
  ```
  The same stimulus/assertions now compile and `tb_line` passes. Tracked bench
  source and RTL are unchanged; only scratch diagnostic formatting is adapted.
- **Annotation before:** `verilator_coverage --annotate ...` ran outside the
  scratch test directory, so bare relative `tb_host.svh` could not be found.
  **After:** launch annotation with `cwd=build/coverage/test`, where the copied
  include lives. The preserved wrong-cwd negative returns 1; correct-cwd merge,
  annotation and LCOV generation pass. Evidence includes
  `annotation-wrong-cwd-negative.log.gz` and the final merged/annotated outputs.

## BUG-072 — Coverage accepted absent/stale artifacts and shared stale inputs/diagnostics (verification, fixed)

- **Before:** normal benches required only an exit status/PASS marker; the
  line sweep did not require data, and differential existence-only checking
  could accept a stale file:
  ```python
  passed = proc.returncode == 0 and 'PASS' in proc.stdout
  if coverage and not coverage_output.exists():
      raise SystemExit('missing coverage')
  ```
- **After:** all three launch paths unlink the expected file before launch and
  require a new regular nonempty file after successful checks:
  ```python
  clear_coverage(expected_path)
  run_simulator()
  require_coverage(expected_path)
  ```
  Exit/PASS and fresh data are jointly required; a failed run with a dump still
  fails. A full campaign clears old data before aggregation. Partial runs are
  explicitly debugging runs and may aggregate existing inputs.
- **Image before/after:** copying existing hex could silently use stale program
  images. `refresh_images()` now invokes the existing 13 make image prerequisites
  before copying the snapshot, so a changed `.pbe` rebuilds its image or fails.
  Its regression runs a real temporary make graph with newer program/stale hex.
- **Diagnostics before/after:** the differential wrote metrics/failure JSON to
  fixed `build/differential/` even under a separate Verilator build. It now uses
  the launcher's `PBE_DIFF_OUTPUT_DIR` and `output_path(...)` for both artifacts.
  Default Icarus paths are unchanged; coverage diagnostics live in their own
  `build/coverage/obj_diff/` to avoid overwriting independent runs.
- **Fail-before/pass-after:** seven tests in `coverage/test_harness.py` pass.
  Restoring old acceptance in a scratch helper makes the missing/stale/empty
  artifact regressions all fail as expected. The new image/isolation regressions
  additionally check rebuild and unchanged-default behavior. Logs/receipts are
  `evidence/round2/coverage/bug072-legacy-acceptance-negative.*`,
  `harness-tests.log.gz` and `image_prerequisites.json`. Old successful data is
  retained under `before_bug072/`; the final hardened complete campaign reran
  successfully with all 11 bench dumps fresh/nonempty and 92/92 functional bins.
  No RTL or protocol-program behavior changed.

## BUG-073 — Tool receipts mistook a cocotb banner for the Python runtime (metadata, fixed)

- **Before:** CRC/coverage receipts copied the startup banner into metadata:
  ```python
  tools['python'] = '3.10.14'  # copied from "Using Python 3.10.14"
  ```
  Independent launcher and in-cocotb probes instead report `sys.version`
  3.10.12 for the exact `.venv/bin/python` used by both Icarus and Verilator.
  The same probe logs still print the original 3.10.14 banner. No mechanism
  for that discrepancy is established or claimed.
- **After:** capture the live launcher value and check it against the embedded
  probes, retaining banner text separately:
  ```python
  tools['python'] = sys.version.split()[0]
  ```
  CRC/coverage reports/receipts now identify measured Python 3.10.12. D59's
  earlier CRC version statement is corrected as metadata, not silently preserved.
- **Fail-before/pass-after:** `python_runtime/check_receipt.py` compares a receipt
  with the measured probe. Original receipts return 1/VERSION MISMATCH; corrected
  receipts return 0/VERSION MATCH. `run_probe.py --sim icarus` and `--sim verilator`
  each execute `runtime_probe.py` inside cocotb. Launcher JSON, both embedded
  runtime JSON/XML/logs, old receipts, and before/after comparison results are
  under `evidence/round2/python_runtime/`. Raw banner logs remain unchanged.
  No RTL, stimulus, comparison or verification result changed.

## BUG-070 — Evidence launcher resolved the virtualenv interpreter into system Python (tool, fixed)

- **Where:** the ad hoc Phase4 stress evidence-export/exit-reevaluation invocation.
  Actual simulator runs had already used the correct virtualenv launcher; this
  defect did not alter RTL, stimulus or recorded protocol outcomes.
- **Before:**
  ```python
  command = [str(Path(sys.executable).resolve()),
             'pbe_v1/test/stress/run.py', '--check-results', observations, *flags]
  ```
  Resolving the virtualenv symlink selected `/usr/bin/python3.10` and omitted
  virtualenv packages. All three reevaluations exited 1 with
  `ModuleNotFoundError: No module named 'cocotb_tools'`, including the required-only
  and characterization cases that should complete successfully. Those are
  environment-launch failures, not newly discovered DUT stress failures.
- **After:** preserve the virtualenv interpreter path:
  ```python
  command = [sys.executable,
             'pbe_v1/test/stress/run.py', '--check-results', observations, *flags]
  ```
- **Fail-before/pass-after:** repeat the identical saved 33-case evidence checks
  with flags `[]`, `['--required-only']` and `['--characterize']`. The before
  launcher fails the expected-exit regression with `[1, 1, 1]` and missing-module
  stderr. The corrected launcher yields `[1, 0, 0]`: strict retains the five
  adverse observations, required-only checks all 22 passing required cases, and
  characterization completes while preserving five FAIL labels. Exact commands,
  stdout/stderr and exit codes are in
  `pbe_v1/verification/evidence/round2/stress/stress_bug070_before_launcher.json`
  and `stress_exit_checks.json`. No dependency reinstall or failure waiver was
  used; the code change concerns the evidence-export invocation only.

## BUG-074 — SRAM prototype: one refetch after a host write read a stale word (design, D62 prototype)

- **Number:** logged as BUG-058; renumbered BUG-074 when round 2's BUG-058 to BUG-073 were merged (D64).
- **Where:** `src/tt_um_pbe.sv`, the `USE_SRAM` branch (D62), before its first commit.
- **Found by:** design review of the macro's timing, then confirmed by running the reviewed
  version as a mutation. The single-port macro cannot read in the clock it is written, so
  after a host write its output still holds the word read before. With D50's refetch alone
  (the engine's `pm_wr` = the write), the engine clears `iv` at the write and takes `DOUT` one
  clock later, which is that stale word: a stopped engine whose word the host rewrote runs the
  old instruction.
- **Before (reviewed version):**
  ```systemverilog
  assign eng_pm_wr = pm_wr;  // as with the flip-flop memory
  ```
- **After:** refetch again one clock after the write, when the macro has read again. The reset
  value refetches once after reset, when the macro's output is unknown.
  ```systemverilog
  always_ff @(posedge clk or negedge rst_n) begin
    if (!rst_n) pm_wr_q <= 1'b1;
    else pm_wr_q <= pm_wr;
  end
  assign eng_pm_wr = pm_wr || pm_wr_q;
  ```
- **Test:** `make test-sram`, `tb_fetch` Test 12, check (a) (the host rewrites the word a stopped
  engine is parked on, then runs it):
  - Before: `FAIL: (a) stopped on a word the host rewrote, then run: byte 0 is 11, expected 33`.
  - After: `PASS`.
- **Not caught by any test** (D62, investigation §3.7): `pm_wr_q` resetting to 0 (every test
  writes its program after reset, which refetches), and a refetch only one clock after the
  write (an instruction would have to complete in exactly that clock).
- **Now caught (D82):** both, by `tb_fetch` (g) (exactly 2 clocks lost per byte written to the
  engine's own memory at `CLKDIV` 0; a late-only or single refetch loses 1) and (h) (after a
  reset, without rewriting the memory, the engine must run word 0 first). See BUG-109. Since D82
  `pm_wr_q` is per engine (`logic [1:0]`, reset `2'b11`) and only the written engine refetches.

## BUG-075 — Stress bench imported the bus models from their pre-D63 location (merge interaction, fixed)

- **Where:** `verify/stress/test_stress.py` (round 2's `pbe_v1/test/stress/test_stress.py`).
- **Found by:** reading every path in round 2's new files while merging it with `main` (D64).
  Round 2 branched before D63 moved `pbe_v1/test/bus_models` to `verify/golden-model/bus_models`,
  and its stress bench reuses those third-party UART/SPI endpoints. Git merged both sides
  cleanly, so nothing flagged it; `make stress` is not part of `make test`.
- **Before:**
  ```python
  ROOT=Path(os.environ['PBE_ROOT'])
  sys.path.insert(0,str(ROOT/'pbe_v1/test/bus_models'))
  ```
- **After:**
  ```python
  sys.path.insert(0,str(ROOT/'verify/golden-model/bus_models'))
  ```
  (`verify/stress/run.py` sets `PBE_ROOT` to the repository root: `HERE.parents[1]`, was
  `HERE.parents[2]` one level deeper.)
- **Test:** `make stress`.
  - Before: the cocotb module fails to import, `ModuleNotFoundError: No module named 'test_buses'`;
    no observation is made and `make stress` exits 2.
  - After: 22/22 required observations pass in 60 s, each identical (settings, expected
    and actual bytes, status, IRQ) to round 2's `evidence/round2/stress/stress_required.json`.

## BUG-076 — Mutation scratch copy held only `pbe_v1`, so every mutant's `make test` failed on missing files (tool, fixed)

- **Where:** `verify/mutation/mutate.py` (round 2's `pbe_v1/tools/mutate.py`).
- **Found by:** reading its scratch-copy logic while merging round 2 with `main` (D64). The runner
  copies the design into a temporary directory, mutates one RTL line there and runs `make test`
  and `make diff`. It copied `pbe_v1` alone. After D63, `make test` runs scripts in
  `../verify/golden-model`, and after D62 it also needs `../macros` for `test-sram`; neither
  exists beside the copy. The runner classifies "No such file or directory" as
  `inconclusive-infrastructure-or-compile`, so `make diff` could judge no mutant: round 2's 17/24
  caught by `make diff` would have read 0/24.
- **Before:**
  ```python
  snapshot = Path(snapshot_dir.name)/'pbe_v1'
  shutil.copytree(PBE, snapshot, ignore=shutil.ignore_patterns('build','*.vvp','*.vcd','__pycache__','evidence'))
  ...
  scratch = tmp/'pbe_v1'
  shutil.copytree(snapshot, scratch, ignore=...)
  path = scratch/'src'/filename
  ```
- **After:** copy the part of the repository `make test` uses, keeping `pbe_v1/src` a link to
  the copied `../src`, and mutate that `src`:
  ```python
  SNAPSHOT = ('pbe_v1', 'src', 'macros', 'verify')
  IGNORE = shutil.ignore_patterns('build','*.vvp','*.vcd','__pycache__','evidence','sim_build','results.xml')
  ...
  for part in SNAPSHOT:
      shutil.copytree(ROOT/part, snapshot/part, symlinks=True, ignore=IGNORE)
  ...
  shutil.copytree(snapshot, tmp, symlinks=True, ignore=IGNORE, dirs_exist_ok=True)
  scratch = tmp/'pbe_v1'
  path = tmp/'src'/filename
  ```
- **Test:** the mutation M21 (empty-FIFO pop accepted), which `tb_fifo_robustness` catches
  (BUG-061): `mutate.py --only M21 --jobs 1 --out <scratch>`.
  - Before (round 2's runner on the merged tree): `test` caught (by `tb_fifo_robustness`), but `diff` is
    `inconclusive-infrastructure-or-compile`: `can't open file
    '/tmp/pbe-mutation-M21-.../pbe_v1/../verify/golden-model/differential/run.py'`. Every mutant's
    `make diff`, and the `make test` of any mutant that survives the SV benches, ends this way.
  - After: `test` caught by `tb_fifo_robustness` (`FIFO boundary: empty pop must be ignored
    count=31`), `diff` survived, as in round 2's recorded rerun
    (`evidence/round2/mutations/fifo-gap-rerun/M21.json`). A scratch copy also passes
    `make test-sram`, the spec-boundary check, the 24 model tests and the tool tests.

## BUG-077 — Icarus 12 `$isunknown` misreported a wide concatenation (tool, worked around)

- **Where:** `pbe_v1/test/tb_engine_known_reset.sv`, the four-state check after reset/restart.
- **Found by:** adding the CAN outputs (`can_tec`, `can_rec`, `can_state`, 19 bits) to the
  concatenation passed to `$isunknown`. The bench failed in reset with every signal printing as
  a known value; checking each signal alone with `$isunknown` gave 0 for all of them.
- **Repro (no design):** in Icarus 12, `$isunknown({a,a,a,a,a,a,a,a,b,e,a,a})` with all-zero
  8-, 21- and 7-bit wires returns 1 (87 bits); a different 106-bit concatenation of the same
  wires returns 0. The result depends on the concatenation, not on the values.
- **Before:**
  ```systemverilog
  if ($isunknown({pins_out,pins_oe,flag_set,flag_clr,tx_pop,rx_push,irq,rx_data,status,crc_now,pc,pc_copy,can_tec,can_rec,can_state}))
  ```
- **After:** the original concatenation (which Icarus evaluates correctly, as before) and a
  second one for the new outputs:
  ```systemverilog
  if ($isunknown({pins_out,pins_oe,flag_set,flag_clr,tx_pop,rx_push,irq,rx_data,status,crc_now,pc,pc_copy})
      || $isunknown({can_tec,can_rec,can_state}))
  ```
- **Test:** `tb_engine_known_reset` (now also every LINE bit field in CAN mode and with all
  LINE2 bits). Before: `FATAL ... unknown output cfg=00 cfg2=00` at 6 ns. After: PASS.

## BUG-078 — Icarus 12 aborts on two testbench constructs (tool, worked around)

- **Where:** `pbe_v1/test/tb_line_can.svh` (new, `tb_line` part E).
- **Found by:** the first run of part E: `vvp` aborted with
  `vthread_get_rd_context_item: Assertion 'running_thread && running_thread->rd_context' failed`
  and, after the first fix, `pop_value: Assertion 'value.size() == wid' failed`.
- **Before:**
  ```systemverilog
  for (int i = 0; i < cline.size(); i++) begin
    logic dom;                                   // a variable in the loop body
    ...
  for (int i = 10; i >= 0; i--) cbits.push_back(11'h123 >> i);   // 11 bits into a 1-bit queue
  ```
- **After:** the variable is declared at the top of the task, and pushed values are cast to the
  queue's element type: `cbits.push_back(logic'(11'h123 >> i));`.
- **Test:** `tb_line` part E runs (before: simulator abort, no result; after: E1–E6 pass).
  Same family as BUG-024 (Icarus 12 and queues).

## BUG-079 — FIFO mark/rewind formal property overflowed when the pointers wrapped (verification, fixed)

- **Where:** `verify/formal/fifo_properties.svh`, the new `F_MARK` section (task `mark` in
  `fifo.sby`).
- **Found by:** the first runs of the task: induction failed, and a depth-40 BMC failed at step
  34, the first step after `wptr` wrapped from 31 to 0, with every pointer equal to the model's.
- **Cause:** `(g_w - g_base) <= F_DEPTH`: `F_DEPTH` is a 32-bit integer, so the subtraction is
  done in 32 bits, and after a wrap `0 - 18` is negative, not 14. The RTL computes it in 5 bits.
- **Before:**
  ```systemverilog
  wire g_full = (g_w - g_base) == F_DEPTH;
  assert((g_w - g_base) <= F_DEPTH);
  assert((g_r - g_base) <= (g_w - g_base));
  ```
- **After:**
  ```systemverilog
  wire [ADDR_BITS:0] g_used = g_w - g_base, g_ahead = g_r - g_base;
  wire g_full = g_used == F_DEPTH;
  assert(g_used <= F_DEPTH);
  assert(g_ahead <= g_used);
  ```
- **Test:** `make formal FORMAL_BLOCK=fifo`. Before: `fifo_mark: FAIL` (BMC step 34) / `UNKNOWN`
  (induction). After: `fifo_mark: PASS` by induction (depth 32), with `fifo` and `fifo_cover`.

## BUG-080 — CAN error flag type taken after the error's own count (design, fixed before commit)

- **Where:** `src/pbe_bsync.sv`, the error branch.
- **Found by:** writing the reference node (`can_ref_node.sv`) from ISO 11898-1, which counts
  "when a transmitter sends an error flag": the flag is sent in the state the node was in when
  it detected the error. The RTL decided the flag type after adding the error's own +8.
- **Effect:** the 16th transmit error (TEC 120 → 128) sent a recessive (passive) flag instead
  of a dominant one: one error frame early.
- **Before:**
  ```systemverilog
  wire pas_new = tec_add >= 10'd128 || rec_sat >= 9'd128;
  ...
  cs <= C_EFLAG; flag_on <= 1'b0; flag_pas <= pas_new;
  ```
- **After:** `cs <= C_EFLAG; flag_on <= 1'b0; flag_pas <= passive;` (the state before the count).
- **Test:** `tb_can` scenario 5 (error-passive and bus-off) counts the active (6-bit dominant)
  flags on engine 0's TXD. With the old line put back in a scratch copy: `FAIL: error flags: 15
  active flags on engine 0's TXD, expected 16 (errors 1-16)`. With the fix: PASS (16 active,
  then passive).

## BUG-081 — `tb_line` D1 expected the wrong sample count (testbench, fixed before commit)

- **Where:** `pbe_v1/test/tb_line_can.svh`, `run_line2_tests` and `run_bsync_tests` E6.
- **Found by:** the first run: every sample point read 0 at both probe positions.
- **Cause:** the expected sample count was `P/2+1`; the RTL's documented rule (pbe_line header)
  is `floor(period_m1/2)+1` = `(P-1)/2+1`, one clock earlier for even `P`.
- **Before:** `sp = P / 2 + 1 + k * (P / 8);`  **After:** `sp = (P - 1) / 2 + 1 + k * (P / 8);`
- **Test:** `tb_line` D1 and E6. Before: `LINE2 sample point 0: X=18 read 0, X=19 read 0`.
  After: all four sample points read 1 then 0 at the two probe positions.

## BUG-082 — Reference CAN node lengthened a late bit by starting a new one (testbench, fixed before commit)

- **Where:** `pbe_v1/test/can_ref_node.sv`, the time-quantum loop.
- **Found by:** `tb_can` reference → chip: the reference reported an ACK error on every frame,
  while the chip drove the ACK slot (probe: chip ACK 208 ns after the reference's bit start,
  the loop delay). The reference's ACK slot lasted 4 quanta.
- **Cause:** a late edge (before the sample point) within SJW set the quantum counter to 0,
  and quantum 0 is where the loop starts a new bit.
- **Before:** `if (tqc <= SAMPLE) tqc = tqc - (tqc < SJW ? tqc : SJW);`
- **After:** `if (tqc <= SAMPLE) tqc = (tqc <= SJW) ? 1 : tqc - SJW;` (the edge ends the sync
  segment, ISO 11898-1 resynchronization).
- **Test:** `tb_can` scenario 1, reference → chip at 500k. Before: `FAIL: 500k ref->chip engine
  0 #0: engine 0 status 12, expected 02` and the reference's TEC 24. After: PASS.

## BUG-083 — A stopped engine's CAN coder stayed on the bus (design, fixed before commit)

- **Where:** `src/pbe_engine.sv`, the `pbe_bsync` clear.
- **Found by:** `tb_can` scenario 3 (ACK missing, engine 1 stopped): TEC went past 128 although
  a passive ACK error does not count. A probe showed engine 1's TXD dominant in EOF: its coder
  ran without a program (like `pbe_line`, which keeps running while stopped), acknowledged
  frames with a CRC that no `CRCRST` reset, and sent CRC error flags.
- **Before:** `.clear (restart || !bsm),`
- **After:** `.clear (restart || !bsm || !run),` — a stopped CAN node stays off the bus (D66);
  the counters are kept.
- **Test:** `tb_can` scenario 3. Before: `FAIL: ACK missing: TEC 152 state 010, expected 128`.
  After: PASS.

## BUG-084 — The next frame started from an abandoned unit (design, fixed before commit)

- **Where:** `src/pbe_bsync.sv`, frame start and late join.
- **Found by:** `tb_can` scenario 4: the reference received the retransmitted frame with ID
  0x20F instead of 0x0FF (CRC correct: the chip really sent 0x20F).
- **Cause:** the first unit was taken through the same `src` mux as any unit: `tleft != 0`
  (a unit cut short by the bit error) selected the stale shift register instead of `q_data`.
- **Before:** at frame start `tsh <= rest; cur <= nb;` (from `src = tleft != 0 ? tsh : q_data`),
  and an error left `tleft` as it was.
- **After:** the frame start and the late join use `q_first`/`q_rest` from `q_data`, and an
  error (and a dropped transfer outside a frame) clears `tleft`.
- **Test:** `tb_can` scenario 4. Before: `FAIL: bit error: reference got id 20f ..., expected id
  0ff`. After: PASS.

## BUG-085 — can_node resent frames that had gone out (program, fixed before commit)

- **Where:** `pbe_v1/programs/can_node.pbe`, `done`.
- **Found by:** `tb_can`'s first run: every frame was sent again and again (FLAG0 never cleared).
- **Before:**
  ```
  done:   STAT
          PUSH                 ; clears ISR
          FLAG 2, IRQ
          SET  OSR, 0x82
          JNE  again           ; always taken: ISR is 0
  ```
- **After:** compare before `PUSH`, and accept 0x8A too (the host's sticky RX-overflow bit
  would otherwise make a sent frame look failed):
  ```
  done:   STAT
          SET  OSR, 0x82
          JEQ  ok
          SET  OSR, 0x8A
          JEQ  ok
          REWIND
          JMP  rec
  ok:     FLAG 0, CLR
  rec:    PUSH
          FLAG 2, IRQ
          JMP  idle
  ```
- **Test:** `tb_can` scenario 1. Before: `FAIL: 125k chip->ref: engine 0 never finished
  sending`. After: PASS.

## BUG-086 — tb_can's host read one engine's count too late (testbench, fixed before commit)

- **Where:** `pbe_v1/test/tb_can.sv`, the IRQ reader.
- **Found by:** scenario 6 (arbitration between the two engines, frames back to back): engine
  1's record held bytes of its next record.
- **Cause:** the reader read engine 0's RX_COUNT and all its bytes, then engine 1's RX_COUNT;
  by then engine 1 had started pushing the next frame's first unit (about 16 bit times after
  the IRQ). The host protocol (D72) now says to read every count first.
- **Before:** `for e: if (irq[e]) begin read count; burst-read count bytes; parse; end`
- **After:** first `for e: if (irq[e]) read count`, then the burst reads.
- **Test:** `tb_can` scenario 6. Before: `FAIL: engine arbitration: B's frame (engine 1): engine
  1 status 40, expected 02`. After: PASS.

## BUG-087 — `make synth` missed `pbe_bsync.sv` (tool, fixed)

- **Where:** `pbe_v1/synth/synth.ys.in`, `pbe_v1/Makefile` (`synth`).
- **Found by:** the parent session's review of step 1: `make synth` failed with "Module
  `\pbe_bsync' ... is not part of the design". The Yosys script had its own copy of the source
  list; step 1 updated every other list (Makefile `SRC`, formal, vectors, stress, golden-model
  runners, `test/Makefile`, `info.yaml`, CI lint) but not this one.
- **Before:** `read_verilog -sv src/pbe_fifo.sv src/pbe_host_spi.sv src/pbe_crc.sv src/pbe_line.sv src/pbe_engine.sv src/tt_um_pbe.sv`
- **After:** `read_verilog -sv $SRC`, which the `synth` rule fills from the Makefile's `SRC`
  (`sed -e 's#\$$LIB#...#g' -e 's#\$$SRC#$(SRC)#'`), so the list cannot drift again.
- **Test:** `make synth`. Before: the error above. After: 384,756 µm², 17,358 cells.

## BUG-088 — Sample-point arithmetic on the bit counter's compare path (design timing, fixed)

- **Where:** `src/pbe_line.sv`, `src/pbe_bsync.sv`.
- **Found by:** the parent session's review of step 1: `make timing` went from 3.39 ns (main,
  `instr_q[10]` → mux) to 5.00 ns, starting at `clkdiv`. The sample count `floor(P/2) + 1 +
  N/4 + N/8` (two adders and an incrementer) fed the `cnt == sample` compare every clock.
- **Before:** `wire [15:0] spv = {1'b0, period_m1[15:1]} + 16'd1 + sp_add;` (bsync) and
  `wire [15:0] sp_cnt = {1'b0, period_m1[15:1]} + 16'd1 + sp_add;` (line).
- **After:** `spv` is a register loaded every clock with that sum (bsync); in `pbe_line` the
  non-default sample points use such a register, the default keeps the old expression
  (`sample = rcnt == ((sp_sel == 0 || sp_sel[2]) ? sp_base : sp_q)`), so LINE2 = 0 is cycle
  for cycle unchanged. A CLKDIV or LINE2 change reaches the sample point one clock later.
- **Test:** `make timing`. Before: `Delay = 4906.91 ps, Start-point = clkdiv[0]` (with the
  synth list fixed). After: `Delay = 3692.95 ps, Start-point = g_eng[1].u_eng.instr_q[10]`.
  `tb_line` D1/E6 (sample points), `tb_can`, `make test` and `make formal` still pass.

## BUG-089 — Unlimited resynchronization could postpone the next bit forever (design, fixed)

- **Where:** `src/pbe_bsync.sv`, the bit timer.
- **Found by:** the new formal block `bsync`, property F2 (error flag within one bit): a
  counterexample at step 53 with a falling edge on the receive pin every two clocks; each edge
  before the sample point restarted the current bit, so the next bit (and the error flag that
  waited for it) never came.
- **Cause:** ISO 11898-1 allows one synchronization between two sample points; the coder
  resynchronized on every allowed edge.
- **Before:** `wire resync = fall && !drv && in_bus;`
- **After:**
  ```systemverilog
  logic synced;   // set by a resync or frame start, cleared at the sample point
  wire resync = fall && !drv && in_bus && !synced;
  ```
- **Test:** `python3 verify/formal/run.py --block bsync`. Before: `bsync_bmc: FAIL` (F2, step
  53). After: `bsync_bmc: PASS` (depth 70) and both covers reached; `tb_line`, `tb_can` and
  `make diff-can` still pass.

## BUG-090 — tb_can used a forbidden identifier (testbench, fixed)

- **Where:** `pbe_v1/test/tb_can.sv`, scenario 1's remote frame `mkf(11'h7FF - i, ...)`.
- **Found by:** `make sigrok-can`: sigrok's `can` decoder reported "Identifier bits 10..4 must
  not be all recessive" for ID 0x7F6 and lost sync for the rest of the capture. CAN 2.0A forbids
  such identifiers; the chip and the reference node (which do not check it) passed it.
- **After:** `mkf(11'h7EF - i, ...)` (bits 10..4 = 1111110).
- **Test:** `make sigrok-can`. Before: `FAIL 500000 bit/s: 16 frames decoded, 20 expected`.
  After: PASS at all four bit rates.

## BUG-091 — The CAN differential ignored clock drift in its error-flag window (verification, fixed before commit)

- **Where:** `verify/golden-model/model/test_bsync_cocotb.py`, error trials.
- **Found by:** the first 40-trial `make diff-can`: `trial 11 error P=96 ppm=7476: flag at
  89399, bit after the error starts at 89399 (+4)` — the flag began 4 clocks before the
  window. The other node's clock was 0.75 % slow, and after 5 equal bits without an edge the
  coder's grid is legitimately up to 6 × 96 × 0.0075 ≈ 4 clocks ahead.
- **Before:** `assert nxt + LD - 2 <= flag_start <= nxt + LD + period // 2`
- **After:** `drift = int(6 * period * abs(ppm)) + 2;
  assert nxt + LD - drift <= flag_start <= nxt + LD + drift + period // 4`
- **Test:** `make diff-can` (seed 0x43414E, 40 trials of each kind). Before: trial 11 fails.
  After: see the run recorded in the final report.

## BUG-092 — The CAN node destroyed valid extended frames (design, fixed)

- **Where:** `pbe_v1/programs/can_node.pbe` and `src/pbe_bsync.sv`.
- **Found by:** the parent session's review of D69, which listed it as an accepted deviation:
  the program reads every frame with the standard layout, so an extended frame (or r0
  recessive) got the wrong data length, and the node flagged a stuff, form or CRC error on a
  valid frame. CAN 2.0 requires a 2.0A node to be at least 2.0B passive.
- **Before:** no handling; `LINE2[7]` reserved; D69: "an extended frame, or a standard frame
  with r0 recessive, is received as a remote frame with no data, so the node flags a stuff, form
  or CRC error on it".
- **After:** the frame follower (D74): when bit 13 (IDE) or, in a standard frame, bit 14 (r0) is
  recessive, `pbe_bsync` stops delivering units, ignores `LINECTL`, finds the last CRC bit from
  RTR and DLC (`flast <= hdr_end + 15 + n8`) and ends the stuffed region there; `can_node` sets
  LINE2 = 0xF2.
- **Test:** `tb_can` scenario 7 (`make test-can ONLY=ext`). Before (written first, run on the old
  coder): `FAIL: extended frame 0: engine 0 record of 5 bytes, status 10, base ID 155, IDE 1;
  expected ...` for every extended frame: an error record each time, and the reference had to
  send each frame again and again. After: PASS (every frame ACKed and sent once, no error flags,
  TEC/REC 0, standard 0x123 beats extended 0x123).

## BUG-093 — swd.pbe's byte counter read SWCLK one clock too early at CLKDIV = 0 (design, fixed before commit)

- **Where:** `pbe_v1/programs/swd.pbe`, the raw/write byte loop.
- **Found by:** the first run of `tb_debug +ONLY=swd`: `FAIL: engine 1: no RX byte`, and the
  SW-DP model never saw the switch. A trace of engine 1 showed ISR = 0x80 after `IN clk`: the
  byte counter took in a 1, so `JNE byte` looped, and the next record's command byte (0x00) was
  sent as 8 data bits. The design assumed a pin reaches the engine 2 clocks after it changes;
  it is 3 (two synchronizer stages, then the engine's registered decision). At CLKDIV = 0 the
  `IN clk` ran 2 clocks after `PIN clk, DRV0` and saw SWCLK still high.
- **Before:**
  ```
  bit:    PIN  dio, OUT
          PIN  clk, DRV1 [1]
          PIN  clk, DRV0
          JMP  X--, bit
  bcount: IN   clk
  ```
- **After:** the loop rotated, so the `OUT` of the next bit comes between `DRV0` and `IN clk`
  (3 clocks), and SWDIO is also set up longer before the rising edge:
  ```
          PIN  dio, OUT            ; the first bit
  bit:    PIN  clk, DRV1 [1]
          PIN  clk, DRV0
          PIN  dio, OUT            ; the next bit (after the last: a 0, unused)
          JMP  X--, bit
  bcount: IN   clk
  ```
- **Test:** `make test-debug ONLY=swd`. Before: `FAIL: engine 1: no RX byte` on the first
  transaction. After: the 7 SWD scenarios pass.

## BUG-094 — The SW-DP model counted a line reset as a protocol error (test, fixed before commit)

- **Where:** `pbe_v1/test/swd_dp.sv`, the request check.
- **Found by:** `tb_debug +ONLY=swd` with every scenario passing: `FAIL: SWD target saw 1 protocol
  errors`. A line reset that starts while the port is idle is first read as a request of eight
  ones (Stop = 1: invalid). The port ignores it and the reset then completes, which is what
  ADIv5 expects, so it is not an error of the host.
- **Before:** `n_proto_err++; st = LOCKOUT;`
- **After:** `if (req != 8'hFF) n_proto_err++; st = LOCKOUT;`
- **Test:** `make test-debug ONLY=swd`. Before: `FAIL: SWD target saw 1 protocol errors`. After:
  PASS with 0 protocol errors (and every bad request still counted).

## BUG-095 — A restart made a clock edge on a pulled-up TCK or SWCLK (test and board note, fixed)

- **Where:** `pbe_v1/test/tb_debug.sv`, the pin model; the board requirements in `docs/info.md`.
- **Found by:** the CLKDIV = 0xFFFF phase (`tb_debug +ONLY=slow`): `FAIL: DPIDR read (xxxxxxxx)`
  and `SWD target saw 1 protocol errors`. The phase restarts the engines with the SW-DP idle
  (the earlier phases start with a line reset, which hid it). A restart releases the engine's
  pins (D24) until the program's first `PIN clk, DRV0`; with every pin pulled up, SWCLK rose
  with SWDIO high, a start bit, and the port locked out.
- **Before:** `wire [7:0] chip_lvl = ~uio_oe | uio_out;  // released pins float high`
- **After:** TCK (pin 0) and SWCLK (pin 4) pulled down, as debug connectors usually do:
  `localparam logic [7:0] PULL_UP = 8'b1110_1110;
  wire [7:0] chip_lvl = (~uio_oe & PULL_UP) | (uio_oe & uio_out);`
  The datasheet and D75/D76 ask for the pull-downs.
- **Test:** `make test-debug ONLY=slow`. Before: the two failures above. After: PASS (IDCODE and
  DPIDR at CLKDIV = 0xFFFF).

## BUG-096 — swd.pbe read the ACK bits before the falling edge at CLKDIV = 0 (design, fixed before commit)

- **Where:** `pbe_v1/programs/swd.pbe`, the turnaround and ACK cycles.
- **Found by:** checking every sample point again after BUG-093's 3-clock latency. At CLKDIV = 0
  each ACK `IN` came 2 clocks after `PIN clk, DRV0 [1]`, so it saw SWDIO as it was 2 clocks
  (41.7 ns) after the rising edge that launched the bit; the data loop sees it 3 clocks after. A target
  driving SWDIO more than about 40 ns after the rising edge would give a wrong ACK.
- **Before:** `PIN clk, DRV0 [1]` before each of the three `IN dio` of the ACK (and the model's
  TCO 8 ns).
- **After:** `PIN clk, DRV0 [2]`: the `IN` sees SWDIO after the falling edge, 62.5 ns after the
  rising edge, like the data loop. The models' TCO in `tb_debug` is now 50 ns. Also `PIN dio,
  REL [1]` and `STAT [1]`, so the Park and read-turnaround cycles are 6 clocks like the rest
  (they were 5: SWCLK measured 9.6 MHz there, 8 MHz everywhere now).
- **Test:** `make test-debug ONLY=swd` with TCO = 50 ns. Before: `FAIL` on the first scenario
  (the DPIDR read's ACK is wrong) and every one after. After: PASS; a target 60 ns late passes,
  66 ns fails.

## BUG-097 — tb_debug's write-parity scenario counted WDATAERR since time 0 (test, fixed before commit)

- **Where:** `pbe_v1/test/tb_debug.sv`, SWD scenario 6.
- **Found by:** the first run of all four phases in one simulation (what `make test` does): phase
  3 `FAIL: write parity error rejected by the target`, while each phase alone passed. Phase 2's
  run of the same scenario had already set the model's counter to 1.
- **Before:** `sw_result("write parity error rejected by the target", ok && u_dp.n_wdataerr == 1);`
- **After:** `n1 = u_dp.n_wdataerr;` before the write, and `... && u_dp.n_wdataerr == n1 + 1`.
- **Test:** `make test-debug`. Before: the failure above. After: PASS.

## BUG-098 — The SW-DP model took a repeated JTAG-to-SWD sequence for a host error (test, fixed before commit)

- **Where:** `pbe_v1/test/swd_dp.sv`, the switch watcher.
- **Found by:** the same run: `FAIL: SWD target saw 1 protocol errors` at the end. Phase 3 starts
  with the switch while the port is already in SWD mode (from phase 2). The model watched for
  0xE79E only in JTAG mode; in SWD mode the sequence's bits after the first line reset read as a
  malformed request. ADIv5 sends the sequence between line resets precisely so that a port in
  either mode recovers, and an SWJ-DP keeps watching for it in SWD mode.
- **Before:** the 16 bits after 50 or more ones were collected and compared only `if (st == JTAG)`,
  and every malformed request but eight ones counted: `if (req != 8'hFF) n_proto_err++;`
- **After:** the watcher runs in both modes (in SWD mode a match leaves SWD selected and waits for
  the line reset); a request read from bits that so far match 0xE79E is not counted:
  `if (req != 8'hFF && !(sw_armed && ((sw_seq ^ 16'hE79E) & ((16'd1 << sw_k) - 16'd1)) == 0)) n_proto_err++;`
- **Test:** `make test-debug`. Before: the failure above. After: PASS, 0 protocol errors; the
  requests in scenarios 1–7 are still checked (a malformed request after a line reset that is
  not the switch sequence still counts).

## BUG-099 — sigrok's swd decoder samples the target's bits at the falling edge (tool limitation, recorded as an expected failure)

- **Where:** libsigrokdecode 0.5.3 `decoders/swd/pd.py` (unchanged): `next_state` sets
  `sample_edge = FALLING` for the ACK and read-data states.
- **Found by:** `make sigrok-debug` after BUG-096 raised the models' TCO to 50 ns: `FAIL swd:
  annotation 4: decoded 'ERROR', expected 'OK'` and 38 more ACKs decoded as ERROR or NOREPLY.
  At 8 MHz SWCLK is high for 41.7 ns, so at the falling edge a 50 ns-late target still shows
  the previous bit. ADIv5 requires the target's bit only at the host's sample point (before the
  next rising edge); `swd.pbe` reads it 62.5 ns after the rising edge, and the testbench passes.
- **Before:** one capture, with `make test`'s 50 ns targets, compared exactly.
- **After:** `debug_verify.py` decodes a capture with 20 ns targets (`-DPBE_TCO=20.0`), which
  must match exactly, and the 50 ns capture, where JTAG must match and SWD must show the exact
  signature: `['LINERESET', 'JTAG->SWD', 'LINERESET', 'IDCODE', 'ERROR']` (the host's bits,
  sampled at rising edges, right; the first ACK read one bit late), reported as XFAIL. Nothing in
  the decoder is changed.
- **Test:** `make sigrok-debug`. Before: `FAIL swd` (exit 1). After: `PASS jtag` and `PASS swd`
  at 20 ns, `PASS jtag` and `XFAIL swd` at 50 ns, exit 0.

## BUG-100 — Modbus RTU: a response whose start edge came during the idle timeout routine was lost

- **Where:** `pbe_v1/programs/modbus_rtu.pbe`, the idle wait.
- **Found by:** review, recorded as a known limit in D47: while idle the program's `TIMEOUT`
  (1.5 characters) fires every `TIMEOUT` + 3 ticks so it can poll the TX FIFO; the timeout
  routine (`tmo: JMP FLAG0, gap`, `JMP TX_EMPTY, idle`) runs for 3 ticks before
  `WAIT rx, FALL` waits again. `WAIT FALL` compares this clock's pin with the previous clock's
  and an edge is not latched (the cycle contract in `pbe_engine.sv`), so a start edge in those 3
  ticks was never seen. The program then took the first later falling edge inside the
  character for a start bit: the frame came out shifted, with parity errors and a bad CRC.
  Decision: D78.
- **Before (62 words):**
  ```
  idle:   WAIT rx, FALL [3]    ; start bit of a new frame (or a timeout -> tmo); then 1/2 bit
  ```
- **After (62 words):**
  ```
  idle:   WAIT rx, LOW [3]     ; start bit of a new frame (or a timeout -> tmo); then 1/2 bit.
  ```
- **Test (Test 5, `tb_pbe.sv`):** the device model can start its response a given time after
  the master turns its driver off (`mb_resp_at`); rounds 9–15 start it 0.1, 1.5 or 2.9 engine
  ticks after the third idle timeout (3 × (`TIMEOUT` + 3) ticks), at 19200 and 115200 baud, 8E1
  and 8N2, and once (round 15, 0.1 tick: the latest sampling) with the device's clock 1 % fast. The testbench checks
  that the response started where it was asked to.
  - Before: rounds 9–15 fail, e.g. `FAIL: Modbus round 9: host got 8 response bytes`,
    `FAIL: Modbus round 9 response byte 0: c0`, `FAIL: Modbus round 9: engine reported 4 parity
    errors`, `FAIL: Modbus round 9: CRC ok = 0`, and the same for rounds 10–15.
  - After: all 16 rounds and the RX overflow test pass.

## BUG-101 — USB: a token with a wrong stuff bit but intact bytes was answered

- **Where:** `pbe_v1/programs/usb_dev.pbe`.
- **Found by:** review, recorded in D48: after BUG-040 `JCRCBAD` rejects a DATA packet with a
  line error, but the program's `CRCRST` (which clears the line error) ran in `dat`, after the
  token, and IN tokens were never checked. USB 1.1 §7.1.9 and §8.7.1: a packet with a bit
  stuffing error is ignored, a token included. Decision: D79.
- **Before (64 words):**
  ```
  idle:   IN   dm, NOCRC
          JLINE idle
          SET  OSR, 0xD2
          JEQ  ack             ; the host's ACK for our DATA
          MOV  X, ISR
          IN   dm, NOCRC
  ...
  dat:    CRCRST               ; a checked packet starts: CRC and line error cleared
          PUSH
  ...
  deop:   MOV  ISR, X
          PUSH
          STAT
          JCRCBAD ack
          SET  OSR, 0xD2       ; ACK
          PIN  dm, OUT, NOCRC
          PIN  dm, END
  ack:    PUSH
          FLAG 2, SET
          FLAG 2, IRQ
          JMP  idle
  ...
  in:     JMP  FLAG1, stall
  ...
  send:   JMP  TX_EMPTY, nak
          PULL
          PIN  dm, OUT, NOCRC
          CRCRST
  ...
  sc:     OSRCRC LO, INV
          PIN  dm, OUT, NOCRC
          OSRCRC HI, INV
          PIN  dm, OUT, NOCRC
          PIN  dm, END
          JMP  idle
  ```
- **After (64 words; words 6 and 9, which the firmware patches, unchanged):**
  ```
  idle:   IN   dm, NOCRC
          JLINE idle
          CRCRST               ; token and DATA packet checked from here
          MOV  X, ISR
          IN   dm, NOCRC       ; token byte 2 (a handshake packet ends here instead)
          JLINE hsk
  ...
  dat:    PUSH
  ...
  deop:   MOV  ISR, X
          PUSH
          STAT
          JMP  ack
  hsk:    SET  OSR, 0xD2
          JNE  idle
  ack:    PUSH
          FLAG 2, SET
          FLAG 2, IRQ
          JCRCBAD idle         ; bad packet, or the host's ACK (CRC unfed): no ACK
          SET  OSR, 0xD2
          JMP  hs
  ...
  in:     STAT
          SET  OSR, 0x10
          JEQ  idle            ; a line error in the token: no answer
          JMP  FLAG1, stall
  ...
  send:   JMP  TX_EMPTY, nak
          PULL
          PIN  dm, OUT, NOCRC
  ...
  sc:     OSRCRC LO, INV
          PIN  dm, OUT, NOCRC
          OSRCRC HI, INV
          JMP  hs              ; the high byte and the EOP
  ```
- **Test (Test 11, `tb_usb.sv`):** at address 0x3F (six 1s in the token's second byte, so a
  stuffed 0 follows them), `h_bad_stuff = 2` sends that stuffed bit as a 1 in an IN, a SETUP and
  an OUT token; the SETUP and the OUT are followed by intact DATA packets.
  - Before: `FAIL: USB: device answered an IN token with a wrong stuff bit (1 bytes, PID 5a)`,
    `FAIL: USB: device ACKed a SETUP whose token had a wrong stuff bit`, `FAIL: USB: device
    ACKed an OUT whose token had a wrong stuff bit`, `FAIL: USB: firmware took 1 SETUP(s) from a
    token with a wrong stuff bit`, `FAIL: USB: firmware saw 0 bad records after the bad tokens,
    expected 2` (and the accepted junk SETUP broke the next GET_DESCRIPTOR: 6 bytes).
  - After: passes; every earlier step of Test 11 still passes, turnaround 3.16 to 3.28 bit times
    (was 3.00 to 3.19, allowed 2 to 7.5).

## BUG-102 — tb_line E4: the measured flag start depended on the simulator's process order (test)

- **Where:** `pbe_v1/test/tb_line.sv`, `tb_line_can.svh` (E4, and the same pattern throughout);
  audit of the other benches below.
- **Found by:** `make coverage` under Verilator 5.051 stopped at `tb_line`:
  `FAIL: bsync: flag after a bit error began 55 clocks after the bad bit, expected 1 bit (48..54)`.
  Icarus 12 measured 53 and passed. Every other bench passed under 5.051.
- **Cause (testbench, not RTL):** three things written and read at the same rising edge, by
  different processes, with no ordering between them:
  1. `clk_n++` in one `always @(posedge clk)`; E4's thread read `tb_start = clk_n` right after
     `@(posedge clk)`, so it got the count before or after the increment;
  2. the monitor block's `drv_on.push_back(clk_n)`, a second `always @(posedge clk)`, likewise;
  3. E4 forced the bus with `ext = 0` right after `@(posedge clk)`, while
     `always @(posedge clk) dline <= {dline[6:0], bus}` sampled `bus` at the same edge.

  Debug prints at the failing moment (the edge index k from `$time`):

  | | Icarus 12 | Verilator 5.020 |
  |---|---|---|
  | `tb_start = clk_n` after `@(posedge)` | k (after `++`) | k − 1 (before) |
  | `ext = 0` vs `dline` at that edge | sampled at k + 1 | sampled at k |
  | `drv_on` (other block) | edge − 1 (before `++`) | edge (after) |
  | measured `d` | 53 | 54 |

  In both runs the coder sets `drive` exactly 52 edges after the edge that first samples the
  forced level, so the RTL behaves identically; only the timestamps moved. 5.051's 55 is what
  resolving races 1 and 3 one way and race 2 the other gives. Reproduced with 5.051 (OSS CAD
  Suite 2026-07-27): `run.py --only tb_line` on d0c298f fails exactly as reported (55, at
  880440000 ps). The same old bench built without the coverage instrumentation passes under
  5.051. `prepare.py`'s cover blocks and `final` dumps change Verilator's process order, which is
  further evidence that the result depended on process order alone.
  Also found: `usb_drive` (test B) started at a rising edge, so with bits of 20·P·(1 ± 0.015) ns
  every 25th bit boundary fell exactly on a rising edge, a race with the coder's input
  register; and the reset was released at a rising edge (a race with the async-reset flops).
- **Before:**
  ```systemverilog
  always @(posedge clk) begin
    clk_n++;
  ...
  repeat (3) @(posedge clk);
  rst_n = 1;
  ...
      while (bgot.size() < 4) @(posedge clk);
      while (c.sampled) @(posedge clk);   // the 5th bit has started
      tb_start = clk_n;
      ext = 0;
  ...
  check(d >= PB && d <= PB + LD + 2, ...);
  ```
- **After:** one rule. `clk_n` is updated with a nonblocking assignment, so every process that
  reads it at a rising edge sees the same value (the number of earlier edges). Testbench threads
  act and read only after a falling edge, when every rising-edge update is done. Monitors stay
  on the rising edge. `usb_drive` starts at a falling edge, so no level change can land on a
  rising edge (10.4·n and 9.6·n mod 20 never equal 10). The E4 check is now the exact contract,
  because the measurement no longer depends on the simulator:
  ```systemverilog
  always @(posedge clk) begin
    clk_n <= clk_n + 1;
  ...
  repeat (3) @(negedge clk);
  rst_n = 1;
  ...
      while (bgot.size() < 4) @(negedge clk);
      while (c.sampled) @(negedge clk);   // the 5th bit has started
      tb_start = clk_n;
      ext = 0;
  ...
  check(d == PB + LD + 1, ...);   // one bit from the resync, which comes LD + 1 after the edge
  ```
  E3, E4 and E5 now print the measured clocks (4, 53, 37), so `make test-verilator` compares
  them between the simulators. `%+0.1f` became `%0.1f` (Verilator rejects the `+` flag), so the
  log needs no scratch adaptation. That makes the replacement in `verify/coverage/run.py`
  (BUG-069) a no-op.
- **Test:** `make test-verilator` (new, D80; in CI after the lint) runs `tb_line` and four
  other benches under Verilator and Icarus and requires both to pass with identical logs.
  - Before (the old timing with only the exact E4 check, the BUG-103 workaround and the format
    change applied): Icarus passes with 53; Verilator 5.020 fails with
    `FAIL: bsync: flag after a bit error began 54 clocks after the bad bit, expected 1 bit +
    loop delay + 1 (53)`; 5.051 under `make coverage` measured 55 and failed even the old window.
  - After: both pass with identical logs; E3 4 clocks, E4 53 (= PB + LD + 1), E5 37. Under
    5.051, plain and instrumented (`make coverage`), `tb_line` passes with the same values.
- **Audit of the other benches** (same patterns: a stimulus or a timestamp taken right after
  `@(posedge clk)`, or a counter read by another rising-edge process):
  - reset released at a rising edge: `tb_fetch`, `tb_usb`, `tb_pbe`, `tb_proto`, `tb_can` (twice),
    `tb_debug`, `tb_engine_restart`, `tb_engine_ops`. All now release after a falling edge. In
    `tb_engine_ops` this exposed BUG-104.
  - `tb_host.svh` (the host SPI shared by all chip-level benches): SCK, CS_n and MOSI changed at
    rising edges. They now change after falling edges.
  - `tb_can`: `clk_n++` in one block, read by the error-flag observer in a second rising-edge
    block and by two waits after `@(posedge clk)`. The observer moved into the counting block;
    the waits use `@(negedge clk)`.
  - Left as they are, with the reason: the protocol pin drivers in `tb_proto`, `tb_pbe` and
    `tb_can` (`ext_val`, `ext_drive`, `force_dom`) still change chip pins at rising edges. Those
    pins are asynchronous inputs behind the chip's two-flop synchronizers. A one-clock
    difference there is the real chip's uncertainty, and those checks allow for it (their windows
    are in bit times). Reading a DUT output right after a rising edge (`b[i] = bus[0]`,
    `rx[i] = bus[2]`) is not a race: outputs change in the NBA region, after every reader.
    `tb_fetch` timestamps `uio_out` changes with `always @(uio_out[0])`, which runs after the
    blocking `cyc++` of the same edge, and drives `pin1` after `#1`, so it is already race-free.
- **Gate-level flow:** not affected by the race and not run here (the gds and gl_regression
  workflows run by hand only). `tb_line` is a unit test of `pbe_line`/`pbe_bsync`, with
  hierarchical references to their internals, and is not part of `make test-gl` (`tb_fetch`,
  `tb_proto`, `tb_usb`, `tb_pbe` on the netlist). Those four take the falling-edge reset release
  and host SPI from this change. On a zero-delay netlist that removes the same race and changes
  no check. BUG-104's RTL change is in the netlist; see there.

## BUG-103 — Verilator 5.020 drops queue updates in two testbench idioms (tool)

- **Where:** Ubuntu 24.04's `verilator` 5.020 (the one CI installs), not 5.05x.
- **Found by:** running every bench under 5.020 for BUG-102.
  1. `tb_line` test B: `usb_encode`'s local queue `logic [7:0] all[$]` (an automatic task) kept
     its contents between calls, so the second packet was the first one twice and more:
     `FAIL: USB RX -1.5 %: 19 bytes, sent 9` (the encoded stream grew 87 → 171 → 243 states).
  2. `tb_engine_ops`: after `#1` inside `always @(posedge clk)`, `tx_q.pop_front()` did not shrink
     the queue (still 8 entries at every pop): `FAIL: 3 bytes pushed, expected 8`.
  3. `tb_proto` does not build: `disable isn't underneath a begin with name: 'watch_sda'`
     (already noted in D73 for 5.38).
  4. `tb_usb` (an unfixed copy, run once): `FAIL: USB: configuration descriptor (9): 16 bytes`,
     `FAIL: USB firmware: 2 bytes do not split into records` and 5 more. That looks like the same
     queue accumulation; not investigated further.
- **Before / after (1, worked around):**
  ```systemverilog
  ref_st.delete();
  all.push_back(8'h80);
  ```
  ```systemverilog
  ref_st.delete();
  all.delete();  // (BUG-103) release 5.020 of Verilator keeps an automatic task's local queue between calls
  all.push_back(8'h80);
  ```
  (A comment that starts with the word "verilator" is read as a pragma, hence the wording.)
- **2 to 4:** not worked around. These benches pass under 5.051 (the recorded campaign) and
  Icarus, so `make test-verilator` leaves them out of `VL_BENCHES` (D80).
- **Test:** `make test-verilator` with 5.020: `tb_line` fails at test B before and passes after.

## BUG-104 — After a reset the coders sampled at the first clock, not at the sample point (RTL)

- **Where:** `src/pbe_bsync.sv` (`spv`) and `src/pbe_line.sv` (`sp_q`, sample points 1–3). Both
  registers came in with BUG-088, which took the sample-point adders off the compare path.
- **Found by:** BUG-102's audit. Once `tb_engine_ops` released the reset between edges, its
  CAN-mode engine stopped after 4 of 16 bytes and TEC stayed 0. Its `pbe_bsync` stayed in
  integration for good with `icnt = x`.
- **Cause:** the registered sample count resets to 0 and holds the computed value only from the
  first clock after reset. On that first clock `cnt == 0 == spv` and `sampled == 0`, so
  `sample` fired: the coder read the bus at clock 0 of its first bit. Because `sampled` was then
  set, it did not sample again at the real sample point of that bit. In integration (or the idle
  count of `pbe_line`'s LINE2[6] wait) that bit was judged on one clock's level, against the
  header's contract ("the sample point is LINE2[2:0]"). On silicon this is a small timing error:
  integration up to most of a bit short. In four-state simulation the level one clock after
  reset can still be X from before reset: the X entered `icnt`, `icnt + 1` stays X, and the node
  never left integration. The old `tb_engine_ops` passed only because its reset release raced
  the flops, and the early sample happened to read a 1. `clear` (an engine restart) does not
  touch the register, so it was a reset-only fault.
- **Before:**
  ```systemverilog
  // pbe_bsync
  always_ff @(posedge clk or negedge rst_n)
    if (!rst_n) spv <= '0;
    else spv <= {1'b0, period_m1[15:1]} + 16'd1 + sp_add;
  wire sample = cnt == spv && !sampled;
  // pbe_line
  always_ff @(posedge clk or negedge rst_n)
    if (!rst_n) sp_q <= '0;
    else sp_q <= sp_base + sp_add;
  wire        sample = rcnt == ((sp_sel == 3'd0 || sp_sel[2]) ? sp_base : sp_q);
  ```
- **After:** a flag says the register holds a computed value (choice: D81):
  ```systemverilog
  // pbe_bsync
  always_ff @(posedge clk or negedge rst_n)
    if (!rst_n) begin
      spv    <= '0;
      spv_ok <= 1'b0;
    end else begin
      spv    <= {1'b0, period_m1[15:1]} + 16'd1 + sp_add;
      spv_ok <= 1'b1;
    end
  wire sample = cnt == spv && !sampled && spv_ok;
  // pbe_line
  ...same register, sp_ok...
  wire        sp_dflt = sp_sel == 3'd0 || sp_sel[2];
  wire        sample = rcnt == (sp_dflt ? sp_base : sp_q) && (sp_dflt || sp_ok);
  ```
- **Test (`tb_line` E0, new, written first):** with a reset just before it, `pbe_line` at sample
  point 3 and `pbe_bsync` at sample point 2 must each sample exactly once in the first bit, at
  their sample point.
  - Before, under both simulators: `FAIL: pbe_line after reset: 2 samples in the first bit, the
    first at count 0 (expected 1, at 28)` and `FAIL: pbe_bsync after reset: 1 samples in the
    first bit, the first at count 0 (expected 1, at 36)`.
  - After: `E0: after a reset the first sample is at the sample point (count 28 of 32, 36 of 48)`;
    `tb_engine_ops` passes with the race-free reset release.
- **Cost (`make synth`, Yosys 0.33, IHP typical):** 390,813.5 → 392,179.5 µm² (+0.35 %); flops
  3,906 → 3,907. Yosys merges the four identical `*_ok` flops into one. The rest is ABC
  remapping elsewhere (the cell mix changes all over the chip), not new logic.
  `make timing` (logic only, slow corner): 3.64 → 3.61 ns, the same start point (`clkdiv`).
- **Default configuration:** with LINE2 = 0, `pbe_line` uses `sp_base` (`sp_dflt`), so the
  change cannot reach it. This keeps the formal `default` equivalence's argument. CAN mode is
  only selected by LINE2[5].
- **Gate-level:** the netlist changes (one flop and the gating), so the next gds run carries it.
  The GL benches (`tb_fetch`, `tb_proto`, `tb_usb`, `tb_pbe`) run with LINE2 sample point 0
  and no CAN mode, where `sample` is unchanged. The gds and gl_regression workflows were not run.

## BUG-105 — tb_line E2 never reached the late-join window (test)

- **Where:** `pbe_v1/test/tb_line_can.svh`, E2.
- **Found by:** the coverage rerun (D73's new bins): 129/130, with `bsync_late_join` at 0. The
  late join is the path where a unit is queued after a foreign SOF's hard synchronization, but
  before that bit's sample point. Its condition is `cs == C_FRAME && sof && joinw && !sampled &&
  q_valid`.
- **Cause:** E2's comment said "c joins after the SOF began (the late-join window)". But its
  `bc_send` after two falling edges lands one clock *before* the hard synchronization: the
  winner's falling edge needs the 4-clock loop delay plus the input register to reach the coder.
  A debug print shows the unit queued at clock 29507 and `hard` at 29508 with `q_valid = 1`. That
  is the ordinary foreign start with a unit already queued (also worth testing, and it stays).
- **Before:**
  ```systemverilog
    begin   // c joins after the SOF began (the late-join window), then queues its bits
      repeat (2) @(negedge clk);
      foreach (mine[i]) bc_send(mine[i] ? 8'h80 : 8'h00);
  ```
- **After:** E2's comment says what it does, and a new E2b repeats E2's arbitration with the unit
  queued PB / 4 clocks after the hard synchronization:
  ```systemverilog
      while (c.cs != 3'd2) @(negedge clk);   // C_FRAME: the hard synchronization happened
      repeat (PB / 4) @(negedge clk);         // well before the sample point
      tb_start = clk_n;
      foreach (mine[i]) bc_send(mine[i] ? 8'h80 : 8'h00);
  ...
  check(n_ljoin == 1, ...);                              // the late-join path ran once
  check(drv_on[0] > tb_start && drv_on[0] - tb_start <= 3, ...);  // drove the SOF at once
  check(n_barb == 1, ...);   // its own frame: arbitration lost to 0x123 is reported
  ```
  plus the same received bits, no errors and REC = TEC = 0.
- **Test:** the RTL was right, so no fix fails first. Instead E2b was checked against a scratch
  copy with `late_join` forced to 0: `FAIL: bsync: 0 late joins, expected 1`, `FAIL: bsync: late
  join drove the SOF 996 clocks after the unit was queued, expected at once`, `FAIL: bsync: late
  join: 0 arbitration-lost pulses, expected 1`. On the real RTL: `E2b: late join 12 clocks into the
  winner's SOF: drove at once, lost to ID 0x123, received 19 bits, ACKed`, identical under Icarus
  and Verilator, and the bin is hit (130/130).

## BUG-106 — make coverage left out tb_debug (tool)

- **Where:** `verify/coverage/run.py`.
- **Cause:** the campaign's bench list and program-image list were written before `tb_debug`
  (D75–D77), and nobody added it. COVERAGE.md says every `make test` SV bench runs, but the JTAG
  and SWD programs and their testbench were not in it. Only `tb_can` had its extra model wired in.
- **Before:**
  ```python
  BENCHES=[...,'tb_pbe','tb_can','tb_spec_boundaries']
  IMAGE_TARGETS=[... for name in (...,'fetch','can','can_ops')]
  ... *([test/'can_ref_node.sv'] if tb=='tb_can' else []) ...
  ```
- **After:** `tb_debug` and the `debug` image are in the lists. The bench-side models are a table
  (`MODELS`) used for both the build and the reuse signature, which did not include
  `can_ref_node.sv` before:
  ```python
  BENCHES=[...,'tb_pbe','tb_can','tb_debug','tb_spec_boundaries']
  MODELS={'tb_can':['can_ref_node.sv'],'tb_debug':['jtag_tap.sv','swd_dp.sv']}
  ... *[test/m for m in MODELS.get(tb,[])] ...
  ```
- **Test:** the rerun's `runs.json` lists `tb_debug PASS` with a fresh coverage file; the
  `make test-coverage-tools` guards pass.

## BUG-107 — Icarus 12: a queue literal as a task argument crashes vvp; an unpacked array cannot be initialised from one (tool, worked around)

- **Where:** `pbe_v1/test/tb_fetch.sv`, the new checks (d)-(h) of D82, before their first commit.
- **Found by:** the first runs. An unpacked array declared with a literal initialiser stops
  elaboration (`sorry: Assignment to an entire array or to an array slice is not yet
  supported.`, `Elaboration failed`); with that removed, passing `'{...}` to a task's queue
  argument made `vvp` exit 139 (segmentation fault) before printing anything. Icarus 12.0
  (Ubuntu 24.04, the CI's).
- **Before:**
  ```systemverilog
  logic [15:0] wrap_prog[14] = '{16'h9610, 16'hDB80, ...};
  task automatic expect_bytes(input string what, input logic [7:0] want[$], input int n);
  expect_bytes("(f) ...", '{8'h61, 8'h62, 8'h63}, 3);
  ```
- **After:** the program is a function of the index, and the expected bytes are three
  arguments:
  ```systemverilog
  function automatic logic [15:0] wrap_word(input int i);
    case (i) 0: return 16'h9610; ... endcase
  endfunction
  task automatic expect_bytes(input string what, input logic [7:0] w0, w1, w2, input int n);
  expect_bytes("(f) ...", 8'h61, 8'h62, 8'h63, 3);
  ```
- **Test:** `make test` (`tb_fetch`): before, `Elaboration failed`, then exit 139 with no output;
  after, `PASS`.

## BUG-108 — tb_fetch (g): the program's first DRV0 shifted the edge count when pin 0 started high (test)

- **Where:** `pbe_v1/test/tb_fetch.sv`, check (g) (D82), before its first commit.
- **Cause:** (g) numbers engine 0's pin 0 edges from the first `TOG` of a pass and expects a
  3-clock gap at the start of each pass of 62 (the `JMP` and its bubble), 1 clock otherwise.
  `fetch_stream.pbe` starts with `PIN 0, DRV0`. The first run left the pin low, but the second
  run started where the first had stopped, sometimes high: `DRV0` then made an edge of its own,
  and every gap was compared with the position one off.
- **Before:**
  ```systemverilog
  edges.delete();
  reg_write(7'h00, 8'h11);
  ...
  reg_write(7'h00, 8'h00);
  stream_extra(extra, grown, bad);
  ```
- **After:** the pin level at the start is recorded, and the `DRV0` edge dropped:
  ```systemverilog
  task automatic stream_start;
    stream_high = uio_out[0];
    edges.delete();
    reg_write(7'h00, 8'h11);
  endtask
  task automatic stream_stop;
    reg_write(7'h00, 8'h00);
    if (stream_high) void'(edges.pop_front());
  endtask
  ```
- **Test:** `tb_fetch` (g), second run: before, `FAIL: ... 226 gaps grew, by 24 clocks in all,
  107 not by 2`; after, the expected 2 clocks per write (see BUG-109 for the count).

## BUG-109 — tb_fetch (g) counted one write per word; a word is two byte writes (test)

- **Where:** `pbe_v1/test/tb_fetch.sv`, check (g) (D82), before its first commit.
- **Cause:** each `pm_write` sends a word as two `PM_DATA` bytes (high, then low) in one burst,
  about 128 clocks apart. Each byte is a write to the macro, with its own two refetches. The
  check expected `nw` longer gaps for `nw` words.
- **Before:**
  ```systemverilog
  check(grown == nw && bad == 0 && extra == 2 * nw, ...);
  ```
- **After:**
  ```systemverilog
  // each word is two PM_DATA writes (its high and low byte), 128 clocks apart
  check(grown == 2 * nw && bad == 0 && extra == 4 * nw, ...);
  ```
- **Test:** `tb_fetch` (g): before, `FAIL: (g) 6 writes to engine 0's own memory: 12 gaps grew,
  by 24 clocks in all, 0 not by 2; expected 6 gaps, 2 clocks each`; after, `(g) 12 byte writes to
  engine 0's own memory: 12 gaps grew by 24 clocks in all (2 each)` and `PASS`. With BUG-074's
  single refetch, or with only the late refetch (`eng_pm_wr = pm_wr_q`), (g) reports
  `12 gaps grew, by 12 clocks in all, 12 not by 2` and fails; with `pm_wr_q` resetting to 0, (h)
  fails (`byte 0 is 00, expected 62`). These were BUG-074's two cases "not caught by any test".

## BUG-110 — sram/flow.patch would have left the SRAM macros unpowered (flow, retired)

- **Where:** `sram/flow.patch`, `sram/config.json`, `sram/pdn_cfg.tcl` (D62's proposal; never
  applied to `main` or run in the `gds` workflow).
- **Cause:** on SG13CMOS5L the tile's power grid is one layer of vertical Metal4 stripes, and the
  macro's supply pins (`VDD!`, `VDDARRAY!`, `VSS!`) are Metal4 columns. The patch chose a
  stripe pitch and offset (67.44 µm, 25.40 µm) to put stripes over the columns, and a `pdn_cfg.tcl`
  that let pdngen draw through the macros. But pdngen cuts its stripes around a macro, and
  nothing completed the connection: Tiny Tapeout's example does it with a flow step of its own,
  `Project.ExtendPowerStripes` (`librelane_plugin_sram_pdn.py`, `odb_stripes.py`, after
  `OpenROAD.GeneratePDN`), which moves the stripes onto the columns and completes the VPWR/VGND
  pairs. Without it the macros' supply columns could stay unconnected: LVS and the IR-drop
  report would fail, or worse, the precheck would pass a design with dead memories.
- **Before** (`sram/config.json`, abridged):
  ```json
  "PDN_CFG": "dir::../sram/pdn_cfg.tcl",
  "FP_PDN_VPITCH": 67.44, "FP_PDN_VOFFSET": 25.40, "FP_PDN_VSPACING": 3.52, "FP_PDN_VWIDTH": 2.1,
  ```
- **After:** `sram/` is deleted (D82; in git history at `ea6672f`). The flow follows the example:
  `meta.substituting_steps` `{"+OpenROAD.GeneratePDN": "Project.ExtendPowerStripes"}`, its
  `pdn_cfg.tcl`, `FP_PDN_VPITCH` 44.96, `VWIDTH` 2.1, `VSPACING` 3.52, `VOFFSET` 6.15, both
  macros at x = 3.36 µm. The owner makes these changes (`docs/SRAM_8x4_FLOW_STEPS.md`).
- **Test:** none can run here (no LibreLane in this repository's tests). The check is in the
  flow: the `*-project-extendpowerstripes` log must list stripes on both macros, LVS must match,
  and the IR-drop report must say all VPWR/VGND shapes are connected (the guide, "What to check").

## BUG-111 — The flip-flop fallback wrapped write addresses mod 64: a full image erased the program (RTL, fixed)

- **Where:** `src/tt_um_pbe.sv`, the `PBE_PMEM_FF` branch (D82), before its first push.
- **Cause:** the fallback has 64 words per engine and used the pointer's word bits [5:0] for
  writes as well as reads. The testbenches' `load_program` writes all 256 words of each
  engine's image (no word left unknown in the SRAM), so words 64-255, zeros, landed on 0-63
  after the program and erased it. Found the first time `make test` ran `make test-ff`.
- **Before:**
  ```systemverilog
  always_ff @(posedge clk) begin
    if (pm_wr_e[0]) begin
      if (pm_ptr[0]) pmem0[pm_word][7:0] <= wr_data;
  ```
- **After:** writes to words 64-255 are dropped; reads still wrap mod 64.
  ```systemverilog
  wire pm_low = pm_ptr[8:7] == 2'b00;  // a word below 64
  always_ff @(posedge clk) begin
    if (pm_wr_e[0] && pm_low) begin
      if (pm_ptr[0]) pmem0[pm_word][7:0] <= wr_data;
  ```
- **Test:** `make test-ff`, `tb_usb` on the fallback: before, `FAIL: USB: bus not idle in J with the
  device released`, `FAIL: USB: SETUP not ACKed`, ... and `make test` exits 2; after, `PASS` (and
  `tb_proto` `PASS`).

## BUG-112 — tb_page initialised a variable in its declaration inside a block (test)

- **Where:** `pbe_v1/test/tb_page.sv`, check (d) (D83), before its first commit.
- **Cause:** a declaration with an initialiser inside a procedural block makes a static variable,
  initialised once at time 0, not each time the block runs (BUG-023). Here it ran once, so the
  result was right, but `make test`'s lint step fails on Icarus's warning by design.
- **Before:**
  ```systemverilog
  begin
    int bad = 0;
  ```
- **After:**
  ```systemverilog
  begin
    int bad;
    bad = 0;
  ```
- **Test:** `make test` (its `LINT` step): before, `tb_page.sv:107: warning: Static variable
  initialization requires explicit lifetime in this context.` and the step fails; after, no warning.

## BUG-113 — tb_page did not check that a timeout clears a PAGE (test)

- **Where:** `pbe_v1/test/page_test.pbe`, `tb_page` (a) (D83), before their first commit.
- **Cause:** the RTL clears the PAGE prefix on a timeout jump (`restart || tmo_hit || lv_hit`).
  (a) timed out on a `WAIT` with no PAGE before it, and the vector's first instruction was not
  a jump, so a fault that kept the prefix across the timeout (`restart || lv_hit`) still passed.
- **Before** (`page_test.pbe`):
  ```
  vec:    SET  OSR, 0x15
  ...
  tw:     WAIT FLAG 1, HIGH
  ```
- **After:** a `PAGE 2` executes before the `WAIT` that times out, and the vector starts with a
  jump inside page 0, which a kept PAGE 2 would send to page 2:
  ```
  vec:    JMP  vec2
  vec2:   SET  OSR, 0x15
  ...
  tw:     PAGE 2
          WAIT FLAG 1, HIGH
  ```
- **Test:** `tb_page` against the fault: before the change, `PASS`; after it, `FAIL: (a) ... byte
  5 is 13, expected 15`. On the RTL as it is, `PASS` both times.

## BUG-114 — Verilator -Wall lint failed on the unused low bits of `cur_off` (tool)

- **Where:** `src/pbe_engine.sv`, the PAGE jump-page logic (D83), commit `fc0c7fe`. The
  `regression` workflow failed on `feature/sram-8x4` from that commit on; its later steps
  (`make test`, the two-simulator check) were skipped. Reviews ran `make test` and
  `make test-verilator` but not the `-Wall` lint, so it was not seen before push.
- **Cause:** `cur_off` is the full 8-bit offset `pc - 1 - start_pc`, but only its page bits [7:6]
  are used. Verilator `-Wall` reports `UNUSEDSIGNAL` for bits [5:0], and the lint step treats any
  warning as an error. No functional effect.
- **Before:**
  ```
  wire  [7:0] cur_off = pc - 8'd1 - start_pc;
  wire  [1:0] j_page  = pg_set ? pg_num : cur_off[7:6];
  ```
- **After:** the low bits are marked unused, as elsewhere in the RTL (`_unused`):
  ```
  wire  [7:0] cur_off = pc - 8'd1 - start_pc;
  wire  [1:0] j_page  = pg_set ? pg_num : cur_off[7:6];
  wire        _unused_cur_off = &{cur_off[5:0], 1'b0};  // only the page bits are used (BUG-114)
  ```
- **Test:** the `regression` workflow's lint step (`verilator --lint-only -Wall`, both builds):
  before, `%Warning-UNUSEDSIGNAL: pbe_engine.sv:472:15: Bits of signal are not used:
  'cur_off'[5:0]` and exit 1; after, no warnings, exit 0.

## BUG-115 — The PS/2 device model took its own clock edges for a request to send (test)

- **Where:** `pbe_v1/test/ps2_dev.sv`, written for D84.
- **Cause:** the model recognised a request to send as "a rising CLK edge with DATA low while
  the device is not clocking", using a `dev_clocking` flag. Clearing the flag at the device's
  last clock edge (to allow the host to inhibit right after a frame, which PS/2 allows) made the
  device's own last rising edge, with DATA still low from the ACK, look like a request: the
  model clocked a phantom byte, the host read `0xFF`.
- **Before:**
  ```systemverilog
  always @(negedge clk_line) if (!dev_clocking) clk_fell = $realtime;
  always @(posedge clk_line)
    if (!dev_clocking) begin
      inhibit = $realtime - clk_fell;
      if (!dat_line) ... rts = 1;
  ```
- **After:** a falling edge the device did not make itself (`clk_low` = 0) is the host's; only
  the rising edge that ends it can be a request to send.
  ```systemverilog
  always @(negedge clk_line)
    if (!clk_low) begin
      host_low = 1;
      clk_fell = $realtime;
    end
  always @(posedge clk_line)
    if (host_low) begin
      host_low = 0;
      inhibit = $realtime - clk_fell;
      if (!dat_line) ... rts = 1;
  ```
- **Test:** `tb_ps2`: before, `expected fa 00, got ff 00` in scenarios 2-6 (`passed: 1 of 8`);
  after, `PASS: PS/2 host`.

## BUG-116 — tb_ps2 queued a command before the device's byte had started (test)

- **Where:** `pbe_v1/test/tb_ps2.sv`, scenario 8 (a command queued while the device sends).
- **Cause:** the bench waited for `u_dev.dev_clocking` to queue the command during a device
  byte. The record of the previous byte is pushed during its stop bit, before the device's last
  clock pulse, so the flag was still 1 from that byte: the command went out first.
- **Before:** `wait (u_dev.dev_clocking);`
- **After:** `wait (!u_dev.dev_clocking); wait (u_dev.dev_clocking);`
- **Test:** `tb_ps2` scenario 8: before, `expected 5a 00, got ed 20`; after, `PASS`.

## BUG-117 — The PS/2 timeout record carried a meaningless parity bit (design)

- **Where:** `pbe_v1/programs/ps2_host.pbe`, the timeout vector (D84).
- **Cause:** the vector reported `STAT` as the status. With odd parity set, `STAT` bit 0 is 1
  when no bit has been read since the last `STAT` (a request to send never clocked), so the
  record read `[0x00][0x05]` instead of the documented timeout `[0x00][0x04]`.
- **Before:**
  ```
          STAT
          MOV  OSR, ISR
          MOV  ISR, 0
  ```
- **After:** `STAT` only clears "timeout happened"; the status is the constant 0x04.
  ```
          STAT
          SET  OSR, 0x04
          MOV  ISR, 0
  ```
- **Test:** `tb_ps2` scenario 7: before, `FAIL: no clock after a request to send: timeout (00 04)`;
  after, `PASS`.

## BUG-118 — tb_ps2 waited for a device byte it never queued (test)

- **Where:** `pbe_v1/test/tb_ps2.sv`, scenario 5 (a device byte with a 0 stop bit, then a good
  byte to show the framing is back).
- **Cause:** the scenario expected the space key (`0x29`) after the bad byte but only queued the
  bad byte in the device model. The host program waited, timed out after 20 ms and reported
  `[0x00][0x05]`. While looking for it, the program was first suspected (a framing error leaves
  DATA low after the last clock edge); running the old program against the corrected bench
  passes, so the program was right. The `WAIT dat, HIGH` added at the end of its receive path
  stays as a guard (D84), not as a fix.
- **Before:**
  ```systemverilog
  u_dev.bad_stop_next = 1;
  u_dev.tx_q.push_back(8'h3C);
  rx_rec(b, s);
  ```
- **After:**
  ```systemverilog
  u_dev.bad_stop_next = 1;
  u_dev.tx_q.push_back(8'h3C);
  u_dev.tx_q.push_back(8'h29);
  rx_rec(b, s);
  ```
- **Test:** `tb_ps2` scenario 5: before, `expected 29 00, got 00 05`; after, `PASS` (with and
  without the program's `WAIT dat, HIGH`).

## BUG-119 — tb_la's counter check failed when the stimulus was phase-locked to the sampling (test)

- **Where:** `pbe_v1/test/tb_la.sv`, the check of a free-running capture (D86).
- **Cause:** the stimulus counter advanced every 3 sample periods exactly, so every transition
  fell at the same point of the sampling: between the reads of channel 0 and channel 1. A
  0 → 1 change then read as the old value (only channel 0 changes, and it was read first), so
  runs came out 4, 2, 4, 2 samples long; the check allowed 2-4 but expected the boundary
  sample to differ from the old value. The capture was right.
- **Before:** `la_free(16'd1, 16, 3, ...)` (a whole number of samples per value) and
  `if (runs > 0 && (run + 1 < per - 1 || run > per + 1))`.
- **After:** non-integer steps (`3.4`, `3.3`, `5.2` samples), so the transitions sweep every
  phase, and runs between `per - 2` and `per + 1` (a boundary sample may read entirely as the
  old value): `if (runs > 0 && (run + 2 < per || run > per + 1))`.
- **Test:** `tb_la` burst at `CLKDIV` 1: before, `FAIL: ... sample 1: 0 after 1` (samples
  `1000113222335444...`, each 0 → 1 boundary read as 0); after, `PASS ... 10 values`.

## BUG-120 — tb_la's generator grid used the nominal clock period, not the simulated one (test)

- **Where:** `pbe_v1/test/tb_la.sv`, the generator's edge-grid check (D86).
- **Cause:** the bench's clock is `#(20.8333 / 2)`, which the 1 ps time precision rounds to
  10.417 ns: the simulated period is 20.834 ns. The grid was computed from 20.8333 ns, so after
  1,600 clocks the expected edge times were 1.1 ns early and the 1 ns tolerance failed.
- **Before:** `tick = (div + 1) * CLK_NS;`
- **After:** `localparam real CLK_SIM = 20.834;` and `tick = (div + 1) * CLK_SIM;`
- **Test:** `tb_la`, 64 bytes streamed at `CLKDIV` 4: before, `A edge 34 at sample 80.00: off the
  grid` (80.003); after, `PASS`.

## BUG-121 — tb_la expected rates the host port cannot carry (test)

- **Where:** `pbe_v1/test/tb_la.sv`, first version.
- **Cause:** two scenarios asked for more than the host port moves (one byte per 64 clocks at
  SCK = clk / 8): a 24-byte capture at `CLKDIV` 3 (one byte per 48 clocks, so the FIFO filled
  and the engine correctly reported an overflow), and generator records written byte by byte
  with `fifo_send` (a status read and a write per byte, about 300 clocks) while the generator
  played one byte per 32 clocks, so it ran dry and held samples (correctly, but off the grid).
- **Before:** `la_free(16'd3, 24, 5, "CLKDIV 3 (2 MS/s)")`; the generator started as soon as
  its first byte arrived.
- **After:** the `CLKDIV` 3 capture is a 16-byte burst; the generator's count and first 15 bytes
  are queued with the engine stopped, then it runs and the rest follows in one burst write. The
  real limits were then measured and documented (D86).
- **Test:** `tb_la`: before, `FAIL: CLKDIV 3 (2 MS/s): 48 samples ... RX overflow reported` and
  `FAIL: generator 8 bytes queued, CLKDIV 1`; after, `PASS: logic analyser and generator`.

## BUG-122 — tb_qspi pushed 32-bit random values into a byte queue (test)

- **Where:** `pbe_v1/test/tb_qspi.sv`, the quad page program scenario (D87).
- **Cause:** `wq` is a queue of bytes; `wq.push_back($urandom)` pushes a 32-bit value. Icarus
  does not truncate it: `vvp` stopped with `Assertion 'value.size() == wid' failed` in the
  middle of the run (the earlier scenarios' output was lost in the stdout buffer, which made it
  look like a crash at time 0).
- **Before:** `for (int i = 0; i < 24; i++) wq.push_back($urandom);`
- **After:** `for (int i = 0; i < 24; i++) wq.push_back(8'($urandom));`
- **Test:** `tb_qspi`: before, the simulator aborts after scenario 5; after, `PASS: QSPI`
  (12/12).

## BUG-123 — The HDLC transmitter's own receiver saw a frame after the last flag (design)

- **Where:** `pbe_v1/programs/hdlc_tx.pbe`, the end of the last frame (D88).
- **Cause:** after the last frame the program sent the flag's final 0 as a coder frame of one
  bit, then `END`. The coder lets go of the line at the end of that bit; its receiver (idle in
  a transmit-only engine, but still on) sees the pin through the 2-clock synchronizer, so for 2
  clocks after the release it still saw the 0, took it for a frame start and then overran on
  the idle 1s it was never asked for: `STATUS` bit 4 (line error, documented as "underrun")
  was set after every burst of frames, although the frames were good.
- **Before:**
  ```
          SET  OSR, 0x00
          PIN  tx, OUT, NOCRC     ; no frame: the flag's last 0 alone, then mark idle
          PIN  tx, END
  ```
- **After:** the flag's last 0 and then a 1 (idle mark), so the coder lets go of a high line:
  ```
          SET  OSR, 0x02
          PIN  tx, OUT, NOCRC
          PIN  tx, OUT, NOCRC
          PIN  tx, END
  ```
- **Test:** `tb_hdlc` transmit phases: before, `the transmitter reported a line error
  (underrun)` and `FAIL: TX, CLKDIV 47` (and 23, 11); after, `PASS`. A probe on the coder's
  `err` showed it in the receive state (`rs` = 1) at the idle `PULL`.

## BUG-124 — The HDLC model's transmitter never woke for its second batch (test)

- **Where:** `pbe_v1/test/hdlc_model.sv`, the transmitter loop (D88).
- **Cause:** the loop waited with `wait (q_len.size() > 0)`. Icarus does not re-evaluate a
  `wait` on a queue's size when the queue grows; the first batch worked only because frames
  were queued before the first wait ended. The second receive phase timed out with every frame
  "not received" (the model had sent 8 frames and held 5 more).
- **Before:** `wait (q_len.size() > 0);`
- **After:** `while (q_len.size() == 0) #(100);   // (Icarus does not wake a wait on a queue's size)`
- **Test:** `tb_hdlc` phase `RX, CLKDIV 23` after the 1 Mbit/s phases: before, `frame 0: not
  received` ... `FAIL`; after, `PASS` (and the phase passed alone before the fix).

## BUG-125 — tb_pbe checked the Modbus IRQ pin inside the tick between FLAG2 and IRQ (test)

- **Where:** `pbe_v1/test/tb_pbe.sv`, the Modbus rounds (Test 5).
- **Cause:** `modbus_rtu.pbe` ends a frame with `FLAG 2, SET` and then `FLAG 0, IRQ`, one tick
  later (at 19200 baud a tick is an eighth of a bit, 6.5 µs: about 310 clocks). The bench reads the flag
  (`flag_get`), drains the FIFO and then checks the IRQ pin at once. With the single-lane host
  the reads took longer than the tick, so the pin was always up; with the quad host (D89, 4x
  faster) the check landed inside the tick: `FAIL: Modbus: no IRQ at the end of the response`
  in 8 rounds. The chip was right: the program raises IRQ one tick after the flag.
- **Before:**
  ```
      mb_receive;
      check(uo_out[1], "Modbus: no IRQ at the end of the response");
  ```
- **After:** wait up to 2 ticks for the pin:
  ```
      mb_receive;
      for (int t = 0; t < 2 * (mb_div + 1) && !uo_out[1]; t++) @(negedge clk);
      check(uo_out[1], "Modbus: no IRQ at the end of the response");
  ```
- **Test:** `make test-quad` (`tb_pbe` with `+QUAD`): before, 8 errors; after, `PASS`. The
  single-lane run is unchanged.

## BUG-126 — tb_host's host_quad_on wrote HOSTCFG = 0 right after switching to quad (test)

- **Where:** `pbe_v1/test/tb_host.svh`, `host_quad_on` (D89).
- **Cause:** `host_quad_on` set `host_want_quad` and then ran a dummy transaction so that `cs()`
  would switch the port first. The dummy was `reg_write(7'h50, 8'h00)`: after the switch
  (which writes `HOSTCFG` = 1 in single mode), it wrote `HOSTCFG` = 0 in quad mode, so the chip
  went back to single mode at that CS_n high while the host stayed in quad. `tb_quad` (b):
  `FAIL: (b) HOSTCFG reads 1 in quad mode`, and every check after it.
- **Before:**
  ```
    host_want_quad = 1;
    reg_write(7'h50, 8'h00);  // any transaction: cs() switches first
  ```
- **After:** a read, which changes nothing:
  ```
    host_want_quad = 1;
    reg_read(7'h50, d);  // any transaction: cs() switches first
  ```
- **Test:** `tb_quad` (b)-(e): before, 6 failures; after, 16/16 `PASS`.

## BUG-127 — Icarus 12 failed on three testbench constructs of tb_quad and tb_line M (tool)

- **Where:** `pbe_v1/test/tb_host.svh` (quad `spi_byte`), `tb_quad.sv`, `tb_line_manch.svh`.
- **Cause:** limits of Icarus Verilog 12, each found by a failing run, none in the RTL:
  1. `return` inside a task: `error: Cannot "return" from tasks`;
  2. a queue passed to an automatic task, and a queue element's bits selected with a variable
     index (`rx[n*4+:4]` into an output argument, `mt_q[i][2]`): elaboration errors or
     `vvp: ... Assertion 'running_thread && running_thread->rd_context' failed` at run time;
  3. a `real` array (or several real locals) inside an automatic task: the same `rd_context`
     assertion at time 0, before the first test (found by bisecting the include file).
- **Before:** for example `task automatic run_manch_tests(); ... real ppms[6], jits[6];`, and
  `rx[n*4+:4] = uo_out[3:0];` in a `for (int n = 1; n >= 0; n--)` loop.
- **After:** `if/else` instead of `return`; fixed-size module-level arrays and three `int` queues
  instead of queue arguments and bit selects of queue elements; the nibble loop unrolled
  (`rx[7:4]`, `rx[3:0]`); `run_manch_tests` and `manch_drive` static tasks with module-level
  reals. The same constructs are avoided in the rest of the new benches.
- **Test:** `tb_quad` and `tb_line` (M1-M7) run to `PASS` under Icarus; `tb_line` also under
  Verilator (`make test-verilator`, identical logs).

## BUG-128 — The Manchester bit timer moved its reference 3/4 of the error, not 1/4 (design)

- **Where:** `src/pbe_line.sv`, Manchester receive (D90), found before the first commit.
- **Cause:** `mcnt` holds the time since the reference. After a mid-bit edge that came e late,
  the reference should move e/4 (towards the edge), so the edge is then e - e/4 after it. The
  code stored e/4, the time after a reference moved 3e/4: a loop of gain 3/4, which follows each
  jittered edge almost fully.
- **Before:** `else if (m_mid) mcnt <= m_err >>> 2;`
- **After:** `else if (m_mid) mcnt <= m_err - (m_err >>> 2) + (m_early ? 24'sd4 : 24'sd0);`
  (the last term is BUG-129).
- **Test:** `tb_line` M7, frame errors out of 40 at ±0.6 / ±0.7 clock of jitter: 15 / 24 before
  (the same as no loop at all, which gave the clue), 8 / 17 after. A trace of a failing frame
  showed a mid-bit edge rejected 0.25 clock after a late one had pulled the reference.

## BUG-129 — The Manchester bit timer lost half a clock after an early edge (design)

- **Where:** `src/pbe_line.sv`, Manchester receive with both clock edges (D90), before commit.
- **Cause:** an edge seen in the first half of a clock (`a_early` differs) is timed 4 eighths
  earlier (`m_tau`). The counter after it must hold the time since the new reference *at this
  clock*, which is half a clock after that edge; the update left the 4 eighths out, so every
  early edge moved the timer half a clock early.
- **Before:** `else if (m_mid) mcnt <= m_err - (m_err >>> 2);`
- **After:** `else if (m_mid) mcnt <= m_err - (m_err >>> 2) + (m_early ? 24'sd4 : 24'sd0);`
- **Test:** `tb_line` M4 and M6: before, frames lost a byte (`63 bytes`, `62 bytes`) even at
  ±0.3 clock and the loopback failed; after, all pass and M7 reaches ±0.8 clock.

## BUG-130 — tb_crc compared the 32-bit and 16-bit CRC units with 32-bit state left over (test)

- **Where:** `pbe_v1/test/tb_crc.sv` (c), D91.
- **Cause:** (c) checks that the 32-bit unit equals the old 16-bit one for widths up to 16. It
  ran right after (b), whose CRC-32 runs left upper bits in the 32-bit register; a width change
  does not clear the register (the documented live-change rule, unchanged), so the first
  clocks of (c) before an `init` differed: `FAIL: (c) 9 clocks differ from the 16-bit unit`.
  The claim is for an engine configured at 16 bits or fewer, i.e. from reset.
- **Before:** (c) started with the state of (b).
- **After:**
  ```
      @(negedge clk) rst_n = 0;
      @(negedge clk) rst_n = 1;
  ```
  before (c), and the decision (D91) states that a switch from CRC-32 to a narrower CRC needs
  `CRCRST`.
- **Test:** `tb_crc`: before, 9 differing clocks; after, `PASS` (12,000 clocks identical).

## BUG-131 — The engine unit benches left the new CRC inputs unconnected, and Icarus misreported $isunknown (test, tool)

- **Where:** `pbe_v1/test/tb_engine_known_reset.sv`, `tb_engine_ops.sv`, `tb_engine_restart.sv`
  (D91).
- **Cause:** two problems, found by the gate (`make test`, `make test-verilator`) before item 3
  was pushed:
  1. the benches connect `pbe_engine` by name with 16-bit `crc_poly`/`crc_good` and no
     `crc_wide`. The new input floated (z), so the CRC width was unknown: `FATAL: engine
     reset/restart has an unknown output cfg=00 cfg2=00` in `tb_engine_known_reset` (Icarus and
     Verilator alike);
  2. after connecting it, Icarus 12 still reported `$isunknown` true for a 51-bit concatenation
     of outputs while every one of them was known on its own (the bench already split its check
     once for the same Icarus fault at 106 bits).
- **Before:** `.crc_poly(16'h8005), .crc_cfg(8'h3f), ... .crc_good(16'd0)`, `wire [15:0]
  crc_now;`, and `if ($isunknown({pins_out,pins_oe,flag_set, ..., status,crc_now,pc,pc_copy}) ...`.
- **After:** `.crc_poly(32'h8005), .crc_wide(1'b0), ... .crc_good(32'd0)`, `wire [31:0]
  crc_now;`, and one `$isunknown` per output, or-ed.
- **Test:** `tb_engine_known_reset`: before, the `FATAL` at 6 ns; after, `PASS` over all 192
  coder configurations; `tb_engine_ops` and `tb_engine_restart` pass; `make test-verilator`
  passes (its `tb_engine_*` logs identical under both simulators).

## BUG-132 — Benches with 48 MHz constants failed at 60 MHz (test)

- **Where:** `pbe_v1/test/tb_usb.sv`, `tb_gpio.sv`, `tb_pbe.sv`, `tb_ps2.sv`, `tb_la.sv`, and the
  simulated clock of every top-level bench (D92).
- **Cause:** once `CLK_NS` was 60 MHz, the benches that derived nothing from it failed, each on
  a number written for 48 MHz:
  1. `tb_usb`: the host model decoded the device at 32 clocks a bit (`phase % 32 == 16`), set
     `CLKDIV` 31, and checked the device's EOP SE0 as 60..68 clocks: `FAIL: USB host: device EOP
     SE0 lasted 76 clocks` (94 failures);
  2. `tb_gpio`: `check(sck_per > 145.0 && sck_per < 147.0, "SCK period at CLKDIV 0 is not 7
     clocks")`, 7 clocks in nanoseconds at 48 MHz; it measured 116.7 ns, 7 clocks at 60 MHz;
  3. `tb_pbe`: the I2C controller at `CLKDIV` 17 ran at 476 kHz: `FAIL: I2C: SCL period 2100 ns,
     over 400 kHz` and `SCL low 1200 ns`;
  4. `tb_pbe`: `FAIL: 1-Wire: controller low pulse of 59998 ns` (69 times): the 1 us tick is 60
     clocks, and `#(CLK_NS / 2)` with `CLK_NS` = 16.6667 rounds the half period to 8.333 ns, a
     period of 16.666 ns, a hair fast, so 60 us came out 1.2 ns short of the 60 us minimum. (At
     48 MHz, 20.8333 / 2 rounded up, to a hair slow.)
  5. `tb_ps2` set `CLKDIV` 239 (a 5 us tick at 48 MHz, 4 us at 60) and `tb_la` printed the
     48 MHz sample rates; both still passed, but no longer tested or said what they claimed.
- **After:** `tb_usb`: `localparam int USB_CLK = 40` used for the decoder, `CLKDIV` and the EOP
  check (`2 * USB_CLK +- 4`); `tb_gpio`: `7 * CLK_NS +- 1.0`; `tb_pbe`: `CLKDIV` 21 (390 kHz);
  every bench: `CLK_NS = 16.6672` (the half period rounds to 8.334 ns: a 16.668 ns period,
  slow by 0.01 %, as the 48 MHz benches were with 20.834 ns), `CLK_SIM` 16.668 in `tb_la` and
  `tb_hdlc`; `tb_ps2`: `CLKDIV` 299; `tb_la`: the 60 MHz rates.
- **Test:** each bench at 60 MHz: before, the failures above; after, all pass.

## BUG-133 — eth_tx sent a link pulse right before the first frame (design)

- **Where:** `pbe_v1/programs/eth_tx.pbe` (D93), found by `tb_eth` before commit.
- **Cause:** the program started with a link pulse and went straight to the idle `PULL`; the
  host's first frame was already queued, so the frame's preamble began about 200 ns after the
  pulse. 802.3's model (`eth_model.sv`) sees a positive pulse joined to a frame: `FAIL
  (10BASE-T model): a burst at 315900 ns that starts positive is not a single pulse (853
  transitions)`, and that frame was lost to the check. The same happened whenever a frame was
  queued just as a link pulse went out.
- **Before:**
  ```
  nlp:    PIN  tdp, DRV1 [5]
          PIN  tdp, DRV0
          SET  X, 15
  idle:   PULL
  ...
  init:   PIN  tdp, DRV0
          PIN  tdm, DRV0
          JMP  nlp
  ```
- **After:** a link pulse is followed by the inter-frame gap (the frame's own code), and the
  first pulse comes 16 ms after the start:
  ```
          PIN  tdp, DRV1 [5]
          PIN  tdp, DRV0
          JMP  gap             ; then the inter-frame gap, as after a frame
  ...
  init:   PIN  tdp, DRV0
          PIN  tdm, DRV0
          JMP  gap
  ```
- **Test:** `tb_eth` (1) and (4): before, 2 of 3 frames decoded and the model's error; after,
  3 of 3, and link pulses only between frames.

## BUG-134 — eth_tx's frame status reported the idle loop's timeouts (design)

- **Where:** `pbe_v1/programs/eth_tx.pbe` (D93), found by `tb_eth` (3) before commit.
- **Cause:** "timeout happened" (`STATUS[2]`) is sticky until `STAT`. Idle, the engine times out
  every 1 ms (the link-pulse clock), so the status byte of the first frame after an idle period
  had bit 2 set, which the host protocol defines as "the frame was aborted": `engine 0 status
  04` for a good frame.
- **Before:** `start:  FLAG 0, SET` then the preamble.
- **After:** `start:  FLAG 0, SET` / `STAT` (clears the timeout flag; ISR is overwritten later).
- **Test:** `tb_eth` (3): before, status 0x04 for a good frame; after, 0x00 (and (5)'s abort
  still reports bit 2).

## BUG-135 — tb_eth re-parsed the de-escaped bytes of an unfinished frame (test), and two Icarus limits (tool)

- **Where:** `pbe_v1/test/tb_eth.sv`, `parse_rx`; `eth_model.sv`.
- **Cause:** `parse_rx` turned the bytes read from engine 1 into frames, de-escaping 0x7E 0x7E
  to one 0x7E. When the FIFO had been read in the middle of a frame (the loopback test reads
  every 2 us), it pushed the bytes of the unfinished frame back for the next call, already
  de-escaped: a lone 0x7E followed by a data byte was then read as the end-of-frame record. The
  loopback failed with nonsense frames (`frame 0: 20 bytes, status 36`; byte 20 of every test
  frame is 0x7E). Also: Icarus 12 has no `break` (`sorry: break statements not supported`) and
  no `return` from a task (BUG-127), so the first versions did not compile.
- **Before:** consume every byte, then `rx1.push_front(rf_bytes.pop_back())` for an unfinished
  frame.
- **After:** find the end of the first whole record (skipping 0x7E 0x7E pairs) before consuming
  anything; flags and `disable` of a named block instead of `break` and `return`.
- **Test:** `tb_eth` (3): before, the loopback failed; after, 3 frames, bytes and status ok.

## BUG-136 — hdlc_rx (D94) started a frame after an abort one bit later, in the middle of idle (design)

- **Where:** `pbe_v1/programs/hdlc_rx.pbe`, the rewrite on flag-delimited frames, before commit.
- **Cause:** after an abort the program "hunts": it must skip bits until the next frame end
  (six 1s). The first version read one bit and fell into the frame code, so a frame started
  wherever that bit was: idle 1s and the next flag's first bits (1 1 1, 0 1 1 1 1) made a byte
  (0xFB), and the abort frame was reported as a 1-byte frame with status 0x80 and the rest of the
  frame separately. `tb_hdlc` RX phases: `frame 3: status 00000080, expected 00000040` and later
  frames shifted. A trace of engine 1's `IN`s and `PUSH`es showed the byte formed before the flag.
- **Before:**
  ```
  hunt:   IN   rx, NOCRC
          JLINE fend0
  seg:    SET  OSR, 0x7E
  ```
- **After:**
  ```
  hunt:   IN   rx, NOCRC
          JLINE fend0
          JMP  hunt
  seg:    SET  OSR, 0x7E
  ```
- **Test:** `tb_hdlc` RX at CLKDIV 47 and 23, NRZ and NRZI: before, 5-8 wrong records; after,
  `PASS`.

## BUG-137 — hdlc_tx (D94) let go of the line between frames; its own receiver reported overruns (design)

- **Where:** `pbe_v1/programs/hdlc_tx.pbe`, the rewrite, before commit.
- **Cause:** after the last frame's closing flag the program ended the coder frame (`END`), as
  D88's did. The flag ends with a 0, so in NRZ the line was low at the release (BUG-123's
  situation, which D88 cured with a trailing 1), and in NRZI the level is data-dependent, so no
  trailing bit can fix it. The engine's own receiver, idle under the coder, then took the
  release for a frame and overran: `the transmitter reported a line error (underrun)` in every
  TX phase, although the model received every frame correctly.
- **Before:** `JMP TX_READY, next` / `PIN tx, END` / `JMP idle` after the closing flag.
- **After:** flags until the next frame (interframe time fill): the coder never lets go of the
  line after the first frame, so its receiver stays suppressed (D94).
- **Test:** `tb_hdlc` TX phases, NRZ and NRZI: before, `FAIL` (status bit 4); after, `PASS`.

## BUG-138 — stale default formal/coverage harness inputs after D89–D94 (verification)

- **Before:** host `prep -top pbe_host_spi` leaves `quad_req` symbolic; old single-lane
  parser asserts `bitcnt == f_bit`. Line harnesses omit `a_early`, `ctl` and `ctl_param`;
  engine harnesses omit `crc_wide`/`pins_in_n` and supply 16-bit CRC inputs.
- **Failure:** `make formal FORMAL_BLOCK=host` fails the old parser when quad is selected.
  Simply tying quad_req low gives a passing base case but UNKNOWN induction because an
  arbitrary induction state may still have quad set. The induction trace is not an RTL bug.
- **After:** `host_default.sv` ties new inputs low; the observer asserts `!quad` as an
  inductive invariant. Line harnesses use `.a_early(a_in), .ctl(1'b0), .ctl_param(5'd0)`;
  engine harnesses use `.crc_wide(1'b0), .pins_in_n(pins)` and 32-bit zero-extension.
  Historical default equivalence explicitly excludes the newly assigned encodings.
- **Regression:** `make formal` (including the existing expected counterexamples),
  `make coverage`; outcomes and remaining failures are recorded in the round-3 report.
  No behavioral RTL change.

## BUG-139 — long verification launchers predate D82 SRAM and assembler changes (tool)

- **Before:** bus/stress/sigrok/protocol launchers compile `tt_um_pbe.sv` without
  `pbe_pmem_sram.sv` or the macro model; bus loader does `program, _ = asm.assemble(...)`
  and writes a shared `[0]*128` image. Bus `PERIOD_PS = 20834` still describes 48 MHz.
- **Failure:** each launcher exits nonzero with `Unknown module type: pbe_pmem_sram`.
  With the model supplied, all six bus tests and stress fail at `Chip.load` with
  `ValueError: too many values to unpack (expected 2)`.
- **After:** supply the wrapper and both stock SRAM model files with FUNCTIONAL defined;
  unpack `program, _, _`, initialize separate 256-word images through the host's pointer
  high register 0x0F, retain per-engine start offsets, and derive rates from 16668 ps.
  Replace fixed I2C-controller divisors 17/35/68 with `ceil(HZ/(7*rate))-1` for
  400/200/100 kbit/s; at 60 MHz these are 21/42/85.
- **Regression:** `make test-buses`, `make stress`, `make sigrok`,
  `make test-protocol-vectors`. Exact post-fix outcomes remain in the round-3 evidence;
  failed runs are never relabelled passing. No RTL or program change.
- During SRAM-model bring-up the protocol runner completed USB and seven Modbus cases
  but failed while exporting hashes: `path.relative_to(ROOT)` rejects the newly added
  sibling macro directory. Use `os.path.relpath(path, ROOT)` (preserves existing keys and
  records macros as `../macros/...`), then rerun the complete target. Keep the failed
  receipt-export run distinct from a successful end-to-end target.

## BUG-140 — old mutation anchors no longer match current FIFO/engine/line source (tool)

- **Before:** M07 compares full against rptr, M18 lacks `!n_ns`, M21 expects a one-line
  pop update, M22 lacks `!lv_hit`, and M24 predates the nonblocking PULL variants.
- **Failure:** preflight `source.count(before) == 1` returns zero for all five sites;
  the old campaign would abort with RuntimeError rather than injecting those faults.
- **After:** M07 flips the full pointer comparison against mptr; M18 disables the current
  stuffing predicate; M21 removes the guard from the current pop block; M22 removes only
  restart exclusion and retains `!lv_hit`; M24 inverts FIFO readiness while preserving
  nonblocking PULL variants. Exactly one site must still match.
- **Regression:** preflight all 24 replacements, then `make mutate`; each still invokes
  both make test and the separate differential on an isolated copy. Source drift, compile
  failures and timeouts cannot count as detected mutations. No tracked RTL change.
- The old mutation output default also targeted `evidence/round2/mutations`; it now targets
  ignored `build/mutations` so a fresh campaign cannot replace historical evidence.

## BUG-141 — formal line wall-time budget cuts off the required bound on this runner (tool)

- **Before:** `verify/formal/line.sby`: `timeout 120`; the outer runner's longer timeout
  cannot override SymbiYosys's own cutoff.
- **Failure:** default `rt_nrz_s1_single_bit_lsb` returns TIMEOUT around step 138, short of
  depth 164. The retained log shows no failed assertion. A timeout is inconclusive.
- **After:** `timeout 1200`, with every depth, property and assumption unchanged; run one
  solver job while finishing the default campaigns. Source-aware receipts reject results
  whose expanded configuration differs, so the changed line jobs must be rerun.
- **Regression:** `make formal FORMAL_JOBS=1 FORMAL_ARGS='--timeout 1800'` or validated
  collection of individually completed identical jobs. Actual solver outcomes remain in
  the round-3 report; an increased budget alone is never evidence of a proof.

## BUG-142 — draft Manchester reference placed the first edge half a clock early (model)

- **Before:** first edge did `self.mc_elapsed = offset`; carrier age used
  `min(old_age + 8, limit)`. The receiver's first reference is established at the rising
  clock; the early sample refines subsequent edge errors, not that initial reference.
- **Failure:** seeded D90 line differential, cycle 28051, CFG 0xB3/period_m1 3: RTL pulses
  frame_end but the draft model accepts a boundary as a new mid-bit and misses carrier end.
  The compact captured age/input history is retained in round3/model. This is a model error,
  not an RTL bug. Diagnosing it used RTL state only after observable output disagreement.
- **After:** initialize the reference age to zero on the first edge. Stop incrementing when
  the age reaches/passes the carrier threshold, retaining a possible sub-clock overshoot;
  do not clamp its numeric value prematurely.
- **Regression:** `test_first_manchester_reference_and_carrier_deadline` checks the observable
  deadline from a 14-clock edge sequence; the draft code misses its expected frame_end at
  index 13. Rerun `PBE_LINE_ETHERNET=1 make diff-line` for the complete randomized campaign.
- The first-edge quantization/overshoot are implementation-informed cycle clarifications;
  do not call their agreement an independent architectural proof (D96).

## BUG-143 — stock UART decoder was still configured for the 48 MHz capture (tool)

- **Before:** `sigrok_verify.py`: `uart:rx=p0:baudrate=480000`; the current tb_pbe transmits
  one bit per 100 clocks at 60 MHz. The fixed decoder baud therefore disagrees with the wire.
- **Failure:** fresh `make sigrok`: 21 PASS + 2 documented USB XFAIL + 1 UART FAIL;
  UART decoded `4b1a7f04`, expected `55a300ff0f80`.
- **After:** request 600000 baud (60 MHz / 100); no capture, decoder source, expected payload
  or tolerance is changed. The approximately 80-ppm simulated clock rounding is negligible
  compared with the stock UART receiver's baud window.
- **Regression:** rerun the checker on the same fresh compact captures with `--vcd-dir`;
  require 22 PASS + the same 2 USB XFAIL, and preserve the failed receipt separately.

## BUG-144 — draft generated SV fixture did not elaborate genvar port expressions correctly (tool/test)

- **Before:** the minimal two-coder bench connected `drive[k]` and `cfg2(k==0?0:64)` directly
  from an inline genvar. Icarus 12 rejected the output bit select as nonconstant; fixing only
  the selects left the cfg2 condition as an undriven expression, giving a misleading PASS.
- **After:** bind a local integer parameter `K=k` and use K for both the port bit selects
  and configuration condition. Add an explicit four-state fixture assertion requiring the
  actual input ports to be 0x00 and 0x40, respectively, before applying stimulus.
- **Regression:** the corrected bench compiles, prints its known-input fixture PASS and then
  exposes the real D90 contract violation (BUG-145). Retain the compile failure and the old
  false-PASS transcript; neither is evidence about the RTL contract.

## BUG-145 — Manchester transmitter incorrectly waits for LINE2 idle qualification (RTL)

- **Contract:** `pbe_line.sv` Manchester header/D90: LINE2 sample point, resync and idle wait
  do not apply. The hand-off explicitly flagged LINE2[6] as untested.
- **Before:** `wire idle_wait = cfg2[6];` feeds the common tx_ok gate even in Manchester.
  An idle-high fixture waits for eleven bit samples; a physical idle-low receiver cannot
  qualify that wait. Neither behavior matches the documented Manchester exception.
- **Minimal failing test first:** `verify/ethernet/tb_manchester_idle_wait.sv`: identical
  Manchester bytes, with LINE2 0 and 0x40, must have identical driven outputs. It fails at
  292690 ps on the baseline, before any RTL edit. The fixture asserts its input settings
  are both known. No end-to-end Ethernet program or model is needed to reproduce it.
- **Small repair:** qualify the old idle wait with `!manch`, so it retains its old
  effect in modes 0–2 and has no effect in mode 3. This is a documented exception, not a
  changed Manchester algorithm. Apply only after retaining the running baseline source
  receipts, then rerun the minimal test, old-mode checks, both simulators and all gates.
- **Status:** repair applied after retaining baseline evidence; the isolated reproducer and
  new formal/smoke differential checks pass. The final full gate, six simulator-log comparisons, both lints and all new formal
  checks pass; repair-only legacy equivalence proves 575 cells. Report at
  the top of the final message, including whether repaired and validated.

## BUG-148 — the old timeout mutant lacks a fast exact-deadline RTL regression (test)

- **Before:** M19 replaces `tmo_cnt >= timeout` with `tmo_cnt > timeout`; its long make-test
  path timed out at 1800 seconds and its separate one-seed differential survived. These
  outcomes are inconclusive/survived, not detection. The current PAGE/SRAM seed schedule
  differs from the historical campaign where that differential caught the fault.
- **After:** add `tb_timeout_boundary.sv` near the beginning of `make test`: after an explicit
  restart, a permanently blocked WAIT with TIMEOUT=1/CLKDIV=0 must set STATUS[2] on the fourth
  post-restart clock, and not on the first three. No internal engine state is read.
- **Fail before/pass after:** the actual one-site M19 scratch RTL fails at that fourth clock;
  unmodified RTL passes `make test-timeout-boundary`. Rerun M19's full make-test and separate
  differential after adding the regression. Retain the separate differential's blind spot.
- This fixes a verification gap, not the engine's existing timeout behavior.

## BUG-146 — quad parser induction initially admitted unreachable stride states (formal observer)

- **Before:** the generalized byte parser asserted output/state equivalence but did not
  constrain its own reachable quad bit/read-shift alignment by proved invariants.
- **Failure:** the base case passes, while induction returns UNKNOWN with arbitrary quad
  bit indices that cannot arise after reset; framing/read-load assertions then disagree.
- **After:** assert (not assume) `f_bit[1:0]==0` and `f_read_shift[1:0]==0` whenever the
  reference mode is quad. The step relation proves these reachable-state invariants.
- **Regression:** `ethernet.sby host` passes base case and temporal induction at depth 32;
  no timing assumption or old framing assertion was removed.

## BUG-147 — CRC formal reference reset and equivalence observer were incomplete (formal harness)

- **Before:** coefficient reference used a synchronous `always @(posedge clk)` reset while
  the documented CRC reset is asynchronous. The narrow miter also duplicated raw/reversed
  CRC instances without asserting their complete stored-state relation.
- **Failure:** wide reference assertion fails at step 3 after a repeated reset; the DUT has
  reset while the synchronous reference still exposes prior coefficients. Narrow base case
  passes, but induction can reveal unmatched hidden bits after a live width change (UNKNOWN).
- **After:** use an asynchronous coefficient reset and compare the actual primary instances'
  full raw CRC registers through observation-only ports, alongside value and comparator.
- **Regression:** both `ethernet.sby crc32` and `crc16` pass temporal induction at depth 8.
  Preserve the pilot counterexample/UNKNOWN logs separately from final proofs. No RTL repair.

## BUG-149 — Verilator C++ grouping exhausts the shared runner's memory (tool)

- **Before:** coverage builds pass `-j 2` without an explicit output-group policy. Verilator
  5.051 groups many generated tb_pbe translation units into two huge `vm_classes` files.
- **Failure:** tb_pbe compilation exits 2 with `cc1plus` killed. The cgroup reports one
  `oom_kill` at its 8-GiB limit. No simulation or coverage result exists for that failed build;
  the other bench/differential/line results must not substitute for it.
- **After:** add `--output-groups 0` so generated C++ files compile individually. Keep the
  same Verilator, RTL, instrumentation, assertions, source splits, stimulus and coverage
  aggregation. This is a compiler resource adjustment, not a coverage relaxation.
- **Regression:** rerun `verify/coverage/run.py --reuse-builds`; reuse only already successful
  source-signature-matching builds, rebuild tb_pbe and the changed port-tieoff fixture, and
  require every bench plus fresh nonempty coverage dumps. The repaired baseline campaign passes all 140/140 old functional bins; exact metrics
  are retained in round3/stage1/coverage-summary.json.

## BUG-150 — pre-CAN equivalence miter predates PAGE jump semantics (verification)

- **Before:** the `default_engine` miter compared arbitrary live `start_pc` and arbitrary
  8-bit program locations against pre-CAN 797314f, whose jumps always target its first
  64-word page. D83 now targets the executing instruction's page. Merely comparing PC modulo
  128 cannot make these behaviors equivalent.
- **Failure:** the retained original counterexample has `start_pc=148`, new `pc_d=4`, old
  `pc_d=68`. Even fixing START_PC at zero admits a jump from word 64: new target 0x4a,
  old target 0x0a. These are D83 behavior differences, not new Ethernet defects.
- **After:** retain the historical `engine` as an explicit expected failing property. State the
  page-zero/no-PAGE compatibility domain explicitly for the additional `engine_page0`; do not claim the broader
  historical property was proved. Add a separate `modern` miter against D88 159650f with
  full 8-bit PC/PAGE, arbitrary live configuration and old encodings, excluding only newly
  assigned non-bsync LINECTL actions. Report all bounded depths and actual outcomes.
- **Regression:** the unrestricted property must still produce an assertion counterexample;
  the restricted and modern comparisons are separate checks. Preserve pilot timeout receipts.

## BUG-151 — Manchester recovery does not meet the full tested ±13.5 ns edge envelope (RTL, open)

- **Before:** the D90 recovery loop accepts edges using `m_tau >= m_thr`, with threshold
  `6*period_m1` eighth clocks, early correction four eighths and loop gain one quarter.
  Earlier uniform-jitter evidence reached ±0.8 clock (13.3344 ns), below 13.5 ns.
- **Failure:** public-pin Scapy frames with independently computed binascii FCS, 256 data
  bytes, ±100 ppm source frequency and exactly ±13500 ps per crossing: six of twelve
  required seed/pattern combinations lose bytes or split frames. All four tested uniform
  combinations pass; both data-dependent-spacing patterns fail, as do alternating extremes
  for the fast source. Received records have bad CRC rather than silently accepting payloads.
- IEEE 802.3-2012 14.3.1.3.1 specifies the limit relative to each ideal zero crossing.
  The generator perturbs actual transitions only; opposite extremes permit intervals to vary
  by 27 ns. Its spacing-dependent pattern is a digital ISI proxy, not an analog cable model.
- **After:** RTL recovery is deliberately unchanged. A gain/threshold retune is not a small,
  self-evidently correct repair. Retain failing stimuli, actual received bytes, seed, phase,
  clock offset, tool/source hashes and a minimized reproducer. A minimum 60-byte Ethernet frame reproduces it in both
  Icarus and Verilator (30 delivered bytes, status 0). The stress target returns
  nonzero for required-envelope failures. Do not call this Ethernet compliance or a pass.
- **Regression:** `make stress-ethernet` (`receive_jitter`); ordinary no-jitter vectors and
  the model differential can pass while this independent timing requirement fails.

## BUG-152 — draft pin-vector expectations contradicted documented host records (test)

- **Before:** the draft HDLC checker waited for a TX status byte although hdlc_tx explicitly
  returns nothing; its Ethernet dribble test expected eight extra bits not to form a byte;
  overrun recovery expected sticky STATUS[3] to clear itself at the next frame.
- **Failures:** HDLC host-output deadline with empty status FIFO; dribble_8 returns 65 rather
  than 64 bytes; a subsequent intact CRC-valid Ethernet frame reports 0x0a after overflow.
- **After:** decode actual HDLC TX bits/FCS after sufficient frame time without inventing a
  status response; expect 0xff for eight additional one bits and a failed CRC; require
  the next good record's 0x0a, explicitly clear overflow with the public STATUS write, then
  require 0x02 on another good frame. No DUT state or RTL change supplies expected payloads.
- **Regression:** independent Ethernet RX and HDLC tests pass; underrun/overrun recovery
  passes including the sticky-status observation, host clear and subsequent exact payload.

## BUG-153 — mutation runner resolved away its virtual-environment executable (tool)

- **Before:** `str((ROOT/'.venv/bin/python').resolve())` follows the Python symlink to the
  base interpreter, losing its virtual environment and installed cocotb_tools.
- **Failure:** feature-mutant pilots return ModuleNotFoundError. They are classified
  inconclusive infrastructure failures, never killed mutants.
- **After:** preserve the absolute `.venv/bin/python` path without resolving its symlink.
  Re-anchor early-offset, flag-run and program-escape sites to exactly one current source
  fragment; reject ambiguous/missing sites before execution.
- **Regression:** rerun the actual scratch mutants; require observable assertion failures,
  not compile errors, missing dependencies, generic nonzero returns or timeouts.

## BUG-154 — old and Ethernet coverage sweeps would overwrite the same dump (tool)

- **Before:** an extended campaign reused `line_sweep.dat` and its object directory for the
  old 160-configuration campaign and new 240-configuration campaign.
- **Failure:** this is a harness collision found before running the extended aggregation;
  a second producer would erase the first producer's contribution.
- **After:** use `line_sweep` and `ethernet_line_sweep` build/dump names separately; require
  fresh nonempty data from each. Retain default instrumentation as exactly its existing
  140-bin mode; opt-in Ethernet instrumentation adds bins and reports uncovered ones explicitly.
- **Regression:** the extended summary lists both distinct data inputs, and the two sweeps'
  independent assertion outcomes remain visible in their logs.

## BUG-155 — end-state host readback compared a stale volatile STATUS snapshot (test)

- **Before:** `expected=h.model.read(addr)` ran before an entire host SPI transaction;
  its result was compared with a register byte prefetched after the command. A stopped
  engine does not stop its line coder: receive overruns can set line error during that time.
- **Failure:** the 1,000-seed Ethernet Icarus campaign reaches global index 983 / seed
  5260828, then compares actual STATUS 20 with the earlier expected 4. At transaction end
  both model and RTL status are 20. Diagnostic per-clock coder error pulses agree throughout.
  A naive single-seed replay is different because index zero substitutes a coverage program.
- **After:** capture expected bits from the independent model at each actual host sample,
  assemble the predicted read byte, and compare that with the returned byte. Keep the
  existing every-clock output oracle, FIFO checks, final internal-state diagnostics and
  hardcoded directed register checks. No RTL/model state transition is changed or masked.
  Add `--start-index` so a replay retains its original program/profile selection, and write
  progress without changing RNG draws or existing default counters.
- **Regression:** `run.py --ethernet --n 1 --start-index 983 --seed 0x504245 --cycles 1200`
  fails before and passes after (30,688 clocks). Retain the failed large-campaign manifest;
  do not claim its first 983 seeds as a complete 1,000-seed pass. The corrected full 1,000-seed campaign passes 20,951,842 checked clocks under Verilator;
  the exact failing-seed replay also passes under Icarus.

## BUG-156 — draft line limit fixtures assumed the wrong reset idle level (test)

- **Before:** divider/glitch fixtures held a_in low across reset although the documented
  coder resets its previous level high. The first release clock therefore started carrier
  before the test's intended reference; a later frame_end was attributed to the glitch.
- **After:** start both observed samples high, settle after reset, then create the intentional
  falling edge (or early-only low sample). Do not adjust the carrier deadline to measured RTL.
- **Regression:** external-port tests pass at period 65536: carrier end exactly 131072 clocks
  after its first intentional edge; an early-only short glitch produces neither data nor end.
  Continuous flag-delimited one runs produce an end every 30 clocks at a five-clock period.

## BUG-157 — random line campaign missed the injected flag-run reset fault (test gap)

- **Before:** E10 injects `rrun <= 6` at a flag-delimited frame end. The 240-configuration
  random line campaign survives; it is not a detected fault.
- **After:** add the public-output continuous-one-run check above. A receiver that stays in
  flag-delimited mode must reset its run and emit another end after each six sampled ones.
- **Regression:** baseline intervals are 30 clocks; E10 gives events [29,69,109,149], hence
  40-clock intervals, and fails the directed assertion. Preserve the original survivor receipt.

## BUG-158 — payload-only program checking missed the second-END completion barrier (test gap)

- **Before:** P02 replacing the second END survives the canonical payload/FCS/IFG tests.
  Removing the barrier can still leave enough gap for valid frames, but completion status
  becomes available before the last FCS bit. D93 documents the second END as that barrier.
- **After:** monitor public uo_out[4] for the first completion record, independently decode
  the TX pins, and require status availability not to precede the last FCS bit. Replace the
  removed instruction with NOP, preserving X and every other instruction's position.
- **Regression:** baseline passes; pure P02 exposes completion at 1559991456 ps versus
  last-FCS end 1560708180 ps and fails. Retain the original survivor receipt.
- Also replace frame-start STAT/extra escape PUSH with NOP. The earlier SET X,0 substitution
  had an incidental register effect and does not establish single-purpose sensitivity.
  Pure P03 fails with leaked idle-timeout status 04; pure P04 fails exact escaped RX bytes.
  Add a descriptive payload assertion so the strict mutation classifier can identify its
  actual failure; the earlier bare-assertion nonzero remains inconclusive in pilot evidence.

## BUG-159 — draft proof/receipt diagnostics referenced unsupported names (verification tooling)

- **Before:** a page-zero pilot assumed `n.jump` / `n.cur_off` via hierarchical references
  that Yosys treated as undriven implicit nets; it did not impose the intended domain.
  A separate provenance addition tried to open the bare command name `make` as a file.
- **Failures:** the ineffective domain pilot still yields the PAGE counterexample; the
  mutation provenance pilot exits with FileNotFoundError before its next check. Neither
  supplies a proof or mutant kill.
- **After:** express the extra page-zero domain using the actual public `pc_new` output;
  retain the historical unrestricted property separately, under its original engine name.
  Resolve command binaries with PATH before hashing, preserving the venv invocation path.
- **Regression:** source-aware collection accepts the historical expected counterexample
  and the separate depth-eight page-zero pass. The final frozen 14-mutant campaign completes
  with per-campaign input manifests, binary hashes and observable assertion detections.

## BUG-160 — extended coverage and quad observer needed stricter final acceptance (verification)

- **Before:** the exploratory Ethernet coverage wrapper automatically passed `--partial`
  to the summarizer; its first run reported 217/219 bins but did not reject the gaps. The
  generalized host parser proved the full internal read word but explicitly checked only
  Q0, leaving the other three external output-lane relations implicit in the RTL wiring.
- **After:** remove automatic partial acceptance: the normal extended target now requires
  all old and new named bins. Add an explicit Q3..Q1 comparison with the independent
  predicted word at each quad read sampling edge. Default old checks are unchanged.
- **Regression:** the strict summarizer passes the actual 219/219 data after directed
  closure. The Ethernet formal block passes all 13 jobs with all four read lanes asserted; retain
  the earlier, narrower observer receipts separately. No DUT assumption or RTL repair is added.
