ayushyadavnvs/jane_street/verify/golden-model/evidence/round3/model/bug142-before-after.txt

Before: expected frame_end at [13], observed []; FAIL
After: architectural unit passes at [13]
