ayushyadavnvs/jane_street/verify/golden-model/evidence/round2/vectors/protocol_bug065_after_fix.txt

usb: PASS; 2.009 s
modbus: PASS; 43.096 s
Complete raw runtime receipts: protocol_usb_run.stdout, protocol_modbus_run.stdout
