ayushyadavnvs/jane_street/verify/golden-model/evidence/round2/vectors/protocol_bug065_before_queue_bits.txt

Exit: 1
ERROR: iverilog exited 20; inspect /tmp/pbe_protocol_before_queue_bits/modbus_compile.stdout/stderr
