ayushyadavnvs/jane_street/verify/golden-model/evidence/round3/stage1/formal-counterexample/trace_tb.v

`ifndef VERILATOR
module testbench;
  reg [4095:0] vcdfile;
  reg clock;
`else
module testbench(input clock, output reg genclock);
  initial genclock = 1;
`endif
  reg genclock = 1;
  reg [31:0] cycle = 0;
  wire [0:0] PI_clk = clock;
  default_equiv UUT (
    .clk(PI_clk)
  );
`ifndef VERILATOR
  initial begin
    if ($value$plusargs("vcd=%s", vcdfile)) begin
      $dumpfile(vcdfile);
      $dumpvars(0, testbench);
    end
    #5 clock = 0;
    while (genclock) begin
      #5 clock = 0;
      #5 clock = 1;
    end
  end
`endif
  initial begin
`ifndef VERILATOR
    #1;
`endif
    // UUT.$auto$async2sync.\cc:107:execute$9815  = 1'b0;
    // UUT.$auto$async2sync.\cc:116:execute$9795  = 1'b1;
    // UUT.$auto$async2sync.\cc:116:execute$9801  = 1'b1;
    // UUT.$auto$async2sync.\cc:116:execute$9807  = 1'b1;
    // UUT.$auto$async2sync.\cc:116:execute$9813  = 1'b1;
    // UUT.$auto$async2sync.\cc:116:execute$9819  = 1'b1;
    UUT.f_past = 1'b0;
    UUT.n._witness_.anyinit_procdff_9326 = 24'b000000000000000000000000;
    UUT.n._witness_.anyinit_procdff_9331 = 16'b0000000000000000;
    UUT.n._witness_.anyinit_procdff_9336 = 4'b0000;
    UUT.n._witness_.anyinit_procdff_9341 = 1'b0;
    UUT.n._witness_.anyinit_procdff_9346 = 8'b00000000;
    UUT.n._witness_.anyinit_procdff_9351 = 8'b00000000;
    UUT.n._witness_.anyinit_procdff_9356 = 8'b00000000;
    UUT.n._witness_.anyinit_procdff_9361 = 8'b00000000;
    UUT.n._witness_.anyinit_procdff_9366 = 4'b0000;
    UUT.n._witness_.anyinit_procdff_9371 = 1'b0;
    UUT.n._witness_.anyinit_procdff_9376 = 1'b0;
    UUT.n._witness_.anyinit_procdff_9381 = 1'b0;
    UUT.n._witness_.anyinit_procdff_9386 = 1'b0;
    UUT.n._witness_.anyinit_procdff_9391 = 16'b0000000000000000;
    UUT.n._witness_.anyinit_procdff_9396 = 8'b00000000;
    UUT.n._witness_.anyinit_procdff_9401 = 8'b00000000;
    UUT.n._witness_.anyinit_procdff_9406 = 1'b0;
    UUT.n._witness_.anyinit_procdff_9411 = 1'b0;
    UUT.n._witness_.anyinit_procdff_9416 = 4'b0000;
    UUT.n._witness_.anyinit_procdff_9421 = 8'b00000000;
    UUT.n._witness_.anyinit_procdff_9426 = 16'b0000000000000000;
    UUT.n._witness_.anyinit_procdff_9431 = 1'b0;
    UUT.n._witness_.anyinit_procdff_9436 = 1'b0;
    UUT.n._witness_.anyinit_procdff_9441 = 1'b0;
    UUT.n._witness_.anyinit_procdff_9446 = 1'b0;
    UUT.n._witness_.anyinit_procdff_9526 = 8'b00000000;
    UUT.n._witness_.anyinit_procdff_9531 = 1'b0;
    UUT.n._witness_.anyinit_procdff_9536 = 2'b00;
    UUT.n.u_bsync._witness_.anyinit_procdff_9031 = 4'b0000;
    UUT.n.u_bsync._witness_.anyinit_procdff_9036 = 3'b000;
    UUT.n.u_bsync._witness_.anyinit_procdff_9041 = 8'b00000000;
    UUT.n.u_bsync._witness_.anyinit_procdff_9046 = 1'b0;
    UUT.n.u_bsync._witness_.anyinit_procdff_9051 = 1'b0;
    UUT.n.u_bsync._witness_.anyinit_procdff_9056 = 1'b0;
    UUT.n.u_bsync._witness_.anyinit_procdff_9061 = 1'b0;
    UUT.n.u_bsync._witness_.anyinit_procdff_9066 = 1'b0;
    UUT.n.u_bsync._witness_.anyinit_procdff_9071 = 1'b0;
    UUT.n.u_bsync._witness_.anyinit_procdff_9076 = 1'b0;
    UUT.n.u_bsync._witness_.anyinit_procdff_9081 = 1'b0;
    UUT.n.u_bsync._witness_.anyinit_procdff_9086 = 9'b000000000;
    UUT.n.u_bsync._witness_.anyinit_procdff_9091 = 8'b00000000;
    UUT.n.u_bsync._witness_.anyinit_procdff_9096 = 16'b0000000000000000;
    UUT.n.u_bsync._witness_.anyinit_procdff_9101 = 1'b0;
    UUT.n.u_bsync._witness_.anyinit_procdff_9106 = 1'b0;
    UUT.n.u_bsync._witness_.anyinit_procdff_9111 = 3'b000;
    UUT.n.u_bsync._witness_.anyinit_procdff_9116 = 1'b0;
    UUT.n.u_bsync._witness_.anyinit_procdff_9121 = 1'b0;
    UUT.n.u_bsync._witness_.anyinit_procdff_9126 = 1'b0;
    UUT.n.u_bsync._witness_.anyinit_procdff_9131 = 1'b0;
    UUT.n.u_bsync._witness_.anyinit_procdff_9136 = 1'b0;
    UUT.n.u_bsync._witness_.anyinit_procdff_9141 = 8'b00000000;
    UUT.n.u_bsync._witness_.anyinit_procdff_9146 = 8'b00000000;
    UUT.n.u_bsync._witness_.anyinit_procdff_9151 = 4'b0000;
    UUT.n.u_bsync._witness_.anyinit_procdff_9156 = 1'b0;
    UUT.n.u_bsync._witness_.anyinit_procdff_9161 = 1'b0;
    UUT.n.u_bsync._witness_.anyinit_procdff_9166 = 1'b0;
    UUT.n.u_bsync._witness_.anyinit_procdff_9171 = 1'b0;
    UUT.n.u_bsync._witness_.anyinit_procdff_9176 = 1'b0;
    UUT.n.u_bsync._witness_.anyinit_procdff_9181 = 1'b0;
    UUT.n.u_bsync._witness_.anyinit_procdff_9186 = 1'b0;
    UUT.n.u_bsync._witness_.anyinit_procdff_9191 = 1'b0;
    UUT.n.u_bsync._witness_.anyinit_procdff_9196 = 8'b00000000;
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
    UUT.o.u_line._witness_.anyinit_procdff_8791 = 1'b0;
    UUT.o.u_line._witness_.anyinit_procdff_8796 = 1'b0;
    UUT.o.u_line._witness_.anyinit_procdff_8801 = 1'b0;
    UUT.o.u_line._witness_.anyinit_procdff_8806 = 3'b000;
    UUT.o.u_line._witness_.anyinit_procdff_8811 = 8'b00000000;

    // state 0
    UUT.crc_cfg = 8'b00000000;
    UUT.crc_good = 16'b0000000000000000;
    UUT.crc_poly = 16'b0000000000000000;
    UUT.flags = 4'b0000;
    UUT.hci = 1'b0;
    UUT.hlc = 1'b0;
    UUT.hoc = 1'b0;
    UUT.htc = 1'b0;
    UUT.imsb = 1'b0;
    UUT.jmp_pin = 3'b000;
    UUT.line_cfg = 8'b00000000;
    UUT.omsb = 1'b0;
    UUT.pin_base = 3'b000;
    UUT.pins = 8'b00000000;
    UUT.pm_wr = 1'b0;
    UUT.restart = 1'b0;
    UUT.rst_n = 1'b0;
    UUT.run = 1'b0;
    UUT.rx_full = 1'b0;
    UUT.start_pc = 8'b00000000;
    UUT.sync = 8'b10000000;
    UUT.timeout = 16'b0000000000000000;
    UUT.tx_empty = 1'b0;
    UUT.txd = 8'b00000000;
    UUT.instr = 16'b0000000000000000;
    UUT.cfg = 8'b00000000;
    UUT.clkdiv = 16'b0000000000000010;
  end
  always @(posedge clock) begin
    // state 1
    if (cycle == 0) begin
      UUT.crc_cfg <= 8'b00011011;
      UUT.crc_good <= 16'b0000000000000000;
      UUT.crc_poly <= 16'b0000000000000000;
      UUT.flags <= 4'b0000;
      UUT.hci <= 1'b1;
      UUT.hlc <= 1'b0;
      UUT.hoc <= 1'b0;
      UUT.htc <= 1'b0;
      UUT.imsb <= 1'b0;
      UUT.jmp_pin <= 3'b000;
      UUT.line_cfg <= 8'b00000000;
      UUT.omsb <= 1'b0;
      UUT.pin_base <= 3'b000;
      UUT.pins <= 8'b00000000;
      UUT.pm_wr <= 1'b0;
      UUT.restart <= 1'b0;
      UUT.rst_n <= 1'b1;
      UUT.run <= 1'b1;
      UUT.rx_full <= 1'b0;
      UUT.start_pc <= 8'b01101110;
      UUT.sync <= 8'b10000000;
      UUT.timeout <= 16'b0000000000000000;
      UUT.tx_empty <= 1'b0;
      UUT.txd <= 8'b00000000;
      UUT.instr <= 16'b0110101100000000;
      UUT.cfg <= 8'b00000000;
      UUT.clkdiv <= 16'b0000000000000010;
    end

    // state 2
    if (cycle == 1) begin
      UUT.crc_cfg <= 8'b00101110;
      UUT.crc_good <= 16'b0000111111111110;
      UUT.crc_poly <= 16'b0000000000000000;
      UUT.flags <= 4'b0011;
      UUT.hci <= 1'b0;
      UUT.hlc <= 1'b0;
      UUT.hoc <= 1'b0;
      UUT.htc <= 1'b0;
      UUT.imsb <= 1'b0;
      UUT.jmp_pin <= 3'b001;
      UUT.line_cfg <= 8'b10000000;
      UUT.omsb <= 1'b0;
      UUT.pin_base <= 3'b110;
      UUT.pins <= 8'b10000000;
      UUT.pm_wr <= 1'b1;
      UUT.restart <= 1'b0;
      UUT.rst_n <= 1'b1;
      UUT.run <= 1'b1;
      UUT.rx_full <= 1'b0;
      UUT.start_pc <= 8'b10010100;
      UUT.sync <= 8'b00000000;
      UUT.timeout <= 16'b0000000000000000;
      UUT.tx_empty <= 1'b0;
      UUT.txd <= 8'b00000000;
      UUT.instr <= 16'b0000000000000000;
      UUT.cfg <= 8'b00000000;
      UUT.clkdiv <= 16'b0000000000000001;
    end

    // state 3
    if (cycle == 2) begin
      UUT.crc_cfg <= 8'b00000000;
      UUT.crc_good <= 16'b0000000000000000;
      UUT.crc_poly <= 16'b0000000000000000;
      UUT.flags <= 4'b0000;
      UUT.hci <= 1'b0;
      UUT.hlc <= 1'b0;
      UUT.hoc <= 1'b0;
      UUT.htc <= 1'b0;
      UUT.imsb <= 1'b0;
      UUT.jmp_pin <= 3'b000;
      UUT.line_cfg <= 8'b00000000;
      UUT.omsb <= 1'b0;
      UUT.pin_base <= 3'b000;
      UUT.pins <= 8'b00000000;
      UUT.pm_wr <= 1'b0;
      UUT.restart <= 1'b0;
      UUT.rst_n <= 1'b0;
      UUT.run <= 1'b0;
      UUT.rx_full <= 1'b0;
      UUT.start_pc <= 8'b00000000;
      UUT.sync <= 8'b00000000;
      UUT.timeout <= 16'b0000000000000000;
      UUT.tx_empty <= 1'b0;
      UUT.txd <= 8'b00000000;
      UUT.instr <= 16'b0000000000000000;
      UUT.cfg <= 8'b00000000;
      UUT.clkdiv <= 16'b0000000000000010;
    end

    genclock <= cycle < 3;
    cycle <= cycle + 1;
  end
endmodule
