ayushyadavnvs/jane_street/pbe_v2/test/tb_pbe.sv

`timescale 1ns / 1ps
// End-to-end test of tt_um_pbe through its real pins only.
//
//  Test 1  UART: engine 0 runs uart_tx on pin 0, engine 1 runs uart_rx on pin 1,
//          pin 0 is looped back to pin 1. An independent UART monitor also decodes pin 0.
//  Test 2  SPI:  engine 0 runs spi_ctrl on pins 0..3 against a behavioural mode-0 peripheral.
//  Test 3  I2C on engine 1 while engine 0 sends UART.
//  Test 4  Low-speed USB: engine 0 sends packets on pins 0/1, checked by an independent decoder;
//          engine 1 receives packets on pins 2/3 from a host model running 1.5% fast and slow.
// The clock is 48 MHz so a USB bit is exactly 32 clocks.
//
// Every pin has a pull-up and lines are wired-AND, like a real open-drain bus.
module tb_pbe;
  localparam real CLK_NS = 20.8333;  // 48 MHz
  localparam int HOST_HALF = 8;  // host SCK half period in clocks (SCK = clk / 16)
  localparam int UART_BIT = 100;  // clocks per UART bit (500 kbaud at 50 MHz)

  logic clk = 0, rst_n = 0;
  always #(CLK_NS / 2) clk = ~clk;

  logic [7:0] ui_in = 8'b0000_0010;  // CS_n high
  wire  [7:0] uo_out, uio_out, uio_oe;
  logic [7:0] ext_drive = '0, ext_val = '0;
  logic       loop01 = 0;

  logic [7:0] pull_lo = '0;  // pins pulled low instead of high (USB D+)

  // Lines are wired-AND; an undriven line sits at its pull-up or pull-down.
  wire  [7:0] chip_lvl = ~uio_oe | uio_out;
  wire  [7:0] ext_lvl  = ~ext_drive | ext_val;
  wire  [7:0] loop_drv = loop01 ? {6'b0, uio_oe[0], 1'b0} : 8'h00;  // pin 0 also drives pin 1
  wire  [7:0] dev_pull;                       // 1-Wire device models pulling low
  wire  [7:0] driven   = uio_oe | ext_drive | loop_drv | dev_pull;
  wire  [7:0] wired    = chip_lvl & ext_lvl & ~dev_pull & (loop01 ? {6'h3f, chip_lvl[0], 1'b1} : 8'hff);
  wire  [7:0] bus      = (driven & wired) | (~driven & ~pull_lo);

  tt_um_pbe dut (
      .ui_in, .uo_out, .uio_in(bus), .uio_out, .uio_oe, .ena(1'b1), .clk, .rst_n
  );

  int errors = 0;
  task automatic check(input bit ok, input string msg);
    if (!ok) begin
      errors++;
      $display("  FAIL: %s", msg);
    end
  endtask

  // ---------------- host SPI (mode 0) ----------------
  task automatic spi_byte(input logic [7:0] tx, output logic [7:0] rx);
    for (int i = 7; i >= 0; i--) begin
      ui_in[2] = tx[i];
      repeat (HOST_HALF) @(posedge clk);
      ui_in[0] = 1;  // rising: both sides sample
      rx[i] = uo_out[0];
      repeat (HOST_HALF) @(posedge clk);
      ui_in[0] = 0;
    end
  endtask

  // One host port: a transaction holds it from CS_n low to CS_n high, so two host processes
  // can share it (BUG-001). A ticket lock serves them in arrival order; a plain busy flag let
  // the process that just released the port take it again at once and starve the other.
  int host_next = 0, host_serving = 0;
  task automatic cs(input bit level);
    int ticket;
    if (!level) begin
      ticket = host_next++;
      while (host_serving != ticket) @(posedge clk);
    end
    repeat (HOST_HALF) @(posedge clk);
    ui_in[1] = level;
    repeat (HOST_HALF) @(posedge clk);
    if (level) host_serving++;
  endtask

  task automatic reg_write(input logic [6:0] addr, input logic [7:0] data);
    logic [7:0] d;
    cs(0);
    spi_byte({1'b1, addr}, d);
    spi_byte(data, d);
    cs(1);
  endtask

  task automatic reg_read(input logic [6:0] addr, output logic [7:0] data);
    logic [7:0] d;
    cs(0);
    spi_byte({1'b0, addr}, d);
    spi_byte(8'h00, data);
    cs(1);
  endtask

  task automatic load_program(input string file);
    logic [15:0] img[64];
    logic [7:0] d;
    $readmemh(file, img);
    reg_write(7'h06, 0);         // program memory pointer = word 0, high byte
    cs(0);
    spi_byte({1'b1, 7'h07}, d);  // burst into PM_DATA; the pointer advances per byte
    for (int w = 0; w < 64; w++) begin
      spi_byte(img[w][15:8], d);
      spi_byte(img[w][7:0], d);
    end
    cs(1);
  endtask

  task automatic fifo_send(input int e, input logic [7:0] data);
    logic [7:0] st;
    do reg_read(7'h01, st); while (st[e*4+3]);  // TX full
    reg_write(e ? 7'h26 : 7'h16, data);
  endtask

  task automatic fifo_recv(input int e, output logic [7:0] data);
    logic [7:0] st;
    int tries = 0;
    do begin
      reg_read(7'h01, st);
      tries++;
    end while (st[e*4+0] && tries < 400);  // RX empty
    check(!st[e*4+0], $sformatf("engine %0d RX FIFO stayed empty", e));
    reg_read(e ? 7'h26 : 7'h16, data);
  endtask


  // ---------------- engine-relative flags ----------------
  // Engine e's FLAG n is physical flag (FLAG_BASE[e] + n) mod 8; by default engine 0 has
  // flags 0-3 and engine 1 has flags 4-7. FLAG_SET (0x08) and FLAG_CLR (0x09) change single
  // bits, so the host never overwrites a flag the other engine just changed.
  function automatic int fphys(input int e, input int n);
    return (e * 4 + n) % 8;
  endfunction
  task automatic flag_set(input int e, input int n);
    reg_write(7'h08, 8'h01 << fphys(e, n));
  endtask
  task automatic flag_clear(input int e, input int n);
    reg_write(7'h09, 8'h01 << fphys(e, n));
  endtask
  task automatic flag_get(input int e, input int n, output bit v);
    logic [7:0] f;
    reg_read(7'h04, f);
    v = f[fphys(e, n)];
  endtask

  // ---------------- independent UART monitor on pin 0 ----------------
  logic [7:0] uart_seen[$];
  bit uart_mon_en = 0;
  initial begin
    forever begin
      @(negedge bus[0]);
      if (uart_mon_en) begin
        logic [7:0] b;
        repeat (UART_BIT / 2) @(posedge clk);
        check(bus[0] == 0, "UART monitor: start bit not low at its middle");
        for (int i = 0; i < 8; i++) begin
          repeat (UART_BIT) @(posedge clk);
          b[i] = bus[0];
        end
        repeat (UART_BIT) @(posedge clk);
        check(bus[0] == 1, "UART monitor: stop bit not high");
        uart_seen.push_back(b);
      end
    end
  end

  // ---------------- behavioural SPI peripheral, mode 0, pins 0..3 ----------------
  logic [7:0] spi_reply[$], spi_got[$];
  bit spi_dev_en = 0;
  logic [7:0] dev_tx, dev_rx;
  int dev_bits;
  bit dev_loaded = 0;  // dev_tx holds the next reply byte
  function automatic logic [7:0] next_reply();
    return spi_reply.size() ? spi_reply.pop_front() : 8'hEE;
  endfunction
  always @(negedge bus[3]) if (spi_dev_en) begin
    if (!dev_loaded) dev_tx = next_reply();
    dev_loaded = 1;
    dev_bits = 0;
    ext_drive[2] = 1;
    ext_val[2] = dev_tx[7];
  end
  always @(posedge bus[3]) if (spi_dev_en) ext_drive[2] = 0;
  always @(posedge bus[0]) if (spi_dev_en && !bus[3]) begin
    dev_rx = {dev_rx[6:0], bus[1]};
    dev_bits++;
    if (dev_bits == 8) begin
      spi_got.push_back(dev_rx);
      dev_bits = 0;
      dev_loaded = 0;
    end
  end
  always @(negedge bus[0]) if (spi_dev_en && !bus[3]) begin
    if (dev_bits == 0) begin
      dev_tx = next_reply();
      dev_loaded = 1;
    end else dev_tx = {dev_tx[6:0], 1'b0};
    ext_val[2] = dev_tx[7];
  end


  // ---------------- behavioural I2C peripheral at 0x50, SDA = pin 4, SCL = pin 5 ----------------
  // Register device: write [reg] [data...] stores bytes; reads return bytes from the pointer.
  // It holds SCL low for I2C_STRETCH clocks after bit 4 and bit 8 of every byte (clock stretching).
  localparam int SDA = 4, SCL = 5, I2C_STRETCH = 120;
  localparam logic [6:0] I2C_ADDR = 7'h50;
  localparam int I_IDLE = 0, I_ADDR = 1, I_REG = 2, I_WDATA = 3, I_RDATA = 4;
  logic [7:0] i2c_mem[256];
  logic [7:0] i_ptr, i_sh;
  int i_st = I_IDLE, i_bit = 0, i_starts = 0, i_stops = 0, i_stretches = 0;
  bit i2c_en = 0, i_acking = 0;

  task automatic i_sda(input bit v);  // open drain: 0 pulls low, 1 releases
    ext_drive[SDA] = !v;
    ext_val[SDA] = 0;
  endtask

  always @(negedge bus[SDA]) if (i2c_en && bus[SCL]) begin  // START
    i_st = I_ADDR;
    i_bit = 0;
    i_starts++;
  end
  always @(posedge bus[SDA]) if (i2c_en && bus[SCL]) begin  // STOP
    i_st = I_IDLE;
    i_stops++;
  end
  always @(posedge bus[SCL]) if (i2c_en && i_st != I_IDLE) begin
    i_bit++;
    if (i_bit <= 8 && i_st != I_RDATA) i_sh = {i_sh[6:0], bus[SDA]};
    if (i_bit == 9 && i_st == I_RDATA && bus[SDA]) i_st = I_IDLE;  // controller NACKed: stop sending
  end
  always @(negedge bus[SCL]) if (i2c_en && i_st != I_IDLE) begin
    if (i_bit == 8) begin
      i_acking = 1;
      case (i_st)
        I_ADDR:  if (i_sh[7:1] == I2C_ADDR) i_st = i_sh[0] ? I_RDATA : I_REG;
                 else begin i_st = I_IDLE; i_acking = 0; end
        I_REG:   begin i_ptr = i_sh; i_st = I_WDATA; end
        I_WDATA: begin i2c_mem[i_ptr] = i_sh; i_ptr++; end
        default: i_acking = 0;  // sending: the controller drives the ACK slot
      endcase
      i_sda(!i_acking);
    end else if (i_bit == 9) begin
      i_bit = 0;
      if (i_st == I_RDATA) begin
        i_sh = i2c_mem[i_ptr];
        i_ptr++;
        i_sda(i_sh[7]);
      end else i_sda(1);
    end else if (i_st == I_RDATA && i_bit >= 1) begin
      i_sda(i_sh[7 - i_bit]);
    end
    // clock stretching mid-byte and before the ACK slot: keep SCL low a while
    if (i_bit == 4 || i_bit == 8) begin
      ext_drive[SCL] = 1;
      ext_val[SCL] = 0;
      i_stretches++;
      scl_stretched = 1;
      repeat (I2C_STRETCH) @(posedge clk);
      ext_drive[SCL] = 0;
    end
  end
  // a read starts right after the address ACK: first bit goes out when that ACK clock ends
  always @(negedge bus[SCL]) if (i2c_en && i_st == I_RDATA && i_bit == 0 && i_acking) begin
    i_acking = 0;
  end

  // SCL timing against I2C fast mode: low >= 1.3 us, high >= 0.6 us, period >= 2.5 us (BUG-010)
  // The period check skips the cycle right after a stretch: the controller times that high
  // phase from when it sees SCL rise, which the spec allows (only low/high minimums apply).
  realtime scl_fell = 0, scl_rose = 0, scl_min_low = 1e9, scl_min_high = 1e9, scl_min_period = 1e9;
  bit scl_stretched = 0, scl_after_stretch = 0;
  always @(posedge bus[SCL]) if (i2c_en) begin
    if (scl_fell > 0 && $realtime - scl_fell < scl_min_low) scl_min_low = $realtime - scl_fell;
    if (scl_rose > 0 && !scl_after_stretch && $realtime - scl_rose < scl_min_period)
      scl_min_period = $realtime - scl_rose;
    scl_after_stretch = scl_stretched;
    scl_stretched = 0;
    scl_rose = $realtime;
  end
  always @(negedge bus[SCL]) if (i2c_en) begin
    if (scl_rose > 0 && $realtime - scl_rose < scl_min_high) scl_min_high = $realtime - scl_rose;
    scl_fell = $realtime;
  end

  // FLAG1 must clear only once the STOP is on the bus (BUG-011)
  wire i2c_stop_flag = dut.flags[fphys(1, 1)];  // engine 1's FLAG1
  always @(negedge i2c_stop_flag) if (i2c_en)
    check(bus[SDA] && bus[SCL], "I2C: FLAG1 (STOP) cleared before the STOP finished");

  // host-side helpers for the i2c_ctrl program on engine 1
  task automatic wait_tx_empty(input int e);
    logic [7:0] st;
    do reg_read(7'h01, st); while (!st[e*4+2]);
  endtask
  // FLAG0 = START: happens when the next byte is queued.
  // FLAG1 = STOP: happens right away; wait until the engine clears the flag.
  task automatic i2c_cond(input logic [3:0] flag);
    bit b;
    wait_tx_empty(1);
    if (flag[0]) flag_set(1, 0);
    if (flag[1]) begin
      flag_set(1, 1);
      do flag_get(1, 1, b); while (b);
    end
  endtask
  task automatic i2c_xfer(input logic [7:0] data, input logic [7:0] ack_out,
                          output logic [7:0] seen, output logic [7:0] ack_in);
    fifo_send(1, data);
    fifo_send(1, ack_out);
    fifo_recv(1, seen);
    fifo_recv(1, ack_in);
  endtask


  // ---------------- low-speed USB models ----------------
  // USB CRC16 over u_pkt[1..] (the PID is not covered); u_crc gets the field, [7:0] sent first.
  logic [7:0]  u_pkt[$];
  logic [15:0] u_crc, u_c;
  logic [7:0]  u_byte;
  int          u_i, u_b;
  task usb_crc16;
    u_c = 16'hFFFF;
    for (u_i = 1; u_i < u_pkt.size(); u_i++) begin
      u_byte = u_pkt[u_i];
      for (u_b = 0; u_b < 8; u_b++) u_c = {u_c[14:0], 1'b0} ^ ((u_byte[u_b] ^ u_c[15]) ? 16'h8005 : 16'h0);
    end
    for (u_b = 0; u_b < 16; u_b++) u_crc[u_b] = ~u_c[15-u_b];
  endtask

  // Monitor: decodes every packet the chip sends on D+ = pin 0, D- = pin 1 while usb_mon_en
  // is set. Same clock as the chip, so a bit is 32 clocks; it re-centres on every D+ edge.
  logic [7:0] cap_q[$];
  int cap_stuffed, cap_se0, cap_count = 0;
  bit cap_j, usb_mon_en = 0;
  int m_phase, m_ones, m_nbits;
  bit m_last_dp, m_prev_k, m_in_sync, m_b;
  logic [7:0] m_sh;
  initial forever begin
    wait (usb_mon_en && bus[0] && !bus[1]);  // K: SYNC starts
    cap_q.delete();
    cap_stuffed = 0;
    m_phase = 0;
    m_ones = 0;
    m_nbits = 0;
    m_last_dp = 1;
    m_prev_k = 0;
    m_in_sync = 1;
    while (!(m_phase % 32 == 16 && !bus[0] && !bus[1])) begin  // until SE0 at mid-bit
      @(posedge clk);
      if (bus[0] != m_last_dp) begin
        m_last_dp = bus[0];
        m_phase = 0;
      end else m_phase++;
      if (m_phase % 32 == 16 && (bus[0] || bus[1])) begin
        m_b = (bus[0] == m_prev_k);
        m_prev_k = bus[0];
        if (m_in_sync) begin
          if (m_b) begin
            m_in_sync = 0;
            m_ones = 1;
          end
        end else if (m_ones == 6) begin
          check(!m_b, "USB TX: missing stuffed 0 after six 1s");
          cap_stuffed++;
          m_ones = 0;
        end else begin
          m_sh = {m_b, m_sh[7:1]};
          m_nbits++;
          m_ones = m_b ? m_ones + 1 : 0;
          if (m_nbits % 8 == 0) cap_q.push_back(m_sh);
        end
      end
    end
    cap_se0 = 16;  // SE0 seen at mid-bit; count to its end
    while (!bus[0] && !bus[1]) begin
      @(posedge clk);
      cap_se0++;
    end
    cap_j = !bus[0] && bus[1];
    cap_count++;
  end

  // Send u_pkt to the chip on D+ = pin 2, D- = pin 3, bit rate off by h_pct percent.
  real h_pct, h_bit;
  bit  h_k, h_bad_stuff = 0;  // h_bad_stuff: send a 1 where the first stuffed 0 belongs
  int  h_ones, h_i, h_b;
  logic [7:0] h_cur;
  task usb_host_send;
    h_bit = (1.0e9 / 1.5e6) / (1.0 + h_pct / 100.0);  // ns
    h_k = 0;
    h_ones = 0;
    ext_drive[3:2] = 2'b11;
    for (h_i = -1; h_i < u_pkt.size(); h_i++) begin
      h_cur = (h_i < 0) ? 8'h80 : u_pkt[h_i];  // SYNC first
      for (h_b = 0; h_b < 8; h_b++) begin
        if (!h_cur[h_b]) h_k = !h_k;
        ext_val[2] = h_k;
        ext_val[3] = !h_k;
        #(h_bit);
        h_ones = h_cur[h_b] ? h_ones + 1 : 0;
        if (h_ones == 6) begin  // stuffed 0
          if (!h_bad_stuff) h_k = !h_k;
          h_bad_stuff = 0;
          ext_val[2] = h_k;
          ext_val[3] = !h_k;
          #(h_bit);
          h_ones = 0;
        end
      end
    end
    ext_val[3:2] = 2'b00;  // SE0, SE0
    #(2 * h_bit);
    ext_val[3:2] = 2'b10;  // J
    #(h_bit);
    ext_drive[3:2] = 2'b00;
    #(2 * h_bit);
  endtask

  // Engine 0 sends u_pkt (plus a CRC16 if t_crc); the monitor must decode exactly that.
  logic [7:0] t_exp[$], t_got, t_f;
  bit   t_crc, t_b0, t_b1;
  int   t_prev, t_i;
  string t_what;
  task usb_tx_check;
    t_exp = u_pkt;
    if (t_crc) begin
      usb_crc16;
      t_got = u_crc[7:0];
      t_exp.push_back(t_got);
      t_got = u_crc[15:8];
      t_exp.push_back(t_got);
    end
    for (t_i = 0; t_i < u_pkt.size(); t_i++) fifo_send(0, u_pkt[t_i]);
    t_prev = cap_count;
    if (t_crc) flag_set(0, 1);       // FLAG1 = append CRC16
    flag_set(0, 0);                  // FLAG0 = send
    while (cap_count == t_prev) @(posedge clk);
    check(cap_q.size() == t_exp.size(), $sformatf("USB TX %s: %0d bytes, expected %0d", t_what, cap_q.size(), t_exp.size()));
    for (t_i = 0; t_i < t_exp.size() && t_i < cap_q.size(); t_i++)
      check(cap_q[t_i] === t_exp[t_i], $sformatf("USB TX %s byte %0d: got %02x, expected %02x", t_what, t_i, cap_q[t_i], t_exp[t_i]));
    check(cap_se0 >= 60 && cap_se0 <= 68, $sformatf("USB TX %s: SE0 lasted %0d clocks, expected 64", t_what, cap_se0));
    check(cap_j, $sformatf("USB TX %s: no J after SE0", t_what));
    do begin
      flag_get(0, 0, t_b0);
      flag_get(0, 1, t_b1);
    end while (t_b0 || t_b1);
    $display("  sent %s: %0d bytes, %0d stuffed bits, EOP ok", t_what, cap_q.size(), cap_stuffed);
  endtask

  // The host model sends u_pkt to engine 1; check the bytes and status it pushes.
  logic [7:0] r_mask, r_exp, r_got;
  task usb_rx_check;
    usb_host_send;
    for (t_i = 0; t_i < u_pkt.size(); t_i++) begin
      fifo_recv(1, r_got);
      check(r_got === u_pkt[t_i], $sformatf("USB RX %s byte %0d: got %02x, sent %02x", t_what, t_i, r_got, u_pkt[t_i]));
    end
    fifo_recv(1, r_got);
    check((r_got & r_mask) == r_exp, $sformatf("USB RX %s: status %02x", t_what, r_got));
    $display("  received %s at %+0.1f%% bit rate, status %02x", t_what, h_pct, r_got);
  endtask


  // ---------------- 1-Wire: two DS18B20-style devices on pin 6 ----------------
  localparam int OW = 6;
  localparam logic [63:0] ROM_A = 64'h2C000800003C5A28;  // family 28, valid CRC8
  localparam logic [63:0] ROM_B = 64'h1B000800003C5B28;
  localparam logic [71:0] OW_SP = 72'h1C100CFF7F464B0550;  // DS18B20 power-up scratchpad, CRC 1C
  bit ow_en_a = 0, ow_en_b = 0, ow_mon = 0;
  wire ow_pull_a, ow_pull_b;
  ow_device #(.ROM(ROM_A), .SP(OW_SP)) u_ow_a (.dq(bus[OW]), .enable(ow_en_a), .pull(ow_pull_a));
  ow_device #(.ROM(ROM_B), .SP(OW_SP)) u_ow_b (.dq(bus[OW]), .enable(ow_en_b), .pull(ow_pull_b));
  wire ow_pull_any = ow_pull_a | ow_pull_b;

  // Slot timing: every low pulse the controller makes on its own must be a write-1/read pulse
  // (1-15 us), a write-0 pulse (60-120 us) or a reset (>= 480 us); recovery >= 1 us.
  realtime ow_fell = 0, ow_rose = 0;
  bit ow_touched = 0;
  int ow_short = 0, ow_long = 0, ow_resets = 0, ow_bad = 0;
  always @(posedge ow_pull_any) ow_touched = 1;
  always @(negedge bus[OW]) if (ow_mon) begin
    if (ow_rose > 0 && $realtime - ow_rose < 1000) begin
      ow_bad++;
      check(0, $sformatf("1-Wire: recovery %0.0f ns, needs 1 us", $realtime - ow_rose));
    end
    ow_fell = $realtime;
  end
  always @(posedge bus[OW]) if (ow_mon) begin
    if (!ow_touched) begin
      if ($realtime - ow_fell >= 1000 && $realtime - ow_fell <= 15000) ow_short++;
      else if ($realtime - ow_fell >= 60000 && $realtime - ow_fell <= 120000) ow_long++;
      else if ($realtime - ow_fell >= 480000) ow_resets++;
      else begin
        ow_bad++;
        check(0, $sformatf("1-Wire: controller low pulse of %0.0f ns", $realtime - ow_fell));
      end
    end
    ow_touched = 0;
    ow_rose = $realtime;
  end

  // Host side of the onewire_ctrl program on engine 1 (static tasks: see BUG-006).
  logic [7:0] ow_tx, ow_r, ow_f, ow_crc, ow_byte;
  int ow_e = 1;  // engine running the 1-Wire program
  bit ow_fb;
  logic [7:0] ow_buf[$];
  bit ow_present, ow_b;
  int ow_i, ow_j;
  task ow_reset;
    wait_tx_empty(ow_e);
    flag_set(ow_e, 0);        // FLAG0: reset/presence
    do flag_get(ow_e, 0, ow_fb); while (ow_fb);
    fifo_recv(ow_e, ow_r);
    ow_present = (ow_r == 8'h00);
  endtask
  task ow_xbyte;  // send ow_tx as 8 slots; the byte seen comes back in ow_r
    fifo_send(ow_e, ow_tx);
    fifo_recv(ow_e, ow_r);
  endtask
  task ow_xbit;   // single-slot mode: send bit 0 of ow_tx, the bit seen comes back in ow_b
    fifo_send(ow_e, ow_tx);
    fifo_recv(ow_e, ow_r);
    ow_b = ow_r[7];
  endtask
  task ow_read_bytes;  // read ow_i bytes into ow_buf
    ow_buf.delete();
    for (ow_j = ow_i; ow_j > 0; ow_j--) begin
      ow_tx = 8'hFF;
      ow_xbyte;
      ow_buf.push_back(ow_r);
    end
  endtask
  task ow_crc8;   // Dallas CRC8 over ow_buf; 0 when the block ends in its correct CRC
    ow_crc = 0;
    for (ow_i = 0; ow_i < ow_buf.size(); ow_i++) begin
      ow_byte = ow_buf[ow_i];
      for (ow_j = 0; ow_j < 8; ow_j++) begin
        if ((ow_crc ^ ow_byte) & 8'h01) ow_crc = (ow_crc >> 1) ^ 8'h8C;
        else ow_crc = ow_crc >> 1;
        ow_byte = ow_byte >> 1;
      end
    end
  endtask

  // Search ROM, the algorithm from Maxim application note 187, run by the host bit by bit.
  logic [63:0] s_rom;
  int s_last_disc = 0, s_last_zero, s_i;
  bit s_done = 0, s_ok, s_id, s_cmp, s_dir;
  task ow_search_next;  // s_ok = a device was found, its ROM in s_rom
    s_ok = 0;
    if (!s_done) begin
      ow_reset;
      if (ow_present) begin
        ow_tx = 8'hF0;
        ow_xbyte;
        wait_tx_empty(ow_e);
        flag_set(ow_e, 1);        // FLAG1: single-slot mode
        s_last_zero = 0;
        s_ok = 1;
        for (s_i = 1; s_i <= 64; s_i++) begin
          if (s_ok) begin
            ow_tx = 8'h01; ow_xbit; s_id = ow_b;   // the bit
            ow_tx = 8'h01; ow_xbit; s_cmp = ow_b;  // its complement
            if (s_id && s_cmp) s_ok = 0;            // nobody answered
            else begin
              if (s_id != s_cmp) s_dir = s_id;
              else begin                            // discrepancy: devices differ here
                if (s_i < s_last_disc) s_dir = s_rom[s_i-1];
                else s_dir = (s_i == s_last_disc);
                if (!s_dir) s_last_zero = s_i;
              end
              s_rom[s_i-1] = s_dir;
              ow_tx = {7'b0, s_dir};
              ow_xbit;                              // devices that differ drop out
            end
          end
        end
        wait_tx_empty(ow_e);
        flag_clear(ow_e, 1);      // back to byte mode
        s_last_disc = s_last_zero;
        if (s_last_disc == 0) s_done = 1;
      end
    end
  endtask

  // ---------------- Modbus RTU device (RS-485) on pins 0 (master TX), 1 (master RX), 2 (DE) ----------------
  // Independent of the RTL: it samples at exactly 19200 baud, checks even parity, stop bits,
  // that DE is on during every character and off before it answers, and the gaps between
  // characters, then answers with mb_resp (parity flipped on byte mb_bad, if set).
  real MB_BIT = 1.0e9 / 19200.0;  // ns
  bit mb_en = 0;
  int mb_bad = -1, mb_frames = 0, mb_par_err = 0, mb_stop_err = 0, mb_de_err = 0, mb_k, mb_m;
  real mb_max_gap = 0;
  realtime mb_t_end;
  logic [7:0] mb_req_got[$], mb_resp[$];
  logic [7:0] mb_c, mb_o;
  bit mb_p, mb_s, mb_more, mb_first;
  initial forever begin
    wait (mb_en && !bus[0]);  // start bit of a request
    #(MB_BIT / 4);
    if (!bus[0]) begin        // still low: a real start bit, not a glitch (BUG-014)
    mb_req_got.delete();
    mb_more = 1;
    mb_first = 1;
    while (mb_more) begin
      #(mb_first ? MB_BIT * 1.25 : MB_BIT * 1.5);
      mb_first = 0;
      for (mb_k = 0; mb_k < 8; mb_k++) begin
        mb_c[mb_k] = bus[0];
        if (!bus[2]) mb_de_err++;
        #(MB_BIT);
      end
      mb_p = bus[0];
      #(MB_BIT);
      mb_s = bus[0];
      if (^{mb_c, mb_p}) mb_par_err++;
      if (!mb_s) mb_stop_err++;
      mb_req_got.push_back(mb_c);
      mb_t_end = $realtime + MB_BIT / 2;
      while (bus[0] && $realtime - mb_t_end < 3.5 * 11 * MB_BIT) #(MB_BIT / 16);
      if (!bus[0]) begin
        if ($realtime - mb_t_end > mb_max_gap) mb_max_gap = $realtime - mb_t_end;
      end else mb_more = 0;
    end
    mb_frames++;
    if (bus[2]) mb_de_err++;  // the master must have turned its driver off by now
    ext_drive[1] = 1;
    ext_val[1] = 1;
    #(MB_BIT);
    for (mb_m = 0; mb_m < mb_resp.size(); mb_m++) begin
      mb_o = mb_resp[mb_m];
      ext_val[1] = 0;  // start
      #(MB_BIT);
      for (mb_k = 0; mb_k < 8; mb_k++) begin
        ext_val[1] = mb_o[mb_k];
        #(MB_BIT);
      end
      ext_val[1] = ^mb_o ^ (mb_m == mb_bad);  // even parity, optionally wrong
      #(MB_BIT);
      ext_val[1] = 1;  // stop
      #(MB_BIT);
    end
    ext_drive[1] = 0;
    end
  end

  // Any low pulse on the master's TX line shorter than half a bit is a glitch (BUG-013).
  realtime mb_fell = 0;
  int mb_glitches = 0;
  always @(negedge bus[0]) if (mb_en) mb_fell = $realtime;
  always @(posedge bus[0]) if (mb_en && $realtime - mb_fell < MB_BIT / 2) mb_glitches++;

  // Host side of the modbus_rtu program on engine 0.
  logic [7:0] mb_rx[$], mb_par[$], mb_buf[$];
  logic [7:0] mb_f, mb_st, mb_d, mb_x, mb_b;
  logic [15:0] mb_crc;
  bit mb_fdone, mb_fb;
  int mb_i, mb_j, mb_perr;  // mb_i/mb_j belong to the tasks; static tasks share variables
  task mb_crc16;  // Modbus CRC over mb_buf -> mb_crc ({high byte, low byte}; low byte is sent first)
    mb_crc = 16'hFFFF;
    for (mb_i = 0; mb_i < mb_buf.size(); mb_i++) begin
      mb_b = mb_buf[mb_i];
      mb_crc = mb_crc ^ {8'h00, mb_b};
      for (mb_j = 0; mb_j < 8; mb_j++)
        if (mb_crc[0]) mb_crc = (mb_crc >> 1) ^ 16'hA001;
        else mb_crc = mb_crc >> 1;
    end
  endtask
  task mb_send;  // send mb_buf as one request frame
    for (mb_i = 0; mb_i < mb_buf.size(); mb_i++) begin
      mb_b = mb_buf[mb_i];
      fifo_send(0, mb_b);
      fifo_send(0, {7'b0, ^mb_b});  // even parity bit
    end
    wait_tx_empty(0);
    flag_set(0, 1);                  // FLAG1: request complete
    do flag_get(0, 1, mb_fb); while (mb_fb);
  endtask
  task mb_receive;  // collect one response frame into mb_rx / mb_par
    mb_rx.delete();
    mb_par.delete();
    mb_fdone = 0;
    while (!mb_fdone) begin
      flag_get(0, 2, mb_fdone);  // read the flag first, so every byte before it gets drained
      reg_read(7'h01, mb_st);
      while (!mb_st[0]) begin
        fifo_recv(0, mb_d);
        fifo_recv(0, mb_x);
        mb_rx.push_back(mb_d);
        mb_par.push_back(mb_x);
        reg_read(7'h01, mb_st);
      end
    end
  endtask
  assign dev_pull = {1'b0, ow_pull_any, 6'b0};

  // state for the two-protocol test
  logic [63:0] conc_rom;
  logic [7:0] conc_v, conc_seen, conc_ack;
  bit conc_ow_done = 0, conc_i2c_busy = 0;
  int conc_rounds = 0, conc_overlap = 0;
  always @(negedge bus[OW]) if (conc_i2c_busy && !conc_ow_done) conc_overlap++;


  // ---------------- tests ----------------
  initial begin
    logic [7:0] sent[$], got;
    if ($test$plusargs("vcd")) begin  // waveforms on request: vvp sim.vvp +vcd
      $dumpfile("tb_pbe.vcd");
      $dumpvars(0, tb_pbe);
    end

    repeat (5) @(posedge clk);
    rst_n = 1;
    repeat (5) @(posedge clk);

    // register readback sanity check
    reg_write(7'h10, 8'hA5);
    reg_read(7'h10, got);
    check(got == 8'hA5, $sformatf("CLKDIV_L readback %02x", got));

    // ===== Test 0: NOP has no side effects (BUG-008) =====
    $display("Test 0: NOP has no side effects");
    load_program("nop_image.hex");
    reg_write(7'h10, 0);
    reg_write(7'h11, 0);
    reg_write(7'h12, 2);                 // pins 2, 3: a USB pair in v2
    reg_write(7'h15, 0);
    reg_write(7'h00, 8'b0001_0001);      // restart + run E0
    repeat (300) @(posedge clk);
    check(uio_oe == 8'h00, $sformatf("NOP drove pins: uio_oe = %08b", uio_oe));
    check(dut.flags == '0 && !uo_out[1], "NOP changed flags or raised IRQ");
    reg_write(7'h00, 8'b0000_0000);

    // ===== Test 1: UART loopback =====
    $display("Test 1: UART TX (engine 0) looped back into UART RX (engine 1)");
    load_program("uart_image.hex");
    reg_write(7'h10, UART_BIT / 2 - 1);  // E0 tick = 1/2 bit
    reg_write(7'h11, 0);
    reg_write(7'h12, 0);                 // E0 pins start at 0
    reg_write(7'h14, 2'b00);             // LSB first
    reg_write(7'h15, 0);                 // start at word 0
    reg_write(7'h20, UART_BIT / 4 - 1);  // E1 tick = 1/4 bit
    reg_write(7'h21, 0);
    reg_write(7'h22, 1);                 // E1 pins start at 1
    reg_write(7'h23, 0);                 // JMP pin = rx
    reg_write(7'h24, 2'b00);
    reg_write(7'h25, 8);                 // start at word 8
    reg_write(7'h03, 8'b0000_0010);      // pin 1 belongs to E1
    loop01 = 1;
    uart_mon_en = 1;
    reg_write(7'h00, 8'b0011_0011);      // restart + run both

    sent = '{8'h55, 8'hA3, 8'h00, 8'hFF, 8'h0F, 8'h80};
    // one host port, so sends and receives take turns; keep up to 4 bytes queued
    for (int i = 0; i < 4; i++) fifo_send(0, sent[i]);
    foreach (sent[i]) begin
      fifo_recv(1, got);
      check(got === sent[i], $sformatf("UART RX byte %0d: got %02x, sent %02x", i, got, sent[i]));
      if (i + 4 < sent.size()) fifo_send(0, sent[i+4]);
    end
    repeat (2 * UART_BIT) @(posedge clk);
    check(uart_seen.size() == sent.size(), $sformatf("UART monitor saw %0d bytes", uart_seen.size()));
    foreach (uart_seen[i])
      check(uart_seen[i] === sent[i], $sformatf("UART monitor byte %0d: %02x", i, uart_seen[i]));
    $display("  sent %0d bytes, engine 1 and the monitor received them", sent.size());

    // ===== Test 2: SPI controller =====
    $display("Test 2: SPI controller (engine 0) against a mode-0 peripheral");
    reg_write(7'h00, 8'b1100_0000);      // stop both, flush FIFOs
    uart_mon_en = 0;
    loop01 = 0;
    load_program("spi_image.hex");
    reg_write(7'h03, 8'h00);
    reg_write(7'h10, 3);                 // tick = 4 clocks
    reg_write(7'h11, 0);
    reg_write(7'h12, 0);
    reg_write(7'h14, 2'b11);             // MSB first both ways
    reg_write(7'h15, 0);
    spi_reply = '{8'h3C, 8'hC3, 8'h81};
    spi_dev_en = 1;
    reg_write(7'h00, 8'b0001_0001);      // restart + run E0
    repeat (50) @(posedge clk);
    check(bus[3] == 1 && bus[0] == 0, "SPI idle: CS_n high, SCLK low");

    sent = '{8'hA5, 8'h5A, 8'h7E};
    foreach (sent[i]) fifo_send(0, sent[i]);
    foreach (sent[i]) begin
      fifo_recv(0, got);
      check(got === (i == 0 ? 8'h3C : i == 1 ? 8'hC3 : 8'h81),
            $sformatf("SPI read byte %0d: got %02x", i, got));
    end
    repeat (100) @(posedge clk);
    check(bus[3] == 1, "SPI: CS_n released at the end");
    check(spi_got.size() == 3, $sformatf("SPI peripheral got %0d bytes", spi_got.size()));
    foreach (spi_got[i])
      check(spi_got[i] === sent[i], $sformatf("SPI peripheral byte %0d: %02x, expected %02x", i, spi_got[i], sent[i]));
    $display("  exchanged %0d bytes in both directions", spi_got.size());

    // ===== Test 3: I2C on engine 1 while engine 0 sends UART =====
    $display("Test 3: I2C controller (engine 1, pins 4-5) running alongside UART TX (engine 0)");
    reg_write(7'h00, 8'b1100_0000);      // stop both, flush FIFOs
    spi_dev_en = 0;
    ext_drive = '0;
    load_program("mixed_image.hex");
    reg_write(7'h03, 8'b0011_0000);      // pins 4, 5 belong to E1
    reg_write(7'h10, UART_BIT / 2 - 1);  // E0: UART TX as in test 1
    reg_write(7'h11, 0);
    reg_write(7'h12, 0);
    reg_write(7'h14, 2'b00);
    reg_write(7'h15, 0);
    reg_write(7'h20, 17);                // E1 tick = 18 clocks, SCL = 7 ticks: I2C fast mode (<= 400 kHz)
    reg_write(7'h21, 0);
    reg_write(7'h22, 4);                 // E1 pins start at 4
    reg_write(7'h24, 2'b11);             // MSB first
    reg_write(7'h25, 8);                 // i2c_ctrl at word 8
    uart_seen.delete();
    uart_mon_en = 1;
    i2c_en = 1;
    reg_write(7'h00, 8'b0011_0011);      // restart + run both

    sent = '{8'hC3, 8'h3C, 8'h99, 8'h66};
    foreach (sent[i]) fifo_send(0, sent[i]);  // UART keeps running during the I2C traffic

    begin
      logic [7:0] seen, ack;
      // write 0xDE, 0xAD to registers 0x10, 0x11
      i2c_cond(1);
      i2c_xfer(8'hA0, 8'h80, seen, ack); check(ack == 0, "I2C: address+W not ACKed");
      i2c_xfer(8'h10, 8'h80, seen, ack); check(ack == 0, "I2C: register not ACKed");
      i2c_xfer(8'hDE, 8'h80, seen, ack); check(ack == 0, "I2C: data 0 not ACKed");
      i2c_xfer(8'hAD, 8'h80, seen, ack); check(ack == 0, "I2C: data 1 not ACKed");
      i2c_cond(2);
      check(i2c_mem[8'h10] === 8'hDE && i2c_mem[8'h11] === 8'hAD,
            $sformatf("I2C write: peripheral holds %02x %02x", i2c_mem[8'h10], i2c_mem[8'h11]));

      // read them back: write the register pointer, repeated START, read 2 bytes
      i2c_cond(1);
      i2c_xfer(8'hA0, 8'h80, seen, ack); check(ack == 0, "I2C: address+W not ACKed (read)");
      i2c_xfer(8'h10, 8'h80, seen, ack); check(ack == 0, "I2C: pointer not ACKed");
      i2c_cond(1);                                                  // repeated START
      i2c_xfer(8'hA1, 8'h80, seen, ack); check(ack == 0, "I2C: address+R not ACKed");
      i2c_xfer(8'hFF, 8'h00, seen, ack); check(seen === 8'hDE, $sformatf("I2C read 0: %02x", seen));
      i2c_xfer(8'hFF, 8'h80, seen, ack); check(seen === 8'hAD, $sformatf("I2C read 1: %02x", seen));
      check(ack == 1, "I2C: last read byte should carry our NACK");
      i2c_cond(2);

      // nobody at 0x58: expect a NACK
      i2c_cond(1);
      i2c_xfer(8'hB0, 8'h80, seen, ack); check(ack == 1, "I2C: missing device should NACK");
      i2c_cond(2);
    end
    repeat (50) @(posedge clk);
    check(bus[SDA] && bus[SCL], "I2C: bus not idle (both high) at the end");
    check(i_starts == 4 && i_stops == 3, $sformatf("I2C: saw %0d STARTs, %0d STOPs", i_starts, i_stops));
    check(i_stretches >= 20, $sformatf("I2C: only %0d clock stretches", i_stretches));
    check(scl_min_low >= 1300, $sformatf("I2C: SCL low %0.0f ns, fast mode needs 1300", scl_min_low));
    check(scl_min_high >= 600, $sformatf("I2C: SCL high %0.0f ns, fast mode needs 600", scl_min_high));
    check(scl_min_period >= 2500, $sformatf("I2C: SCL period %0.0f ns, over 400 kHz", scl_min_period));

    wait (uart_seen.size() == sent.size() || $time > 15ms);
    foreach (sent[i])
      check(uart_seen[i] === sent[i], $sformatf("UART during I2C: byte %0d %02x", i, uart_seen[i]));
    $display("  I2C write, read with repeated START, and NACK passed with %0d clock stretches;", i_stretches);
    $display("  UART sent %0d bytes at the same time", uart_seen.size());
    $display("  SCL min low %0.0f ns, min high %0.0f ns, min period %0.0f ns", scl_min_low, scl_min_high, scl_min_period);

    // ===== Test 4: low-speed USB =====
    $display("Test 4: low-speed USB TX (engine 0, pins 0/1) and RX (engine 1, pins 2/3)");
    reg_write(7'h00, 8'b1100_0000);      // stop both, flush FIFOs
    uart_mon_en = 0;
    i2c_en = 0;
    ext_drive = '0;
    reg_write(7'h04, 8'h00);
    pull_lo = 8'b0000_0101;             // D+ pulled down (host side), D- pulled up (LS device)
    load_program("usb_image.hex");
    reg_write(7'h03, 8'b0000_1100);      // pins 2, 3 belong to E1
    for (int e = 0; e < 2; e++) begin
      reg_write(7'h10 + 7'(e * 16), 0);  // CLKDIV 0: the line unit does the bit timing
      reg_write(7'h11 + 7'(e * 16), 0);
      reg_write(7'h12 + 7'(e * 16), e ? 2 : 0);
      reg_write(7'h14 + 7'(e * 16), 2'b00);  // LSB first
      reg_write(7'h15 + 7'(e * 16), e ? 40 : 0);
      reg_write(7'h17 + 7'(e * 16), 31);     // 32 clocks per bit = 1.5 Mbit/s at 48 MHz
    end
    reg_write(7'h00, 8'b0011_0011);
    repeat (100) @(posedge clk);
    check(!bus[0] && bus[1] && !bus[2] && bus[3], "USB: both pairs should idle in J");
    usb_mon_en = 1;

    u_pkt = '{8'hC3, 8'h80, 8'h06, 8'h00, 8'h01, 8'h00, 8'h00, 8'h40, 8'h00};
    usb_crc16;
    check(u_crc == 16'h94DD, $sformatf("tb CRC16 model: %04x, expected 94dd (bytes DD 94)", u_crc));
    t_crc = 1; t_what = "DATA0 GET_DESCRIPTOR";       usb_tx_check;
    u_pkt = '{8'hD2};
    t_crc = 0; t_what = "ACK handshake";              usb_tx_check;
    u_pkt = '{8'h4B, 8'hFF, 8'hFF, 8'hFF};
    t_crc = 1; t_what = "DATA1 with long runs of 1s"; usb_tx_check;

    u_pkt = '{8'h2D, 8'h00, 8'h10};
    h_pct = 1.5;  r_mask = 8'h05; r_exp = 8'h01; t_what = "SETUP token";                 usb_rx_check;
    u_pkt = '{8'h2D, 8'h00, 8'h11};
    h_pct = -1.5; r_mask = 8'h05; r_exp = 8'h00; t_what = "SETUP token with a bad CRC5"; usb_rx_check;
    u_pkt = '{8'hC3, 8'hFF, 8'hFF, 8'hFF, 8'hFF, 8'h80, 8'h06, 8'h00, 8'h01};
    usb_crc16;
    u_pkt.push_back(u_crc[7:0]);
    u_pkt.push_back(u_crc[15:8]);
    h_pct = -1.5; r_mask = 8'h06; r_exp = 8'h02; t_what = "DATA0 with stuffed bits";     usb_rx_check;
    h_bad_stuff = 1;                     // same packet, but a 1 where a stuffed 0 must be (BUG-009)
    h_pct = 0.0;  r_mask = 8'h04; r_exp = 8'h04; t_what = "DATA0 with a bit-stuffing error"; usb_rx_check;
    u_pkt[3] = 8'hFE;
    h_pct = 1.5;  r_mask = 8'h02; r_exp = 8'h00; t_what = "DATA0 with a flipped bit";    usb_rx_check;
    // $fatal gives a non-zero exit code, so make and CI see the failure (BUG-007)
    // ===== Test 5: 1-Wire =====
    $display("Test 5: 1-Wire controller (engine 1, pin 6) with two DS18B20-style devices");
    reg_write(7'h00, 8'b1100_0000);      // stop both, flush FIFOs
    uart_mon_en = 0;
    i2c_en = 0;
    loop01 = 0;
    ext_drive = '0;
    usb_mon_en = 0;
    pull_lo = '0;
    reg_write(7'h04, 8'h00);
    reg_write(7'h02, 8'h03);
    load_program("ow_image.hex");
    reg_write(7'h03, 8'b0100_0000);      // pin 6 belongs to E1
    reg_write(7'h20, 8'($rtoi(1000.0 / CLK_NS + 0.5) - 1));  // tick = 1 us
    reg_write(7'h21, 0);
    reg_write(7'h22, OW);
    reg_write(7'h24, 2'b00);             // LSB first
    reg_write(7'h25, 0);
    ow_mon = 1;
    reg_write(7'h00, 8'b0010_0010);      // restart + run E1 only

    ow_reset;
    check(!ow_present, "1-Wire: presence reported with no device on the bus");
    ow_en_a = 1;
    ow_reset;
    check(ow_present, "1-Wire: no presence pulse from device A");
    ow_tx = 8'h33; ow_xbyte;             // READ ROM (one device only)
    ow_i = 8; ow_read_bytes;
    for (ow_i = 0; ow_i < 8; ow_i++)
      check(ow_buf[ow_i] === ROM_A[8*ow_i+:8], $sformatf("1-Wire READ ROM byte %0d: %02x", ow_i, ow_buf[ow_i]));
    ow_crc8;
    check(ow_crc == 0, "1-Wire: READ ROM CRC8 failed");
    $display("  presence, absence and READ ROM ok");

    ow_en_b = 1;                         // two devices: find both with Search ROM
    s_done = 0;
    s_last_disc = 0;
    ow_search_next;
    check(s_ok, "1-Wire: search found no device");
    ow_buf.delete();
    for (ow_i = 0; ow_i < 8; ow_i++) ow_buf.push_back(s_rom[8*ow_i+:8]);
    ow_crc8;
    check(ow_crc == 0 && (s_rom == ROM_A || s_rom == ROM_B), $sformatf("1-Wire: search 1 found %016x", s_rom));
    ow_tx = 8'hxx;
    begin
      logic [63:0] first;
      first = s_rom;
      ow_search_next;
      check(s_ok && s_done, "1-Wire: search did not find a second device");
      check(s_rom != first && (s_rom == ROM_A || s_rom == ROM_B), $sformatf("1-Wire: search 2 found %016x", s_rom));
      $display("  Search ROM found %016x and %016x", first, s_rom);
    end

    ow_reset;                            // MATCH ROM device B, then READ SCRATCHPAD
    ow_tx = 8'h55; ow_xbyte;
    for (ow_j = 0; ow_j < 8; ow_j++) begin
      ow_tx = ROM_B[8*ow_j+:8];
      fifo_send(ow_e, ow_tx);
      fifo_recv(ow_e, ow_r);
    end
    ow_tx = 8'hBE; ow_xbyte;
    ow_i = 9; ow_read_bytes;
    for (ow_i = 0; ow_i < 9; ow_i++)
      check(ow_buf[ow_i] === OW_SP[8*ow_i+:8], $sformatf("1-Wire scratchpad byte %0d: %02x", ow_i, ow_buf[ow_i]));
    ow_crc8;
    check(ow_crc == 0, "1-Wire: scratchpad CRC8 failed");
    ow_mon = 0;
    check(ow_bad == 0 && ow_short > 0 && ow_long > 0 && ow_resets >= 5,
          $sformatf("1-Wire timing: %0d bad, %0d short, %0d long, %0d resets", ow_bad, ow_short, ow_long, ow_resets));
    $display("  MATCH ROM + READ SCRATCHPAD ok; timing checked on %0d short, %0d long pulses and %0d resets",
             ow_short, ow_long, ow_resets);
    ow_en_a = 0;
    ow_en_b = 0;

    // ===== Test 6: Modbus RTU =====
    $display("Test 6: Modbus RTU master (engine 0, pins 0-2) with an RS-485 device model, 19200 8E1");
    reg_write(7'h00, 8'b1100_0000);
    reg_write(7'h04, 8'h00);
    reg_write(7'h02, 8'h03);
    load_program("modbus_image.hex");
    reg_write(7'h03, 8'h00);
    begin
      int div;
      div = $rtoi(1.0e9 / 19200.0 / 8.0 / CLK_NS + 0.5) - 1;  // tick = 1/8 bit
      reg_write(7'h10, div[7:0]);
      reg_write(7'h11, div[15:8]);
    end
    reg_write(7'h12, 0);
    reg_write(7'h13, 1);                 // JMP pin = rx
    reg_write(7'h14, 2'b00);             // LSB first
    reg_write(7'h15, 0);
    mb_en = 1;
    reg_write(7'h00, 8'b0001_0001);      // restart + run E0 only

    for (int round = 0; round < 2; round++) begin
      mb_bad = round ? 3 : -1;           // second round: response byte 3 has a parity error
      mb_resp = '{8'h01, 8'h03, 8'h04, 8'h12, 8'h34, 8'h56, 8'h78, 8'h81, 8'h07};
      mb_buf = '{8'h01, 8'h03, 8'h00, 8'h00, 8'h00, 8'h02};
      mb_crc16;
      mb_buf.push_back(mb_crc[7:0]);
      mb_buf.push_back(mb_crc[15:8]);
      check(mb_crc == 16'h0BC4, $sformatf("tb Modbus CRC model: %04x, expected 0bc4 (bytes C4 0B)", mb_crc));
      mb_send;
      mb_receive;
      check(uo_out[1], "Modbus: no IRQ at the end of the response");
      flag_clear(0, 2);
      reg_write(7'h02, 8'h03);
      check(mb_req_got.size() == 8, $sformatf("Modbus: device got %0d request bytes", mb_req_got.size()));
      for (mb_i = 0; mb_i < 8 && mb_i < mb_req_got.size(); mb_i++)
        check(mb_req_got[mb_i] === mb_buf[mb_i], $sformatf("Modbus request byte %0d: %02x", mb_i, mb_req_got[mb_i]));
      check(mb_rx.size() == mb_resp.size(), $sformatf("Modbus: host got %0d response bytes", mb_rx.size()));
      mb_perr = 0;
      for (mb_i = 0; mb_i < mb_rx.size(); mb_i++) begin
        check(mb_rx[mb_i] === mb_resp[mb_i], $sformatf("Modbus response byte %0d: %02x", mb_i, mb_rx[mb_i]));
        mb_x = mb_par[mb_i];
        mb_d = mb_rx[mb_i];
        if ((^mb_d) != mb_x[7]) mb_perr++;  // parity errors the host detects
      end
      mb_buf = mb_rx;
      mb_crc16;
      check(mb_crc == 16'h0000, "Modbus: response CRC failed");  // CRC over data + CRC is 0
      check(mb_perr == (round ? 1 : 0), $sformatf("Modbus round %0d: host found %0d parity errors", round, mb_perr));
    end
    check(mb_par_err == 0 && mb_stop_err == 0 && mb_de_err == 0,
          $sformatf("Modbus: device saw %0d parity, %0d stop, %0d DE errors", mb_par_err, mb_stop_err, mb_de_err));
    check(mb_max_gap <= 1.5 * 11 * MB_BIT, $sformatf("Modbus: %0.0f ns gap inside a request", mb_max_gap));
    check(mb_glitches == 0, $sformatf("Modbus: %0d glitches on the TX line", mb_glitches));
    $display("  2 request/response exchanges ok; largest gap inside a request %0.0f ns (limit %0.0f)",
             mb_max_gap, 1.5 * 11 * MB_BIT);
    $display("  a parity error in the response was reported to the host");
    mb_en = 0;

    // ===== Test 7: two flag-using protocols at once (BUG-017) =====
    $display("Test 7: 1-Wire Search ROM (engine 0, pin 6) and I2C (engine 1, pins 4-5) at the same time");
    reg_write(7'h00, 8'b1100_0000);
    mb_en = 0;
    reg_write(7'h04, 8'h00);
    reg_write(7'h02, 8'h03);
    load_program("conc_image.hex");      // i2c_ctrl at word 0, onewire_ctrl at word 34
    reg_write(7'h03, 8'b0011_0000);      // pins 4, 5 to E1; pin 6 to E0
    reg_write(7'h10, 8'($rtoi(1000.0 / CLK_NS + 0.5) - 1));  // E0: 1-Wire, tick = 1 us
    reg_write(7'h11, 0);
    reg_write(7'h12, OW);
    reg_write(7'h14, 2'b00);
    reg_write(7'h15, 34);
    reg_write(7'h20, 17);                // E1: I2C fast mode
    reg_write(7'h21, 0);
    reg_write(7'h22, 4);
    reg_write(7'h24, 2'b11);
    reg_write(7'h25, 0);
    ow_e = 0;
    ow_en_a = 1;
    ow_en_b = 1;
    ow_mon = 1;
    ow_bad = 0;
    i2c_en = 1;
    i_starts = 0;
    i_stops = 0;
    reg_write(7'h00, 8'b0011_0011);      // restart + run both
    fork
      begin  // host process A: 1-Wire on engine 0
        ow_reset;
        check(ow_present, "concurrent 1-Wire: no presence");
        s_done = 0;
        s_last_disc = 0;
        ow_search_next;
        conc_rom = s_rom;
        ow_search_next;
        check(s_done && ((conc_rom == ROM_A && s_rom == ROM_B) || (conc_rom == ROM_B && s_rom == ROM_A)),
              $sformatf("concurrent 1-Wire search found %016x, %016x", conc_rom, s_rom));
        conc_ow_done = 1;
      end
      begin  // host process B: I2C on engine 1, until 1-Wire is done (at least 3 rounds)
        conc_i2c_busy = 1;
        conc_rounds = 0;
        while (!conc_ow_done || conc_rounds < 3) begin
          conc_v = 8'h40 + conc_rounds;
          i2c_cond(1);
          i2c_xfer(8'hA0, 8'h80, conc_seen, conc_ack); check(conc_ack == 0, "concurrent I2C: address not ACKed");
          i2c_xfer(8'h20, 8'h80, conc_seen, conc_ack);
          i2c_xfer(conc_v, 8'h80, conc_seen, conc_ack);
          i2c_cond(2);
          i2c_cond(1);
          i2c_xfer(8'hA0, 8'h80, conc_seen, conc_ack);
          i2c_xfer(8'h20, 8'h80, conc_seen, conc_ack);
          i2c_cond(1);
          i2c_xfer(8'hA1, 8'h80, conc_seen, conc_ack);
          i2c_xfer(8'hFF, 8'h80, conc_seen, conc_ack);
          check(conc_seen === conc_v, $sformatf("concurrent I2C round %0d read %02x, wrote %02x", conc_rounds, conc_seen, conc_v));
          i2c_cond(2);
          conc_rounds++;
        end
        conc_i2c_busy = 0;
      end
    join
    ow_mon = 0;
    check(ow_bad == 0, "concurrent 1-Wire: timing violations");
    check(i_starts == 3 * conc_rounds && i_stops == 2 * conc_rounds,
          $sformatf("concurrent I2C: %0d STARTs, %0d STOPs for %0d rounds", i_starts, i_stops, conc_rounds));
    check(conc_overlap > 100, $sformatf("only %0d 1-Wire edges happened during I2C traffic", conc_overlap));
    $display("  Search ROM found both devices while I2C ran %0d write/read rounds; %0d 1-Wire edges overlapped I2C traffic",
             conc_rounds, conc_overlap);
    ow_en_a = 0;
    ow_en_b = 0;
    i2c_en = 0;

    if (errors == 0) begin
      $display("PASS");
      $finish;
    end else $fatal(1, "FAILED with %0d error(s)", errors);
  end

  initial begin
    #200ms;
    $fatal(1, "FAILED: timeout");
  end
endmodule

// A DS18B20-style 1-Wire device: presence pulse, READ ROM (33), SEARCH ROM (F0), MATCH ROM (55),
// SKIP ROM (CC) and READ SCRATCHPAD (BE). It samples written bits 30 us into a slot and holds
// the line low for 30 us to send a 0. Written independently of the RTL.
module ow_device #(
    parameter logic [63:0] ROM = 64'h0,
    parameter logic [71:0] SP  = 72'h0
) (
    input  wire  dq,
    input  wire  enable,
    output logic pull
);
  localparam int S_IDLE = 0, S_CMD = 1, S_ROMTX = 2, S_SRCH = 3, S_MATCH = 4, S_FUNC = 5, S_SPTX = 6;
  int st = S_IDLE, n = 0, sub = 0;
  logic [63:0] sh;
  bit tx_mode, tx_bit, b;
  realtime t0;
  initial begin
    pull = 0;
    forever begin
      @(negedge dq);
      if (enable && !pull) begin
        tx_mode = 0;
        tx_bit = 1;
        if (st == S_ROMTX) begin tx_mode = 1; tx_bit = ROM[n]; end
        if (st == S_SRCH && sub < 2) begin tx_mode = 1; tx_bit = sub ? !ROM[n] : ROM[n]; end
        if (st == S_SPTX) begin tx_mode = 1; tx_bit = SP[n]; end
        t0 = $realtime;
        if (tx_mode && !tx_bit) pull = 1;
        #30000;
        b = dq;
        pull = 0;
        while (!dq && $realtime - t0 < 400000) #1000;
        if (!dq) begin  // reset pulse: answer with a presence pulse
          @(posedge dq);
          #30000;
          pull = 1;
          #120000;
          pull = 0;
          st = S_CMD;
          n = 0;
          sh = 0;
        end else begin
          case (st)
            S_CMD: begin
              sh[n] = b;
              n++;
              if (n == 8) begin
                n = 0;
                case (sh[7:0])
                  8'h33: st = S_ROMTX;
                  8'hF0: begin st = S_SRCH; sub = 0; end
                  8'h55: st = S_MATCH;
                  8'hCC: st = S_FUNC;
                  default: st = S_IDLE;
                endcase
                sh = 0;
              end
            end
            S_ROMTX: begin n++; if (n == 64) st = S_IDLE; end
            S_SRCH: begin
              if (sub < 2) sub++;
              else begin
                sub = 0;
                if (b != ROM[n]) st = S_IDLE;  // controller chose the other branch
                else begin
                  n++;
                  if (n == 64) st = S_IDLE;
                end
              end
            end
            S_MATCH: begin
              sh[n] = b;
              n++;
              if (n == 64) begin
                st = (sh == ROM) ? S_FUNC : S_IDLE;
                n = 0;
                sh = 0;
              end
            end
            S_FUNC: begin
              sh[n] = b;
              n++;
              if (n == 8) begin
                st = (sh[7:0] == 8'hBE) ? S_SPTX : S_IDLE;
                n = 0;
              end
            end
            S_SPTX: begin n++; if (n == 72) st = S_IDLE; end
            default: ;
          endcase
        end
      end
    end
  end
endmodule
