ayushyadavnvs/jane_street/(commit log)

2026-10-27 Add protocol emulator ASIC design, versions 1 and 2
    Programmable Bit Engine for the Jane Street protocol emulator ASIC
    competition (Tiny Tapeout, IHP CMOS5L).
    - pbe_v1: two programmable engines with UART, SPI and I2C programs,
    assembler, end-to-end testbench, Yosys area and timing scripts
    - pbe_v2: adds a low-speed USB line unit and 16-byte FIFOs, with USB
    packet TX/RX tests
    - diagrams: block diagram page
    - ihp_lib: IHP sg13g2 standard-cell libraries used for area and timing
    Claude-Session: https://claude.ai/code/session_01Fd6TYMiGo9ZjkGgMC5JUmm
2026-10-27 Add design and bug logs; fix six bugs from review
    Add docs/DESIGN_DECISIONS.md (every design decision, alternatives, and
    changes forced by new protocols) and docs/BUG_LOG.md (every bug with
    code before and after and the test that guards it), plus CLAUDE.md so
    both stay current.
    Fixes, each with a test that failed before and passes after:
    - BUG-007: failing simulations now exit non-zero ($fatal)
    - BUG-008: NOP no longer assembles to the v2 USB UTX instruction
    - BUG-009: USB receiver flags bit-stuffing errors (STAT bit 2)
    - BUG-010: I2C SCL is now low 4 ticks, high 3; meets fast mode
    - BUG-011: I2C STOP flag clears only after the STOP completes
    - BUG-012: restart cancels the side effects of t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
2026-10-27 Add 1-Wire and Modbus RTU programs; fix restart pin glitch
    Both protocols are programs on the existing instruction set, added to
    v1 and v2 with independent device models in the testbench:
    - 1-Wire controller: reset/presence, byte read/write, single-slot mode
    for Search ROM; tested with two DS18B20-style devices, CRC8 checks
    and timing checks on every low pulse
    - Modbus RTU master over RS-485: host-supplied parity, driver enable,
    3.5-character end-of-frame detection; tested at 19200 8E1 with an
    injected parity error
    Bugs found along the way (docs/BUG_LOG.md):
    - BUG-013: restart cleared pin output values, so a pin held high could
    glitch low; restart now only releases pins
    - BUG-014: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
2026-10-27 Make flags engine-relative so protocols can run together
    Flags grow from 4 shared flags to 8. Each engine sees 4 of them from
    its FLAG_BASE (engine register +8; reset 0 for engine 0, 4 for engine
    1), so FLAG n in a program is physical flag (FLAG_BASE + n) mod 8.
    Programs are unchanged. The host gets FLAG_SET (0x08) and FLAG_CLR
    (0x09) to change single flags without touching the other engine's.
    New test: a 1-Wire Search ROM on engine 0 and I2C write/read rounds on
    engine 1 at the same time, from two host processes. On the old
    hardware the I2C engine took a 1-Wire reset request as a START and
    the test failed and hung (BUG-017). The testbench host-port lock is
    now a fair ticket lock (BUG-018).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
2026-10-28 Add CRC unit, parity bit and WAIT timeout; retire v2 (USB)
    v2's USB hardware pulled the engine toward one protocol, so v2 is
    retired: its code stays on the branch archive/v2-usb and its lessons
    are in docs/USB_NOTES.md. v1 gets three general features instead:
    - CRC unit (src/pbe_crc.sv): any polynomial up to 16 bits, fed by the
    bits the engine shifts (OUT/OUTOD/IN, NOCRC to skip one), with
    CRCRST, OSRCRC, JCRCBAD on opcode 111 and host restart/status
    - parity bit: OUTPAR pin action sends it; STAT reports receive errors
    - WAIT timeout: a blocked WAIT/PULL/PUSH jumps to TIMEOUT_PC after
    TIMEOUT ticks; off by default, so old programs are unchanged
    The Modbus RTU program now uses all thr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
2026-10-28 Update block diagrams to the current v1
    Chip: 8 engine-relative flags between the engines, the engines' new
    contents (timeout, parity, CRC) and the pin map the tests use. Engine:
    CRC unit, parity, timeout counter and the timeout jump. Instruction
    table with OUTPAR, NOCRC and opcode 111, and a new table of each
    engine's 16 registers.
    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
2026-10-28 Close 1-Wire/Modbus gaps; 128-word program memory
    - Modbus 8N2 again (BUG-019): LINE_CFG[6] = no parity, OUTPAR sends
    the second stop bit and receive parity errors are masked
    - 1-Wire strong pull-up: FLAG0 set after a byte is queued drives DQ
    hard high 7 us after its last slot until the host clears it; tested
    with a parasite-powered CONVERT T in the device model
    - Inverted CRC-16: reading CRC_POLY (+9/+A) returns the CRC's current
    value, so the host can check CRCs sent inverted (DS2408/DS2431)
    - RX overflow: a PUSH into a full RX FIFO sets STATUS[3] and raises IRQ
    - Testbench at the planned 48 MHz (BUG-020)
    The strong pull-up made 1-Wire 35 words, too big to run beside I2C in
    64 wor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
2026-10-28 Add WS2812, SPI peripheral, I2C target and SMBus PEC
    Four protocols, all programs: no RTL change.
    - WS2812: 8-word program, tick = 2 clocks; pulse widths within the
    datasheet's +/-150 ns. The host streams with the TX-full pin.
    - SPI peripheral: mode 0 up to 2 MHz; the timeout vector ends a
    transaction; replies default to 0xFF.
    - I2C target: both engines share pins and flags. A watcher flags
    START/STOP; the bit engine stretches SCL while the host ACKs
    (clear FLAG2) or NACKs (restart). 300 ns data hold.
    - SMBus PEC: the CRC unit as CRC-8 (0x07); the I2C controller's ACK
    bit is now NOCRC (BUG-022).
    Tests 8-10 are in a new testbench, tb_proto.sv; the host helpers move
    to tb_host.svh.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
2026-10-28 Bring USB back to v1 on general hardware: low-speed device, EP0
    USB low speed now runs on one engine as a 64-word program
    (programs/usb_dev.pbe). It answers every token itself in about 3
    bit times. The hardware added is general:
    - Line coder (pbe_line.sv): NRZ/NRZI; stuffing after 6 ones, 5 ones
    or 5 equal bits; pair mode with SE0; SYNC hunt; byte or bit
    transfers. It owns the bit timing and re-centres on every edge.
    Unit-tested in USB, CAN and HDLC styles.
    - JEQ/JNE/JLINE and MOV; CRC_GOOD and OSRCRC INV (USB residual
    0x800d); FIFOs 4 -> 16 bytes; RX/TX_COUNT and TX_FLUSH; a second
    register page per engine.
    Test 11 (tb_usb.sv): a host model at +-1.5 % enumerates the
    device. Corr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
2026-10-28 Run the full testbenches on the routed netlist (gl_regression)
    The gds workflow gets a gl_regression job. It downloads the routed
    netlist and the PDK cell models, as Tiny Tapeout's gl_test does, then
    runs tb_proto, tb_usb and tb_pbe on it (make test-gl in pbe_v1).
    tb_pbe's NOP check now reads the flags through the host port. The one
    I2C monitor that reads inside the design is RTL-only (GL_TEST). make
    test passes.
    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
2026-10-28 Fix the gate-level regression job; run the GDS flow only on design changes
    gl_regression downloaded the tt_submission artifact into a folder of
    the same name. The artifact already holds a tt_submission/ folder, so
    pdk.json ended up one level too deep. An empty PDK name then broke the
    PDK install (BUG-036). It now downloads into the workspace root, as
    Tiny Tapeout's gl_test does, and fails at once if pdk.json is
    missing.
    The gds workflow, about 4 hours, now runs only when src/, info.yaml or
    the tests change.
    The first Tiny Tapeout run passed: GDS, precheck, and the cocotb test
    on the routed netlist.
    Claude-Session: https://claude.ai/c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
2026-10-29 tb_pbe: declare scl_stretched before use (Icarus 13 rejects it)
    With Tiny Tapeout's Icarus 13, tb_proto and tb_usb pass on the routed
    netlist. tb_pbe failed to compile: the I2C peripheral model used
    scl_stretched before its declaration, which Icarus 12 had accepted.
    The declaration moves up (BUG-037). make test passes.
    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
2026-10-29 Run the gds and gl_regression flows by hand only while the RTL is finished
    Each RTL push would otherwise start a 2.5-hour build, and each testbench
    push would run new tests against an old netlist (D46).
    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
2026-10-29 Record the first routed run's results next to the estimates
    The first full Tiny Tapeout run (commit df2e881) passed: gds with
    precheck 9/9 and gl_test 2/2, then gl_regression (tb_proto, tb_usb,
    tb_pbe on the routed netlist). D45 gets the routed area, cell counts,
    hold-fix cells and STA at all three corners beside the Yosys/ABC
    estimates, and marks the timing estimate Changed: the worst routed path
    is ~20.3 ns at the slow corner against ~5 ns estimated, because the
    method leaves out wires and the PC's fan-out into the program-memory
    mux. D18's margin note and D46's run summary follow; the README results
    table shows estimate and routed numbers side by side. make test passes.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
2026-10-29 Fix five reviewer findings: 1-Wire pull-up, Modbus gaps, USB stuffing, resend, bus reset
    - 1-Wire: test FLAG0 before the PUSH; the strong pull-up drives DQ high first, so a full
    RX FIFO cannot delay it (BUG-038). 36 words.
    - Modbus RTU: TIMEOUT = 1.5 characters; the timeout routine watches 2 more characters. A
    start bit there makes the frame invalid: FLAG3, then 3.5 characters of silence before the
    frame end (BUG-039, D47). 62 words.
    - Engine: JCRCBAD jumps on CRC not ok or line error; CRCRST clears the line error; STAT no
    longer does (BUG-040, D48). usb_dev does CRCRST before the DATA PID.
    - USB firmware model: resend an IN packet whose ACK did not come within 100 us (BUG-041);
    de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
2026-10-29 Cut the 48 MHz worst path in two with an instruction register
    The first routed run met 48 MHz with 0.586 ns of slack at the slow
    corner. Its worst path went pc -> 9.2 ns of buffer chains -> the program
    memory mux tree -> decode/exec -> next pc, all in one clock.
    Each engine now executes from instr_q. The memory is read at pc, which
    is the word after the current instruction, so straight-line code still
    runs one instruction per clock. Only a taken jump (or the timeout) waits
    one clock to fetch its target. A tick that lands on that bubble is held,
    not lost. With CLKDIV >= 1 timing is exactly as before; at CLKDIV 0 and
    under the line coder a taken jump takes 1 clock more. A host write to
    progra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
2026-10-29 Investigate SRAM for the program memory; prototype behind USE_SRAM (D55)
    The IHP SRAM macros are in the CMOS5L PDK the flow installs
    (sg13cmos5l_sram links to the SG13G2 library at 89d42ee), use only
    Metal1-Metal4, and two CMOS5L Tiny Tapeout projects pass gds, precheck
    and gl_test with them.
    Measured in the first routed run: the flip-flop memory is 246,909 um2,
    55 % of the standard-cell area and 27 % of the die, with 2,048 of the
    3,590 hold buffers.
    Proposal (D55): one RM_IHPSG13_1P_256x16 per engine, both written by
    the host so the shared image stays. The macro is addressed with the
    engine's next pc, so D50's prefetch is unchanged. A write refetches
    twice (BUG-058). Expected saving about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
2026-11-04 CAN hardware: LINE2, bit-synchronous coder, LINECTL, FIFO mark/rewind
    Step 1 of classic CAN (CAN 2.0A) support, all behind configuration bits that reset to 0.
    - LINE2 (second page +4, D65): sample point 50/62.5/75/87.5 %, falling-edge-only resync,
    receive on pin_base+1, bit-synchronous mode, wait for bus idle. pbe_line implements the
    general bits; LINE2 = 0 is the old behaviour.
    - pbe_bsync (D66): one bit timer for transmit and receive, readback, arbitration (stop driving
    at once, keep receiving), units of 1-8 bits, the CRC fed from the line, the CAN frame tail
    (delimiters, ACK, EOF) in hardware, and a line-event vector for IN/OUT after a frame end.
    - LINECTL on EXT sub-op 7, param[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
2026-11-04 CAN node program and end-to-end testbench
    Step 2: programs/can_node.pbe (61 of 64 words) and test/tb_can.sv, now part of make test.
    - can_node: one loop for transmitter and receiver; the coder starts or joins the frame, the
    program walks the header units, data and CRC, and the coder runs the tail. Retransmits
    with MARK/REWIND until the frame goes out; host protocol in the header (D72).
    - tb_can: wired-AND bus with per-node transceiver delay, two reference CAN nodes written from
    ISO 11898-1 (can_ref_node.sv, +-0.5 % clock), a disturber, and an SPI host model. Seven
    scenarios: DLC 0-8 and remote both ways at 125k/250k/500k/1M, arbitration, ACK missing,
    injected CRC/stuff/form errors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
2026-11-04 CAN: independent checks, review fixes, documentation
    Steps 3 and 4, plus the parent session's review of step 1.
    Review fixes:
    - make synth read a hard-coded source list without pbe_bsync.sv; the Yosys script now takes
    the Makefile's SRC (BUG-087).
    - Timing: the sample-point adders were on the bit counter's compare path (3.39 -> 5.00 ns
    logic-only); the sample counts are registered (3.69 ns, worst path back to instr_q) (BUG-088).
    - Area breakdown recorded in D66: +47.5k um2 total, pbe_bsync 20.1k per engine, of which
    about 5.9k is CAN-only (error confinement 3.9k, tail and flags 2.0k).
    Independent checks (D73):
    - sigrok's stock can decoder on tb_can's bus at 125k-1M (make sigrok-can);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
2026-11-04 CAN 2.0B passive: frame follower for extended frames and r0 recessive
    Review of the CAN work: can_node flagged an error on every valid extended (29-bit) frame and
    every standard frame with r0 recessive, which would destroy other nodes' traffic on a mixed bus
    (BUG-092).
    - pbe_bsync: LINE2[7] enables a frame follower (D74). On IDE (bit 13) or r0 (bit 14) recessive
    the coder walks the rest of the frame itself: no units reach IN, LINECTL is ignored, the last
    CRC bit is found from RTR and DLC, and the usual tail checks the frame and ACKs a valid one.
    +2.25k um2 per engine. can_node unchanged in size (61 words), LINE2 = 0xF2.
    - tb_can scenario 7 (written first; failed before the fix): exten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
2026-11-04 D66: record CAN-on-engine-0-only and the shared bit timer as evaluated and rejected
    Owner's decision: keep CAN on both engines (two CAN nodes, e.g. a bridge or gateway between
    two buses; about 20k um2 not saved) and no shared bit timer. Documentation only.
2026-11-04 Final area/timing numbers; default-equivalence BMC bounds the solver completes
    D66: 390,814 um2, 17,524 cells, 3.64 ns logic-only with the frame follower. D73 and
    default.sby: line-coder equivalence to 18 clocks, engine to 8 (deeper bounds did not finish).
2026-11-05 JTAG controller program and an IEEE 1149.1 TAP testbench
    jtag.pbe (42 words): TCK/TMS/TDI/TDO on pin base + 0..3; host records
    [cmd][n-1][bits] for TMS sequences and TDI/TDO shifts (TMS = 1 on the last
    bit for command 2). TCK up to 8 MHz at CLKDIV = 0. No RTL change.
    tb_debug.sv runs it against jtag_tap.sv, a TAP written from 1149.1: reset +
    IDCODE, BYPASS, 32-bit USER write/read-back, 1- and 7-bit scans, a chain of
    two TAPs, at CLKDIV 0 and 0xFFFF. Added to make test (D75).
2026-11-05 SWD host program and an ADIv5 SW-DP testbench
    swd.pbe (64 words): SWCLK/SWDIO on pin base + 0..1; host records for raw
    bits (line reset, JTAG-to-SWD), reads and writes; RX gives the ACK, read
    data and the engine-checked read parity. WAIT/FAULT skip the data phase.
    SWCLK up to 8 MHz at CLKDIV = 0. No RTL change.
    tb_debug.sv adds swd_dp.sv, an SW-DP written from ADIv5.2 (switch, line
    reset, DP/AP registers, posted AP reads, WAIT, FAULT, parity errors both
    ways), and runs JTAG and SWD alone and at once at CLKDIV 0 and 0xFFFF.
    Targets drive 50 ns late. D76; BUG-093..098.
2026-11-05 sigrok's stock jtag and swd decoders on tb_debug's pins
    make sigrok-debug: debug_verify.py runs tb_debug's concurrent phase with
    PBE_SIGROK and decodes the pins with libsigrokdecode's jtag and swd
    decoders, unchanged. With targets 20 ns late all 14 IR/DR scans and all 99
    SWD annotations (switch, line resets, 33 transactions, the two deliberate
    parity errors) match. With make test's 50 ns targets JTAG still matches and
    SWD shows the swd decoder's falling-edge sampling as an exact expected
    failure (D77, BUG-099).
2026-11-05 Docs: JTAG and SWD in the datasheet, the READMEs and the AI write-up
    info.md lists both programs and the board parts they need (TDO and SWDIO
    pull-ups, TCK and SWCLK pull-downs); pbe_v1/README.md gets their host
    protocols, tb_debug and the make targets; the protocol lists in README.md
    and the verification tables in AI_ASSISTED_DESIGN.md include them.
2026-11-05 Modbus RTU: see a start bit that begins during the idle timeout routine
    While idle, modbus_rtu.pbe times out every TIMEOUT + 3 ticks to poll the
    TX FIFO; tmo and JMP TX_EMPTY run for 3 ticks before WAIT rx, FALL issues
    again, and WAIT FALL does not latch edges, so a start edge in those ticks
    was missed and the response came out shifted (BUG-100, D47's known limit).
    The idle wait is now WAIT rx, LOW [3] (same word, 62 of 64): a start edge
    during the WAIT is timed exactly as before (first data bit sampled 1.504
    bits after the edge); one in the window is seen at most 3 ticks late
    (1.869 bits). Margin and alternatives (2-word centring, an RTL edge
    latch, not needed) are in D78. No RTL change.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
2026-11-05 USB: a token with a wrong stuff bit gets no answer
    D48 made JCRCBAD reject DATA packets with a line error, but usb_dev.pbe
    cleared the line error in dat, after the token, and never checked IN
    tokens: a SETUP, OUT or IN token with a wrong stuff bit and intact bytes
    was answered (BUG-101). USB 1.1 7.1.9 and 8.7.1: such a packet is ignored.
    usb_dev.pbe (64 words before and after, words 6 and 9 unchanged):
    - CRCRST right after the PID covers the token and the DATA packet after
    it, so SETUP/OUT data is not ACKed after a bad token;
    - IN tokens: STAT; SET OSR, 0x10; JEQ idle;
    - words freed: the CRCRST in send, the DATA packet's end shared with the
    handshakes, one record tail for the status and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
2026-11-06 tb_line race (BUG-102), Verilator 5.020 workarounds (BUG-103), first sample after reset (BUG-104)
    BUG-102 (testbench): tb_line E4 measured the bit-error flag 53 clocks after the
    bad bit under Icarus, 54 under Verilator 5.020 and 55 under 5.051. Three
    same-edge races, not the RTL: clk_n++ read by other rising-edge processes, and
    the forced bus level written right after @(posedge clk) while the delay line
    sampled it. In both simulators the coder drives 52 edges after the forced level
    is sampled. Fix: clk_n is a nonblocking update, testbench threads act after a
    falling edge, and usb_drive starts at a falling edge. E4 now checks the exact
    contract (PB + LD + 1 = 53). Audit: the reset release (al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
2026-11-06 Coverage rerun under Verilator 5.051: 130/130 bins; late join, tb_debug, CAN corners
    make coverage on the fixed tree (OSS CAD Suite 2026-07-27, Verilator 5.051):
    130/130 functional bins (the 92 round-2 bins and D73's 38 new ones), line
    265/269, branch 482/510, expression 852/908, toggle 4,450/5,394.
    BUG-105 (test): tb_line E2 said it tested the late join but queued its unit
    one clock before the hard synchronization, so bsync_late_join stayed at 0.
    New E2b queues it inside the winner's SOF and checks the join, the drive and
    the lost arbitration; it fails with late_join forced off.
    BUG-106 (tool): the campaign left out tb_debug and its program image. Bench
    models are now a table used for the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
2026-11-06 README: coverage 130/130 under Verilator 5.051, the two-simulator check, current counts
2026-11-08 Flow guide for the SRAM on 8x4 (docs/SRAM_8x4_FLOW_STEPS.md); investigation marked superseded
    The owner's step-by-step guide to the flow configuration, following Tiny Tapeout's
    ttihp-cmos5l-sram-example: the plugin and PDN files, info.yaml, the config.json SRAM
    section with both instances, placement on the 8x4 die, running gds, what to check and
    the failure modes. The old sram/ change set is retired (BUG-110).
2026-11-08 PAGE: programs over 64 words, a one-shot page prefix on page-relative jumps (D83)
    - Engine: a jump's 6-bit target is in its own 64-word page of the program; PAGE p (EXT 7,
    param[5] = 1, p = param[1:0]) sets the page of the next executed instruction only.
    Restart, timeout and line-event jumps clear it; a stop or a host refetch keeps it. The
    timeout vector stays in page 0. A cross-page jump still costs one refetch clock.
    - Assembler: labels in 0..255, PAGE inserted automatically before a jump to another page
    (reported; --no-auto-page makes it an error), PAGE p and .org n. Existing images unchanged.
    - tb_page: a 202-word program over four pages, timeout across pages, stop and restart, h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
2026-11-12 Flow configuration for the SRAM on 8x4 (D82, SRAM_8x4_FLOW_STEPS.md §1-4)
    - Copy librelane_plugin_sram_pdn.py, odb_stripes.py (root) and src/pdn_cfg.tcl unchanged
    from TinyTapeout/ttihp-cmos5l-sram-example @15ac9bc (Apache-2.0); credit in README.
    - info.yaml: tiles 8x4; add pbe_pmem_sram.sv, and sram_bb.v last.
    - src/config.json: SRAM section (ExtendPowerStripes step, MACROS with u_pmem.u_sram0 at
    (3.36, 3.78) FS and u_pmem.u_sram1 at (3.36, 170.10) N, four PDN_MACRO_CONNECTIONS,
    PDN_CFG, array stripes, PDN/Magic error keys) and FP_PDN_VPITCH 44.96, VWIDTH 2.1,
    VSPACING 3.52, VOFFSET 6.15.
    Checked: make test, make synth (instance names match MACROS), cocotb test 2/2.
2026-11-12 Five protocols as programs: PS/2 host, 24-bit GPIO expander, logic analyser and generator, quad SPI, HDLC (D84-D88)
    No RTL change. Each protocol has an end-to-end testbench against a model written from its
    specification, run by make test (make test-proto2):
    - PS/2 host (ps2_host.pbe, 74 words, D84): open-drain, the parity bit computed from the bits
    read back from the wire; tb_ps2 against a keyboard model; sigrok ps2 decoder cross-check.
    - 24-bit GPIO expander (gpio_expander.pbe, 33 words, D85): three 74HC595 and three 74HC165,
    SCK 6.86 MHz; tb_gpio against datasheet models with timing checks; sigrok spi cross-check.
    - Logic analyser and waveform generator (la_capture.pbe 30, wavegen.pbe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
2026-11-13 Quad host port: 4 bits per SCK both ways, HOSTCFG 0x50, exit by 8 SCK with CS_n high (D89, BUG-125)
    The host port gets a quad mode for real-time streams (10BASE-T needs 1.25 MB/s; the
    single-lane port carries 0.94 MB/s at 60 MHz). D1..D3 on ui_in[3..5], Q1..Q3 on uo_out[1..3]
    while CS_n is low; uo_out[7:4] stay status. Single lane stays the reset default. tb_quad
    checks the modes, pins, recovery, rates (16 vs 64 clocks per byte), a program load and a
    UART loopback in quad mode; tb_host.svh runs any bench in quad mode with +QUAD (tb_la in
    make test, tb_pbe in make test-quad).
2026-11-13 Line coder: Manchester mode (LINE mode 3), both-edge pin sampling for clock recovery (D90, BUG-128, BUG-129)
    LINE[1:0] = 3 encodes IEEE 802.3 Manchester (a 1 is low then high; LINE[7] the other
    polarity), holds the line high for 3 bit times after END (10BASE-T TP_IDL, DALI stop) and
    decodes with a bit timer that averages the mid-bit edges (gain 1/4, 1/8-clock resolution).
    The top level also samples the pins on the falling clock edge (3-flop synchronizer), so the
    receiver times edges to half a clock: +-0.8 clock (+-13.3 ns at 60 MHz) of per-edge jitter
    decoded error-free in tb_line M7. SYNC finds the SFD; the carrier ends after 2 bit times
    without a mid-bit edge; link pulses are ignored. tb_l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
2026-11-13 CRC unit up to 32 bits: CRC-32 for the Ethernet FCS, registers CRC_POLY_2/3, CRC_GOOD_2/3, CRC_CFG2, OSRCRC B2/B3 (D91, BUG-130, BUG-131)
    pbe_crc is 32 bits wide with a 5-bit width; CRC_CFG2[0] is the fifth width bit, so every
    existing CRC (and image) is unchanged. tb_crc checks the reveng check values of five 32-bit
    CRCs, Ethernet frames against an independent reflected CRC-32 and the 0xC704DD7B residue, and
    bit-identity with the old 16-bit unit for random 1-16-bit configurations.
2026-11-13 60 MHz: clock_hz and CLOCK_PERIOD, benches, USB at 40 clocks a bit, WS2812 and I2C target retimed (D92, BUG-132)
    A 10BASE-T half bit is exactly 3 clocks at 60 MHz. Every top-level bench runs at 60 MHz (a
    16.668 ns simulated period); the benches' 48 MHz constants were fixed; ws2812.pbe ([11]
    delays) and i2c_target.pbe ([15] hold) were retimed; the program headers, README and
    docs/info.md give the 60 MHz CLKDIV figures. D18, D34, D46 marked Changed.
2026-11-13 10BASE-T Ethernet: eth_tx.pbe and eth_rx.pbe, tb_eth against an IEEE 802.3 link partner model (D93, BUG-133..135)
    Engine 0 transmits (preamble, SFD, the host's frame streamed through the TX FIFO in chunks,
    FCS from the CRC unit, TP_IDL, link pulses every 16 ms), engine 1 receives (SFD search,
    bytes, FCS residue check, [0x7E][status] records). tb_eth (19 checks): 64/512/1518-byte frames
    both ways, clock offsets to -5000 ppm with jitter, a bad FCS, 9.6 us gaps, a full-duplex
    loopback, link pulses, host underrun/abort and RX overrun reported. The host streams in quad
    mode at SCK = clk / 8. docs/ETHERNET_VERIFICATION_TODO.md is the verifier's hand-off.
2026-11-13 pbe_line: LINECTL STUFFOFF/STUFFON and flag-delimited frames (LINE[6]); HDLC in NRZ and NRZI (D94, BUG-136, BUG-137)
    Each queued unit carries the stuffing state, so flags go out unstuffed inside one coder frame;
    with LINE[6] a stuffing violation ends a frame at either level and reception goes on. hdlc_tx
    and hdlc_rx are rewritten on them and work in both codings (flag fill between frames, abort
    detected by the bit after six 1s). tb_line H (unit) and tb_hdlc (9/9, NRZ and NRZI, the model
    NRZI-capable). Multi-pin IN/OUT (6b) not done: D94 says why.
2026-11-13 Verify D89-D94 Ethernet features and fix Manchester idle qualification
    Extend the independent model, formal checks, external vectors, coverage, mutation and timing stress for the quad host, wide CRC, Manchester and HDLC features. Preserve default and historical evidence with explicit proof domains and counterexamples.
    Repair the documented Manchester LINE2 idle-wait exception with a minimal regression. Record the remaining required-jitter receiver failures and complete round-3 results.
